infr025t/fpga2026/stream_video_edge_20fps/reports/evidence/consolidated_board_20261101/README.md

# 收敛候选硬件复测证据（2026-11-01）

**最新结论：自动硬件回归已通过，用户确认 RAW 与 EDGE 动态显示正常。** 重连后显式下载收敛候选，完成下面补测。此前第 324 帧出现真实参考不匹配，用户确认期间动过 USB 或供电；该事件尚未唯一归因，新通过结果不覆盖旧失败。

| 固件 / 检查 | 本次结果 |
|---|---|
| 收敛候选，内部 RAW / EDGE | 各 50 帧目标通过；内部源约 27.12 fps，不代表相机帧率 |
| 收敛候选，相机 RAW 色条 UART | 200 连续包通过：参考、头/负载 CRC、帧号、诊断丢包均正常；约 22.5077 fps |
| 收敛候选，相机 RAW 色条继续监测 | 第 324 帧参考错误，前 61440 像素不符，错误锁存重连后仍一致；此次环境不受控 |
| 原版，对照 RAW 色条 | 重新连接后 500 帧目标通过；约 22.5077 fps |
| 收敛候选，重连后 RAW / EDGE 色条 | 各 500 帧目标通过，约 22.5077 fps |
| 收敛候选，暂停恢复 | 10 轮通过，逐轮至少 10 帧后暂停并检查固定参考 |
| 收敛候选，实景 RAW / EDGE | 各 600 帧目标通过，约 22.5077 fps；完整像素数及队列两端 CRC 一致，不等于场景真值校验 |
| 收敛候选，实拍 UART | 连续 200 包，CRC 错误、诊断丢包与帧号缺口均为 0；没有场景参考真值 |
| 收敛候选，面板动态观察 | 用户按移动、遮挡、近光问题回复“两种模式都正常” |

`consolidated_mode*_02` 保存候选监测记录，`consolidated_bars_uart01` 保存 UART 摘要和帧号记录，`baseline_bars_stable02` 保存原版对照。UART 200 包不覆盖第 324 帧，不能用其通过结果否定稍后故障。监测记录可能跳过主机未轮询到的帧；逐帧参考锁存和主机记录应分开理解。

原始大体积图像/串口流仍留在测试工作区 `reports/uart_pairs/consolidated_bars_uart01/`，不复制进版本库。失败日志及重新连接日志保留。`program_attempt.log` 是最初未识别到目标的失败，不是成功下载凭证；成功下载见 `candidate_program.log` 和 `baseline_program.log`。

补测记录：`consolidated_stable_mode2_01`、`consolidated_stable_mode6_01`、`consolidated_pause_stable01`、`consolidated_scene_raw01`、`consolidated_scene_uart01`、`consolidated_scene_edge03`。实拍 EDGE 第一轮在第 598 帧后 JTAG 断开，不能记为通过。重连 inspect 无错误，但输出回到 RAW，不能证明仍是候选；`consolidated_scene_edge02` 主动终止并排除。再次显式下载候选后，`consolidated_scene_edge03` 完整通过，原始中断记录保留。

最后成功 RAM 下载为收敛候选 `548373f9…`，已成功交回实体开关控制。**本轮没有写 Flash。** 断电自启动仍使用此前用户确认的原版，不能将它误认成收敛候选。

用户已对 RAW / EDGE 移动、遮挡、近光的面板观察回复“两种模式都正常”。本轮有限回归通过，不等于无限时长或所有条件下零故障。移动暗条纹和斜向刷新分界线仍单列，未修复；第 324 帧事件保留为原因未闭合、受控补测未重现。任何后续失败仍应记录首错，不靠反复运行直到通过结案。
