infr025t/fpga2026/stream_video_edge_20fps/reports/evidence/rewire_20fps_20261031.md

# 改线后20fps实测（2026-10-31）
仅测试区；未修改RTL、算法或正式工程。仍使用b33cd101...测试bit，RCLK16.667MHz、40ns单次采样，摄像头AEC/AGC开启。

- 固定色条RAW：500帧目标完成，22.5077fps；完整VGA参考CRC检查通过。PC保存500个连续包，两组字节与参考均一致，头/负载CRC、帧号缺口和诊断丢包均为0。
- 固定色条Gaussian+Sobel：500帧目标完成，22.5077fps；完整边缘图参考CRC检查通过。
- 实拍RAW：两轮FPGA各完成600帧目标，22.5077fps，源到屏幕像素数及CRC相同。第一轮PC保存316张后PermissionError终止；不能当作600张图像验收。第二轮600张全部保存，串口CRC、帧号缺口、诊断丢包均为0。
- 实拍Gaussian+Sobel：500帧目标完成，22.5077fps；630x470完整输出像素数和写屏前后CRC一致。此项无逐帧实景参考，不能据此证明图像内容无错。
- 第二轮600张160x120双字节概览，行对比度筛查0帧有疑似互换行；人工查看每30帧的20张拼图未见明显互换或割裂。抽样不能排除未导出像素的零星问题。第91帧有手指进入，未据此认定完成受控动态验收。
- 各monitor结束时会排空在途帧，目标数与最终完成数可能相差1；具体见JSON。EDGE参考CRC由主机轮询核对，不能把主机观测次数改写为硬件逐帧全覆盖。
- 用户报告改线和此前3V3/GND接反；本轮下载、配置和图像链路可以工作，但没有仪器测量供电，也不能证明所有器件没有潜在损伤。此次没有进一步改线。

所有原始记录保留于reports/lcd/runtime/rewire_*及reports/uart_pairs/rewire_*。实拍对比拼图：reports/uart_pairs/rewire_scene02/sample_montage.png。
下一步：保持当前固件和接线，完成移动、遮挡、近距离强光动态验收，再决定正式收敛。不能仅凭本轮通过就宣布旧故障永久解决。
