infr025t/fpga2026/demo/stream_image_demo/完整代码.md

# 当前Demo完整代码

由 `python scripts/check_delivery.py --refresh` 生成，逐文件对应当前源码。
功能、运行方式与验证范围见 `README_先读我.md`；历史硬件记录见 `docs/`。

## constraints/basys3.xdc

```tcl
# Basys 3 XC7A35T CPG236, from Digilent Basys-3-Master.xdc.
set_property -dict {PACKAGE_PIN W5 IOSTANDARD LVCMOS33} [get_ports clk100]
create_clock -name sys_clk -period 10.000 [get_ports clk100]
set_property -dict {PACKAGE_PIN U18 IOSTANDARD LVCMOS33} [get_ports btnC]
set_property -dict {PACKAGE_PIN A18 IOSTANDARD LVCMOS33} [get_ports uart_txd]
set_property -dict {PACKAGE_PIN V17 IOSTANDARD LVCMOS33} [get_ports {sw[0]}]
set_property -dict {PACKAGE_PIN V16 IOSTANDARD LVCMOS33} [get_ports {sw[1]}]
set_property -dict {PACKAGE_PIN W16 IOSTANDARD LVCMOS33} [get_ports {sw[2]}]
set_property -dict {PACKAGE_PIN W17 IOSTANDARD LVCMOS33} [get_ports {sw[3]}]
set_property -dict {PACKAGE_PIN W15 IOSTANDARD LVCMOS33} [get_ports {sw[4]}]
set_property -dict {PACKAGE_PIN V15 IOSTANDARD LVCMOS33} [get_ports {sw[5]}]
set_property -dict {PACKAGE_PIN W14 IOSTANDARD LVCMOS33} [get_ports {sw[6]}]
set_property -dict {PACKAGE_PIN W13 IOSTANDARD LVCMOS33} [get_ports {sw[7]}]
set_property -dict {PACKAGE_PIN V2 IOSTANDARD LVCMOS33} [get_ports {sw[8]}]
set_property -dict {PACKAGE_PIN T3 IOSTANDARD LVCMOS33} [get_ports {sw[9]}]
set_property -dict {PACKAGE_PIN T2 IOSTANDARD LVCMOS33} [get_ports {sw[10]}]
set_property -dict {PACKAGE_PIN R3 IOSTANDARD LVCMOS33} [get_ports {sw[11]}]
set_property -dict {PACKAGE_PIN W2 IOSTANDARD LVCMOS33} [get_ports {sw[12]}]
set_property -dict {PACKAGE_PIN U1 IOSTANDARD LVCMOS33} [get_ports {sw[13]}]
set_property -dict {PACKAGE_PIN T1 IOSTANDARD LVCMOS33} [get_ports {sw[14]}]
set_property -dict {PACKAGE_PIN R2 IOSTANDARD LVCMOS33} [get_ports {sw[15]}]
set_property -dict {PACKAGE_PIN U16 IOSTANDARD LVCMOS33} [get_ports {led[0]}]
set_property -dict {PACKAGE_PIN E19 IOSTANDARD LVCMOS33} [get_ports {led[1]}]
set_property -dict {PACKAGE_PIN U19 IOSTANDARD LVCMOS33} [get_ports {led[2]}]
set_property -dict {PACKAGE_PIN V19 IOSTANDARD LVCMOS33} [get_ports {led[3]}]
set_property -dict {PACKAGE_PIN W18 IOSTANDARD LVCMOS33} [get_ports {led[4]}]
set_property -dict {PACKAGE_PIN U15 IOSTANDARD LVCMOS33} [get_ports {led[5]}]
set_property -dict {PACKAGE_PIN U14 IOSTANDARD LVCMOS33} [get_ports {led[6]}]
set_property -dict {PACKAGE_PIN V14 IOSTANDARD LVCMOS33} [get_ports {led[7]}]
set_property -dict {PACKAGE_PIN V13 IOSTANDARD LVCMOS33} [get_ports {led[8]}]
set_property -dict {PACKAGE_PIN V3 IOSTANDARD LVCMOS33} [get_ports {led[9]}]
set_property -dict {PACKAGE_PIN W3 IOSTANDARD LVCMOS33} [get_ports {led[10]}]
set_property -dict {PACKAGE_PIN U3 IOSTANDARD LVCMOS33} [get_ports {led[11]}]
set_property -dict {PACKAGE_PIN P3 IOSTANDARD LVCMOS33} [get_ports {led[12]}]
set_property -dict {PACKAGE_PIN N3 IOSTANDARD LVCMOS33} [get_ports {led[13]}]
set_property -dict {PACKAGE_PIN P1 IOSTANDARD LVCMOS33} [get_ports {led[14]}]
set_property -dict {PACKAGE_PIN L1 IOSTANDARD LVCMOS33} [get_ports {led[15]}]
set_property -dict {PACKAGE_PIN J1 IOSTANDARD LVCMOS33} [get_ports {cam_data[0]}]
set_property -dict {PACKAGE_PIN L2 IOSTANDARD LVCMOS33} [get_ports {cam_data[1]}]
set_property -dict {PACKAGE_PIN J2 IOSTANDARD LVCMOS33} [get_ports {cam_data[2]}]
set_property -dict {PACKAGE_PIN G2 IOSTANDARD LVCMOS33} [get_ports {cam_data[3]}]
set_property -dict {PACKAGE_PIN H1 IOSTANDARD LVCMOS33} [get_ports {cam_data[4]}]
set_property -dict {PACKAGE_PIN K2 IOSTANDARD LVCMOS33} [get_ports {cam_data[5]}]
set_property -dict {PACKAGE_PIN H2 IOSTANDARD LVCMOS33} [get_ports {cam_data[6]}]
set_property -dict {PACKAGE_PIN G3 IOSTANDARD LVCMOS33} [get_ports {cam_data[7]}]
set_property -dict {PACKAGE_PIN K17 IOSTANDARD LVCMOS33} [get_ports cam_sioc]
set_property -dict {PACKAGE_PIN M18 IOSTANDARD LVCMOS33} [get_ports cam_siod]
set_property -dict {PACKAGE_PIN N17 IOSTANDARD LVCMOS33} [get_ports cam_vsync]
set_property -dict {PACKAGE_PIN P18 IOSTANDARD LVCMOS33} [get_ports cam_wen]
set_property -dict {PACKAGE_PIN L17 IOSTANDARD LVCMOS33} [get_ports cam_rrst_n]
set_property -dict {PACKAGE_PIN M19 IOSTANDARD LVCMOS33} [get_ports cam_rclk]
set_property SLEW SLOW [get_ports {cam_rclk cam_rrst_n cam_wen cam_sioc cam_siod}]
set_property DRIVE 8 [get_ports {cam_rclk cam_rrst_n cam_wen cam_sioc cam_siod}]
# Async human/frame signals are sampled through marked synchronizers.
set_false_path -from [get_ports {btnC sw[*] cam_vsync}]
# SCCB data is stable for many system cycles at the ACK sampling point.
set_false_path -from [get_ports {cam_siod cam_sioc}]
# FIFO data is launched by our registered 2 MHz RCLK. Budget includes
# AL422 TAC 15 ns plus 10 ns wiring/skew; sample is ~200 ns after rise.
create_generated_clock -name fifo_read -source [get_ports clk100] -divide_by 50 [get_ports cam_rclk]
set_input_delay -clock fifo_read -max 25.0 [get_ports {cam_data[*]}]
set_input_delay -clock fifo_read -min 0.0 [get_ports {cam_data[*]}]
set_multicycle_path 20 -setup -end -from [get_ports {cam_data[*]}]
set_multicycle_path 19 -hold -end -from [get_ports {cam_data[*]}]
# Other low-speed outputs have no synchronous external capture clock.
set_max_delay 20 -datapath_only -from [get_clocks sys_clk] -to [get_ports {led[*] uart_txd cam_wen cam_rrst_n cam_sioc cam_siod}]
set_property CONFIG_VOLTAGE 3.3 [current_design]
set_property CFGBVS VCCO [current_design]
set_property BITSTREAM.GENERAL.COMPRESS TRUE [current_design]

# JC9: camera RESET# open-drain, external pullup to allowed camera IO rail.
set_property -dict {PACKAGE_PIN P17 IOSTANDARD LVCMOS33 SLEW SLOW DRIVE 8} [get_ports cam_rst_n]
set_max_delay 20 -datapath_only -from [get_clocks sys_clk] -to [get_ports cam_rst_n]

# JC10: passive HREF diagnostic input, double-flop synchronized.
# Weak pulldown keeps diagnostics quiet if the extra wire is absent.
set_property -dict {PACKAGE_PIN R18 IOSTANDARD LVCMOS33 PULLDOWN TRUE} [get_ports cam_href]
set_false_path -from [get_ports cam_href]
```

## constraints/vision_ooc.xdc

```tcl
# Generic core only; no screen pin assignment or display PHY is chosen yet.
create_clock -name sys_clk -period 10.000 [get_ports clk100]
set_false_path -from [get_ports {btnC sw[*] cam_vsync cam_href cam_sioc cam_siod}]
# Other I/O timing belongs to the eventual board/display wrapper.
```

## pc/enhancement_reference.py

```python
"""Integer reference model for the standalone two-scale enhancement pipeline."""
def fixture_pixel(frame, x, y, width):
    if frame == 0:
        return 80
    if frame == 1:
        return 255 if (x + y) % 2 else 0
    if frame == 3:
        return (40 if x < width // 2 else 220) + (x + y) % 3
    return (x * 17 + y * 31 + frame * 43) % 256

def fixture_controls(frame):
    return ((16, 16, 255), (48, 32, 255), (24, 20, 32),
            (0, 0, 0), (255, 255, 255))[frame]

def smooth(image, epsilon):
    height, width = len(image), len(image[0])
    result = []
    for y in range(1, height - 1):
        row = []
        for x in range(1, width - 1):
            values = [image[yy][xx] for yy in range(y - 1, y + 2)
                      for xx in range(x - 1, x + 2)]
            total = sum(values)
            mean = total // 9
            variance81 = 9 * sum(v * v for v in values) - total * total
            center = image[y][x]
            if variance81 <= epsilon * 81:
                value = mean
            elif variance81 <= epsilon * 324:
                value = (center + mean) // 2
            else:
                value = (3 * center + mean) // 4
            row.append(value)
        result.append(row)
    return result

def enhance(image, fine_gain=24, coarse_gain=16, limit=32,
            epsilon_fine=64, epsilon_coarse=256):
    fine = smooth(image, epsilon_fine)
    coarse = smooth(fine, epsilon_coarse)
    result = []
    for y, row in enumerate(coarse):
        output = []
        for x, base in enumerate(row):
            raw = image[y + 2][x + 2]
            middle = fine[y + 1][x + 1]
            df = max(-limit, min(limit, raw - middle))
            dc = max(-limit, min(limit, middle - base))
            value = base + (fine_gain * df + coarse_gain * dc) // 16
            output.append((raw, middle, base, max(0, min(255, value))))
        result.append(output)
    return result
```

## pc/receiver.py

```python
"""FPG1 UART receiver. Pure stdlib parsing/PGM output; pyserial for a real port.

CRC-16/CCITT-FALSE: polynomial 0x1021, init 0xffff, no reflection/xorout.
CRC covers header[4:] and the wire payload and is sent little endian. Version 1
has a 32-byte header; versions 2/3 have a 72-byte header. Version 3 transports
packed binary Sobel pixels or only ROI target statistics. Coordinates
refer to the sensor (the cropped image origin is sensor (1,1)). The legacy
bright-pixel centroid remains separate from the version 2 target centroid.
"""
import argparse
import binascii
import csv
from contextlib import ExitStack, suppress
import json
import math
from pathlib import Path
import struct
import sys
import time

MAGIC = b'FPG1'
HEADER = struct.Struct('<4sBBHHHIIIII')
TARGET_EXTENSION = struct.Struct('<BBHHHHHHHHIIIIIH')
KEYS = ('version', 'mode', 'width', 'height', 'threshold', 'frame_id',
        'payload_length', 'bright_count', 'sum_x', 'sum_y')
MAX_PIXELS = 320 * 240
BOX_KEYS = ('x_min', 'y_min', 'x_max', 'y_max')
TARGET_CSV_KEYS = ('config_valid', 'valid', 'dark', 'threshold',
                   'roi_x_min', 'roi_y_min', 'roi_x_max', 'roi_y_max',
                   'area', 'sum_x', 'sum_y', 'min_area', 'max_area',
                   'bbox_x_min', 'bbox_y_min', 'bbox_x_max', 'bbox_y_max',
                   'centroid_x', 'centroid_y')
CSV_FIELDS = (*KEYS, 'centroid_x', 'centroid_y', 'image_file',
              *('target_' + key for key in TARGET_CSV_KEYS), 'pixel_format')
MONO1_BYTES = tuple(bytes(255 if value & (1 << bit) else 0 for bit in range(8))
                    for value in range(256))

def _sum_bounds(area, low, high, capacity):
    """Possible axis sums for distinct pixels inside a rectangular box."""
    whole, remainder = divmod(area, capacity)
    minimum = area * low + capacity * whole * (whole - 1) // 2 + whole * remainder
    maximum = area * (low + high) - minimum
    # Both bounding-box endpoints must actually occur in the selected pixels.
    if low != high:
        minimum = max(minimum, (area - 1) * low + high)
        maximum = min(maximum, (area - 1) * high + low)
    return minimum, maximum

def _target_fields(values, width, height):
    (flags, threshold, rx0, ry0, rx1, ry1, bx0, by0, bx1, by1,
     area, sx, sy, minimum, maximum, reserved) = values
    if flags & ~0x07 or reserved:
        return False
    valid, dark, config_valid = bool(flags & 1), bool(flags & 2), bool(flags & 4)
    expected_config = (1 <= rx0 <= rx1 <= width and 1 <= ry0 <= ry1 <= height
                       and 1 <= minimum <= maximum <= width * height)
    if config_valid != expected_config:
        return False
    if valid != (config_valid and area > 0 and minimum <= area <= maximum):
        return False
    if not config_valid or not area:
        if any((area, sx, sy, bx0, by0, bx1, by1)):
            return False
    else:
        if not (rx0 <= bx0 <= bx1 <= rx1 and ry0 <= by0 <= by1 <= ry1):
            return False
        if area > (bx1 - bx0 + 1) * (by1 - by0 + 1):
            return False
        if area == 1 and (bx0 != bx1 or by0 != by1):
            return False
        sx_min, sx_max = _sum_bounds(area, bx0, bx1, by1 - by0 + 1)
        sy_min, sy_max = _sum_bounds(area, by0, by1, bx1 - bx0 + 1)
        if not (sx_min <= sx <= sx_max and sy_min <= sy <= sy_max):
            return False
    return dict(config_valid=config_valid, valid=valid, dark=dark,
                threshold=threshold, roi=dict(zip(BOX_KEYS, (rx0, ry0, rx1, ry1))),
                area=area, sum_x=sx, sum_y=sy, min_area=minimum, max_area=maximum,
                bbox=dict(zip(BOX_KEYS, (bx0, by0, bx1, by1))) if valid else None,
                centroid_x=sx // area if valid else None,
                centroid_y=sy // area if valid else None)

class FrameParser:
    """Incremental bounded parser; feed returns a list of validated frame dicts.

    Normal feeds always wait for the leading packet's declared length, so image
    pixels containing a valid packet cannot change parsing across read chunks.
    Only an explicit stream boundary may recover a later CRC-verified packet
    from an incomplete transfer. Call finish afterward to discard its tail.
    """
    def __init__(self):
        self.buffer = bytearray()
        self.rejected = 0

    def _candidate(self, pos):
        if len(self.buffer) - pos < HEADER.size:
            return None, None
        values = HEADER.unpack_from(self.buffer, pos)
        f = dict(zip(KEYS, values[1:]))
        w, h, n = f['width'], f['height'], f['payload_length']
        pixel_count = w * h
        if (values[0] != MAGIC or f['version'] not in (1, 2, 3) or f['mode'] not in (0, 1)
                or not (1 <= w <= 318 and 1 <= h <= 238)
                or n > MAX_PIXELS or f['threshold'] > 2047
                or f['bright_count'] > pixel_count
                or f['sum_x'] > f['bright_count'] * 319
                or f['sum_y'] > f['bright_count'] * 239):
            return False, None
        if f['version'] != 3 and n != pixel_count:
            return False, None
        header_size = HEADER.size
        pixel_format = 'gray8'
        if f['version'] in (2, 3):
            header_size += TARGET_EXTENSION.size
            if len(self.buffer) - pos < header_size:
                return None, None
            extension = TARGET_EXTENSION.unpack_from(self.buffer, pos + HEADER.size)
            has_target = True
            if f['version'] == 3:
                transport = self.buffer[pos + 70]
                if transport not in (1, 5, 6) or self.buffer[pos + 71]:
                    return False, None
                pixel_format = 'none' if transport == 6 else 'mono1'
                if pixel_format == 'mono1':
                    if f['mode'] != 1 or n != (pixel_count + 7) // 8:
                        return False, None
                elif n != 0:
                    return False, None
                has_target = transport != 1
                if not has_target and any(self.buffer[pos + 32:pos + 70]):
                    return False, None
                # The v2 reserved word is transport_flags plus reserved in v3.
                extension = (*extension[:-1], 0)
            if has_target:
                target = _target_fields(extension, w, h)
                if target is False:
                    return False, None
                f['target'] = target
        end = pos + header_size + n + 2
        if len(self.buffer) < end:
            return None, None
        expected, = struct.unpack_from('<H', self.buffer, end - 2)
        actual = binascii.crc_hqx(self.buffer[pos + 4:end - 2], 0xffff)
        if actual != expected:
            return False, None
        payload = bytes(self.buffer[pos + header_size:end - 2])
        if pixel_format == 'mono1':
            remaining = pixel_count % 8
            if remaining and payload[-1] & (0xff << remaining):
                return False, None
            payload = b''.join(MONO1_BYTES[value] for value in payload)[:pixel_count]
        f['pixels'] = payload
        f['pixel_format'] = pixel_format
        count = f['bright_count']
        f['centroid_x'] = f['sum_x'] // count if count else None
        f['centroid_y'] = f['sum_y'] // count if count else None
        return f, end

    def feed(self, chunk, *, boundary=False):
        self.buffer.extend(chunk)
        result = []
        while True:
            pos = self.buffer.find(MAGIC)
            if pos < 0:
                # Preserve possible fragmented magic, never unbounded noise.
                self.buffer[:] = self.buffer[-3:]
                break
            if pos:
                del self.buffer[:pos]
            frame, end = self._candidate(0)
            if frame is False:
                self.rejected += 1
                del self.buffer[0]
                continue
            if frame is None:
                if not boundary:
                    break
                # EOF or a caller-confirmed idle gap ends the old transfer.
                # Mere read fragmentation must never trigger this recovery.
                later = self.buffer.find(MAGIC, 4)
                recovered = False
                while later >= 0:
                    candidate, _ = self._candidate(later)
                    if candidate:
                        del self.buffer[:later]
                        self.rejected += 1
                        recovered = True
                        break
                    later = self.buffer.find(MAGIC, later + 1)
                if recovered:
                    continue
                break
            result.append(frame)
            del self.buffer[:end]
        return result

    def finish(self):
        """Discard ended-transfer leftovers; report full-magic truncation.

        A shorter magic suffix may simply be noise and is not enough evidence
        to classify a transfer as truncated. Call after a real stream EOF or
        an explicit idle boundary ends the transfer, not a single read timeout.
        """
        incomplete = self.buffer.startswith(MAGIC)
        if incomplete:
            self.rejected += 1
        self.buffer.clear()
        return incomplete

def display_geometry(frame):
    """Return ROI/target overlay positions in cropped-image coordinates."""
    target = frame.get('target')
    if target is None:
        return None

    def corners(box):
        return ((box['x_min'] - 1, box['y_min'] - 1),
                (box['x_max'] - 1, box['y_max'] - 1))

    return dict(roi=corners(target['roi']) if target['config_valid'] else None,
                bbox=corners(target['bbox']) if target['valid'] else None,
                centroid=(target['centroid_x'] - 1, target['centroid_y'] - 1)
                if target['valid'] else None,
                status=('Target' if target['valid'] else 'No target')
                if target['config_valid'] else 'Invalid target configuration')

def draw_target_overlay(picture, frame, cv2):
    """Draw only on a display copy; raw PGM and frame pixels stay unchanged."""
    geometry = display_geometry(frame)
    if geometry is None:
        return picture
    display = cv2.cvtColor(picture, cv2.COLOR_GRAY2BGR)
    if geometry['roi']:
        cv2.rectangle(display, *geometry['roi'], (0, 200, 255), 1)
    if geometry['bbox']:
        cv2.rectangle(display, *geometry['bbox'], (0, 255, 0), 1)
        cv2.circle(display, geometry['centroid'], 3, (0, 0, 255), -1)
    label = geometry['status']
    if frame.get('pixel_format') == 'none':
        label = 'Features only - ' + label
    if geometry['centroid']:
        target = frame['target']
        label += f" sensor=({target['centroid_x']},{target['centroid_y']})"
    cv2.putText(display, label, (4, 16), cv2.FONT_HERSHEY_SIMPLEX, 0.4,
                (0, 255, 0) if geometry['bbox'] else (0, 0, 255), 1)
    return display

def display_frame(frame, cv2, np):
    """Create the current frame's canvas; result-only packets never reuse pixels."""
    if frame.get('pixel_format') == 'none':
        picture = np.zeros((frame['height'], frame['width']), dtype=np.uint8)
    else:
        picture = np.frombuffer(frame['pixels'], dtype=np.uint8).reshape(
            frame['height'], frame['width'])
    return draw_target_overlay(picture, frame, cv2)

class PreviewCache:
    """Optional display-only background; metadata and saved pixels stay current.

    A reset, repeated ID, or incompatible image settings invalidates the held
    image. The wire format has no source/session ID, so an undetectable camera
    change cannot be inferred here; the sender must supply a fresh preview.
    """
    def __init__(self):
        self.pixels = None
        self.preview_id = None
        self.last_id = None
        self.settings = None

    def render(self, frame, cv2, np):
        settings = (frame['width'], frame['height'], frame['mode'], frame['threshold'])
        if (settings != self.settings or
                (self.last_id is not None and frame['frame_id'] <= self.last_id)):
            self.pixels = None
            self.preview_id = None
        self.settings = settings
        self.last_id = frame['frame_id']
        if frame.get('pixel_format') != 'none':
            # Keep immutable, undecorated pixels, never an OpenCV display array.
            self.pixels = bytes(frame['pixels'])
            self.preview_id = frame['frame_id']
            return display_frame(frame, cv2, np)
        if self.pixels is None:
            return display_frame(frame, cv2, np)
        picture = np.frombuffer(self.pixels, dtype=np.uint8).reshape(
            frame['height'], frame['width'])
        display = draw_target_overlay(picture, frame, cv2)
        # Separate lines remain readable at the normal 318-pixel image width.
        for y, label in ((34, f'Preview frame={self.preview_id} (held)'),
                         (50, f'Target frame={frame["frame_id"]}')):
            cv2.putText(display, label, (4, y), cv2.FONT_HERSHEY_SIMPLEX,
                        0.4, (0, 200, 255), 1)
        return display

def read_serial_chunk(stream, on_bytes=None):
    """Wait for one byte, then drain only bytes already available (at most 4096).

    Reading 4096 directly with a timeout batches short features-only packets
    until the timeout expires, even though each packet is already complete.
    """
    first = stream.read(1)
    if not first:
        return first
    if on_bytes is not None:
        on_bytes(first)
    available = min(stream.in_waiting, 4095)
    rest = stream.read(available) if available else b''
    if rest and on_bytes is not None:
        on_bytes(rest)
    return first + rest

class RecordingError(RuntimeError):
    """A recording failure must stop capture, not trigger serial reconnection."""

class WireRecorder:
    """Exclusive raw files, one per connection, preserving stream boundaries."""
    def __init__(self, path):
        self.path = Path(path)
        self.handle = None
        self.segment = 0

    def __enter__(self):
        self.path.parent.mkdir(parents=True, exist_ok=True)
        self.handle = self.path.open('xb')
        return self

    def __exit__(self, *args):
        if self.handle is not None:
            self.handle.close()

    def rotate(self):
        self.handle.close()
        while True:
            self.segment += 1
            path = self.path.with_name(
                f'{self.path.stem}_{self.segment:03d}{self.path.suffix}')
            try:
                self.handle = path.open('xb')
                break
            except FileExistsError:
                continue
        print(f'Recording new connection: {path}', file=sys.stderr)

    def write(self, chunk):
        try:
            self.handle.write(chunk)
            self.handle.flush()
        except OSError as exc:
            raise RecordingError(f'Could not record serial bytes: {exc}') from exc

class SerialInput:
    """Read live bytes; None marks a disconnected stream, b'' an idle poll.

    Retry waits are split into short polls so the preview can still handle q.
    Only port operations are retried; recording and frame-save errors escape.
    """
    def __init__(self, serial_module, port, baud, retry_seconds=0, recorder=None):
        self.serial = serial_module
        self.port = port
        self.baud = baud
        self.retry_seconds = retry_seconds
        self.recorder = recorder
        self.connection = ExitStack()
        self.stream = None
        self.connection_id = 0
        self.retry_at = 0.0
        self.errors = (getattr(serial_module, 'SerialException', OSError), OSError)

    def __enter__(self):
        return self

    def __exit__(self, *args):
        self.connection.close()

    def _failed(self, exc):
        with suppress(*self.errors):
            self.connection.close()
        self.stream = None
        if not self.retry_seconds:
            raise OSError(f'Serial connection failed ({self.port}): {exc}') from exc
        self.retry_at = time.monotonic() + self.retry_seconds
        print(f'Serial connection lost/unavailable ({self.port}): {exc}; '
              f'retrying in {self.retry_seconds:g}s', file=sys.stderr)
        return None

    def read(self):
        if self.stream is None:
            remaining = self.retry_at - time.monotonic()
            if remaining > 0:
                time.sleep(min(0.25, remaining))
                return b''
            try:
                self.stream = self.connection.enter_context(
                    self.serial.Serial(self.port, self.baud, timeout=0.25))
            except self.errors as exc:
                return self._failed(exc)
            self.connection_id += 1
            if self.recorder is not None and self.connection_id > 1:
                self.recorder.rotate()
            if self.connection_id > 1:
                print(f'Serial reconnected ({self.port})', file=sys.stderr)
        try:
            return read_serial_chunk(
                self.stream, self.recorder.write if self.recorder is not None else None)
        except self.errors as exc:
            return self._failed(exc)

def _csv_path(out):
    """Keep old or foreign CSV schemas intact instead of appending shifted rows."""
    suffix = 0
    while True:
        name = 'metadata.csv' if suffix == 0 else (
            'metadata_v3.csv' if suffix == 1 else f'metadata_v3_{suffix - 1}.csv')
        path = out / name
        if not path.exists() or path.stat().st_size == 0:
            return path
        try:
            with path.open(newline='', encoding='utf-8-sig') as handle:
                if next(csv.reader(handle), None) == list(CSV_FIELDS):
                    return path
        except (UnicodeError, csv.Error):
            # A foreign or damaged schema is not safe to append to.
            pass
        suffix += 1

def _csv_row(meta):
    row = {key: value for key, value in meta.items() if key != 'target'}
    target = meta.get('target')
    if target is not None:
        for key in TARGET_CSV_KEYS:
            if key.startswith('roi_'):
                value = target['roi'][key[4:]]
            elif key.startswith('bbox_'):
                value = target['bbox'][key[5:]] if target['bbox'] else None
            else:
                value = target[key]
            row['target_' + key] = value
    return row

def save_frame(frame, out):
    """Write metadata and, when present, a lossless expanded-pixel PGM.

    Return the image path, or the JSON path for a result-only packet.
    """
    out = Path(out)
    out.mkdir(parents=True, exist_ok=True)
    base = f"frame_{frame['frame_id']:010d}"
    image_present = frame.get('pixel_format', 'gray8') != 'none'
    # Preserve frames if the FPGA resets and its frame counter starts again.
    # Either artifact may remain after an interrupted save or a manual move.
    suffix = 0
    while True:
        stem = base if suffix == 0 else f"{base}_{suffix}"
        path = out / (stem + '.pgm')
        meta_path = out / (stem + '.json')
        if path.exists() or meta_path.exists():
            suffix += 1
            continue
        try:
            handle = path.open('xb') if image_present else meta_path.open('x', encoding='utf-8')
        except FileExistsError:
            suffix += 1
            continue
        break
    meta = {k: v for k, v in frame.items() if k != 'pixels'}
    meta.setdefault('pixel_format', 'gray8')
    meta['image_file'] = path.name if image_present else None
    if image_present:
        with handle:
            handle.write(f"P5\n{frame['width']} {frame['height']}\n255\n".encode('ascii') + frame['pixels'])
        with meta_path.open('x', encoding='utf-8') as handle:
            handle.write(json.dumps(meta, indent=2) + '\n')
    else:
        with handle:
            handle.write(json.dumps(meta, indent=2) + '\n')
    csv_path = _csv_path(out)
    has_header = csv_path.exists() and csv_path.stat().st_size > 0
    with csv_path.open('a', newline='', encoding='utf-8') as handle:
        writer = csv.DictWriter(handle, fieldnames=CSV_FIELDS)
        if not has_header:
            writer.writeheader()
        writer.writerow(_csv_row(meta))
    return path if image_present else meta_path

def main():
    parser = argparse.ArgumentParser(description=__doc__)
    source = parser.add_mutually_exclusive_group(required=True)
    source.add_argument('--port', help='e.g. COM5')
    source.add_argument('--input', type=Path, help='recorded binary wire stream')
    parser.add_argument('--baud', type=int, default=1000000)
    parser.add_argument('--out', type=Path, default=Path('frames'))
    parser.add_argument('--count', type=int, help='stop after this many valid frames')
    parser.add_argument('--display', action='store_true', help='requires optional opencv-python')
    parser.add_argument('--hold-preview', action='store_true',
                        help='with --display, draw new target results on the last compatible '
                             'image and label both frame IDs; saved files stay unchanged')
    parser.add_argument('--idle-resync', type=float, default=1.0, metavar='SECONDS',
                        help='recover truncated serial frames after this long without bytes '
                             '(default: 1; 0 disables); later old bytes are discarded')
    parser.add_argument('--reconnect', type=float, default=0.0, metavar='SECONDS',
                        help='retry unavailable/disconnected serial port after this interval; '
                             '0 disables (default); only with --port')
    parser.add_argument('--record-wire', type=Path, metavar='PATH',
                        help='record raw serial bytes without overwriting files; reconnects '
                             'start numbered files; only with --port')
    args = parser.parse_args()
    if args.count is not None and args.count < 1:
        parser.error('--count must be positive')
    if args.baud < 1:
        parser.error('--baud must be positive')
    if not math.isfinite(args.idle_resync) or args.idle_resync < 0:
        parser.error('--idle-resync must be a finite nonnegative number')
    if args.hold_preview and not args.display:
        parser.error('--hold-preview requires --display')
    if not math.isfinite(args.reconnect) or args.reconnect < 0:
        parser.error('--reconnect must be a finite nonnegative number')
    if args.input and (args.reconnect or args.record_wire is not None):
        parser.error('--reconnect and --record-wire require --port')
    if args.record_wire is not None and args.record_wire.exists():
        parser.error('recording file already exists; choose a new --record-wire path')
    if args.display:
        import cv2
        import numpy as np
    if not args.input:
        import serial
    decoder = FrameParser()
    preview = PreviewCache() if args.hold_preview else None
    count = 0
    incomplete_input = False
    failure = None
    display_shape = (238, 318)
    try:
        with ExitStack() as resources:
            recorder = (resources.enter_context(WireRecorder(args.record_wire))
                        if args.record_wire is not None else None)
            stream = resources.enter_context(
                args.input.open('rb') if args.input else
                SerialInput(serial, args.port, args.baud, args.reconnect, recorder))
            last_data_at = None
            while args.count is None or count < args.count:
                chunk = stream.read(4096) if args.input else stream.read()
                end_of_input = not chunk and args.input is not None
                disconnected = chunk is None
                if disconnected:
                    # A dead connection is an explicit boundary. Recover any
                    # complete buffered packets, then discard its partial tail.
                    frames = decoder.feed(b'', boundary=True)
                    decoder.finish()
                    last_data_at = None
                elif chunk:
                    last_data_at = time.monotonic()
                    frames = decoder.feed(chunk)
                elif end_of_input:
                    frames = decoder.feed(b'', boundary=True)
                else:
                    frames = []
                    if (args.idle_resync and last_data_at is not None
                            and time.monotonic() - last_data_at >= args.idle_resync):
                        frames = decoder.feed(b'', boundary=True)
                        decoder.finish()
                        last_data_at = None
                for frame in frames:
                    path = save_frame(frame, args.out)
                    count += 1
                    message = (f"{path}: mode={frame['mode']} pixel_format={frame['pixel_format']} "
                               f"bright_centroid=({frame['centroid_x']}, {frame['centroid_y']})")
                    if 'target' in frame:
                        target = frame['target']
                        message += (f" target_valid={target['valid']} area={target['area']} "
                                    f"target_centroid=({target['centroid_x']}, {target['centroid_y']})")
                    print(message)
                    if args.display:
                        display_shape = (frame['height'], frame['width'])
                        picture = (preview.render(frame, cv2, np) if preview is not None
                                   else display_frame(frame, cv2, np))
                        cv2.imshow('FPGA camera', picture)
                        if cv2.waitKey(1) & 0xff == ord('q'):
                            return
                    if args.count is not None and count >= args.count:
                        break
                if disconnected:
                    if preview is not None:
                        preview = PreviewCache()
                    if args.display:
                        picture = cv2.cvtColor(np.zeros(display_shape, dtype=np.uint8),
                                               cv2.COLOR_GRAY2BGR)
                        cv2.putText(picture, 'Disconnected - retrying', (4, 16),
                                    cv2.FONT_HERSHEY_SIMPLEX, 0.4, (0, 0, 255), 1)
                        cv2.imshow('FPGA camera', picture)
                if args.display and not frames:
                    if cv2.waitKey(1) & 0xff == ord('q'):
                        return
                if end_of_input:
                    if args.count is None or count < args.count:
                        incomplete_input = decoder.finish()
                    break
    except KeyboardInterrupt:
        pass
    except (OSError, RecordingError) as exc:
        failure = str(exc)
    finally:
        if args.display:
            cv2.destroyAllWindows()
    print(f"Received {count} valid frames; rejected/resynchronized {decoder.rejected} candidates.")
    if failure:
        parser.exit(1, f'Receiver I/O error: {failure}\n')
    if args.input and args.count is not None and count < args.count:
        parser.exit(1, 'Input ended before requested frame count.\n')
    if incomplete_input:
        parser.exit(1, 'Input ended with an incomplete frame.\n')

if __name__ == '__main__':
    main()
```

## pc/requirements.txt

```text
pyserial>=3.5,<4
```

## pc/test_receiver.py

```python
import binascii
import contextlib
import csv
import importlib.util
import io
import json
import pathlib
import struct
import subprocess
import sys
import tempfile
import types
import unittest
from unittest import mock

def packet(frame_id=7, payload=b'FPG1abcd', **changes):
    fields = dict(version=1, mode=1, width=4, height=2, threshold=180,
                  frame_id=frame_id, length=len(payload), bright_count=2,
                  sum_x=7, sum_y=5)
    fields.update(changes)
    h = b'FPG1' + struct.pack('<BBHHHIIIII', *fields.values())
    body = h[4:] + payload
    return h + payload + struct.pack('<H', binascii.crc_hqx(body, 0xffff))

def target_packet(frame_id=70, payload=None, base=None, **changes):
    fields = dict(version=2, mode=0, width=6, height=4, threshold=180,
                  frame_id=frame_id, length=24, bright_count=2, sum_x=7, sum_y=5)
    fields.update(base or {})
    if payload is None:
        payload = bytes(index & 0xff for index in range(fields['width'] * fields['height']))
    fields['length'] = len(payload)
    target = dict(flags=7, target_threshold=96,
                  roi_x_min=1, roi_y_min=1, roi_x_max=6, roi_y_max=4,
                  bbox_x_min=3, bbox_y_min=2, bbox_x_max=5, bbox_y_max=3,
                  target_area=6, target_sum_x=24, target_sum_y=15,
                  min_area=2, max_area=12, reserved=0)
    target.update(changes)
    header = b'FPG1' + struct.pack('<BBHHHIIIII', *fields.values())
    header += struct.pack('<BBHHHHHHHHIIIIIH', *target.values())
    return header + payload + struct.pack('<H', binascii.crc_hqx(header[4:] + payload, 0xffff))

EMPTY_TARGET = dict(target_area=0, target_sum_x=0, target_sum_y=0,
                    bbox_x_min=0, bbox_y_min=0, bbox_x_max=0, bbox_y_max=0)

def output_packet(frame_id=110, payload=None, transport=5, base=None, **changes):
    """Build wire-format v3 packets; target data remains independently packed."""
    fields = dict(version=3, mode=1, width=6, height=4)
    fields.update(base or {})
    if payload is None:
        size = fields['width'] * fields['height']
        payload = bytes((size + 7) // 8) if transport & 1 else b''
    wire = bytearray(target_packet(frame_id, payload, fields, **changes))
    if transport == 1:
        wire[32:70] = bytes(38)
    wire[70] = transport
    wire[-2:] = struct.pack('<H', binascii.crc_hqx(wire[4:-2], 0xffff))
    return bytes(wire)

def rewrite_wire(wire, offset, data):
    """Change a field while preserving a valid CRC to exercise validation."""
    wire = bytearray(wire)
    wire[offset:offset + len(data)] = data
    wire[-2:] = struct.pack('<H', binascii.crc_hqx(wire[4:-2], 0xffff))
    return bytes(wire)

class DisplayArray:
    """Tiny array stand-in that exposes unintended overlay writes in tests."""
    def __init__(self, pixels):
        self.pixels = pixels

    def reshape(self, height, width):
        assert len(self.pixels) == height * width
        return self

class DisplayNumpy:
    uint8 = object()

    def __init__(self):
        self.sources = []
        self.blanks = []

    def frombuffer(self, pixels, dtype):
        self.sources.append(bytes(pixels))
        return DisplayArray(pixels)

    def zeros(self, dimensions, dtype):
        self.blanks.append(dimensions)
        return DisplayArray(bytes(dimensions[0] * dimensions[1]))

class DisplayCv:
    COLOR_GRAY2BGR = 1
    FONT_HERSHEY_SIMPLEX = 2

    def __init__(self):
        self.texts = []
        self.circles = []
        self.shown = []
        self.closed = False

    def cvtColor(self, picture, conversion):
        return DisplayArray(bytearray(picture.pixels))

    def rectangle(self, picture, *args):
        picture.pixels[0] = 201

    def circle(self, picture, center, *args):
        self.circles.append(center)
        picture.pixels[0] = 202

    def putText(self, picture, label, *args):
        self.texts.append(label)
        picture.pixels[0] = 203

    def imshow(self, name, picture):
        self.shown.append(picture)

    def waitKey(self, duration):
        return -1

    def destroyAllWindows(self):
        self.closed = True

class ReceiverTests(unittest.TestCase):
    @classmethod
    def setUpClass(cls):
        path = pathlib.Path(__file__).with_name('receiver.py')
        if path.exists():
            spec = importlib.util.spec_from_file_location('receiver', path)
            cls.receiver = importlib.util.module_from_spec(spec)
            spec.loader.exec_module(cls.receiver)
        else:
            cls.receiver = None

    def parser(self):
        self.assertIsNotNone(self.receiver, 'receiver implementation is missing')
        return self.receiver.FrameParser()

    def run_mock_serial(self, reads, options=(), cv=None):
        """Exercise the real CLI loop without a serial port or wall-clock waits."""
        pending = iter(reads)
        clock = [0.0]
        saved = []

        class Stream:
            closed = False
            buffered = b''

            def __enter__(self):
                return self

            def __exit__(self, *args):
                self.closed = True

            def read(self, count):
                if self.buffered:
                    data, self.buffered = self.buffered[:count], self.buffered[count:]
                    return data
                try:
                    clock[0], data = next(pending)
                except StopIteration:
                    raise KeyboardInterrupt
                self.buffered = data[count:]
                return data[:count]

            @property
            def in_waiting(self):
                return len(self.buffered)

        stream = Stream()
        serial = types.SimpleNamespace(Serial=mock.Mock(return_value=stream))
        modules = {'serial': serial}
        if cv is not None:
            modules.update(cv2=cv, numpy=types.SimpleNamespace())

        def save(frame, out):
            saved.append((clock[0], frame['frame_id']))
            return pathlib.Path(f"frame_{frame['frame_id']}.json")

        output = io.StringIO()
        with (mock.patch.dict(sys.modules, modules),
              mock.patch.object(sys, 'argv', ['receiver.py', '--port', 'mock', *options]),
              mock.patch.object(self.receiver.time, 'monotonic', side_effect=lambda: clock[0]),
              mock.patch.object(self.receiver, 'save_frame', side_effect=save),
              contextlib.redirect_stdout(output)):
            self.receiver.main()
        serial.Serial.assert_called_once_with('mock', 1000000, timeout=0.25)
        self.assertTrue(stream.closed)
        return saved, output.getvalue()

    def test_fragmented_payload_magic_and_centroid(self):
        p = self.parser()
        frames = []
        for b in packet():
            frames.extend(p.feed(bytes([b])))
        self.assertEqual(len(frames), 1)
        self.assertEqual(frames[0]['pixels'], b'FPG1abcd')
        self.assertEqual(frames[0]['pixel_format'], 'gray8')
        self.assertEqual(frames[0]['centroid_x'], 3)
        self.assertEqual(frames[0]['centroid_y'], 2)

    def test_qvga_payload_streamed_in_irregular_chunks(self):
        p = self.parser()
        size = 318 * 238
        payload = (bytes(range(256)) * ((size + 255) // 256))[:size]
        wire = packet(101, payload, width=318, height=238) + packet(102)
        frames = []
        position = 0
        sizes = (1, 7, 31, 4096)
        index = 0
        while position < len(wire):
            length = sizes[index % len(sizes)]
            frames.extend(p.feed(wire[position:position + length]))
            position += length
            index += 1
        self.assertEqual([f['frame_id'] for f in frames], [101, 102])
        self.assertEqual(frames[0]['pixels'], payload)
        self.assertFalse(p.finish())

    def test_noise_bad_crc_and_invalid_headers_recover(self):
        p = self.parser()
        corrupt = bytearray(packet()); corrupt[-1] ^= 1
        noise = b'garbageFPG' + corrupt + packet(version=3) + packet(mode=2)
        noise += packet(width=0) + packet(length=99999999)
        frames = p.feed(noise + packet(8))
        self.assertEqual([f['frame_id'] for f in frames], [8])

    def test_truncated_frame_resync_only_to_verified_packet(self):
        p = self.parser()
        self.assertEqual(p.feed(packet(1, b'x' * 100, width=10, height=10)[:38]), [])
        self.assertEqual(p.feed(packet(9)), [])
        self.assertEqual([f['frame_id'] for f in p.feed(b'', boundary=True)], [9])
        self.assertFalse(p.finish())

    def test_embedded_complete_packets_do_not_change_any_two_chunk_split(self):
        for inner in (packet(22), target_packet(23), output_packet(24),
                      output_packet(25, transport=6)):
            payload = b'prefix' + inner + b'suffix' + bytes(50)
            outer = packet(21, payload, width=len(payload), height=1)
            for cut in range(1, len(outer)):
                with self.subTest(inner_version=inner[4], cut=cut):
                    p = self.parser()
                    frames = p.feed(outer[:cut]) + p.feed(outer[cut:])
                    self.assertEqual([frame['frame_id'] for frame in frames], [21])
                    self.assertEqual(frames[0]['pixels'], payload)
                    self.assertEqual(p.rejected, 0)
                    self.assertFalse(p.finish())
            p = self.parser()
            frames = []
            for value in outer:
                frames.extend(p.feed(bytes([value])))
            self.assertEqual([frame['frame_id'] for frame in frames], [21])

    def test_boundary_recovers_verified_packets_and_retains_incomplete_tail(self):
        bad = bytearray(packet(8))
        bad[-1] ^= 1
        old = packet(1, bytes(318 * 238), width=318, height=238)[:38]
        p = self.parser()
        wire = old + bad + packet(9) + output_packet(10, transport=6) + packet(11)[:20]
        self.assertEqual(p.feed(wire), [])
        frames = p.feed(b'', boundary=True)
        self.assertEqual([frame['frame_id'] for frame in frames], [9, 10])
        self.assertTrue(p.finish())
        self.assertEqual(p.rejected, 2)
        self.assertEqual([frame['frame_id'] for frame in p.feed(packet(12))], [12])

    def test_empty_centroid_and_file_outputs(self):
        p = self.parser()
        f = p.feed(packet(bright_count=0, sum_x=0, sum_y=0))[0]
        self.assertIsNone(f['centroid_x'])
        with tempfile.TemporaryDirectory() as d:
            self.receiver.save_frame(f, pathlib.Path(d))
            self.assertEqual(len(list(pathlib.Path(d).glob('*.pgm'))), 1)
            self.assertEqual(len(list(pathlib.Path(d).glob('*.json'))), 1)
            self.assertTrue((pathlib.Path(d) / 'metadata.csv').exists())

    def test_saving_preserves_orphaned_images_and_metadata(self):
        f = self.parser().feed(packet())[0]
        with tempfile.TemporaryDirectory() as d:
            out = pathlib.Path(d)
            orphan_meta = out / 'frame_0000000007.json'
            orphan_image = out / 'frame_0000000007_1.pgm'
            orphan_meta.write_text('original metadata', encoding='utf-8')
            orphan_image.write_bytes(b'original image')
            image = self.receiver.save_frame(f, out)
            self.assertEqual(image.name, 'frame_0000000007_2.pgm')
            self.assertEqual(orphan_meta.read_text(encoding='utf-8'), 'original metadata')
            self.assertEqual(orphan_image.read_bytes(), b'original image')
            self.assertEqual(image.read_bytes(), b'P5\n4 2\n255\n' + f['pixels'])
            meta = json.loads(image.with_suffix('.json').read_text(encoding='utf-8'))
            self.assertEqual(meta['image_file'], image.name)
            second = self.receiver.save_frame(f, out)
            self.assertEqual(second.name, 'frame_0000000007_3.pgm')

    def test_finish_reports_only_unfinished_packets_and_resets(self):
        p = self.parser()
        self.assertEqual(p.feed(packet()[:35]), [])
        self.assertTrue(p.finish())
        self.assertEqual(p.rejected, 1)
        self.assertFalse(p.finish())
        self.assertEqual([f['frame_id'] for f in p.feed(packet(8))], [8])
        self.assertFalse(p.finish())
        self.assertEqual(p.feed(b'noise ending in FPG'), [])
        self.assertFalse(p.finish())
        self.assertEqual(p.rejected, 1)

    def test_recorded_input_reports_truncation_without_losing_valid_frames(self):
        script = pathlib.Path(__file__).with_name('receiver.py')
        cases = [
            (packet() + packet(8)[:20], [], 1, 'incomplete frame'),
            (packet() + b'noiseFPG', [], 0, ''),
            (packet() + packet(8)[:20], ['--count', '1'], 0, ''),
            (packet() + packet(8)[:20], ['--count', '2'], 1, 'requested frame count'),
        ]
        for wire, options, exit_code, error in cases:
            with self.subTest(options=options, wire_tail=wire[-8:]):
                with tempfile.TemporaryDirectory() as d:
                    root = pathlib.Path(d)
                    recorded = root / 'wire.bin'
                    recorded.write_bytes(wire)
                    result = subprocess.run(
                        [sys.executable, str(script), '--input', str(recorded),
                         '--out', str(root / 'frames'), *options],
                        capture_output=True, text=True, timeout=10)
                    self.assertEqual(result.returncode, exit_code, result.stderr)
                    if error:
                        self.assertIn(error, result.stderr)
                    else:
                        self.assertEqual(result.stderr, '')
                    self.assertEqual(len(list((root / 'frames').glob('*.pgm'))), 1)

    def test_recorded_eof_recovers_short_packets_after_large_truncated_frame(self):
        script = pathlib.Path(__file__).with_name('receiver.py')
        old = packet(1, bytes(318 * 238), width=318, height=238)[:38]
        recovered = packet(31) + target_packet(32) + output_packet(33, transport=6)
        cases = [(b'', [], 0, ''),
                 (packet(34)[:20], [], 1, 'incomplete frame'),
                 (packet(34)[:20], ['--count', '3'], 0, ''),
                 (b'', ['--count', '4'], 1, 'requested frame count')]
        for tail, options, exit_code, error in cases:
            with self.subTest(options=options, tail=bool(tail)):
                with tempfile.TemporaryDirectory() as d:
                    root = pathlib.Path(d)
                    recorded = root / 'wire.bin'
                    recorded.write_bytes(old + recovered + tail)
                    result = subprocess.run(
                        [sys.executable, str(script), '--input', str(recorded),
                         '--out', str(root / 'frames'), *options],
                        capture_output=True, text=True, timeout=10)
                    self.assertEqual(result.returncode, exit_code, result.stderr)
                    self.assertIn('Received 3 valid frames;', result.stdout)
                    self.assertEqual(len(list((root / 'frames').glob('*.json'))), 3)
                    self.assertEqual(len(list((root / 'frames').glob('*.pgm'))), 2)
                    if error:
                        self.assertIn(error, result.stderr)
                    else:
                        self.assertEqual(result.stderr, '')

    def test_serial_idle_recovery_waits_for_continuous_no_byte_interval(self):
        old = packet(1, bytes(100), width=10, height=10)[:38]
        saved, output = self.run_mock_serial(
            [(0.1, old + packet(9)), (0.35, b''), (0.85, b''),
             (0.95, b'x'), (1.5, b''), (2.0, b'')], ['--count', '1'])
        self.assertEqual(saved, [(2.0, 9)])
        self.assertIn('rejected/resynchronized 1 candidates', output)

    def test_serial_idle_recovery_can_be_disabled(self):
        old = packet(1, bytes(100), width=10, height=10)[:38]
        saved, output = self.run_mock_serial(
            [(0.1, old + packet(9)), (0.35, b''), (100.0, b'')],
            ['--idle-resync', '0'])
        self.assertEqual(saved, [])
        self.assertIn('Received 0 valid frames;', output)
        self.assertIn('rejected/resynchronized 0 candidates', output)

    def test_serial_idle_boundary_discards_late_remainder_of_old_frame(self):
        old = packet(1, bytes(100), width=10, height=10)
        saved, output = self.run_mock_serial(
            [(0.1, old[:38]), (0.35, b''), (1.2, b''),
             (1.3, old[38:] + packet(9))], ['--count', '1'])
        self.assertEqual(saved, [(1.3, 9)])
        self.assertIn('rejected/resynchronized 1 candidates', output)

    def test_serial_preview_handles_quit_while_no_frames_arrive(self):
        cv = types.SimpleNamespace(waitKey=mock.Mock(return_value=ord('q')),
                                   destroyAllWindows=mock.Mock())
        saved, _ = self.run_mock_serial([(0.25, b'')], ['--display'], cv)
        self.assertEqual(saved, [])
        cv.waitKey.assert_called_once_with(1)
        cv.destroyAllWindows.assert_called_once_with()

    def test_invalid_idle_resync_fails_before_importing_serial(self):
        script = pathlib.Path(__file__).with_name('receiver.py')
        for duration in ('-0.1', 'nan', 'inf'):
            with self.subTest(duration=duration):
                result = subprocess.run(
                    [sys.executable, str(script), '--port', 'unused',
                     '--idle-resync', duration], capture_output=True, text=True, timeout=10)
                self.assertEqual(result.returncode, 2)
                self.assertIn('--idle-resync must be a finite nonnegative number', result.stderr)
                self.assertNotIn('Traceback', result.stderr)

    def test_invalid_baud_fails_before_importing_serial(self):
        script = pathlib.Path(__file__).with_name('receiver.py')
        result = subprocess.run(
            [sys.executable, str(script), '--port', 'unused', '--baud', '0'],
            capture_output=True, text=True, timeout=10)
        self.assertEqual(result.returncode, 2)
        self.assertIn('--baud must be positive', result.stderr)
        self.assertNotIn('Traceback', result.stderr)

    def test_serial_short_packet_is_read_without_waiting_to_fill_large_buffer(self):
        wire = output_packet(190, transport=6)

        class SerialBuffer:
            def __init__(self, data):
                self.data = data
                self.read_sizes = []
                self.timeouts = 0

            @property
            def in_waiting(self):
                return len(self.data)

            def read(self, size):
                self.read_sizes.append(size)
                if len(self.data) < size:
                    self.timeouts += 1
                chunk, self.data = self.data[:size], self.data[size:]
                return chunk

        stream = SerialBuffer(wire)
        chunk = self.receiver.read_serial_chunk(stream)
        self.assertEqual([f['frame_id'] for f in self.parser().feed(chunk)], [190])
        self.assertEqual(stream.read_sizes, [1, 73])
        self.assertEqual(stream.timeouts, 0)
        # Large bursts remain bounded and preserve all bytes across calls.
        data = bytes(range(256)) * 20
        stream = SerialBuffer(data)
        first = self.receiver.read_serial_chunk(stream)
        second = self.receiver.read_serial_chunk(stream)
        self.assertEqual(len(first), 4096)
        self.assertEqual(first + second, data)
        self.assertEqual(stream.timeouts, 0)
        self.assertEqual(self.receiver.read_serial_chunk(stream), b'')
        self.assertEqual(stream.timeouts, 1)

    def test_hold_preview_requires_display_before_optional_imports(self):
        script = pathlib.Path(__file__).with_name('receiver.py')
        result = subprocess.run(
            [sys.executable, str(script), '--port', 'unused', '--hold-preview'],
            capture_output=True, text=True, timeout=10)
        self.assertEqual(result.returncode, 2)
        self.assertIn('--hold-preview requires --display', result.stderr)
        self.assertNotIn('Traceback', result.stderr)

    def test_serial_cli_emits_short_features_packet_before_read_timeout(self):
        class ShortPacketPort:
            def __init__(self):
                self.buffer = output_packet(191, transport=6)
                self.elapsed = 0.00074
                self.closed = False

            def __enter__(self):
                return self

            def __exit__(self, *args):
                self.closed = True

            @property
            def in_waiting(self):
                return len(self.buffer)

            def read(self, count):
                # pyserial waits for requested bytes or timeout, including when
                # fewer than count bytes already make a complete protocol frame.
                if len(self.buffer) < count:
                    self.elapsed += 0.25
                data, self.buffer = self.buffer[:count], self.buffer[count:]
                return data

        stream = ShortPacketPort()
        serial = types.SimpleNamespace(Serial=mock.Mock(return_value=stream))
        saves = []

        def save(frame, out):
            saves.append((frame['frame_id'], stream.elapsed))
            return pathlib.Path('features.json')

        with (mock.patch.dict(sys.modules, {'serial': serial}),
              mock.patch.object(sys, 'argv', ['receiver.py', '--port', 'mock', '--count', '1']),
              mock.patch.object(self.receiver, 'save_frame', side_effect=save),
              mock.patch.object(self.receiver.time, 'monotonic', side_effect=lambda: stream.elapsed),
              contextlib.redirect_stdout(io.StringIO())):
            self.receiver.main()
        self.assertEqual(saves, [(191, 0.00074)])
        self.assertTrue(stream.closed)

    def test_held_preview_mixes_raw_and_packed_with_current_target_geometry(self):
        frames = self.parser().feed(
            target_packet(200, base=dict(mode=1))
            + output_packet(201, transport=6, bbox_x_min=4, bbox_x_max=5,
                            bbox_y_min=3, bbox_y_max=3, target_area=2,
                            target_sum_x=9, target_sum_y=6)
            + output_packet(202, payload=b'\x81\x00\x03')
            + output_packet(203, transport=6))
        originals = [frame['pixels'] for frame in frames]
        cache = self.receiver.PreviewCache()
        cv, np = DisplayCv(), DisplayNumpy()
        displays = [cache.render(frame, cv, np) for frame in frames]
        self.assertEqual(np.sources, [originals[0], originals[0], originals[2], originals[2]])
        self.assertEqual(np.blanks, [])
        self.assertEqual(cv.circles, [(3, 1), (3, 2), (3, 1), (3, 1)])
        self.assertIn('Preview frame=200 (held)', cv.texts)
        self.assertIn('Target frame=201', cv.texts)
        self.assertIn('Preview frame=202 (held)', cv.texts)
        self.assertIn('Target frame=203', cv.texts)
        # Drawing really mutates the stand-in display; source/cache bytes do not.
        self.assertTrue(all(picture.pixels[0] == 203 for picture in displays))
        self.assertEqual([frame['pixels'] for frame in frames], originals)
        self.assertEqual(cache.pixels, originals[2])
        self.assertTrue(all('image_file' not in frame for frame in frames))

    def test_held_preview_without_image_uses_blank_canvas(self):
        cache = self.receiver.PreviewCache()
        cv, np = DisplayCv(), DisplayNumpy()
        frame = self.parser().feed(output_packet(1, transport=6))[0]
        cache.render(frame, cv, np)
        self.assertEqual(np.blanks, [(4, 6)])
        self.assertEqual(np.sources, [])
        self.assertEqual(cv.texts, ['Features only - Target sensor=(4,2)'])

    def test_held_preview_discards_incompatible_and_reset_frames_until_new_image(self):
        cases = [dict(frame_id=19), dict(frame_id=21), dict(frame_id=0),
                 dict(frame_id=22, base=dict(mode=0)),
                 dict(frame_id=22, base=dict(width=7)),
                 dict(frame_id=22, base=dict(height=5)),
                 dict(frame_id=22, base=dict(threshold=181))]
        for changes in cases:
            with self.subTest(changes=changes):
                cache = self.receiver.PreviewCache()
                cv, np = DisplayCv(), DisplayNumpy()
                first, held = self.parser().feed(
                    output_packet(20) + output_packet(21, transport=6))
                cache.render(first, cv, np)
                cache.render(held, cv, np)
                incompatible = self.parser().feed(output_packet(transport=6, **changes))[0]
                cache.render(incompatible, cv, np)
                # Returning to the old settings must not resurrect an old image.
                later = self.parser().feed(output_packet(30, transport=6))[0]
                cache.render(later, cv, np)
                self.assertIsNone(cache.pixels)
                self.assertEqual(len(np.blanks), 2)
                self.assertEqual(len(np.sources), 2)
                fresh, latest = self.parser().feed(
                    output_packet(31, payload=b'\xff\x01\x00')
                    + output_packet(32, transport=6))
                cache.render(fresh, cv, np)
                cache.render(latest, cv, np)
                self.assertEqual(cache.pixels, fresh['pixels'])
                self.assertIn('Preview frame=31 (held)', cv.texts)
                self.assertIn('Target frame=32', cv.texts)

    def test_held_preview_cli_keeps_features_metadata_and_saved_images_separate(self):
        wires = [target_packet(300, base=dict(mode=1)),
                 output_packet(301, transport=6), output_packet(302),
                 output_packet(303, transport=6, flags=6, **EMPTY_TARGET)]
        expected = self.parser().feed(b''.join(wires))
        cv, np = DisplayCv(), DisplayNumpy()
        with tempfile.TemporaryDirectory() as d:
            root = pathlib.Path(d)
            recorded = root / 'wire.bin'
            recorded.write_bytes(b''.join(wires))
            out = root / 'frames'
            argv = ['receiver.py', '--input', str(recorded), '--out', str(out),
                    '--display', '--hold-preview']
            with (mock.patch.dict(sys.modules, {'cv2': cv, 'numpy': np}),
                  mock.patch.object(sys, 'argv', argv),
                  contextlib.redirect_stdout(io.StringIO())):
                self.receiver.main()
            self.assertTrue(cv.closed)
            self.assertEqual(len(cv.shown), 4)
            self.assertEqual(len(list(out.glob('*.pgm'))), 2)
            self.assertEqual(len(list(out.glob('*.json'))), 4)
            for frame in expected:
                stem = f"frame_{frame['frame_id']:010d}"
                meta = json.loads((out / (stem + '.json')).read_text(encoding='utf-8'))
                self.assertEqual(meta['target'], frame['target'])
                if frame['pixel_format'] == 'none':
                    self.assertIsNone(meta['image_file'])
                    self.assertFalse((out / (stem + '.pgm')).exists())
                else:
                    self.assertEqual((out / (stem + '.pgm')).read_bytes(),
                                     b'P5\n6 4\n255\n' + frame['pixels'])
            self.assertIn('Preview frame=300 (held)', cv.texts)
            self.assertIn('Target frame=301', cv.texts)
            self.assertIn('Preview frame=302 (held)', cv.texts)
            self.assertIn('Target frame=303', cv.texts)

    def test_noise_is_bounded_and_complete_frames_take_precedence(self):
        p = self.parser()
        self.assertEqual(p.feed(b'x' * 1000000), [])
        self.assertLessEqual(len(p.buffer), 3)
        embedded = packet(22)
        outer = packet(21, embedded, width=len(embedded), height=1)
        frames = p.feed(outer + packet(23))
        self.assertEqual([f['frame_id'] for f in frames], [21, 23])
        self.assertEqual(frames[0]['pixels'], embedded)

    def test_bad_dimensions_statistics_and_threshold_recover(self):
        p = self.parser()
        malformed = (packet(width=319) + packet(height=239)
                     + packet(threshold=2048) + packet(bright_count=9)
                     + packet(sum_x=9999) + packet(sum_y=9999))
        self.assertEqual([f['frame_id'] for f in p.feed(malformed + packet(25))], [25])

    def test_v2_fragmentation_preserves_legacy_statistics_and_payload(self):
        p = self.parser()
        payload = b'FPG1' + bytes(range(20))
        wire = target_packet(payload=payload)
        self.assertEqual(self.receiver.TARGET_EXTENSION.size, 40)
        self.assertEqual(len(wire), 72 + len(payload) + 2)
        frames = []
        for value in wire:
            frames.extend(p.feed(bytes([value])))
        self.assertEqual(len(frames), 1)
        frame = frames[0]
        self.assertEqual(frame['version'], 2)
        self.assertEqual(frame['pixel_format'], 'gray8')
        self.assertEqual(frame['pixels'], payload)
        self.assertEqual((frame['bright_count'], frame['centroid_x'], frame['centroid_y']), (2, 3, 2))
        target = frame['target']
        self.assertEqual((target['area'], target['sum_x'], target['sum_y']), (6, 24, 15))
        self.assertTrue(target['config_valid'])
        self.assertTrue(target['valid'])
        self.assertTrue(target['dark'])
        self.assertEqual(target['threshold'], 96)
        self.assertEqual(target['roi'], dict(x_min=1, y_min=1, x_max=6, y_max=4))
        self.assertEqual(target['bbox'], dict(x_min=3, y_min=2, x_max=5, y_max=3))
        self.assertEqual((target['centroid_x'], target['centroid_y']), (4, 2))
        self.assertFalse(p.finish())

    def test_v2_empty_filtered_and_invalid_config_have_no_target_geometry(self):
        wires = [target_packet(71, flags=6, **EMPTY_TARGET),
                 target_packet(72, flags=6, min_area=7),
                 target_packet(73, flags=6, max_area=5),
                 target_packet(74, flags=2, roi_x_min=0, **EMPTY_TARGET),
                 target_packet(75, flags=4, **EMPTY_TARGET)]
        frames = self.parser().feed(b''.join(wires))
        self.assertEqual([f['frame_id'] for f in frames], [71, 72, 73, 74, 75])
        for frame in frames:
            target = frame['target']
            self.assertFalse(target['valid'])
            self.assertIsNone(target['bbox'])
            self.assertIsNone(target['centroid_x'])
            self.assertIsNone(target['centroid_y'])
            geometry = self.receiver.display_geometry(frame)
            self.assertIsNone(geometry['bbox'])
            self.assertIsNone(geometry['centroid'])
        self.assertEqual(frames[1]['target']['area'], 6)
        self.assertEqual(frames[1]['target']['sum_x'], 24)
        self.assertEqual(frames[1]['target']['sum_y'], 15)
        self.assertFalse(frames[3]['target']['config_valid'])
        self.assertIsNone(self.receiver.display_geometry(frames[3])['roi'])
        self.assertFalse(frames[4]['target']['dark'])

    def test_v2_bright_single_pixel_and_full_roi_area_boundaries(self):
        wire = target_packet(
            83, flags=5, target_threshold=255, min_area=1, max_area=1,
            bbox_x_min=6, bbox_y_min=4, bbox_x_max=6, bbox_y_max=4,
            target_area=1, target_sum_x=6, target_sum_y=4)
        wire += target_packet(
            84, target_threshold=0, min_area=24, max_area=24,
            bbox_x_min=1, bbox_y_min=1, bbox_x_max=6, bbox_y_max=4,
            target_area=24, target_sum_x=84, target_sum_y=60)
        frames = self.parser().feed(wire)
        self.assertEqual([f['frame_id'] for f in frames], [83, 84])
        self.assertTrue(all(f['target']['valid'] for f in frames))
        self.assertFalse(frames[0]['target']['dark'])
        self.assertEqual(self.receiver.display_geometry(frames[0])['centroid'], (5, 3))
        self.assertEqual(frames[1]['target']['area'], 24)

    def test_v2_accepts_every_realizable_target_in_a_three_by_three_roi(self):
        # Enumerate actual sets of distinct pixels, independently of sum bounds.
        # This guards against rejecting legitimate sparse or filled target boxes.
        wires = []
        for mask in range(1, 1 << 9):
            points = [(index % 3 + 1, index // 3 + 1)
                      for index in range(9) if mask & (1 << index)]
            xs, ys = zip(*points)
            wires.append(target_packet(
                mask, base=dict(width=3, height=3, mode=1),
                roi_x_max=3, roi_y_max=3, min_area=1, max_area=9,
                bbox_x_min=min(xs), bbox_y_min=min(ys),
                bbox_x_max=max(xs), bbox_y_max=max(ys),
                target_area=len(points), target_sum_x=sum(xs), target_sum_y=sum(ys)))
        p = self.parser()
        frames = p.feed(b''.join(wires))
        self.assertEqual([f['frame_id'] for f in frames], list(range(1, 1 << 9)))
        self.assertEqual(p.rejected, 0)

    def test_v2_rejects_inconsistent_flags_configuration_and_statistics(self):
        malformed = [
            dict(flags=15), dict(reserved=1), dict(flags=3), dict(flags=2),
            dict(roi_x_min=0), dict(roi_y_min=0), dict(roi_x_max=7), dict(roi_y_max=5),
            dict(roi_x_min=5, roi_x_max=4), dict(roi_y_min=4, roi_y_max=3),
            dict(min_area=0), dict(min_area=13), dict(max_area=25),
            dict(flags=6), dict(flags=7, min_area=7), dict(flags=7, max_area=5),
            dict(flags=2, roi_x_min=0),
            dict(flags=3, roi_x_min=0, **EMPTY_TARGET),
            dict(flags=7, **EMPTY_TARGET),
            dict(flags=6, **{**EMPTY_TARGET, 'target_sum_x': 1}),
            dict(flags=6, **{**EMPTY_TARGET, 'bbox_x_min': 1}),
            dict(bbox_x_min=0), dict(bbox_y_min=0),
            dict(bbox_x_max=7), dict(bbox_y_max=5),
            dict(roi_x_min=4), dict(roi_y_min=3),
            dict(bbox_x_min=5, bbox_x_max=3), dict(bbox_y_min=3, bbox_y_max=2),
            dict(target_area=7), dict(target_sum_x=0), dict(target_sum_y=0),
            dict(target_sum_x=23), dict(target_sum_y=14),
            dict(target_sum_x=31), dict(target_sum_y=19),
            dict(target_area=1, target_sum_x=3, target_sum_y=2, min_area=1),
            dict(target_area=2, target_sum_x=6, target_sum_y=4),
        ]
        for changes in malformed:
            with self.subTest(changes=changes):
                p = self.parser()
                frames = p.feed(b'noiseFPG' + target_packet(**changes) + target_packet(99) + packet(100))
                self.assertEqual([f['frame_id'] for f in frames], [99, 100])
                self.assertGreaterEqual(p.rejected, 1)

    def test_v2_crc_covers_extension_and_recovers_after_header_or_payload_truncation(self):
        bad = bytearray(target_packet())
        bad[33] ^= 1
        p = self.parser()
        frames = p.feed(bytes(bad) + target_packet(76) + packet(77))
        self.assertEqual([f['frame_id'] for f in frames], [76, 77])
        for length in (35, 71, 72, 80, len(target_packet()) - 1):
            with self.subTest(length=length):
                p = self.parser()
                self.assertEqual(p.feed(target_packet()[:length]), [])
                self.assertTrue(p.finish())
                p = self.parser()
                frames = p.feed(target_packet()[:length] + b'noiseFPG' + target_packet(78))
                self.assertEqual([f['frame_id'] for f in frames], [78])

    def test_v2_qvga_and_mixed_frames_in_irregular_chunks(self):
        p = self.parser()
        large = target_packet(80, base=dict(width=318, height=238))
        wire = packet(79) + large + target_packet(81) + packet(82)
        frames = []
        index = 0
        for length in (1, 31, 40, 4096):
            frames.extend(p.feed(wire[index:index + length]))
            index += length
        while index < len(wire):
            frames.extend(p.feed(wire[index:index + 997]))
            index += 997
        self.assertEqual([f['frame_id'] for f in frames], [79, 80, 81, 82])
        self.assertEqual(len(frames[1]['pixels']), 318 * 238)
        self.assertNotIn('target', frames[0])
        self.assertNotIn('target', frames[-1])
        self.assertFalse(p.finish())

    def test_display_maps_sensor_coordinates_and_draws_on_a_copy(self):
        frame = self.parser().feed(target_packet(
            base=dict(width=14, height=10), roi_x_max=14, roi_y_max=10,
            bbox_x_min=4, bbox_y_min=3, bbox_x_max=7, bbox_y_max=8,
            target_area=24, target_sum_x=132, target_sum_y=132, max_area=70))[0]
        geometry = self.receiver.display_geometry(frame)
        self.assertEqual(geometry['roi'], ((0, 0), (13, 9)))
        self.assertEqual(geometry['bbox'], ((3, 2), (6, 7)))
        self.assertEqual(geometry['centroid'], (4, 4))
        self.assertIsNone(self.receiver.display_geometry(self.parser().feed(packet())[0]))

        class FakeCv:
            COLOR_GRAY2BGR = 1
            FONT_HERSHEY_SIMPLEX = 2

            def __init__(self):
                self.calls = []
                self.display = object()

            def cvtColor(self, original, conversion):
                self.calls.append(('copy', original, conversion))
                return self.display

            def rectangle(self, *args):
                self.calls.append(('rectangle', *args))

            def circle(self, *args):
                self.calls.append(('circle', *args))

            def putText(self, *args):
                self.calls.append(('text', *args))

        cv = FakeCv()
        original = object()
        pixels = frame['pixels']
        displayed = self.receiver.draw_target_overlay(original, frame, cv)
        self.assertIs(displayed, cv.display)
        self.assertEqual(frame['pixels'], pixels)
        self.assertTrue(any(call[0] == 'circle' and call[2] == (4, 4) for call in cv.calls))
        for call in cv.calls[1:]:
            self.assertIs(call[1], cv.display)
        missing = self.parser().feed(target_packet(flags=6, **EMPTY_TARGET))[0]
        cv = FakeCv()
        self.receiver.draw_target_overlay(original, missing, cv)
        self.assertFalse(any(call[0] == 'circle' for call in cv.calls))
        self.assertTrue(any(call[0] == 'text' and call[2] == 'No target' for call in cv.calls))

    def test_csv_flattens_mixed_versions_and_json_retains_target(self):
        frames = self.parser().feed(packet(90) + target_packet(91) + target_packet(92, flags=6, **EMPTY_TARGET) + packet(93))
        with tempfile.TemporaryDirectory() as d:
            out = pathlib.Path(d)
            paths = [self.receiver.save_frame(frame, out) for frame in frames]
            with (out / 'metadata.csv').open(newline='', encoding='utf-8') as handle:
                reader = csv.DictReader(handle)
                rows = list(reader)
                self.assertEqual(reader.fieldnames, list(self.receiver.CSV_FIELDS))
            self.assertEqual([row['version'] for row in rows], ['1', '2', '2', '1'])
            self.assertEqual(rows[0]['target_valid'], '')
            self.assertEqual(rows[1]['target_valid'], 'True')
            self.assertEqual(rows[1]['target_centroid_x'], '4')
            self.assertEqual(rows[1]['centroid_x'], '3')
            self.assertEqual(rows[1]['target_bbox_x_min'], '3')
            self.assertEqual(rows[2]['target_valid'], 'False')
            self.assertEqual(rows[2]['target_bbox_x_min'], '')
            self.assertEqual(rows[2]['target_centroid_x'], '')
            self.assertNotIn('target', rows[1])
            self.assertTrue(all(None not in row for row in rows))
            meta = json.loads(paths[1].with_suffix('.json').read_text(encoding='utf-8'))
            self.assertEqual(meta['target'], frames[1]['target'])
            self.assertEqual(paths[1].read_bytes(), b'P5\n6 4\n255\n' + frames[1]['pixels'])

    def test_csv_preserves_old_header_and_uses_versioned_schema(self):
        frames = self.parser().feed(target_packet(94) + packet(95))
        with tempfile.TemporaryDirectory() as d:
            out = pathlib.Path(d)
            old_csv = b'version,frame_id,centroid_x\r\n1,5,8\r\n'
            (out / 'metadata.csv').write_bytes(old_csv)
            for frame in frames:
                self.receiver.save_frame(frame, out)
            self.assertEqual((out / 'metadata.csv').read_bytes(), old_csv)
            with (out / 'metadata_v3.csv').open(newline='', encoding='utf-8') as handle:
                reader = csv.DictReader(handle)
                rows = list(reader)
                self.assertEqual(reader.fieldnames, list(self.receiver.CSV_FIELDS))
            self.assertEqual([row['version'] for row in rows], ['2', '1'])
            self.assertEqual(rows[1]['target_roi_x_min'], '')
            (out / 'metadata_v3.csv').write_bytes(b'unrelated,header\n')
            self.receiver.save_frame(frames[0], out)
            self.assertEqual((out / 'metadata_v3.csv').read_bytes(), b'unrelated,header\n')
            self.assertTrue((out / 'metadata_v3_1.csv').exists())

    def test_csv_preserves_foreign_encoding_and_unparseable_headers(self):
        frame = self.parser().feed(packet())[0]
        foreign = ('unrelated,header\n'.encode('utf-16'), b'bad,\xffheader\n',
                   b'x' * (csv.field_size_limit() + 1) + b'\n')
        for original in foreign:
            with self.subTest(prefix=original[:16]):
                with tempfile.TemporaryDirectory() as d:
                    out = pathlib.Path(d)
                    (out / 'metadata.csv').write_bytes(original)
                    (out / 'metadata_v3.csv').write_bytes(original)
                    self.receiver.save_frame(frame, out)
                    self.assertEqual((out / 'metadata.csv').read_bytes(), original)
                    self.assertEqual((out / 'metadata_v3.csv').read_bytes(), original)
                    with (out / 'metadata_v3_1.csv').open(newline='', encoding='utf-8') as handle:
                        reader = csv.DictReader(handle)
                        rows = list(reader)
                        self.assertEqual(reader.fieldnames, list(self.receiver.CSV_FIELDS))
                    self.assertEqual([row['frame_id'] for row in rows], ['7'])

    def test_v3_all_three_by_three_binary_patterns_fragmented(self):
        p = self.parser()
        frames = []
        wire = b''.join(output_packet(mask, mask.to_bytes(2, 'little'), 1,
                                     dict(width=3, height=3))
                        for mask in range(512))
        for index in range(0, len(wire), 13):
            frames.extend(p.feed(wire[index:index + 13]))
        self.assertEqual([f['frame_id'] for f in frames], list(range(512)))
        for mask, frame in enumerate(frames):
            self.assertEqual(frame['pixels'], bytes(255 if mask & (1 << bit) else 0
                                                    for bit in range(9)))
            self.assertEqual(frame['payload_length'], 2)
            self.assertEqual(frame['pixel_format'], 'mono1')
            self.assertNotIn('target', frame)
        self.assertEqual(p.rejected, 0)
        self.assertFalse(p.finish())

    def test_v3_non_byte_width_uses_continuous_lsb_first_pixels(self):
        frame = self.parser().feed(output_packet(
            payload=b'\x91\x41', transport=1, base=dict(width=5, height=3)))[0]
        self.assertEqual([i for i, value in enumerate(frame['pixels']) if value],
                         [0, 4, 7, 8, 14])
        self.assertEqual(len(frame['pixels']), 15)
        # The legacy bright count counts source pixels, not packed wire bytes.
        frame = self.parser().feed(output_packet(
            payload=b'\xff\x01', transport=1,
            base=dict(width=3, height=3, bright_count=9, sum_x=18, sum_y=18)))[0]
        self.assertEqual(frame['bright_count'], 9)
        self.assertEqual((frame['centroid_x'], frame['centroid_y']), (2, 2))

    def test_v3_packed_maximum_qvga_and_mixed_versions(self):
        size = 318 * 238
        payload = bytearray((index * 37) & 0xff for index in range((size + 7) // 8))
        payload[-1] &= (1 << (size % 8)) - 1
        wires = [packet(120), target_packet(121),
                 output_packet(122, bytes(payload), 1, dict(width=318, height=238)),
                 output_packet(123, transport=6), output_packet(124), packet(125)]
        p = self.parser()
        frames = []
        wire = b''.join(wires)
        offset = 0
        sizes = (1, 31, 40, 997, 4096)
        while offset < len(wire):
            count = sizes[offset % len(sizes)]
            frames.extend(p.feed(wire[offset:offset + count]))
            offset += count
        self.assertEqual([f['frame_id'] for f in frames], list(range(120, 126)))
        self.assertEqual([f['pixel_format'] for f in frames],
                         ['gray8', 'gray8', 'mono1', 'none', 'mono1', 'gray8'])
        self.assertEqual(frames[2]['pixels'], bytes(
            255 if payload[index // 8] & (1 << (index % 8)) else 0
            for index in range(size)))
        self.assertEqual(frames[2]['payload_length'], (size + 7) // 8)
        self.assertEqual(frames[3]['pixels'], b'')
        self.assertEqual(p.rejected, 0)
        self.assertFalse(p.finish())

    def test_v3_target_and_result_only_keep_target_geometry(self):
        frames = self.parser().feed(output_packet(130) + output_packet(131, transport=6)
                                    + output_packet(132, transport=6, base=dict(mode=0)))
        self.assertEqual([f['frame_id'] for f in frames], [130, 131, 132])
        for frame in frames:
            self.assertTrue(frame['target']['valid'])
            self.assertEqual(frame['target']['bbox'], dict(x_min=3, y_min=2, x_max=5, y_max=3))
            self.assertEqual(self.receiver.display_geometry(frame),
                             dict(roi=((0, 0), (5, 3)), bbox=((2, 1), (4, 2)),
                                  centroid=(3, 1), status='Target'))
        for frame in frames[1:]:
            self.assertEqual(frame['pixels'], b'')
            self.assertEqual(frame['pixel_format'], 'none')
            self.assertEqual(frame['payload_length'], 0)

    def test_v3_rejects_illegal_transport_reserved_mode_and_lengths(self):
        malformed = [output_packet(transport=flag) for flag in (0, 2, 3, 4, 7, 8, 255)]
        malformed += [rewrite_wire(output_packet(), 71, b'\x01'),
                      output_packet(base=dict(mode=0)),
                      output_packet(transport=1, base=dict(mode=0)),
                      output_packet(payload=b'\x00'),
                      output_packet(payload=bytes(4)),
                      output_packet(transport=6, payload=b'\x00'),
                      rewrite_wire(output_packet(), 16, struct.pack('<I', 99999999)),
                      rewrite_wire(output_packet(transport=1), 32, b'\x04'),
                      rewrite_wire(output_packet(transport=1), 69, b'\x01')]
        for wire in malformed:
            with self.subTest(header=wire[:72]):
                p = self.parser()
                self.assertEqual([f['frame_id'] for f in p.feed(wire + output_packet(140))], [140])
                self.assertGreaterEqual(p.rejected, 1)

    def test_v3_rejects_nonzero_padding_and_accepts_exact_byte_counts(self):
        malformed = [output_packet(payload=b'\x00\x02', transport=1,
                                   base=dict(width=3, height=3)),
                     output_packet(payload=b'\x00\x80', transport=1,
                                   base=dict(width=5, height=3))]
        p = self.parser()
        frames = p.feed(b''.join(malformed) + output_packet(
            141, payload=b'\x80', transport=1, base=dict(width=4, height=2)))
        self.assertEqual([f['frame_id'] for f in frames], [141])
        self.assertEqual(frames[0]['pixels'], bytes(7) + b'\xff')
        self.assertGreaterEqual(p.rejected, 2)

    def test_v3_target_geometry_checks_apply_to_packed_and_result_only(self):
        malformed = [dict(flags=15), dict(roi_x_min=0), dict(min_area=0),
                     dict(bbox_x_min=0), dict(target_sum_x=23),
                     dict(target_sum_y=14), dict(target_area=7),
                     dict(flags=7, **EMPTY_TARGET)]
        for transport in (5, 6):
            for changes in malformed:
                with self.subTest(transport=transport, changes=changes):
                    p = self.parser()
                    self.assertEqual([f['frame_id'] for f in p.feed(
                        output_packet(transport=transport, **changes) + packet(142))], [142])
                    self.assertGreaterEqual(p.rejected, 1)

    def test_v3_crc_covers_wire_payload_and_header_and_truncations_recover(self):
        packed = output_packet(payload=b'\x81\x03\x00')
        for offset in (6, 33, 70, 72, len(packed) - 1):
            with self.subTest(offset=offset):
                bad = bytearray(packed)
                bad[offset] ^= 1
                p = self.parser()
                frames = p.feed(bad + output_packet(143, transport=6) + packet(144))
                self.assertEqual([f['frame_id'] for f in frames], [143, 144])
                self.assertGreaterEqual(p.rejected, 1)
        for original in (packed, output_packet(transport=6)):
            for length in (35, 71, 72, len(original) - 1):
                with self.subTest(packet_length=len(original), truncated=length):
                    p = self.parser()
                    self.assertEqual(p.feed(original[:length]), [])
                    self.assertTrue(p.finish())
                    p = self.parser()
                    self.assertEqual([f['frame_id'] for f in p.feed(
                        original[:length] + output_packet(145, transport=6))], [145])

    def test_v3_saving_results_only_never_creates_image_and_preserves_orphans(self):
        frames = self.parser().feed(output_packet(150, transport=6)
                                    + output_packet(150, transport=6, flags=6, **EMPTY_TARGET))
        with tempfile.TemporaryDirectory() as d:
            out = pathlib.Path(d)
            orphan_image = out / 'frame_0000000150.pgm'
            orphan_meta = out / 'frame_0000000150_1.json'
            orphan_image.write_bytes(b'original image')
            orphan_meta.write_text('original metadata', encoding='utf-8')
            paths = [self.receiver.save_frame(frame, out) for frame in frames]
            self.assertEqual([path.name for path in paths],
                             ['frame_0000000150_2.json', 'frame_0000000150_3.json'])
            self.assertEqual(list(out.glob('*.pgm')), [orphan_image])
            self.assertEqual(orphan_image.read_bytes(), b'original image')
            self.assertEqual(orphan_meta.read_text(encoding='utf-8'), 'original metadata')
            for frame, path in zip(frames, paths):
                meta = json.loads(path.read_text(encoding='utf-8'))
                self.assertIsNone(meta['image_file'])
                self.assertEqual(meta['pixel_format'], 'none')
                self.assertEqual(meta['payload_length'], 0)
                self.assertNotIn('pixels', meta)
                self.assertEqual(meta['target'], frame['target'])
            with (out / 'metadata.csv').open(newline='', encoding='utf-8') as handle:
                rows = list(csv.DictReader(handle))
            self.assertEqual([row['target_valid'] for row in rows], ['True', 'False'])
            self.assertTrue(all(row['image_file'] == '' and row['pixel_format'] == 'none' for row in rows))

    def test_v3_mixed_save_expands_pgm_records_wire_size_and_schema_safely(self):
        frames = self.parser().feed(packet(151) + target_packet(152)
                                    + output_packet(153, b'\x01\x80\x00', 1)
                                    + output_packet(154, transport=6, flags=6, **EMPTY_TARGET))
        with tempfile.TemporaryDirectory() as d:
            out = pathlib.Path(d)
            old_csv = b'version,frame_id,centroid_x\r\n1,5,8\r\n'
            v2_csv = (','.join(self.receiver.CSV_FIELDS[:-1]) + '\n').encode()
            (out / 'metadata.csv').write_bytes(old_csv)
            (out / 'metadata_v2.csv').write_bytes(v2_csv)
            paths = [self.receiver.save_frame(frame, out) for frame in frames]
            self.assertEqual((out / 'metadata.csv').read_bytes(), old_csv)
            self.assertEqual((out / 'metadata_v2.csv').read_bytes(), v2_csv)
            with (out / 'metadata_v3.csv').open(newline='', encoding='utf-8') as handle:
                reader = csv.DictReader(handle)
                rows = list(reader)
                self.assertEqual(reader.fieldnames[-1], 'pixel_format')
                self.assertEqual(reader.fieldnames, list(self.receiver.CSV_FIELDS))
            self.assertEqual([row['pixel_format'] for row in rows], ['gray8', 'gray8', 'mono1', 'none'])
            self.assertEqual([row['payload_length'] for row in rows], ['8', '24', '3', '0'])
            self.assertEqual(rows[2]['target_valid'], '')
            self.assertEqual(len(list(out.glob('*.pgm'))), 3)
            self.assertEqual(paths[2].read_bytes(), b'P5\n6 4\n255\n' + frames[2]['pixels'])
            self.assertNotIn('target', json.loads(paths[2].with_suffix('.json').read_text(encoding='utf-8')))

    def test_v3_result_display_uses_fresh_blank_canvas_and_marks_results_only(self):
        class FakeCv:
            COLOR_GRAY2BGR = 1
            FONT_HERSHEY_SIMPLEX = 2

            def __init__(self):
                self.calls = []

            def cvtColor(self, original, conversion):
                self.calls.append(('copy', original, conversion))
                return object()

            def rectangle(self, *args):
                self.calls.append(('rectangle', *args))

            def circle(self, *args):
                self.calls.append(('circle', *args))

            def putText(self, *args):
                self.calls.append(('text', *args))

        class FakeArray:
            uint8 = object()

            def __init__(self):
                self.calls = []

            def zeros(self, dimensions, dtype):
                canvas = object()
                self.calls.append((dimensions, dtype, canvas))
                return canvas

            def frombuffer(self, *args, **kwargs):
                raise AssertionError('result-only packet must not interpret or reuse image data')

        frames = self.parser().feed(output_packet(155, transport=6)
                                    + output_packet(156, transport=6, flags=6, **EMPTY_TARGET))
        np = FakeArray()
        cv = FakeCv()
        displayed = [self.receiver.display_frame(frame, cv, np) for frame in frames]
        self.assertEqual([call[:2] for call in np.calls], [((4, 6), np.uint8)] * 2)
        self.assertIsNot(np.calls[0][2], np.calls[1][2])
        self.assertIsNot(displayed[0], displayed[1])
        texts = [call[2] for call in cv.calls if call[0] == 'text']
        self.assertEqual(texts, ['Features only - Target sensor=(4,2)', 'Features only - No target'])
        circles = [call for call in cv.calls if call[0] == 'circle']
        self.assertEqual(len(circles), 1)
        self.assertEqual(circles[0][2], (3, 1))
        self.assertTrue(any(call[0] == 'rectangle' and call[2:4] == ((2, 1), (4, 2)) for call in cv.calls))

    def test_v3_recorded_cli_counts_results_only_and_saves_no_pgm(self):
        script = pathlib.Path(__file__).with_name('receiver.py')
        wires = [output_packet(160, transport=6),
                 output_packet(161, transport=6, flags=6, **EMPTY_TARGET)]
        with tempfile.TemporaryDirectory() as d:
            root = pathlib.Path(d)
            recorded = root / 'wire.bin'
            recorded.write_bytes(b''.join(wires))
            result = subprocess.run(
                [sys.executable, str(script), '--input', str(recorded),
                 '--out', str(root / 'frames'), '--count', '2'],
                capture_output=True, text=True, timeout=10)
            self.assertEqual(result.returncode, 0, result.stderr)
            self.assertEqual(result.stderr, '')
            self.assertIn('Received 2 valid frames;', result.stdout)
            self.assertIn('pixel_format=none', result.stdout)
            self.assertIn('target_valid=False', result.stdout)
            self.assertEqual(len(list((root / 'frames').glob('*.json'))), 2)
            self.assertEqual(len(list((root / 'frames').glob('*.pgm'))), 0)

    def test_v3_recorded_cli_replays_mixed_stream_and_stops_at_requested_count(self):
        script = pathlib.Path(__file__).with_name('receiver.py')
        wire = (packet(170) + output_packet(171, transport=6)
                + output_packet(172, b'\x81\x01', 1, dict(width=3, height=3))
                + target_packet(173) + output_packet(174, transport=6))
        with tempfile.TemporaryDirectory() as d:
            root = pathlib.Path(d)
            recorded = root / 'wire.bin'
            recorded.write_bytes(wire)
            result = subprocess.run(
                [sys.executable, str(script), '--input', str(recorded),
                 '--out', str(root / 'frames'), '--count', '4'],
                capture_output=True, text=True, timeout=10)
            self.assertEqual(result.returncode, 0, result.stderr)
            self.assertIn('Received 4 valid frames;', result.stdout)
            self.assertEqual(len(list((root / 'frames').glob('*.json'))), 4)
            self.assertEqual(len(list((root / 'frames').glob('*.pgm'))), 3)
            image = root / 'frames' / 'frame_0000000172.pgm'
            self.assertEqual(image.read_bytes(), b'P5\n3 3\n255\n' + b'\xff' + bytes(6) + b'\xff\xff')

if __name__ == '__main__':
    unittest.main()
```

## pc/test_serial_sessions.py

```python
"""Live connection recovery and raw recording, without real serial hardware."""
import contextlib
import csv
import io
import json
from pathlib import Path
import subprocess
import sys
import tempfile
import types
import unittest
from unittest import mock

import receiver
import test_receiver as wire

class Clock:
    def __init__(self):
        self.now = 0.0
        self.sleeps = []

    def sleep(self, duration):
        self.sleeps.append(duration)
        self.now += duration

class Port:
    def __init__(self, *events, clock=None):
        self.events = iter(events)
        self.buffer = b''
        self.closed = False
        self.clock = clock

    def __enter__(self):
        return self

    def __exit__(self, *args):
        self.closed = True

    @property
    def in_waiting(self):
        return len(self.buffer)

    def read(self, count):
        if not self.buffer:
            try:
                event = next(self.events)
            except StopIteration:
                raise KeyboardInterrupt
            if isinstance(event, BaseException):
                raise event
            self.buffer = event
        data, self.buffer = self.buffer[:count], self.buffer[count:]
        return data

class SerialSessionTests(unittest.TestCase):
    def invoke(self, factory, args, cv=None, np=None, clock=None):
        clock = clock or Clock()
        serial = types.SimpleNamespace(Serial=factory, SerialException=OSError)
        modules = {'serial': serial}
        if cv is not None:
            modules.update(cv2=cv, numpy=np)
        stdout, stderr = io.StringIO(), io.StringIO()
        exit_code = 0
        with (mock.patch.dict(sys.modules, modules),
              mock.patch.object(sys, 'argv', ['receiver.py', '--port', 'mock', *args]),
              mock.patch.object(receiver.time, 'monotonic', side_effect=lambda: clock.now),
              mock.patch.object(receiver.time, 'sleep', side_effect=clock.sleep),
              contextlib.redirect_stdout(stdout), contextlib.redirect_stderr(stderr)):
            try:
                receiver.main()
            except SystemExit as exc:
                exit_code = exc.code
        return exit_code, stdout.getvalue(), stderr.getvalue(), clock

    def test_reconnect_recovers_complete_tail_resets_preview_and_records_separate_streams(self):
        old = wire.packet(2, bytes(100), width=10, height=10)[:38]
        first_bytes = (wire.target_packet(10, base=dict(mode=1))
                       + wire.output_packet(11, transport=6)
                       + old + wire.output_packet(12, transport=6))
        second_bytes = (wire.output_packet(13, transport=6)
                        + wire.output_packet(14) + wire.output_packet(15, transport=6))
        first, second = Port(first_bytes, OSError('USB disconnected')), Port(second_bytes)
        factory = mock.Mock(side_effect=[first, second])
        cv, np = wire.DisplayCv(), wire.DisplayNumpy()
        with tempfile.TemporaryDirectory() as d:
            root = Path(d)
            # An unrelated old numbered recording must not be overwritten.
            (root / 'wire_001.bin').write_bytes(b'old evidence')
            args = ['--reconnect', '0.5', '--record-wire', str(root / 'wire.bin'),
                    '--out', str(root / 'frames'), '--count', '6',
                    '--display', '--hold-preview']
            code, output, error, clock = self.invoke(factory, args, cv, np)
            self.assertEqual(code, 0, error)
            self.assertEqual(factory.call_count, 2)
            self.assertTrue(first.closed and second.closed and cv.closed)
            self.assertEqual((root / 'wire.bin').read_bytes(), first_bytes)
            self.assertEqual((root / 'wire_001.bin').read_bytes(), b'old evidence')
            self.assertEqual((root / 'wire_002.bin').read_bytes(), second_bytes)
            metas = [json.loads(p.read_text()) for p in sorted((root / 'frames').glob('*.json'))]
            self.assertEqual([f['frame_id'] for f in metas], list(range(10, 16)))
            self.assertEqual(len(list((root / 'frames').glob('*.pgm'))), 2)
            self.assertTrue(all(f['image_file'] is None for f in metas if f['pixel_format'] == 'none'))
            self.assertIn('Received 6 valid frames;', output)
            self.assertIn('rejected/resynchronized 1 candidates', output)
            self.assertIn('reconnected', error)
            self.assertEqual(clock.sleeps, [0.25, 0.25])
            self.assertIn('Disconnected - retrying', cv.texts)
            # One disconnected canvas plus one blank features-only frame on the
            # new connection. It must not reuse preview frame 10 for target 13.
            self.assertEqual(np.blanks, [(4, 6), (4, 6)])
            self.assertIn('Preview frame=14 (held)', cv.texts)
            # Raw logs remain usable by the real file-input CLI independently.
            for name in ('wire.bin', 'wire_002.bin'):
                replay = subprocess.run(
                    [sys.executable, str(Path(receiver.__file__)), '--input', str(root / name),
                     '--out', str(root / (name + '.frames')), '--count', '3'],
                    capture_output=True, text=True, timeout=10)
                self.assertEqual(replay.returncode, 0, replay.stderr)

    def test_initial_open_failures_wait_before_retry_and_do_not_create_extra_segments(self):
        clock, calls = Clock(), []
        stream = Port(wire.output_packet(20, transport=6))
        results = iter([OSError('port missing'), OSError('still missing'), stream])
        def open_port(*args, **kwargs):
            calls.append(clock.now)
            value = next(results)
            if isinstance(value, BaseException):
                raise value
            return value
        with tempfile.TemporaryDirectory() as d:
            root = Path(d)
            code, _, error, _ = self.invoke(mock.Mock(side_effect=open_port),
                ['--reconnect', '0.6', '--record-wire', str(root / 'capture.bin'),
                 '--out', str(root / 'frames'), '--count', '1'], clock=clock)
            self.assertEqual(code, 0, error)
            self.assertEqual(len(calls), 3)
            for actual, expected in zip(calls, (0, 0.6, 1.2)):
                self.assertAlmostEqual(actual, expected)
            self.assertTrue(all(0 < delay <= 0.25 for delay in clock.sleeps))
            self.assertEqual(list(root.glob('capture*.bin')), [root / 'capture.bin'])
            self.assertEqual((root / 'capture.bin').read_bytes(), wire.output_packet(20, transport=6))
            self.assertTrue(stream.closed)

    def test_lost_half_packet_cannot_cross_connection_even_with_idle_resync_disabled(self):
        original = wire.packet(40, bytes(100), width=10, height=10)
        first, second = Port(original[:35], OSError('removed')), Port(wire.packet(41))
        with tempfile.TemporaryDirectory() as d:
            code, _, error, _ = self.invoke(mock.Mock(side_effect=[first, second]),
                ['--reconnect', '0.1', '--idle-resync', '0', '--count', '1', '--out', d])
            self.assertEqual(code, 0, error)
            frames = [json.loads(p.read_text()) for p in Path(d).glob('*.json')]
            self.assertEqual([f['frame_id'] for f in frames], [41])
            self.assertTrue(first.closed and second.closed)

    def test_recording_preserves_first_byte_when_availability_query_disconnects(self):
        class RemovedPort(Port):
            @property
            def in_waiting(self):
                raise OSError('device removed after first byte')
        first, second = RemovedPort(b'FPG1'), Port(wire.packet(42))
        with tempfile.TemporaryDirectory() as d:
            root = Path(d)
            code, _, error, _ = self.invoke(mock.Mock(side_effect=[first, second]),
                ['--reconnect', '0.1', '--record-wire', str(root / 'wire.bin'),
                 '--count', '1', '--out', str(root / 'frames')])
            self.assertEqual(code, 0, error)
            self.assertEqual((root / 'wire.bin').read_bytes(), b'F')
            self.assertEqual((root / 'wire_001.bin').read_bytes(), wire.packet(42))
            self.assertTrue(first.closed and second.closed)

    def test_without_reconnect_open_failure_is_an_actionable_nonzero_exit(self):
        factory = mock.Mock(side_effect=OSError('port is busy'))
        code, output, error, _ = self.invoke(factory, [])
        self.assertEqual(code, 1)
        self.assertIn('Received 0 valid frames', output)
        self.assertIn('Serial connection failed (mock): port is busy', error)
        self.assertNotIn('Traceback', error)
        self.assertEqual(factory.call_count, 1)

    def test_without_reconnect_read_failure_keeps_saved_frame_and_raw_bytes(self):
        data = wire.packet(47)
        stream = Port(data, OSError('USB removed'))
        factory = mock.Mock(return_value=stream)
        with tempfile.TemporaryDirectory() as d:
            root = Path(d)
            code, output, error, _ = self.invoke(factory,
                ['--record-wire', str(root / 'wire.bin'), '--out', str(root / 'frames')])
            self.assertEqual(code, 1)
            self.assertIn('Received 1 valid frames', output)
            self.assertIn('USB removed', error)
            self.assertNotIn('Traceback', error)
            self.assertEqual((root / 'wire.bin').read_bytes(), data)
            self.assertEqual(len(list((root / 'frames').glob('*.json'))), 1)
            self.assertEqual(factory.call_count, 1)
            self.assertTrue(stream.closed)

    def test_repeated_reconnections_close_ports_and_preserve_duplicate_frame_ids(self):
        data = wire.packet(7)
        ports = [Port(data, OSError('removed')) for _ in range(32)]
        factory = mock.Mock(side_effect=ports)
        with tempfile.TemporaryDirectory() as d:
            root = Path(d)
            code, output, error, _ = self.invoke(factory,
                ['--reconnect', '0.001', '--record-wire', str(root / 'wire.bin'),
                 '--out', str(root / 'frames'), '--count', '32'])
            self.assertEqual(code, 0, error)
            self.assertIn('Received 32 valid frames', output)
            self.assertEqual(factory.call_count, 32)
            self.assertTrue(all(port.closed for port in ports))
            recordings = list(root.glob('wire*.bin'))
            self.assertEqual(len(recordings), 32)
            self.assertTrue(all(path.read_bytes() == data for path in recordings))
            self.assertEqual(len(list((root / 'frames').glob('*.pgm'))), 32)
            with (root / 'frames/metadata.csv').open(newline='', encoding='utf-8') as handle:
                rows = list(csv.DictReader(handle))
            self.assertEqual(len(rows), 32)
            self.assertTrue(all(row['frame_id'] == '7' for row in rows))
            self.assertEqual(len({row['image_file'] for row in rows}), 32)

    def test_display_quit_is_handled_during_reconnect_backoff(self):
        factory = mock.Mock(side_effect=OSError('missing'))
        cv, np = wire.DisplayCv(), wire.DisplayNumpy()
        cv.waitKey = mock.Mock(side_effect=[-1, ord('q')])
        code, _, error, clock = self.invoke(factory, ['--reconnect', '2', '--display'], cv, np)
        self.assertEqual(code, 0, error)
        self.assertEqual(factory.call_count, 1)
        self.assertEqual(clock.sleeps, [0.25])
        self.assertTrue(cv.closed)
        self.assertIn('Disconnected - retrying', cv.texts)

    def test_keyboard_interrupt_closes_and_flushes_raw_recording(self):
        stream = Port(b'noiseFPG1partial', KeyboardInterrupt())
        with tempfile.TemporaryDirectory() as d:
            path = Path(d) / 'nested' / 'wire.bin'
            code, _, error, _ = self.invoke(mock.Mock(return_value=stream), ['--record-wire', str(path)])
            self.assertEqual(code, 0, error)
            self.assertTrue(stream.closed)
            self.assertEqual(path.read_bytes(), b'noiseFPG1partial')

    def test_existing_recording_fails_before_opening_port_and_is_preserved(self):
        factory = mock.Mock()
        with tempfile.TemporaryDirectory() as d:
            path = Path(d) / 'wire.bin'
            path.write_bytes(b'historical bytes')
            code, _, error, _ = self.invoke(factory, ['--record-wire', str(path)])
            self.assertEqual(code, 2)
            self.assertIn('recording file already exists', error)
            factory.assert_not_called()
            self.assertEqual(path.read_bytes(), b'historical bytes')

    def test_recording_write_failure_stops_instead_of_reconnecting(self):
        stream = Port(wire.packet(43))
        factory = mock.Mock(return_value=stream)
        with tempfile.TemporaryDirectory() as d:
            with mock.patch.object(receiver.WireRecorder, 'write',
                                   side_effect=receiver.RecordingError('disk full')):
                code, _, error, clock = self.invoke(factory,
                    ['--reconnect', '1', '--record-wire', str(Path(d) / 'wire.bin')])
            self.assertEqual(code, 1)
            self.assertIn('disk full', error)
            self.assertNotIn('retrying', error)
            self.assertEqual(factory.call_count, 1)
            self.assertEqual(clock.sleeps, [])
            self.assertTrue(stream.closed)
        # Real OSError from the file handle must be classified the same way.
        recorder = receiver.WireRecorder('unused')
        recorder.handle = mock.Mock()
        recorder.handle.write.side_effect = OSError('disk full')
        with self.assertRaises(receiver.RecordingError):
            recorder.write(b'x')

    def test_recording_rotation_failure_closes_new_port_without_retrying(self):
        first, second = Port(wire.packet(44), OSError('removed')), Port(wire.packet(45))
        factory = mock.Mock(side_effect=[first, second])
        with tempfile.TemporaryDirectory() as d:
            with mock.patch.object(receiver.WireRecorder, 'rotate', side_effect=PermissionError('cannot rotate')):
                code, output, error, _ = self.invoke(factory,
                    ['--reconnect', '0.1', '--record-wire', str(Path(d) / 'wire.bin'), '--out', str(Path(d) / 'frames')])
            self.assertEqual(code, 1)
            self.assertIn('Received 1 valid frames', output)
            self.assertIn('cannot rotate', error)
            self.assertEqual(factory.call_count, 2)
            self.assertTrue(first.closed and second.closed)

    def test_frame_save_error_is_not_treated_as_serial_disconnection(self):
        stream = Port(wire.packet(46))
        factory = mock.Mock(return_value=stream)
        with mock.patch.object(receiver, 'save_frame', side_effect=OSError('output full')):
            code, _, error, clock = self.invoke(factory, ['--reconnect', '1'])
        self.assertEqual(code, 1)
        self.assertIn('output full', error)
        self.assertNotIn('retrying', error)
        self.assertEqual(factory.call_count, 1)
        self.assertEqual(clock.sleeps, [])
        self.assertTrue(stream.closed)

    def test_invalid_reconnect_values_and_file_input_options_fail_before_optional_imports(self):
        script = str(Path(receiver.__file__))
        for value in ('-1', 'nan', 'inf'):
            with self.subTest(value=value):
                result = subprocess.run([sys.executable, script, '--port', 'unused', '--reconnect', value],
                                        capture_output=True, text=True, timeout=10)
                self.assertEqual(result.returncode, 2)
                self.assertIn('--reconnect must be a finite nonnegative number', result.stderr)
                self.assertNotIn('Traceback', result.stderr)
        for options in (['--reconnect', '1'], ['--record-wire', 'unused.bin']):
            result = subprocess.run([sys.executable, script, '--input', 'missing.bin', *options],
                                    capture_output=True, text=True, timeout=10)
            self.assertEqual(result.returncode, 2)
            self.assertIn('require --port', result.stderr)

if __name__ == '__main__':
    unittest.main()
```

## pc/test_vision_status.py

```python
import binascii
import json
from pathlib import Path
import struct
import subprocess
import sys
import tempfile
import unittest

import vision_status

def packet(base=100, flags=9, version=1, length=58):
    header = b'VST1' + struct.pack('<BBH', version, flags, length)
    header += b''.join(struct.pack('<I', (base + 17 * i) & 0xffffffff) for i in range(12))
    return header + struct.pack('<H', binascii.crc_hqx(header[4:], 0xffff))

class VisionStatusTests(unittest.TestCase):
    def test_fragmented_status_snapshots_keep_all_counters_and_flags(self):
        decoder = vision_status.StatusParser()
        statuses = []
        for value in packet(100, 9) + packet(200, 2):
            statuses.extend(decoder.feed(bytes([value])))
        self.assertEqual(len(statuses), 2)
        self.assertEqual([status['frame_id'] for status in statuses], [100, 200])
        for index, status in enumerate(statuses):
            self.assertEqual([status[key] for key in vision_status.FIELDS],
                             [(index + 1) * 100 + i * 17 for i in range(12)])
        self.assertTrue(statuses[0]['configured'] and statuses[0]['pattern'])
        self.assertTrue(statuses[1]['camera_fault'])
        self.assertFalse(statuses[1]['configured'] or statuses[1]['pattern'])
        self.assertEqual(decoder.rejected, 0)
        self.assertFalse(decoder.finish())

    def test_bad_crc_version_flags_and_size_resynchronize(self):
        damaged = bytearray(packet())
        damaged[30] ^= 1
        bad = [damaged, packet(version=2), packet(flags=16), packet(length=57)]
        for candidate in bad:
            with self.subTest(header=candidate[:8]):
                decoder = vision_status.StatusParser()
                statuses = decoder.feed(candidate + packet(300))
                self.assertEqual([s['frame_id'] for s in statuses], [300])
                self.assertGreater(decoder.rejected, 0)

    def test_noise_is_bounded_and_truncated_connection_is_discarded(self):
        decoder = vision_status.StatusParser()
        self.assertEqual(decoder.feed(b'x' * 100000), [])
        self.assertLessEqual(len(decoder.buffer), 3)
        self.assertEqual(decoder.feed(packet()[:20]), [])
        self.assertTrue(decoder.finish())
        self.assertEqual(decoder.feed(packet(400))[0]['frame_id'], 400)
        self.assertFalse(decoder.finish())

    def test_unsigned_counter_wrap_values_are_preserved(self):
        status = vision_status.StatusParser().feed(packet(0xffffffff, flags=15))[0]
        self.assertEqual(status['frame_id'], 0xffffffff)
        self.assertEqual(status['processed_frames'], 16)
        self.assertTrue(status['paused'])

    def test_cli_preserves_old_logs_and_counts_complete_status_packets(self):
        with tempfile.TemporaryDirectory() as d:
            root = Path(d)
            path = root / 'wire.bin';path.write_bytes(packet(100) + packet(200) + packet(300)[:20])
            out = root / 'logs';out.mkdir()
            (out / 'status_0000000001.json').write_text('historical status')
            command = [sys.executable, str(Path(vision_status.__file__)), '--input', str(path),
                       '--out', str(out), '--count', '2']
            result = subprocess.run(command, capture_output=True, text=True, timeout=10)
            self.assertEqual(result.returncode, 0, result.stderr)
            self.assertIn('Received 2 valid status packets', result.stdout)
            self.assertEqual((out / 'status_0000000001.json').read_text(), 'historical status')
            self.assertEqual(json.loads((out / 'status_0000000002.json').read_text())['frame_id'], 100)
            self.assertEqual(json.loads((out / 'status_0000000003.json').read_text())['frame_id'], 200)
            self.assertEqual(len(list(out.glob('*.json'))), 3)

    def test_cli_reports_incomplete_eof_and_missing_requested_packets(self):
        with tempfile.TemporaryDirectory() as d:
            root = Path(d);path = root / 'wire.bin';path.write_bytes(packet() + packet(200)[:20])
            script = str(Path(vision_status.__file__))
            result = subprocess.run([sys.executable, script, '--input', str(path), '--out', str(root / 'a')],
                                    capture_output=True, text=True, timeout=10)
            self.assertEqual(result.returncode, 1)
            self.assertIn('incomplete status packet', result.stderr)
            path.write_bytes(packet())
            result = subprocess.run([sys.executable, script, '--input', str(path),
                                     '--out', str(root / 'b'), '--count', '2'],
                                    capture_output=True, text=True, timeout=10)
            self.assertEqual(result.returncode, 1)
            self.assertIn('requested status count', result.stderr)

if __name__ == '__main__':
    unittest.main()
```

## pc/vision_status.py

```python
"""Optional VST1 diagnostics for vision_top; image processing never waits for PC."""
import argparse
import binascii
import json
import math
from pathlib import Path
import struct

from receiver import SerialInput

MAGIC = b'VST1'
PACKET = struct.Struct('<4sBBH12IH')
FIELDS = ('frame_id', 'processed_frames', 'displayed_frames', 'display_dropped',
          'display_skipped', 'capture_errors', 'line_errors', 'input_overflows',
          'processing_errors', 'display_errors', 'processing_fps', 'last_latency_cycles')

class StatusParser:
    def __init__(self):
        self.buffer = bytearray()
        self.rejected = 0

    def feed(self, chunk):
        self.buffer.extend(chunk)
        statuses = []
        while True:
            pos = self.buffer.find(MAGIC)
            if pos < 0:
                self.buffer[:] = self.buffer[-3:]
                break
            if pos:
                del self.buffer[:pos]
            if len(self.buffer) < 8:
                break
            version, flags, length = struct.unpack_from('<BBH', self.buffer, 4)
            if version != 1 or flags & ~15 or length != PACKET.size:
                self.rejected += 1
                del self.buffer[0]
                continue
            if len(self.buffer) < PACKET.size:
                break
            values = PACKET.unpack_from(self.buffer)
            if binascii.crc_hqx(self.buffer[4:PACKET.size-2], 0xffff) != values[-1]:
                self.rejected += 1
                del self.buffer[0]
                continue
            status = dict(zip(FIELDS, values[4:-1]))
            status.update(version=version, configured=bool(flags & 1),
                          camera_fault=bool(flags & 2), paused=bool(flags & 4),
                          pattern=bool(flags & 8))
            statuses.append(status)
            del self.buffer[:PACKET.size]
        return statuses

    def finish(self):
        truncated = self.buffer.startswith(MAGIC)
        self.buffer.clear()
        return truncated

def main():
    parser = argparse.ArgumentParser(description=__doc__)
    source = parser.add_mutually_exclusive_group(required=True)
    source.add_argument('--input', type=Path)
    source.add_argument('--port')
    parser.add_argument('--baud', type=int, default=1000000)
    parser.add_argument('--count', type=int)
    parser.add_argument('--out', type=Path, default=Path('status_logs'))
    parser.add_argument('--reconnect', type=float, default=0)
    args = parser.parse_args()
    if args.baud < 1 or (args.count is not None and args.count < 1):
        parser.error('--baud and --count must be positive')
    if not math.isfinite(args.reconnect) or args.reconnect < 0:
        parser.error('--reconnect must be finite and nonnegative')
    if args.input and args.reconnect:
        parser.error('--reconnect requires --port')
    decoder = StatusParser()
    count, index = 0, 0
    try:
        if args.input:
            stream = args.input.open('rb')
        else:
            import serial
            stream = SerialInput(serial, args.port, args.baud, args.reconnect)
        with stream:
            args.out.mkdir(parents=True, exist_ok=True)
            while args.count is None or count < args.count:
                chunk = stream.read(4096) if args.input else stream.read()
                if chunk is None:
                    decoder.finish()
                    continue
                if not chunk and args.input:
                    if decoder.finish():
                        parser.exit(1, 'Input ended with an incomplete status packet.\n')
                    break
                for status in decoder.feed(chunk):
                    while True:
                        index += 1
                        path = args.out / f'status_{index:010d}.json'
                        try:
                            handle = path.open('x', encoding='utf-8')
                            break
                        except FileExistsError:
                            continue
                    with handle:
                        handle.write(json.dumps(status, indent=2) + '\n')
                    count += 1
                    print(f'{path}: processed={status["processed_frames"]} '
                          f'fps={status["processing_fps"]} dropped={status["display_dropped"]}')
                    if args.count is not None and count >= args.count:
                        break
    except KeyboardInterrupt:
        return
    except OSError as exc:
        parser.exit(1, f'Status I/O error: {exc}\n')
    print(f'Received {count} valid status packets; rejected {decoder.rejected}.')
    if args.count is not None and count < args.count:
        parser.exit(1, 'Input ended before requested status count.\n')

if __name__ == '__main__':
    main()
```

## rtl/camera_config.sv

```systemverilog
`timescale 1ns/1ps
// Original SCCB write sequencer. Open-drain SIOC/SIOD need external pullups.
// 100 MHz / (4*250) = 100 kHz. No clock-stretch support (OV7670 SCCB).
// SCCB's ninth bit is formally don't-care; this module checks the ACK that
// common OV7670 modules provide. Set CHECK_ACK=0 only after scope diagnosis.
module camera_config #(
  parameter integer QUARTER_CYCLES=250,POWER_WAIT=10000000,REG_WAIT=100000,
  parameter integer CHECK_ACK=1,DIRECT_IO=1
)(input wire clk,rst,inout wire sioc,siod,output reg done,error,
  output wire scl_drive_low,sda_drive_low);
  reg scl_low,sda_low,ack_failed;
  assign sioc=(DIRECT_IO && scl_low)?1'b0:1'bz;
  assign siod=(DIRECT_IO && sda_low)?1'b0:1'bz;
  assign scl_drive_low=scl_low;
  assign sda_drive_low=sda_low;
  reg[31:0]divider,wait_count;
  reg[5:0]index;
  reg[3:0]state,bit_pos;
  reg[1:0]byte_pos;
  reg[23:0]word_data;
  localparam WAITING=0,START=1,BIT_LOW=2,BIT_RISE=3,BIT_HIGH=4,BIT_FALL=5,
    STOP_LOW=6,STOP_RISE=7,STOP_RELEASE=8,NEXT_REG=9,FINISHED=10,FAILED=11;
  localparam REG_COUNT=39;
  // QVGA through 2x DCW from VGA, UYVY (Y is second byte), full-range Y.
  // Keep PCLK running in horizontal blanking for AL422B refresh.
  function automatic [15:0] setting(input [5:0]n);
    case(n)
      0:setting=16'h1280; // software reset; wait 100 ms afterward
      1:setting=16'h1101; // input clock /2, module oscillator 12 or 24 MHz
      2:setting=16'h6b0a; // PLL bypass
      3:setting=16'h1200; // YUV, VGA window before DCW
      4:setting=16'h0c04; // enable downsampling
      5:setting=16'h3e19; // DCW + PCLK divide
      6:setting=16'h703a;
      7:setting=16'h7135;
      8:setting=16'h7211; // horizontal and vertical /2
      9:setting=16'h73f1;
     10:setting=16'ha202;
     11:setting=16'h1716; // window high and low bits must be a matched set
     12:setting=16'h1804;
     13:setting=16'h3224;
     14:setting=16'h1902;
     15:setting=16'h1a7a;
     16:setting=16'h030a;
     17:setting=16'h1502; // negative VSYNC, normal HREF, continuous PCLK
     18:setting=16'h3a0c; // TSLB bit3=1: UYVY, Y_BYTE=1 (bit2 is reserved)
     19:setting=16'h3dc0; // gamma + UV saturation, no UV swap
     20:setting=16'h40c0; // Y output 0..255
     21:setting=16'h8c00; // RGB444 disabled
     22:setting=16'h0400;
     23:setting=16'h1e00; // no mirror/flip
     24:setting=16'h13e7; // auto exposure/gain/white balance
     25:setting=16'h1438;
     26:setting=16'h3b0a;
     27:setting=16'h4f80;
     28:setting=16'h5080;
     29:setting=16'h5100;
     30:setting=16'h5222;
     31:setting=16'h535e;
     32:setting=16'h5480;
     33:setting=16'h589e;
     34:setting=16'h5500; // neutral brightness
     35:setting=16'h5640;
     36:setting=16'h4108;
     37:setting=16'h5500;
     38:setting=16'h4200; // color bars disabled
     default:setting=16'hffff;
    endcase
  endfunction
  always @(posedge clk) begin
    if(rst)begin
      scl_low<=0;sda_low<=0;done<=0;error<=0;ack_failed<=0;divider<=0;
      wait_count<=POWER_WAIT;index<=0;state<=WAITING;
      bit_pos<=0;byte_pos<=0;word_data<=0;
    end else if(state==WAITING)begin
      if(wait_count!=0)wait_count<=wait_count-1;
      else begin word_data<={8'h42,setting(index)};state<=START;divider<=0;end
    end else if(divider!=QUARTER_CYCLES-1)divider<=divider+1;
    else begin
      divider<=0;
      case(state)
        START:begin scl_low<=0;sda_low<=1;byte_pos<=0;bit_pos<=0;state<=BIT_LOW;end
        BIT_LOW:begin scl_low<=1;sda_low<=(bit_pos==8)?0:~word_data[23];state<=BIT_RISE;end
        BIT_RISE:begin scl_low<=0;state<=BIT_HIGH;end
        BIT_HIGH:begin
          if(bit_pos==8 && CHECK_ACK && siod!=1'b0)ack_failed<=1;
          state<=BIT_FALL;
        end
        BIT_FALL:begin
          scl_low<=1;
          if(bit_pos==8)begin
            bit_pos<=0;
            if(byte_pos==2)state<=STOP_LOW;
            else begin byte_pos<=byte_pos+1'b1;state<=BIT_LOW;end
          end else begin bit_pos<=bit_pos+1'b1;word_data<=word_data<<1;state<=BIT_LOW;end
        end
        STOP_LOW:begin scl_low<=1;sda_low<=1;state<=STOP_RISE;end
        STOP_RISE:begin scl_low<=0;state<=STOP_RELEASE;end
        STOP_RELEASE:begin sda_low<=0;state<=NEXT_REG;end
        // Publish failure only after STOP releases the bus. The top level may
        // then reset and retry even with a short retry delay.
        NEXT_REG:if(ack_failed)begin error<=1;state<=FAILED;end
          else if(index==REG_COUNT-1)begin done<=1;state<=FINISHED;end
          else begin index<=index+1'b1;wait_count<=(index==0)?POWER_WAIT:REG_WAIT;state<=WAITING;end
        FINISHED:done<=1;
        FAILED:begin scl_low<=0;sda_low<=0;end
        default:state<=WAITING;
      endcase
    end
  end
endmodule

// Passive register diagnostic after camera_config releases the SCCB bus.
// Two STOP-separated transactions per read: 42,register; then 43,read,NACK.
// Byte lanes in values: PID(0A), COM10(15), TSLB(3A), COM7(12).
// ACK failure is latched; values are not trustworthy when error=1.
module camera_readback #(parameter integer QUARTER_CYCLES=250,DIRECT_IO=1)(
  input wire clk,rst,enable,inout wire sioc,siod,
  output reg done,error,output reg[31:0]values,
  output wire scl_drive_low,sda_drive_low);
  localparam IDLE=0,GAP=1,START=2,TX_LOW=3,TX_RISE=4,TX_SAMPLE=5,TX_FALL=6,
    RX_LOW=7,RX_RISE=8,RX_SAMPLE=9,RX_FALL=10,
    STOP_LOW=11,STOP_RISE=12,STOP_RELEASE=13,NEXT=14,FINISHED=15;
  reg[3:0]state,bit_index;
  reg[31:0]divider;
  reg[1:0]index,gap_count;
  reg read_pass,second_byte,scl_low,sda_low;
  reg[15:0]tx_word;
  reg[7:0]rx_byte;
  assign sioc=(DIRECT_IO && scl_low)?1'b0:1'bz;
  assign siod=(DIRECT_IO && sda_low)?1'b0:1'bz;
  assign scl_drive_low=scl_low;
  assign sda_drive_low=sda_low;
  function automatic[7:0]address(input[1:0]n);
    case(n)0:address=8'h0a;1:address=8'h15;2:address=8'h3a;3:address=8'h12;endcase
  endfunction
  always @(posedge clk)begin
    if(rst)begin
      state<=IDLE;divider<=0;index<=0;gap_count<=0;bit_index<=0;
      read_pass<=0;second_byte<=0;scl_low<=0;sda_low<=0;
      tx_word<=0;rx_byte<=0;done<=0;error<=0;values<=0;
    end else if(state==IDLE)begin
      if(enable)begin state<=GAP;tx_word<=16'h420a;divider<=0;gap_count<=0;end
    end else if(divider!=QUARTER_CYCLES-1)divider<=divider+1;
    else begin
      divider<=0;
      case(state)
        GAP:if(gap_count==3)begin state<=START;gap_count<=0;end
            else gap_count<=gap_count+1'b1;
        START:begin sda_low<=1;scl_low<=0;bit_index<=0;second_byte<=0;state<=TX_LOW;end
        TX_LOW:begin scl_low<=1;sda_low<=(bit_index==8)?0:~tx_word[15];state<=TX_RISE;end
        TX_RISE:begin scl_low<=0;state<=TX_SAMPLE;end
        TX_SAMPLE:begin if(bit_index==8 && siod!=0)error<=1;state<=TX_FALL;end
        TX_FALL:begin
          scl_low<=1;
          if(bit_index==8)begin
            bit_index<=0;
            if(read_pass)begin rx_byte<=0;state<=RX_LOW;end
            else if(second_byte)state<=STOP_LOW;
            else begin second_byte<=1;state<=TX_LOW;end
          end else begin bit_index<=bit_index+1'b1;tx_word<=tx_word<<1;state<=TX_LOW;end
        end
        RX_LOW:begin scl_low<=1;sda_low<=0;state<=RX_RISE;end
        RX_RISE:begin scl_low<=0;state<=RX_SAMPLE;end
        RX_SAMPLE:begin if(bit_index<8)rx_byte<={rx_byte[6:0],siod};state<=RX_FALL;end
        RX_FALL:begin
          scl_low<=1;
          if(bit_index==8)state<=STOP_LOW;
          else begin bit_index<=bit_index+1'b1;state<=RX_LOW;end
        end
        STOP_LOW:begin scl_low<=1;sda_low<=1;state<=STOP_RISE;end
        STOP_RISE:begin scl_low<=0;state<=STOP_RELEASE;end
        STOP_RELEASE:begin sda_low<=0;state<=NEXT;end
        NEXT:begin
          if(!read_pass)begin read_pass<=1;tx_word<=16'h4300;state<=GAP;end
          else begin
            values[index*8+:8]<=rx_byte;
            if(index==3)begin done<=1;state<=FINISHED;end
            else begin index<=index+1'b1;read_pass<=0;tx_word<={8'h42,address(index+2'd1)};state<=GAP;end
          end
        end
        FINISHED:begin scl_low<=0;sda_low<=0;end
        default:state<=IDLE;
      endcase
    end
  end
endmodule
```

## rtl/camera_frontend.sv

```systemverilog
`timescale 1ns/1ps
// Existing OV7670/AL422 adapter, with mandatory HREF line-count validation.
// The external AL422 performs the camera-clock -> clk domain frame transfer.
module camera_frontend #(
  parameter integer W=320,H=240,CAM_RESET_CYCLES=1000000,CAM_SETTLE_CYCLES=1000000,
  parameter integer CAM_RETRY_CYCLES=100000000,CAPTURE_TIMEOUT_CYCLES=100000000,
  parameter integer READ_PERIOD=50,FLUSH_CYCLES=10000,CHECK_LINES=1
)(input wire clk100,rst,start,input wire[7:0]cam_data,input wire cam_vsync,cam_href,
  inout wire cam_sioc,cam_siod,cam_rst_n,output wire cam_rclk,cam_rrst_n,cam_wen,
  output wire config_done,output reg camera_fault=0,
  output reg frame_start,pixel_valid,output reg[7:0]pixel,output reg done,
  output wire busy,error,output reg line_error,output wire[15:0]captured_lines);
  localparam integer RESET_END=CAM_RESET_CYCLES+CAM_SETTLE_CYCLES;
  wire config_error;
  reg[$clog2(RESET_END+1)-1:0]camera_reset_count=0;
  reg[31:0]camera_retry_count=0;

  always @(posedge clk100)begin
    if(rst)begin
      camera_reset_count<=0;camera_retry_count<=0;camera_fault<=0;
    end else begin
      if(config_error)camera_fault<=1;
      else if(config_done)camera_fault<=0;
      if(camera_reset_count<RESET_END)begin
        camera_reset_count<=camera_reset_count+1'b1;camera_retry_count<=0;
      end else if(config_error && CAM_RETRY_CYCLES>0)begin
        if(camera_retry_count==CAM_RETRY_CYCLES-1)begin
          camera_reset_count<=0;camera_retry_count<=0;
        end else camera_retry_count<=camera_retry_count+1'b1;
      end else camera_retry_count<=0;
    end
  end
  wire camera_reset_low=rst || (camera_reset_count<CAM_RESET_CYCLES);
  wire camera_config_rst=rst || (camera_reset_count<RESET_END);
  assign cam_rst_n=camera_reset_low?1'b0:1'bz;
  wire cfg_scl_low,cfg_sda_low,rd_scl_low,rd_sda_low;
  wire read_done,read_error;
  wire[31:0]register_values;
  // One physical open-drain driver per pin. Configuration then readback;
  // the inactive sequencer releases both lines.
  assign cam_sioc=(cfg_scl_low||rd_scl_low)?1'b0:1'bz;
  assign cam_siod=(cfg_sda_low||rd_sda_low)?1'b0:1'bz;
  camera_config #(.DIRECT_IO(0)) config_camera(clk100,camera_config_rst,cam_sioc,cam_siod,
    config_done,config_error,cfg_scl_low,cfg_sda_low);
  camera_readback #(.DIRECT_IO(0)) read_camera(clk100,camera_config_rst,config_done,
    cam_sioc,cam_siod,read_done,read_error,register_values,rd_scl_low,rd_sda_low);

  wire raw_sof,raw_valid,raw_done;wire[7:0]raw_pixel;
  fifo_capture #(.W(W),.H(H),.READ_PERIOD(READ_PERIOD),.FLUSH_CYCLES(FLUSH_CYCLES),
    .TIMEOUT_CYCLES(CAPTURE_TIMEOUT_CYCLES)) capture_camera(
    clk100,rst,start,cam_vsync,cam_data,cam_rclk,cam_rrst_n,cam_wen,
    raw_sof,raw_valid,raw_pixel,raw_done,busy,error);
  wire vs_seen,href_seen,wen_seen,overlap_seen,href_high,href_low;
  wire[15:0]high_lines,low_lines;
  camera_monitor monitor_camera(clk100,rst,config_done,cam_vsync,cam_href,cam_wen,
    vs_seen,href_seen,wen_seen,overlap_seen,captured_lines,href_high,href_low,high_lines,low_lines);
  reg valid_frame;
  always @(posedge clk100)begin
    if(rst)begin frame_start<=0;pixel_valid<=0;pixel<=0;done<=0;line_error<=0;valid_frame<=0;end
    else begin
      frame_start<=0;line_error<=0;pixel_valid<=raw_valid && valid_frame;pixel<=raw_pixel;done<=raw_done;
      if(start)valid_frame<=0;
      if(raw_sof)begin
        valid_frame<=!CHECK_LINES || captured_lines==H;
        frame_start<=!CHECK_LINES || captured_lines==H;
        line_error<=CHECK_LINES && captured_lines!=H;
      end
    end
  end
endmodule
```

## rtl/display_frame_queue.sv

```systemverilog
`timescale 1ns/1ps
// Two complete-frame slots. A slow/missing display drops NEW whole frames;
// acquisition and processing never wait for out_ready. Uncommitted frames
// remain invisible. frame_start precedes the first input pixel by >=1 clock.
module display_frame_queue #(parameter integer W=316,H=236)(
  input wire clk,rst,frame_start,frame_abort,
  input wire[31:0]in_frame_id,input wire in_processed,
  input wire in_valid,input wire[7:0]in_pixel,input wire in_last,
  output reg dropped,malformed,output wire[1:0]level,
  output reg out_valid,input wire out_ready,output wire[7:0]out_pixel,
  output reg[31:0]out_frame_id,output reg out_processed,
  output wire out_sof,out_eol,out_eof,output reg frame_delivered
);
  localparam integer PIXELS=W*H,AW=(PIXELS<2)?1:$clog2(PIXELS+1);
  (* ram_style="block" *) reg[7:0]memory0[0:PIXELS-1],memory1[0:PIXELS-1];
  reg[7:0]q0,q1;
  reg[1:0]occupied,ready_frames;
  reg write_ptr,read_ptr,writing,reading,read_bank;
  reg[AW-1:0]write_index,next_read,out_index;
  reg[31:0]ids[0:1];reg processed[0:1];
  wire delivered=out_valid && out_ready && out_eof;
  wire can_admit=!occupied[write_ptr] || (delivered && read_bank==write_ptr);
  wire start_read=!reading && ready_frames[read_ptr];
  wire advance_read=reading && (!out_valid || out_ready) && next_read<PIXELS;
  wire load=start_read || advance_read;
  wire[AW-1:0]address=start_read?0:next_read;
  assign out_pixel=read_bank?q1:q0;
  assign out_sof=out_valid && out_index==0;
  assign out_eol=out_valid && (out_index%W)==W-1;
  assign out_eof=out_valid && out_index==PIXELS-1;
  assign level={1'b0,occupied[0]}+{1'b0,occupied[1]};
  always @(posedge clk)begin
    if(in_valid && writing && !frame_abort && !frame_start && !rst)begin
      if(!write_ptr)memory0[write_index]<=in_pixel;
      else memory1[write_index]<=in_pixel;
    end
    if(load && !rst)begin q0<=memory0[address];q1<=memory1[address];end
  end
  always @(posedge clk)begin
    if(rst)begin
      occupied<=0;ready_frames<=0;write_ptr<=0;read_ptr<=0;writing<=0;reading<=0;read_bank<=0;
      write_index<=0;next_read<=0;out_index<=0;out_valid<=0;out_frame_id<=0;out_processed<=0;
      dropped<=0;malformed<=0;frame_delivered<=0;ids[0]<=0;ids[1]<=0;processed[0]<=0;processed[1]<=0;
    end else begin
      dropped<=0;malformed<=0;frame_delivered<=delivered;
      if(delivered)begin
        occupied[read_bank]<=0;reading<=0;out_valid<=0;read_ptr<=!read_ptr;
      end
      if(start_read)begin
        read_bank<=read_ptr;reading<=1;ready_frames[read_ptr]<=0;
        out_frame_id<=ids[read_ptr];out_processed<=processed[read_ptr];
        out_valid<=1;out_index<=0;next_read<=1;
      end else if(advance_read)begin
        out_valid<=1;out_index<=next_read;next_read<=next_read+1'b1;
      end
      if(frame_abort && writing)begin occupied[write_ptr]<=0;writing<=0;end
      if(frame_start)begin
        if(writing)begin
          // Reject an overlapping producer frame; caller must restart cleanly.
          occupied[write_ptr]<=0;writing<=0;malformed<=1;
        end else if(can_admit)begin
          occupied[write_ptr]<=1;writing<=1;write_index<=0;
          ids[write_ptr]<=in_frame_id;processed[write_ptr]<=in_processed;
        end else begin writing<=0;dropped<=1;end
      end else if(in_valid && writing && !frame_abort)begin
        if(in_last || write_index==PIXELS-1)begin
          writing<=0;
          if(in_last && write_index==PIXELS-1)begin
            ready_frames[write_ptr]<=1;write_ptr<=!write_ptr;
          end else begin occupied[write_ptr]<=0;malformed<=1;end
        end else write_index<=write_index+1'b1;
      end
    end
  end
endmodule
```

## rtl/edge_preserve9.sv

```systemverilog
`timescale 1ns/1ps
// Quantized variance-adaptive edge-preserving 3x3 smoothing.
// mean=floor(sum/9), v=9*sum(square)-sum*sum = 81*population variance.
// No data-dependent division. All arithmetic is unsigned until detail extraction.
module edge_preserve9 #(parameter integer EPSILON=64)(
  input wire clk,rst,in_valid,input wire[71:0]window_data,
  input wire[7:0]in_raw,in_fine,input wire[15:0]in_x,in_y,
  output reg out_valid,output reg[7:0]out_raw,out_fine,out_base,
  output reg[15:0]out_x,out_y
);
  reg[11:0]sum_comb;reg[19:0]square_comb;integer i;
  reg[11:0]sum0;reg[19:0]square0;
  reg[7:0]center0,raw0,fine0,mean1,center1,raw1,fine1;
  reg[15:0]x0,y0,x1,y1;reg v0,v1;reg[23:0]variance1;
  wire[23:0]square_sum={4'b0,square0}*24'd9;
  wire[23:0]sum_square={12'b0,sum0}*{12'b0,sum0};
  wire[9:0]half_blend={2'b0,center1}+{2'b0,mean1};
  wire[9:0]edge_blend=({2'b0,center1}*10'd3)+{2'b0,mean1};
  always @*begin
    sum_comb=0;square_comb=0;
    for(i=0;i<9;i=i+1)begin
      sum_comb=sum_comb+window_data[i*8+:8];
      square_comb=square_comb+({12'b0,window_data[i*8+:8]}*{12'b0,window_data[i*8+:8]});
    end
  end
  always @(posedge clk)begin
    if(rst)begin
      v0<=0;v1<=0;out_valid<=0;sum0<=0;square0<=0;variance1<=0;
      center0<=0;raw0<=0;fine0<=0;mean1<=0;center1<=0;raw1<=0;fine1<=0;
      x0<=0;y0<=0;x1<=0;y1<=0;out_x<=0;out_y<=0;out_raw<=0;out_fine<=0;out_base<=0;
    end else begin
      v0<=in_valid;v1<=v0;out_valid<=v1;
      if(in_valid)begin
        sum0<=sum_comb;square0<=square_comb;center0<=window_data[32+:8];
        raw0<=in_raw;fine0<=in_fine;x0<=in_x;y0<=in_y;
      end
      if(v0)begin
        mean1<=sum0/9;variance1<=square_sum-sum_square;
        center1<=center0;raw1<=raw0;fine1<=fine0;x1<=x0;y1<=y0;
      end
      if(v1)begin
        if(variance1<=EPSILON*81)out_base<=mean1;
        else if(variance1<=EPSILON*324)out_base<=half_blend>>1;
        else out_base<=edge_blend>>2;
        out_raw<=raw1;out_fine<=fine1;out_x<=x1;out_y<=y1;
      end
    end
  end
endmodule
```

## rtl/enhance_core.sv

```systemverilog
`timescale 1ns/1ps
// Two 3x3 scales -> aligned raw/fine/coarse -> Q4 detail reconstruction.
// W,H >= 5. Output is (W-4)x(H-4), sensor coordinates 2..W-3,2..H-3.
// Accepts one pixel/clock; frame_start may accompany pixel (0,0).
module enhance_core #(parameter integer W=320,H=240,EPSILON_FINE=64,EPSILON_COARSE=256)(
  input wire clk,rst,frame_start,in_valid,input wire[7:0]in_pixel,
  input wire[7:0]fine_gain_q4,coarse_gain_q4,detail_limit,
  output reg out_valid,output reg[7:0]out_raw,out_fine,out_coarse,out_enhanced,
  output reg[15:0]out_x,out_y,output wire out_sof,out_eol,out_eof
);
  wire valid_w1,valid_b1,valid_w2,valid_b2;
  wire[71:0]w1,w2;wire[143:0]w2_pair;
  wire[15:0]wx1,wy1,x1,y1,wx2,wy2,x2,y2;
  wire[7:0]raw1,base1,raw2,fine2,base2,unused_fine;
  reg[7:0]gain_fine,gain_coarse,limit_latched;
  window3x3 #(.W(W),.H(H)) first_window(clk,rst,frame_start,in_valid,in_pixel,
    valid_w1,w1,wx1,wy1);
  edge_preserve9 #(.EPSILON(EPSILON_FINE)) fine_filter(clk,rst||frame_start,
    valid_w1,w1,w1[32+:8],w1[32+:8],wx1,wy1,valid_b1,raw1,unused_fine,base1,x1,y1);
  wire second_start=valid_b1 && x1==1 && y1==1;
  window3x3 #(.W(W-2),.H(H-2),.DATA_WIDTH(16)) second_window(
    clk,rst||frame_start,second_start,valid_b1,{raw1,base1},valid_w2,w2_pair,wx2,wy2);
  genvar g;generate for(g=0;g<9;g=g+1)begin:unpack_base
    assign w2[g*8+:8]=w2_pair[g*16+:8];
  end endgenerate
  edge_preserve9 #(.EPSILON(EPSILON_COARSE)) coarse_filter(clk,rst||frame_start,
    valid_w2,w2,w2_pair[72+:8],w2_pair[64+:8],wx2+16'd1,wy2+16'd1,
    valid_b2,raw2,fine2,base2,x2,y2);
  wire signed[9:0]df=$signed({2'b0,raw2})-$signed({2'b0,fine2});
  wire signed[9:0]dc=$signed({2'b0,fine2})-$signed({2'b0,base2});
  wire signed[9:0]lim=$signed({2'b0,limit_latched});
  wire signed[9:0]clip_f=(df>lim)?lim:((df < -lim)?-lim:df);
  wire signed[9:0]clip_c=(dc>lim)?lim:((dc < -lim)?-lim:dc);
  reg signed[19:0]product_f,product_c;
  reg[7:0]raw3,fine3,base3;reg[15:0]x3,y3;reg v3;
  wire signed[23:0]detail_sum=$signed(product_f)+$signed(product_c);
  wire signed[23:0]reconstructed=$signed({1'b0,base3})+(detail_sum>>>4);
  assign out_sof=out_valid && out_x==2 && out_y==2;
  assign out_eol=out_valid && out_x==W-3;
  assign out_eof=out_eol && out_y==H-3;
  always @(posedge clk)begin
    if(rst || frame_start)begin
      gain_fine<=fine_gain_q4;gain_coarse<=coarse_gain_q4;limit_latched<=detail_limit;
      v3<=0;out_valid<=0;product_f<=0;product_c<=0;raw3<=0;fine3<=0;base3<=0;x3<=0;y3<=0;
      out_raw<=0;out_fine<=0;out_coarse<=0;out_enhanced<=0;out_x<=0;out_y<=0;
    end else begin
      v3<=valid_b2;out_valid<=v3;
      if(valid_b2)begin
        product_f<=clip_f*$signed({1'b0,gain_fine});
        product_c<=clip_c*$signed({1'b0,gain_coarse});
        raw3<=raw2;fine3<=fine2;base3<=base2;x3<=x2;y3<=y2;
      end
      if(v3)begin
        out_raw<=raw3;out_fine<=fine3;out_coarse<=base3;out_x<=x3;out_y<=y3;
        out_enhanced<=(reconstructed<0)?0:((reconstructed>255)?255:reconstructed[7:0]);
      end
    end
  end
endmodule
```

## rtl/fifo_capture.sv

```systemverilog
`timescale 1ns/1ps
// OV7670 + AL422B module adapter. Module MUST gate writes with HREF.
// Configure negative VSYNC and connect module WRST# to its VSYNC.
// RCLK is free-running at 2 MHz by default, including between frames.
module fifo_capture #(
  parameter integer W=320,H=240, READ_PERIOD=50,
  parameter integer FLUSH_CYCLES=10000,TIMEOUT_CYCLES=100000000,
  parameter integer Y_BYTE=1
)(
  input wire clk,rst,start,cam_vsync,input wire [7:0]cam_data,
  output reg cam_rclk,output reg cam_rrst_n,cam_wen,
  output reg frame_start,pixel_valid,output reg[7:0]pixel,
  output reg done,output wire busy,output reg error
);
  localparam IDLE=0,WAIT_BLANK=1,WAIT_FRAME=2,CAPTURE=3,FLUSH=4,RESET_READ=5,READ=6;
  reg[2:0] state;
  reg[31:0] timer;
  reg[7:0] phase;
  reg[2:0] reset_count;
  reg[18:0] byte_count;
  (* ASYNC_REG="TRUE" *) reg[1:0]vs_sync;
  assign busy=(state!=IDLE);
  always @(posedge clk) begin
    if(rst) begin
      vs_sync<=2'b11;phase<=0;cam_rclk<=0;state<=IDLE;timer<=0;
      reset_count<=0;byte_count<=0;cam_rrst_n<=1;cam_wen<=0;
      frame_start<=0;pixel_valid<=0;pixel<=0;done<=0;error<=0;
    end else begin
      vs_sync<={vs_sync[0],cam_vsync};
      phase<=(phase==READ_PERIOD-1)?0:phase+1'b1;
      if(phase==READ_PERIOD/2-1)cam_rclk<=1;
      if(phase==READ_PERIOD-1)cam_rclk<=0;
      frame_start<=0;pixel_valid<=0;done<=0;
      if(state>=WAIT_BLANK && state<=CAPTURE) begin
        timer<=timer+1;
        if(timer==TIMEOUT_CYCLES-1) begin
          state<=IDLE;cam_wen<=0;error<=1;
        end else case(state)
          WAIT_BLANK: if(!vs_sync[1])state<=WAIT_FRAME;
          WAIT_FRAME: if(vs_sync[1])begin state<=CAPTURE;cam_wen<=1;end
          CAPTURE: if(!vs_sync[1])begin state<=FLUSH;cam_wen<=0;timer<=0;end
        endcase
      end else case(state)
        IDLE: if(start)begin state<=WAIT_BLANK;timer<=0;error<=0;end
        FLUSH: if(timer==FLUSH_CYCLES-1)begin
          if(phase==0)begin state<=RESET_READ;cam_rrst_n<=0;reset_count<=0;end
        end else timer<=timer+1;
        RESET_READ: if(phase==0)begin
          if(reset_count==4)begin
            cam_rrst_n<=1;state<=READ;byte_count<=0;frame_start<=1;
          end else reset_count<=reset_count+1'b1;
        end
        READ: if(phase==READ_PERIOD-5)begin
          // Data has settled for ~200 ns since RCLK rising edge.
          if(byte_count[0]==Y_BYTE)begin pixel<=cam_data;pixel_valid<=1;end
          if(byte_count==W*H*2-1)begin done<=1;state<=IDLE;end
          else byte_count<=byte_count+1'b1;
        end
        default: state<=IDLE;
      endcase
    end
  end
endmodule
```

## rtl/frame_sender.sv

```systemverilog
`timescale 1ns/1ps
// Frozen framebuffer -> FPG1 packet. All inputs except RAM data latch at start.
// RAM must implement a synchronous one-cycle read; it remains frozen while busy.
module frame_sender #(
  parameter integer W=318,H=238,CLKS_PER_BIT=100,TARGET_PROTOCOL=0,OUTPUT_PROTOCOL=0
)(
  input wire clk,rst,start,edge_mode, input wire [10:0] threshold,
  input wire [31:0] frame_id,bright_count,sum_x,sum_y,
  output reg [16:0] ram_addr, input wire [7:0] ram_data,
  output wire busy, output reg done, output wire uart_txd,
  input wire target_enable,target_valid,target_dark,config_valid,
  input wire [7:0] target_threshold,
  input wire [15:0] roi_x_min,roi_y_min,roi_x_max,roi_y_max,
  input wire [15:0] bbox_x_min,bbox_y_min,bbox_x_max,bbox_y_max,
  input wire [31:0] target_area,target_sum_x,target_sum_y,min_area,max_area,
  input wire pack_edges,features_only
);
  localparam integer PIXELS=W*H;
  localparam [3:0] IDLE=0,HEADER=1,RAM_WAIT=2,RAM_CAPTURE=3,
    PIXEL=4,CRC_LO=5,CRC_HI=6,DRAIN=7;
  reg [3:0] state;
  reg [575:0] header;
  reg [6:0] header_index,header_length;
  reg [16:0] pixel_index;
  reg [7:0] pixel_byte;
  reg packed_output,features_output;
  reg [2:0] pack_index;
  reg [15:0] crc;
  // The default constant disables every new input, including unconnected ports
  // in legacy instantiations. Packet length is selected only when start latches.
  wire use_target=(TARGET_PROTOCOL!=0)?target_enable:1'b0;
  wire use_features=(OUTPUT_PROTOCOL!=0)?(use_target && features_only):1'b0;
  wire use_packed=(OUTPUT_PROTOCOL!=0)?(pack_edges && edge_mode && !use_features):1'b0;
  wire use_v3=use_features || use_packed;
  wire ready;
  wire valid=(state==HEADER || state==PIXEL || state==CRC_LO || state==CRC_HI);
  wire [7:0] data=(state==HEADER)?header[header_index*8 +: 8]:
    (state==PIXEL)?pixel_byte:(state==CRC_LO)?crc[7:0]:crc[15:8];
  assign busy=(state!=IDLE);
  uart_tx #(.CLKS_PER_BIT(CLKS_PER_BIT)) tx(.clk(clk),.rst(rst),.valid(valid),.data(data),.ready(ready),.tx(uart_txd));
  function [15:0] crc_byte(input [15:0] old_crc,input [7:0] b);
    reg [15:0] c; integer i;
    begin c=old_crc^{b,8'b0};
      for(i=0;i<8;i=i+1) c=c[15]?(c<<1)^16'h1021:c<<1;
      crc_byte=c;
    end
  endfunction
  always @(posedge clk) begin
    if(rst) begin state<=IDLE; done<=0; ram_addr<=0; header<=0; header_index<=0; header_length<=32;
      pixel_index<=0; pixel_byte<=0; packed_output<=0; features_output<=0;
      pack_index<=0; crc<=16'hffff; end
    else begin
      done<=0;
      case(state)
        IDLE: if(start) begin
          header[31:0]<=32'h31475046;
          header[39:32]<=use_v3?8'd3:(use_target?8'd2:8'd1); header[47:40]<={7'b0,edge_mode};
          header[63:48]<=W; header[79:64]<=H;
          header[95:80]<={5'b0,threshold}; header[127:96]<=frame_id;
          header[159:128]<=use_features?0:(use_packed?((PIXELS+7)/8):PIXELS);
          header[191:160]<=bright_count;
          header[223:192]<=sum_x; header[255:224]<=sum_y;
          header[263:256]<={5'b0,config_valid,target_dark,target_valid};
          header[271:264]<=target_threshold;
          header[287:272]<=roi_x_min; header[303:288]<=roi_y_min;
          header[319:304]<=roi_x_max; header[335:320]<=roi_y_max;
          header[351:336]<=bbox_x_min; header[367:352]<=bbox_y_min;
          header[383:368]<=bbox_x_max; header[399:384]<=bbox_y_max;
          header[431:400]<=target_area; header[463:432]<=target_sum_x;
          header[495:464]<=target_sum_y; header[527:496]<=min_area;
          header[559:528]<=max_area;
          // A packed image can omit target detection. Its extension must be
          // deterministic even when target inputs are unconnected or changing.
          if(use_v3 && !use_target) header[559:256]<=0;
          header[567:560]<=use_features?8'd6:(use_packed?(use_target?8'd5:8'd1):8'd0);
          header[575:568]<=0;
          header_length<=(use_v3 || use_target)?7'd72:7'd32;
          packed_output<=use_packed; features_output<=use_features;
          header_index<=0; pixel_index<=0; ram_addr<=0; pixel_byte<=0; pack_index<=0;
          crc<=16'hffff; state<=HEADER;
        end
        HEADER: if(ready) begin
          if(header_index>=4) crc<=crc_byte(crc,data);
          if(header_index==header_length-1'b1) state<=features_output?CRC_LO:RAM_WAIT;
          else header_index<=header_index+1'b1;
        end
        // Address is presented before RAM_WAIT. Capture one full cycle later.
        RAM_WAIT: state<=RAM_CAPTURE;
        RAM_CAPTURE: begin
          if(packed_output) begin
            pixel_byte[pack_index]<=ram_data[7];
            if(pack_index==7 || pixel_index==PIXELS-1) state<=PIXEL;
            else begin
              pack_index<=pack_index+1'b1; pixel_index<=pixel_index+1'b1;
              ram_addr<=ram_addr+1'b1; state<=RAM_WAIT;
            end
          end else begin pixel_byte<=ram_data; state<=PIXEL; end
        end
        PIXEL: if(ready) begin
          crc<=crc_byte(crc,pixel_byte);
          if(pixel_index==PIXELS-1) state<=CRC_LO;
          else begin
            pixel_index<=pixel_index+1'b1; ram_addr<=ram_addr+1'b1;
            pack_index<=0; pixel_byte<=0; state<=RAM_WAIT;
          end
        end
        CRC_LO: if(ready) state<=CRC_HI;
        CRC_HI: if(ready) state<=DRAIN;
        DRAIN: if(ready) begin state<=IDLE; done<=1; end
        default: state<=IDLE;
      endcase
    end
  end
endmodule
```

## rtl/image_core.sv

```systemverilog
`timescale 1ns/1ps
module image_core #(parameter W=320,H=240)(
input clk,rst,frame_start,edge_mode,input [10:0] threshold,
input in_valid,input [7:0] in_pixel,output reg out_valid,
output reg [7:0] out_pixel,output reg [16:0] out_addr,
output reg done,output reg [31:0] bright_count,sum_x,sum_y);
  // Contract: W,H >= 3, W*H <= 131072; input pixels >= 4 clocks apart.
  // Three rotating banks keep writes separate from the two previous rows.
  // Only RAM output registers, never the RAM contents, enter the pipeline.
  localparam XW=$clog2(W), YW=$clog2(H);
  (* ram_style="block" *) reg [7:0] row0[0:W-1];
  (* ram_style="block" *) reg [7:0] row1[0:W-1];
  (* ram_style="block" *) reg [7:0] row2[0:W-1];
  reg [7:0] q0,q1,q2;
  reg [XW-1:0] x,px,cx;
  reg [YW-1:0] y,py,cy;
  reg [1:0] bank,pbank;
  reg active,mode_latched,pending,window_valid,last_window,last_output;
  reg [10:0] threshold_latched;
  reg [7:0] pixel_pending;
  reg [7:0] tl,tc,tr,ml,mc,mr,bl,bc,br;
  reg [16:0] next_addr;
  // Four arithmetic stages: weighted sides, signed difference, absolute value,
  // then magnitude/threshold. Metadata follows the same valid pipeline.
  reg [9:0] right_sum,left_sum,bottom_sum,top_sum;
  reg signed [10:0] gx_reg,gy_reg;
  reg [10:0] ax_reg,ay_reg;
  reg sides_valid,gradient_valid,absolute_valid;
  reg sides_last,gradient_last,absolute_last;
  reg [7:0] sides_center,gradient_center,absolute_center;
  reg [XW-1:0] sides_x,gradient_x,absolute_x;
  reg [YW-1:0] sides_y,gradient_y,absolute_y;
  wire accept=in_valid && active && !rst && !frame_start;
  wire [7:0] top_value=(pbank==0)?q1:((pbank==1)?q2:q0);
  wire [7:0] mid_value=(pbank==0)?q2:((pbank==1)?q0:q1);
  wire [11:0] magnitude={1'b0,ax_reg}+{1'b0,ay_reg}; // conservative max 2040

  // Synchronous simple dual-port RAM templates; no reset on memory/read ports.
  always @(posedge clk) if(accept) begin
    q0<=row0[x]; q1<=row1[x]; q2<=row2[x];
    case(bank)
      0: row0[x]<=in_pixel;
      1: row1[x]<=in_pixel;
      2: row2[x]<=in_pixel;
    endcase
  end
  always @(posedge clk) begin
    if(rst || frame_start) begin
      x<=0;y<=0;bank<=0;active<=!rst;
      pending<=0;window_valid<=0;last_window<=0;last_output<=0;
      sides_valid<=0;gradient_valid<=0;absolute_valid<=0;
      sides_last<=0;gradient_last<=0;absolute_last<=0;
      sides_center<=0;gradient_center<=0;absolute_center<=0;
      sides_x<=0;gradient_x<=0;absolute_x<=0;
      sides_y<=0;gradient_y<=0;absolute_y<=0;
      right_sum<=0;left_sum<=0;bottom_sum<=0;top_sum<=0;
      gx_reg<=0;gy_reg<=0;ax_reg<=0;ay_reg<=0;
      out_valid<=0;out_pixel<=0;out_addr<=0;next_addr<=0;done<=0;
      bright_count<=0;sum_x<=0;sum_y<=0;
      mode_latched<=edge_mode;threshold_latched<=threshold;
      tl<=0;tc<=0;tr<=0;ml<=0;mc<=0;mr<=0;bl<=0;bc<=0;br<=0;
      px<=0;py<=0;cx<=0;cy<=0;pbank<=0;pixel_pending<=0;
    end else begin
      pending<=accept;window_valid<=0;out_valid<=0;
      sides_valid<=window_valid;gradient_valid<=sides_valid;absolute_valid<=gradient_valid;
      done<=last_output;last_output<=0;
      if(accept) begin
        px<=x;py<=y;pbank<=bank;pixel_pending<=in_pixel;
        if(x==W-1) begin
          x<=0;
          bank<=(bank==2)?0:bank+1'b1;
          if(y==H-1) active<=0; else y<=y+1'b1;
        end else x<=x+1'b1;
      end
      if(pending) begin
        tl<=tc;tc<=tr;tr<=top_value;
        ml<=mc;mc<=mr;mr<=mid_value;
        bl<=bc;bc<=br;br<=pixel_pending;
        // The first two columns replace stale shift-register values each row.
        window_valid<=(px>=2 && py>=2);
        cx<=px-1'b1;cy<=py-1'b1;
        last_window<=(px==W-1 && py==H-1);
      end
      if(window_valid) begin
        right_sum<={2'b0,tr}+{1'b0,mr,1'b0}+{2'b0,br};
        left_sum<={2'b0,tl}+{1'b0,ml,1'b0}+{2'b0,bl};
        bottom_sum<={2'b0,bl}+{1'b0,bc,1'b0}+{2'b0,br};
        top_sum<={2'b0,tl}+{1'b0,tc,1'b0}+{2'b0,tr};
        sides_center<=mc;sides_x<=cx;sides_y<=cy;sides_last<=last_window;
      end
      if(sides_valid) begin
        gx_reg<=$signed({1'b0,right_sum})-$signed({1'b0,left_sum});
        gy_reg<=$signed({1'b0,bottom_sum})-$signed({1'b0,top_sum});
        gradient_center<=sides_center;gradient_x<=sides_x;gradient_y<=sides_y;gradient_last<=sides_last;
      end
      if(gradient_valid) begin
        ax_reg<=gx_reg[10]?-gx_reg:gx_reg;
        ay_reg<=gy_reg[10]?-gy_reg:gy_reg;
        absolute_center<=gradient_center;absolute_x<=gradient_x;absolute_y<=gradient_y;absolute_last<=gradient_last;
      end
      if(absolute_valid) begin
        out_valid<=1;out_addr<=next_addr;next_addr<=next_addr+1'b1;
        out_pixel<=mode_latched?((magnitude>={1'b0,threshold_latched})?8'd255:8'd0):absolute_center;
        if(absolute_center>=128) begin
          bright_count<=bright_count+1'b1;sum_x<=sum_x+absolute_x;sum_y<=sum_y+absolute_y;
        end
        last_output<=absolute_last;
      end
    end
  end
endmodule
```

## rtl/pixel_fifo.sv

```systemverilog
`timescale 1ns/1ps
// Bounded single-clock ingress FIFO after the external AL422 clock crossing.
// DEPTH need not be a power of two. Full+pop can accept a replacement sample.
module pixel_fifo #(parameter integer WIDTH=9,DEPTH=16)(
  input wire clk,rst,in_valid,input wire[WIDTH-1:0]in_data,
  output wire in_ready,output wire out_valid,output wire[WIDTH-1:0]out_data,
  input wire out_ready,output reg overflow,
  output reg[$clog2(DEPTH+1)-1:0]level
);
  localparam integer AW=(DEPTH<2)?1:$clog2(DEPTH);
  reg[WIDTH-1:0]memory[0:DEPTH-1];reg[AW-1:0]wp,rp;
  assign out_valid=level!=0;
  assign in_ready=(level<DEPTH) || (out_valid && out_ready);
  assign out_data=memory[rp];
  wire push=in_valid && in_ready,pop=out_valid && out_ready;
  always @(posedge clk)begin
    if(rst)begin wp<=0;rp<=0;level<=0;overflow<=0;end
    else begin
      overflow<=in_valid && !in_ready;
      if(push)begin memory[wp]<=in_data;wp<=(wp==DEPTH-1)?0:wp+1'b1;end
      if(pop)rp<=(rp==DEPTH-1)?0:rp+1'b1;
      case({push,pop})2'b10:level<=level+1'b1;2'b01:level<=level-1'b1;default:level<=level;endcase
    end
  end
endmodule
```

## rtl/stream_top.sv

```systemverilog
`timescale 1ns/1ps
module stream_top #(
  parameter integer W=320,H=240,UART_DIV=100,START_DELAY=50000000,
  parameter integer CAM_RESET_CYCLES=1000000,CAM_SETTLE_CYCLES=1000000,
  parameter [15:0] ROI_X_MIN=1,ROI_Y_MIN=1,ROI_X_MAX=W-2,ROI_Y_MAX=H-2,
  parameter [31:0] TARGET_MIN_AREA=16,TARGET_MAX_AREA=((W-2)*(H-2))/2,
  parameter integer FRAME_DELAY=START_DELAY,FAST_FRAME_DELAY=0,
  parameter integer CAM_RETRY_CYCLES=100000000,CAPTURE_TIMEOUT_CYCLES=100000000,
  parameter integer PREVIEW_INTERVAL=16
)(input wire clk100,btnC,input wire[15:0]sw,input wire[7:0]cam_data,
  input wire cam_vsync,cam_href,inout wire cam_sioc,cam_siod,cam_rst_n,
  output wire cam_rclk,cam_rrst_n,cam_wen,uart_txd,output wire[15:0]led);
  (* ASYNC_REG="TRUE" *) reg[1:0]button_sync=0;
  reg[15:0]reset_hold=16'hffff;
  (* ASYNC_REG="TRUE" *) reg[15:0]sw_meta=0,sw_sync=0;
  always @(posedge clk100)begin
    button_sync<={button_sync[0],btnC};
    reset_hold<=button_sync[1]?16'hffff:{reset_hold[14:0],1'b0};
    sw_meta<=sw;sw_sync<=sw_meta;
  end
  wire rst=|reset_hold;
  // Open-drain camera reset: only drive low; the module IO-rail pullup
  // supplies the high level. Hold 10 ms, release and settle 10 ms at 100 MHz.
  localparam integer RESET_END=CAM_RESET_CYCLES+CAM_SETTLE_CYCLES;
  wire config_done,config_error;
  reg[$clog2(RESET_END+1)-1:0]camera_reset_count=0;
  reg[31:0]camera_retry_count=0;
  reg camera_fault=0;
  always @(posedge clk100)begin
    if(rst)begin
      camera_reset_count<=0;camera_retry_count<=0;camera_fault<=0;
    end else begin
      if(config_error)camera_fault<=1;
      else if(config_done)camera_fault<=0;
      if(camera_reset_count<RESET_END)begin
        camera_reset_count<=camera_reset_count+1'b1;camera_retry_count<=0;
      end else if(config_error && CAM_RETRY_CYCLES>0)begin
        if(camera_retry_count==CAM_RETRY_CYCLES-1)begin
          camera_reset_count<=0;camera_retry_count<=0;
        end else camera_retry_count<=camera_retry_count+1'b1;
      end else camera_retry_count<=0;
    end
  end
  wire camera_reset_low=rst || (camera_reset_count<CAM_RESET_CYCLES);
  wire camera_config_rst=rst || (camera_reset_count<RESET_END);
  assign cam_rst_n=camera_reset_low?1'b0:1'bz;
  wire cfg_scl_low,cfg_sda_low,rd_scl_low,rd_sda_low;
  wire read_done,read_error;
  wire[31:0]register_values;
  // One physical open-drain driver per pin. Configuration then readback;
  // the inactive sequencer releases both lines.
  assign cam_sioc=(cfg_scl_low||rd_scl_low)?1'b0:1'bz;
  assign cam_siod=(cfg_sda_low||rd_sda_low)?1'b0:1'bz;
  camera_config #(.DIRECT_IO(0)) config_camera(clk100,camera_config_rst,cam_sioc,cam_siod,
    config_done,config_error,cfg_scl_low,cfg_sda_low);
  camera_readback #(.DIRECT_IO(0)) read_camera(clk100,camera_config_rst,config_done,
    cam_sioc,cam_siod,read_done,read_error,register_values,rd_scl_low,rd_sda_low);
  reg capture_start;
  wire cap_sof,cap_valid,cap_done,cap_busy,cap_error;
  wire[7:0]cap_pixel;
  fifo_capture #(.W(W),.H(H),.TIMEOUT_CYCLES(CAPTURE_TIMEOUT_CYCLES)) capture_camera(
    clk100,rst,capture_start,cam_vsync,cam_data,cam_rclk,cam_rrst_n,cam_wen,
    cap_sof,cap_valid,cap_pixel,cap_done,cap_busy,cap_error);
  reg pattern_mode,edge_mode;
  reg[10:0]threshold;
  reg target_enable,target_dark;
  reg[7:0]target_threshold;
  reg packed_mode,features_only,fast_frames,startup_complete;
  // In results-only mode SW13 requests one fresh image per N sent packets.
  // Zero disables previews; one sends an image every time. Failed captures
  // and pauses do not consume a slot because only tx_done advances the count.
  localparam integer PREVIEW_COUNT_WIDTH=(PREVIEW_INTERVAL>1)?$clog2(PREVIEW_INTERVAL):1;
  reg preview_active;
  reg[PREVIEW_COUNT_WIDTH-1:0]preview_count;
  wire[10:0]requested_threshold=(sw_sync[7:4]==0)?11'd160:{1'b0,sw_sync[7:4],6'b0};
  wire requested_features=!sw_sync[14] && sw_sync[11] && sw_sync[2];
  wire preview_requested=(PREVIEW_INTERVAL>0) && requested_features && sw_sync[13];
  // Re-entering or changing the source/image interpretation starts with a
  // fresh image. Reset before acquisition so a timeout retries that preview.
  wire preview_refresh=preview_requested && (!preview_active ||
    pattern_mode!=sw_sync[0] || edge_mode!=sw_sync[1] ||
    (sw_sync[0] && target_dark!=!sw_sync[3]) ||
    (sw_sync[1] && threshold!=requested_threshold));
  wire preview_due=preview_requested && (preview_refresh || preview_count==0);
  wire selected_features_only=requested_features && !preview_due;
  reg pattern_sof,pattern_valid;
  reg[7:0]pattern_pixel;
  reg[8:0]px,py;
  reg[6:0]pixel_timer;
  reg pattern_active;
  wire core_valid,core_done;
  wire[7:0]core_pixel;
  wire[16:0]core_addr;
  wire[31:0]bright_count,sum_x,sum_y;
  wire source_sof=pattern_mode?pattern_sof:cap_sof;
  wire source_valid=pattern_mode?pattern_valid:cap_valid;
  wire[7:0]source_pixel=pattern_mode?pattern_pixel:cap_pixel;
  image_core #(.W(W),.H(H)) process_image(
    clk100,rst,source_sof,edge_mode,threshold,source_valid,source_pixel,
    core_valid,core_pixel,core_addr,core_done,bright_count,sum_x,sum_y);
  wire target_done,target_config_valid,target_valid;
  wire[31:0]target_area,target_sum_x,target_sum_y;
  wire[15:0]bbox_x_min,bbox_y_min,bbox_x_max,bbox_y_max;
  target_stats #(.W(W),.H(H)) locate_target(
    .clk(clk100),.rst(rst || !target_enable),.frame_start(source_sof),
    .in_valid(source_valid),.in_pixel(source_pixel),
    .target_dark(target_dark),.target_threshold(target_threshold),
    .roi_x_min(ROI_X_MIN),.roi_y_min(ROI_Y_MIN),.roi_x_max(ROI_X_MAX),.roi_y_max(ROI_Y_MAX),
    .min_area(TARGET_MIN_AREA),.max_area(TARGET_MAX_AREA),
    .done(target_done),.config_valid(target_config_valid),.target_valid(target_valid),
    .target_area(target_area),.target_sum_x(target_sum_x),.target_sum_y(target_sum_y),
    .bbox_x_min(bbox_x_min),.bbox_y_min(bbox_y_min),.bbox_x_max(bbox_x_max),.bbox_y_max(bbox_y_max));
  // Output framebuffer decouples continuous FIFO reads from slower UART.
  // It is intentionally NOT a resettable register array.
  (* ram_style="block" *) reg[7:0]framebuffer[0:(W-2)*(H-2)-1];
  wire[16:0]read_addr;
  reg[7:0]read_data;
  wire framebuffer_write=core_valid && !features_only;
  wire framebuffer_read=!features_only;
  always @(posedge clk100)begin
    if(framebuffer_write)framebuffer[core_addr]<=core_pixel;
    if(framebuffer_read)read_data<=framebuffer[read_addr];
  end
  reg tx_start;
  wire tx_busy,tx_done;
  reg[31:0]frame_id;
  frame_sender #(.W(W-2),.H(H-2),.CLKS_PER_BIT(UART_DIV),.TARGET_PROTOCOL(1),.OUTPUT_PROTOCOL(1)) send_image(
    .clk(clk100),.rst(rst),.start(tx_start),.edge_mode(edge_mode),.threshold(threshold),
    .frame_id(frame_id),.bright_count(bright_count),.sum_x(sum_x),.sum_y(sum_y),
    .ram_addr(read_addr),.ram_data(read_data),.busy(tx_busy),.done(tx_done),.uart_txd(uart_txd),
    .target_enable(target_enable),.target_valid(target_valid),.target_dark(target_dark),
    .config_valid(target_config_valid),.target_threshold(target_threshold),
    .roi_x_min(ROI_X_MIN),.roi_y_min(ROI_Y_MIN),.roi_x_max(ROI_X_MAX),.roi_y_max(ROI_Y_MAX),
    .bbox_x_min(bbox_x_min),.bbox_y_min(bbox_y_min),.bbox_x_max(bbox_x_max),.bbox_y_max(bbox_y_max),
    .target_area(target_area),.target_sum_x(target_sum_x),.target_sum_y(target_sum_y),
    .min_area(TARGET_MIN_AREA),.max_area(TARGET_MAX_AREA),
    .pack_edges(packed_mode),.features_only(features_only));
  localparam WAITING=0,LAUNCH=1,ARM=2,PROCESSING=3,SENDING=4;
  reg[2:0]state;
  reg[31:0]delay_count;
  reg[26:0]heartbeat;
  reg core_complete,target_complete;
  wire[31:0]frame_wait_cycles=!startup_complete?START_DELAY:
    (fast_frames?FAST_FRAME_DELAY:FRAME_DELAY);
  always @(posedge clk100)begin
    if(rst)begin
      state<=WAITING;delay_count<=0;heartbeat<=0;frame_id<=0;
      pattern_mode<=1;edge_mode<=0;threshold<=160;
      target_enable<=0;target_dark<=1;target_threshold<=96;
      packed_mode<=0;features_only<=0;fast_frames<=0;startup_complete<=0;
      preview_active<=0;preview_count<=0;
      core_complete<=0;target_complete<=0;
      capture_start<=0;tx_start<=0;pattern_sof<=0;pattern_valid<=0;
      px<=0;py<=0;pixel_timer<=0;pattern_pixel<=0;pattern_active<=0;
    end else begin
      heartbeat<=heartbeat+1'b1;
      capture_start<=0;tx_start<=0;pattern_sof<=0;pattern_valid<=0;
      if(core_done)core_complete<=1;
      if(target_done)target_complete<=1;
      if(pattern_active)begin
        if(pixel_timer==99)begin
          pixel_timer<=0;pattern_valid<=1;
          if(target_enable)
            pattern_pixel<=(px>=W/4 && px<W/2 && py>=H/4 && py<3*H/4)?
              (target_dark?32:220):(target_dark?220:32);
          else pattern_pixel<=(px>=W/4 && px<W/2 && py>=H/4 && py<3*H/4)?220:((px+py)%96);
          if(px==W-1)begin px<=0;if(py==H-1)pattern_active<=0;else py<=py+1'b1;end
          else px<=px+1'b1;
        end else pixel_timer<=pixel_timer+1'b1;
      end
      case(state)
        WAITING:if(delay_count<frame_wait_cycles)delay_count<=delay_count+1;
          else if(!sw_sync[15] && (sw_sync[0] || config_done))begin
            pattern_mode<=sw_sync[0];edge_mode<=sw_sync[1];
            threshold<=requested_threshold;
            target_enable<=sw_sync[2];target_dark<=!sw_sync[3];
            // SW10/11/12/13 retain diagnostic-page meanings under SW14.
            preview_active<=preview_requested;
            if(!preview_requested || preview_refresh)preview_count<=0;
            features_only<=selected_features_only;
            packed_mode<=!sw_sync[14] && sw_sync[10] && sw_sync[1] &&
              !selected_features_only;
            fast_frames<=!sw_sync[14] && sw_sync[12];
            case(sw_sync[9:8])
              2'b00:target_threshold<=96;
              2'b01:target_threshold<=64;
              2'b10:target_threshold<=128;
              2'b11:target_threshold<=160;
            endcase
            frame_id<=frame_id+1'b1;state<=LAUNCH;
          end
        LAUNCH:begin
          startup_complete<=1;
          core_complete<=0;target_complete<=0;
          if(pattern_mode)begin
            pattern_sof<=1;px<=0;py<=0;pixel_timer<=0;pattern_active<=1;state<=PROCESSING;
          end else begin capture_start<=1;state<=ARM;end
        end
        ARM:if(cap_busy)state<=PROCESSING;
        PROCESSING:if((core_done || core_complete) &&
            (!target_enable || target_done || target_complete))begin tx_start<=1;state<=SENDING;end
          else if(!pattern_mode && cap_error)begin delay_count<=0;state<=WAITING;end
        SENDING:if(tx_done)begin
          if(preview_active)begin
            if(PREVIEW_INTERVAL<=1 || preview_count==PREVIEW_INTERVAL-1)preview_count<=0;
            else preview_count<=preview_count+1'b1;
          end
          delay_count<=0;state<=WAITING;
        end
        default:state<=WAITING;
      endcase
    end
  end
  wire vs_seen,href_seen,wen_seen,overlap_seen,href_vs_high,href_vs_low;
  wire[15:0]captured_lines,high_lines,low_lines;
  camera_monitor monitor_camera(clk100,rst,config_done,cam_vsync,cam_href,cam_wen,
    vs_seen,href_seen,wen_seen,overlap_seen,captured_lines,href_vs_high,href_vs_low,high_lines,low_lines);
  // SW14 selects diagnostics and masks output-speedup switch requests.
  // In diagnostics SW13 chooses high/low line-count byte; normally it enables
  // periodic previews while SW2 and SW11 request target results.
  // Status means observed at FPGA inputs/internal WEN, not at the FIFO chip.
  // SW12 selects register readback page; SW11:10 chooses PID/COM10/TSLB/COM7.
  wire[7:0]register_byte=register_values[sw_sync[11:10]*8+:8];
  wire[15:0]diagnostic_lines=(sw_sync[11:10]==0)?captured_lines:
    (sw_sync[11:10]==1)?high_lines:(sw_sync[11:10]==2)?low_lines:16'b0;
  assign led=(sw_sync[14] && sw_sync[12])?{register_byte,!camera_config_rst,
    camera_fault,cap_error,href_vs_low,href_vs_high,read_error,read_done,config_done}:
    sw_sync[14]?{(sw_sync[13]?diagnostic_lines[15:8]:diagnostic_lines[7:0]),
    !camera_config_rst,camera_fault,cap_error,overlap_seen,wen_seen,href_seen,vs_seen,config_done}:
    {(!sw_sync[0] && (camera_fault||cap_error)),frame_id[7:0],
    heartbeat[26],edge_mode,pattern_mode,tx_busy,cap_busy,config_done,!rst};
endmodule

// Passive diagnostic observer. No connection to acquisition control.
// Kept in this source file so existing Vivado projects need no new RTL source.
module camera_monitor(input wire clk,rst,enabled,vsync,href,wen,
  output reg vs_seen,href_seen,wen_seen,overlap_seen,
  output reg[15:0]captured_lines,output reg href_vs_high,href_vs_low,
  output reg[15:0]high_lines,low_lines);
  (* ASYNC_REG="TRUE" *) reg[1:0]vs_sync=2'b11,href_sync=0;
  reg vs_prev,href_prev,wen_prev;
  reg[15:0]line_count;
  reg[15:0]high_count,low_count;
  always @(posedge clk)begin
    vs_sync<={vs_sync[0],vsync};href_sync<={href_sync[0],href};
    vs_prev<=vs_sync[1];href_prev<=href_sync[1];wen_prev<=wen;
    if(rst || !enabled)begin
      vs_seen<=0;href_seen<=0;wen_seen<=0;overlap_seen<=0;
      captured_lines<=0;line_count<=0;
      href_vs_high<=0;href_vs_low<=0;
      high_count<=0;low_count<=0;high_lines<=0;low_lines<=0;
    end else begin
      if(vs_prev!=vs_sync[1])vs_seen<=1;
      if(href_prev!=href_sync[1])href_seen<=1;
      if(wen)wen_seen<=1;
      if(wen && href_sync[1])overlap_seen<=1;
      // Sample VSYNC at each HREF rising edge, independent of WR.
      if(href_sync[1] && !href_prev)begin
        if(vs_sync[1])href_vs_high<=1;else href_vs_low<=1;
        if(vs_sync[1] && high_count!=16'hffff)high_count<=high_count+1'b1;
        if(!vs_sync[1] && low_count!=16'hffff)low_count<=low_count+1'b1;
      end
      // Latch each completed phase, independent of the capture controller.
      // A simultaneous HREF rise belongs to the newly entered VSYNC phase.
      if(vs_prev && !vs_sync[1])begin high_lines<=high_count;high_count<=0;end
      if(!vs_prev && vs_sync[1])begin low_lines<=low_count;low_count<=0;end
      // A first HREF edge can coincide with WEN becoming active.
      if(wen && !wen_prev)line_count<=(href_sync[1] && !href_prev)?16'd1:16'd0;
      else if(wen && href_sync[1] && !href_prev && line_count!=16'hffff)
        line_count<=line_count+1'b1;
      if(!wen && wen_prev)captured_lines<=line_count;
    end
  end
endmodule
```

## rtl/target_stats.sv

```systemverilog
`timescale 1ns/1ps
// Inclusive ROI threshold statistics in original sensor coordinates.
// Configuration and results belong to one frame; frame_start aborts any work.
module target_stats #(parameter integer W=320,H=240)(
  input wire clk,rst,frame_start,in_valid,
  input wire [7:0] in_pixel,
  input wire target_dark,
  input wire [7:0] target_threshold,
  input wire [15:0] roi_x_min,roi_y_min,roi_x_max,roi_y_max,
  input wire [31:0] min_area,max_area,
  output reg done,config_valid,
  output wire target_valid,
  output reg [31:0] target_area,target_sum_x,target_sum_y,
  output reg [15:0] bbox_x_min,bbox_y_min,bbox_x_max,bbox_y_max
);
  localparam integer XW=(W<2)?1:$clog2(W),YW=(H<2)?1:$clog2(H);
  localparam integer INTERIOR_PIXELS=(W-2)*(H-2);
  reg [XW-1:0] x;
  reg [YW-1:0] y;
  reg active,finish_pending,dark_latched;
  reg [7:0] threshold_latched;
  reg [15:0] x_min_latched,y_min_latched,x_max_latched,y_max_latched;
  reg [31:0] min_area_latched,max_area_latched;
  wire valid_configuration=(W>=3 && H>=3 &&
    roi_x_min>=1 && roi_x_min<=roi_x_max && roi_x_max<=W-2 &&
    roi_y_min>=1 && roi_y_min<=roi_y_max && roi_y_max<=H-2 &&
    min_area>=1 && min_area<=max_area && max_area<=INTERIOR_PIXELS);
  wire matching_pixel=config_valid &&
    x>=x_min_latched && x<=x_max_latched &&
    y>=y_min_latched && y<=y_max_latched &&
    (dark_latched?(in_pixel<=threshold_latched):(in_pixel>=threshold_latched));
  assign target_valid=config_valid && target_area!=0 &&
    target_area>=min_area_latched && target_area<=max_area_latched;

  always @(posedge clk) begin
    if(rst) begin
      x<=0;y<=0;active<=0;finish_pending<=0;done<=0;config_valid<=0;
      dark_latched<=0;threshold_latched<=0;
      x_min_latched<=0;y_min_latched<=0;x_max_latched<=0;y_max_latched<=0;
      min_area_latched<=0;max_area_latched<=0;
      target_area<=0;target_sum_x<=0;target_sum_y<=0;
      bbox_x_min<=0;bbox_y_min<=0;bbox_x_max<=0;bbox_y_max<=0;
    end else if(frame_start) begin
      x<=0;y<=0;active<=1;finish_pending<=0;done<=0;
      config_valid<=valid_configuration;
      dark_latched<=target_dark;threshold_latched<=target_threshold;
      x_min_latched<=roi_x_min;y_min_latched<=roi_y_min;
      x_max_latched<=roi_x_max;y_max_latched<=roi_y_max;
      min_area_latched<=min_area;max_area_latched<=max_area;
      target_area<=0;target_sum_x<=0;target_sum_y<=0;
      bbox_x_min<=0;bbox_y_min<=0;bbox_x_max<=0;bbox_y_max<=0;
    end else begin
      done<=finish_pending;
      finish_pending<=0;
      if(in_valid && active) begin
        if(matching_pixel) begin
          target_area<=target_area+1'b1;
          target_sum_x<=target_sum_x+x;
          target_sum_y<=target_sum_y+y;
          if(target_area==0) begin
            bbox_x_min<=x;bbox_x_max<=x;bbox_y_min<=y;bbox_y_max<=y;
          end else begin
            if(x<bbox_x_min)bbox_x_min<=x;
            if(x>bbox_x_max)bbox_x_max<=x;
            if(y<bbox_y_min)bbox_y_min<=y;
            if(y>bbox_y_max)bbox_y_max<=y;
          end
        end
        if(x==W-1) begin
          x<=0;
          if(y==H-1) begin active<=0;finish_pending<=1;end
          else y<=y+1'b1;
        end else x<=x+1'b1;
      end
    end
  end
endmodule
```

## rtl/uart_tx.sv

```systemverilog
`timescale 1ns/1ps
// Single-clock 8N1 transmitter. A byte is accepted only on valid && ready.
module uart_tx #(parameter integer CLKS_PER_BIT=100)(
  input wire clk,rst,valid, input wire [7:0] data,
  output wire ready, output reg tx
);
  localparam integer CW=(CLKS_PER_BIT<2)?1:$clog2(CLKS_PER_BIT);
  reg [CW-1:0] ticks;
  reg [3:0] bit_index;
  reg [9:0] bits;
  reg active;
  assign ready=~active;
  always @(posedge clk) begin
    if(rst) begin tx<=1; active<=0; ticks<=0; bit_index<=0; bits<=10'h3ff; end
    else if(!active) begin
      tx<=1;
      if(valid) begin bits<={1'b1,data,1'b0}; tx<=0; active<=1; ticks<=0; bit_index<=0; end
    end else if(ticks==CLKS_PER_BIT-1) begin
      ticks<=0;
      if(bit_index==9) begin active<=0; tx<=1; end
      else begin bit_index<=bit_index+1'b1; bits<={1'b1,bits[9:1]}; tx<=bits[1]; end
    end else ticks<=ticks+1'b1;
  end
endmodule
```

## rtl/vision_status_tx.sv

```systemverilog
`timescale 1ns/1ps
// Optional VST1 diagnostics. No backpressure connection to the image pipeline.
// Fixed 58 bytes: magic, version, flags, length, 12 uint32 counters, CRC16.
module vision_status_tx #(parameter integer CLKS_PER_BIT=100)(
  input wire clk,rst,start,input wire[7:0]flags,input wire[383:0]snapshot,
  output wire tx,output wire busy
);
  reg active,draining;reg[5:0]index;reg[447:0]body;reg[15:0]crc;
  wire ready;
  wire[7:0]data=(index<56)?body[index*8+:8]:(index==56)?crc[7:0]:crc[15:8];
  uart_tx #(.CLKS_PER_BIT(CLKS_PER_BIT)) uart(clk,rst,active && !draining,data,ready,tx);
  assign busy=active;
  function[15:0]update_crc(input[15:0]c,input[7:0]b);
    reg[15:0]v;integer j;
    begin v=c^{b,8'b0};for(j=0;j<8;j=j+1)v=v[15]?(v<<1)^16'h1021:v<<1;update_crc=v;end
  endfunction
  always @(posedge clk)begin
    if(rst)begin active<=0;draining<=0;index<=0;body<=0;crc<=16'hffff;end
    else if(!active)begin
      if(start)begin
        body<={snapshot,16'd58,flags,8'd1,32'h31545356};
        crc<=16'hffff;index<=0;draining<=0;active<=1;
      end
    end else if(draining)begin if(ready)begin active<=0;draining<=0;end end
    else if(ready)begin
      if(index>=4 && index<56)crc<=update_crc(crc,data);
      if(index==57)draining<=1;else index<=index+1'b1;
    end
  end
endmodule
```

## rtl/vision_top.sv

```systemverilog
`timescale 1ns/1ps
// Standalone platform core: camera -> bounded ingress -> two-scale enhancement
// -> decimation/raw selection -> two-slot display queue. All logic is clk100.
// The eventual board wrapper must provide the display PHY/clock adapter.
module vision_top #(
  parameter integer W=320,H=240,DISPLAY_SCALE=1,INPUT_DEPTH=16,
  parameter integer CLOCK_HZ=100000000,UART_DIV=100,PATTERN_DIV=100,
  parameter integer START_DELAY=50000000,FRAME_DELAY=0,
  parameter integer CAM_RESET_CYCLES=1000000,CAM_SETTLE_CYCLES=1000000,
  parameter integer CAM_RETRY_CYCLES=100000000,CAPTURE_TIMEOUT_CYCLES=100000000,
  parameter integer PROCESS_TIMEOUT_CYCLES=20000000,CAMERA_READ_PERIOD=50,CAMERA_FLUSH_CYCLES=10000
)(input wire clk100,btnC,input wire[15:0]sw,input wire[7:0]cam_data,
  input wire cam_vsync,cam_href,inout wire cam_sioc,cam_siod,cam_rst_n,
  output wire cam_rclk,cam_rrst_n,cam_wen,uart_txd,output wire[15:0]led,
  input wire display_ready,output wire display_valid,output wire[7:0]display_pixel,
  output wire display_sof,display_eol,display_eof,output wire[31:0]display_frame_id,
  output wire display_processed,output wire[15:0]display_width,display_height,
  output reg[31:0]frame_id,processed_frames,displayed_frames,display_dropped,display_skipped,
  output reg[31:0]capture_errors,line_errors,input_overflows,processing_errors,display_errors,
  output reg[31:0]processing_fps,last_latency_cycles
);
  localparam integer DW=(W-4+DISPLAY_SCALE-1)/DISPLAY_SCALE;
  localparam integer DH=(H-4+DISPLAY_SCALE-1)/DISPLAY_SCALE;
  (* ASYNC_REG="TRUE" *) reg[1:0]button_sync=0;
  (* ASYNC_REG="TRUE" *) reg[15:0]sw_meta=0,sw_sync=0;
  reg[15:0]reset_hold=16'hffff;
  always @(posedge clk100)begin
    button_sync<={button_sync[0],btnC};reset_hold<=button_sync[1]?16'hffff:{reset_hold[14:0],1'b0};
    sw_meta<=sw;sw_sync<=sw_meta;
  end
  wire rst=|reset_hold;
  wire config_done,camera_fault,cap_sof,cap_valid,cap_done,cap_busy,cap_error,line_error;
  wire[7:0]cap_pixel;wire[15:0]captured_lines;
  reg capture_start;
  camera_frontend #(.W(W),.H(H),.CAM_RESET_CYCLES(CAM_RESET_CYCLES),
    .CAM_SETTLE_CYCLES(CAM_SETTLE_CYCLES),.CAM_RETRY_CYCLES(CAM_RETRY_CYCLES),
    .CAPTURE_TIMEOUT_CYCLES(CAPTURE_TIMEOUT_CYCLES),.READ_PERIOD(CAMERA_READ_PERIOD),
    .FLUSH_CYCLES(CAMERA_FLUSH_CYCLES)) camera(
    clk100,rst,capture_start,cam_data,cam_vsync,cam_href,cam_sioc,cam_siod,cam_rst_n,
    cam_rclk,cam_rrst_n,cam_wen,config_done,camera_fault,cap_sof,cap_valid,cap_pixel,
    cap_done,cap_busy,cap_error,line_error,captured_lines);
  localparam WAITING=0,LAUNCH=1,ARM=2,CAMERA=3,PATTERN=4,DRAIN=5;
  reg[2:0]state;
  reg[31:0]delay_count,pattern_timer,second_timer,fps_count,latency_count;
  reg pattern_selected,view_processed,pattern_active,pattern_sof,pattern_valid,got_frame;
  reg[7:0]pattern_pixel,fine_gain,coarse_gain,detail_limit;
  reg[15:0]px,py;
  reg[1:0]display_rate;reg[2:0]display_phase;reg show_frame,processing_active,abort_frame;
  wire source_sof=pattern_selected?pattern_sof:((state==CAMERA)?cap_sof:1'b0);
  wire source_valid=pattern_selected?pattern_valid:((state==CAMERA)?cap_valid:1'b0);
  wire[7:0]source_pixel=pattern_selected?pattern_pixel:cap_pixel;
  wire ingress_ready,ingress_valid,ingress_overflow;wire[8:0]ingress_data;
  wire[$clog2(INPUT_DEPTH+1)-1:0]ingress_level;
  pixel_fifo #(.WIDTH(9),.DEPTH(INPUT_DEPTH)) ingress(clk100,rst||abort_frame,
    source_sof||source_valid,{source_sof,source_pixel},ingress_ready,
    ingress_valid,ingress_data,1'b1,ingress_overflow,ingress_level);
  wire process_start=ingress_valid && ingress_data[8];
  wire core_valid,core_sof,core_eol,core_eof;
  wire[7:0]core_raw,core_fine,core_coarse,core_enhanced;
  wire[15:0]core_x,core_y;
  enhance_core #(.W(W),.H(H)) enhance(clk100,rst||abort_frame,process_start,
    ingress_valid && !ingress_data[8],ingress_data[7:0],fine_gain,coarse_gain,detail_limit,
    core_valid,core_raw,core_fine,core_coarse,core_enhanced,core_x,core_y,core_sof,core_eol,core_eof);
  wire sample=core_valid && ((core_x-2)%DISPLAY_SCALE)==0 && ((core_y-2)%DISPLAY_SCALE)==0;
  wire last_sample=sample && core_x==2+(DW-1)*DISPLAY_SCALE && core_y==2+(DH-1)*DISPLAY_SCALE;
  wire[7:0]selected_pixel=view_processed?core_enhanced:core_raw;
  reg[7:0]pending_last_pixel;
  // Hold a decimated final pixel until the COMPLETE processing frame passes.
  // This prevents an early display commit before unsampled input tail pixels.
  always @(posedge clk100)if(last_sample)pending_last_pixel<=selected_pixel;
  wire queue_valid=show_frame && ((sample && !last_sample)||core_eof);
  wire[7:0]queue_pixel=core_eof?((last_sample)?selected_pixel:pending_last_pixel):selected_pixel;
  wire queue_dropped,queue_error,frame_delivered;wire[1:0]queue_level;
  display_frame_queue #(.W(DW),.H(DH)) display_queue(clk100,rst,
    process_start && show_frame,abort_frame,frame_id,view_processed,
    queue_valid,queue_pixel,core_eof,queue_dropped,queue_error,queue_level,
    display_valid,display_ready,display_pixel,display_frame_id,display_processed,
    display_sof,display_eol,display_eof,frame_delivered);
  assign display_width=DW;assign display_height=DH;
  wire second_tick=second_timer==CLOCK_HZ-1;
  wire status_busy;
  wire[383:0]status_snapshot={last_latency_cycles,processing_fps,display_errors,processing_errors,
    input_overflows,line_errors,capture_errors,display_skipped,display_dropped,
    displayed_frames,processed_frames,frame_id};
  vision_status_tx #(.CLKS_PER_BIT(UART_DIV)) debug_status(clk100,rst,
    second_tick && sw_sync[10],{4'b0,pattern_selected,sw_sync[15],camera_fault,config_done},
    status_snapshot,uart_txd,status_busy);
  assign led=sw_sync[14]?{captured_lines[7:0],queue_level,ingress_overflow,queue_error,
    camera_fault,cap_error,config_done,!rst}:
    {camera_fault||cap_error||(processing_errors!=0),frame_id[7:0],second_timer[25],
     view_processed,pattern_selected,status_busy,cap_busy,config_done,!rst};
  always @(posedge clk100)begin
    if(rst)begin
      state<=WAITING;delay_count<=0;capture_start<=0;frame_id<=0;
      pattern_selected<=1;view_processed<=1;pattern_active<=0;pattern_sof<=0;pattern_valid<=0;
      pattern_pixel<=0;pattern_timer<=0;px<=0;py<=0;fine_gain<=24;coarse_gain<=16;detail_limit<=32;
      display_rate<=0;display_phase<=0;show_frame<=1;got_frame<=0;processing_active<=0;abort_frame<=0;
      second_timer<=0;fps_count<=0;latency_count<=0;processing_fps<=0;last_latency_cycles<=0;
      processed_frames<=0;displayed_frames<=0;display_dropped<=0;display_skipped<=0;
      capture_errors<=0;line_errors<=0;input_overflows<=0;processing_errors<=0;display_errors<=0;
    end else begin
      capture_start<=0;pattern_sof<=0;pattern_valid<=0;abort_frame<=0;
      second_timer<=second_tick?0:second_timer+1'b1;
      if(second_tick)begin processing_fps<=fps_count+(core_eof?1:0);fps_count<=0;end
      else if(core_eof)fps_count<=fps_count+1'b1;
      if(process_start)begin processing_active<=1;latency_count<=0;end
      else if(processing_active)latency_count<=latency_count+1'b1;
      if(frame_delivered)displayed_frames<=displayed_frames+1'b1;
      if(queue_dropped)display_dropped<=display_dropped+1'b1;
      if(queue_error)display_errors<=display_errors+1'b1;
      if(line_error)line_errors<=line_errors+1'b1;
      if(pattern_active)begin
        if(pattern_timer==PATTERN_DIV-1)begin
          pattern_timer<=0;pattern_valid<=1;
          pattern_pixel<=(px>=W/2)?(180+((px+py+frame_id)%16)):(40+((px*7+py*3+frame_id)%32));
          if(px==W-1)begin px<=0;if(py==H-1)pattern_active<=0;else py<=py+1'b1;end
          else px<=px+1'b1;
        end else pattern_timer<=pattern_timer+1'b1;
      end
      case(state)
        WAITING:if(delay_count<(frame_id==0?START_DELAY:FRAME_DELAY))delay_count<=delay_count+1'b1;
          else if(!sw_sync[15] && (sw_sync[0] || (config_done && !cap_busy)))begin
            pattern_selected<=sw_sync[0];view_processed<=sw_sync[1];
            case(sw_sync[3:2])0:fine_gain<=16;1:fine_gain<=24;2:fine_gain<=32;3:fine_gain<=48;endcase
            case(sw_sync[5:4])0:coarse_gain<=16;1:coarse_gain<=20;2:coarse_gain<=24;3:coarse_gain<=32;endcase
            case(sw_sync[7:6])0:detail_limit<=16;1:detail_limit<=32;2:detail_limit<=64;3:detail_limit<=255;endcase
            display_rate<=sw_sync[9:8];
            if(display_rate!=sw_sync[9:8])display_phase<=0;
            show_frame<=(display_phase==0 || display_rate!=sw_sync[9:8]);
            frame_id<=frame_id+1'b1;got_frame<=0;state<=LAUNCH;
          end
        LAUNCH:if(pattern_selected)begin
            pattern_sof<=1;pattern_active<=1;pattern_timer<=0;px<=0;py<=0;state<=PATTERN;
          end else begin capture_start<=1;state<=ARM;end
        ARM:if(cap_busy)state<=CAMERA;
        CAMERA:begin
          if(cap_sof)got_frame<=1;
          if(cap_error)begin capture_errors<=capture_errors+1'b1;delay_count<=0;state<=WAITING;end
          else if(cap_done)begin
            if(got_frame)state<=DRAIN;
            else begin delay_count<=0;state<=WAITING;end
          end
        end
        PATTERN:if(!pattern_active)state<=DRAIN;
        DRAIN:begin end
        default:begin state<=WAITING;delay_count<=0;end
      endcase
      if(core_eof)begin
        processed_frames<=processed_frames+1'b1;last_latency_cycles<=latency_count+1'b1;
        processing_active<=0;delay_count<=0;state<=WAITING;
        if(!show_frame)display_skipped<=display_skipped+1'b1;
        if(display_phase==((1<<display_rate)-1))display_phase<=0;else display_phase<=display_phase+1'b1;
      end
      if(ingress_overflow || (processing_active && !core_eof && latency_count==PROCESS_TIMEOUT_CYCLES-1))begin
        if(ingress_overflow)input_overflows<=input_overflows+1'b1;
        else processing_errors<=processing_errors+1'b1;
        abort_frame<=1;processing_active<=0;pattern_active<=0;got_frame<=0;
        delay_count<=0;state<=WAITING;
      end
    end
  end
endmodule
```

## rtl/window3x3.sv

```systemverilog
`timescale 1ns/1ps
// One accepted sample per clock, with arbitrary bubbles between samples.
// frame_start may accompany the first sample. RAM contents are never reset.
module window3x3 #(parameter integer W=320,H=240,DATA_WIDTH=8)(
  input wire clk,rst,frame_start,in_valid,
  input wire[DATA_WIDTH-1:0]in_data,
  output reg out_valid,output reg[9*DATA_WIDTH-1:0]window_data,
  output reg[15:0]center_x,center_y
);
  localparam integer XW=(W<2)?1:$clog2(W),YW=(H<2)?1:$clog2(H);
  (* ram_style="block" *) reg[DATA_WIDTH-1:0]row0[0:W-1],row1[0:W-1],row2[0:W-1];
  reg[DATA_WIDTH-1:0]q0,q1,q2,pixel_pending;
  reg[DATA_WIDTH-1:0]t0,t1,m0,m1,b0,b1;
  reg[XW-1:0]x,px;reg[YW-1:0]y,py;
  reg[1:0]bank,pbank;reg active,pending;
  wire accept=in_valid && (active || frame_start) && !rst;
  wire[XW-1:0]write_x=frame_start?0:x;
  wire[1:0]write_bank=frame_start?0:bank;
  wire[DATA_WIDTH-1:0]top_value=(pbank==0)?q1:(pbank==1)?q2:q0;
  wire[DATA_WIDTH-1:0]mid_value=(pbank==0)?q2:(pbank==1)?q0:q1;
  always @(posedge clk)if(accept)begin
    q0<=row0[write_x];q1<=row1[write_x];q2<=row2[write_x];
    case(write_bank)
      0:row0[write_x]<=in_data;1:row1[write_x]<=in_data;2:row2[write_x]<=in_data;
    endcase
  end
  always @(posedge clk)begin
    if(rst)begin
      x<=0;y<=0;px<=0;py<=0;bank<=0;pbank<=0;active<=0;pending<=0;
      out_valid<=0;window_data<=0;center_x<=0;center_y<=0;pixel_pending<=0;
      t0<=0;t1<=0;m0<=0;m1<=0;b0<=0;b1<=0;
    end else if(frame_start)begin
      x<=in_valid?1:0;y<=0;bank<=0;active<=1;pending<=in_valid;
      px<=0;py<=0;pbank<=0;pixel_pending<=in_data;out_valid<=0;
      t0<=0;t1<=0;m0<=0;m1<=0;b0<=0;b1<=0;
    end else begin
      pending<=accept;out_valid<=0;
      if(accept)begin
        px<=x;py<=y;pbank<=bank;pixel_pending<=in_data;
        if(x==W-1)begin
          x<=0;bank<=(bank==2)?0:bank+1'b1;
          if(y==H-1)active<=0;else y<=y+1'b1;
        end else x<=x+1'b1;
      end
      if(pending)begin
        t0<=t1;t1<=top_value;m0<=m1;m1<=mid_value;b0<=b1;b1<=pixel_pending;
        if(px>=2 && py>=2)begin
          // Low byte/word is the top-left member, row-major thereafter.
          window_data<={pixel_pending,b1,b0,mid_value,m1,m0,top_value,t1,t0};
          center_x<=px-1'b1;center_y<=py-1'b1;out_valid<=1;
        end
      end
    end
  end
endmodule
```

## scripts/build.tcl

```tcl
set root [file normalize [file join [file dirname [info script]] ..]]
set out [file join $root build vivado]
file mkdir $out
create_project -in_memory -part xc7a35tcpg236-1
read_verilog -sv [glob [file join $root rtl *.sv]]
read_xdc [file join $root constraints basys3.xdc]
synth_design -top stream_top -part xc7a35tcpg236-1
report_utilization -file [file join $out utilization_synth.rpt]
opt_design
place_design
phys_opt_design
route_design
report_timing_summary -file [file join $out timing.rpt]
report_utilization -file [file join $out utilization.rpt]
report_drc -file [file join $out drc.rpt]
write_checkpoint -force [file join $out stream_top_routed.dcp]
set worst [get_timing_paths -delay_type max -max_paths 1]
if {[get_property SLACK $worst] < 0} {error "Setup timing failed; inspect timing.rpt before using hardware."}
set worst_hold [get_timing_paths -delay_type min -max_paths 1]
if {[get_property SLACK $worst_hold] < 0} {error "Hold timing failed; inspect timing.rpt."}
write_bitstream -force [file join $out stream_top.bit]
```

## scripts/check_delivery.py

```python
"""Check release hashes and the generated source listing; --refresh updates both.

Run after editing release files. Regression working directories are intentionally
excluded; copy evidence worth retaining into evidence/ before refreshing.
"""
import argparse
import hashlib
import json
from pathlib import Path
import sys

ROOT = Path(__file__).resolve().parents[1]
MANIFEST = 'SHA256.json'
LISTING = '完整代码.md'
SOURCE_DIRS = ('rtl', 'constraints', 'scripts', 'pc', 'sim')
IGNORED_DIRS = {'__pycache__', '.pytest_cache', 'regression', 'xsim.dir'}

def release_files(root):
    """Enumerate deliverables without Vivado scratch files or local test output."""
    files = []
    for folder in (*SOURCE_DIRS, 'docs', 'evidence', 'build'):
        for path in (root / folder).rglob('*'):
            relative = path.relative_to(root)
            if (not path.is_file() or path.suffix in {'.pyc', '.pyo'}
                    or any(part in IGNORED_DIRS for part in relative.parts)):
                continue
            if folder == 'build' and path.suffix not in {'.log', '.rpt', '.bit'}:
                continue
            files.append(path)
    files.extend(p for p in root.iterdir()
                 if p.is_file() and p.suffix in {'.md', '.json'} and p.name != MANIFEST)
    return sorted(files, key=lambda p: p.relative_to(root).as_posix())

def source_listing(root):
    lines = [
        '# 当前Demo完整代码', '',
        '由 `python scripts/check_delivery.py --refresh` 生成，逐文件对应当前源码。',
        '功能、运行方式与验证范围见 `README_先读我.md`；历史硬件记录见 `docs/`。', '',
    ]
    for path in release_files(root):
        relative = path.relative_to(root)
        if relative.parts[0] not in SOURCE_DIRS:
            continue
        if path.suffix not in {'.sv', '.xdc', '.tcl', '.py', '.txt'}:
            continue
        language = {'.sv': 'systemverilog', '.py': 'python', '.tcl': 'tcl',
                    '.xdc': 'tcl'}.get(path.suffix, 'text')
        lines.extend([f'## {relative.as_posix()}', '', f'```{language}',
                      path.read_text(encoding='utf-8').rstrip(), '```', ''])
    return '\n'.join(lines)

def hashes(root):
    return {p.relative_to(root).as_posix(): hashlib.sha256(p.read_bytes()).hexdigest()
            for p in release_files(root)}

def check(root):
    problems = []
    try:
        expected = json.loads((root / MANIFEST).read_text(encoding='utf-8'))
    except (OSError, ValueError) as exc:
        return [f'Cannot read {MANIFEST}: {exc}']
    actual = hashes(root)
    for name in sorted(set(expected) | set(actual)):
        if name not in actual:
            problems.append(f'Missing release file: {name}')
        elif name not in expected:
            problems.append(f'Unlisted release file: {name}')
        elif expected[name] != actual[name]:
            problems.append(f'Hash mismatch: {name}')
    listing = root / LISTING
    if not listing.is_file() or listing.read_text(encoding='utf-8') != source_listing(root):
        problems.append(f'{LISTING} is out of date')
    return problems

def main(argv=None):
    parser = argparse.ArgumentParser(description=__doc__)
    parser.add_argument('--refresh', action='store_true',
                        help='regenerate source listing and hashes after reviewing changes')
    args = parser.parse_args(argv)
    if args.refresh:
        (ROOT / LISTING).write_text(source_listing(ROOT), encoding='utf-8', newline='\n')
        (ROOT / MANIFEST).write_text(json.dumps(hashes(ROOT), ensure_ascii=False, indent=2)
                                     + '\n', encoding='utf-8', newline='\n')
    problems = check(ROOT)
    if problems:
        print('\n'.join(problems), file=sys.stderr)
        return 1
    print(f'PASS delivery: {len(hashes(ROOT))} file hashes and current source listing')
    return 0

if __name__ == '__main__':
    raise SystemExit(main())
```

## scripts/create_project.tcl

```tcl
# Run from Vivado Tcl console: source E:/UESTC/FPGA/stream_image_demo/scripts/create_project.tcl
set root [file normalize [file join [file dirname [info script]] ..]]
create_project stream_image_demo [file join $root vivado_project] -part xc7a35tcpg236-1 -force
add_files [glob [file join $root rtl *.sv]]
add_files -fileset constrs_1 [file join $root constraints basys3.xdc]
add_files -fileset sim_1 [glob [file join $root sim *.sv]]
set_property top stream_top [current_fileset]
set_property top tb_top [get_filesets sim_1]
update_compile_order -fileset sources_1
puts "Project ready. Run synthesis, implementation, then Generate Bitstream."
```

## scripts/run_tests.py

```python
"""Run RTL simulations and Python tests without replacing historical evidence.

Tool discovery: explicit --*-bin, environment, PATH, then common install paths.
Use --python-only to run the PC tests on a machine without an RTL simulator.
"""
import argparse
from datetime import datetime
import json
import os
from pathlib import Path
import re
import shutil
import subprocess
import sys

ROOT = Path(__file__).resolve().parents[1]
RTL_TESTS = ('fifo_capture', 'camera_config', 'camera_readback', 'camera_monitor',
             'image_core', 'target_stats', 'transport', 'target_transport',
             'output_transport', 'output_budget', 'top', 'top_target', 'top_output',
             'camera_retry', 'top_recovery', 'top_preview', 'enhance_core',
             'stream_buffers', 'vision_status', 'vision_top')
WIRE_STREAMS = {
    'target_transport': ('target_wire.bin', 6),
    'top_target': ('top_target_wire.bin', 4),
    'output_transport': ('output_wire.bin', 6),
    'top_output': ('top_output_wire.bin', 5),
    'top_recovery': ('top_recovery_wire.bin', 3),
    'top_preview': ('top_preview_wire.bin', 13),
    'vision_status': ('vision_status_wire.bin', 2),
}
ERROR_LINE = re.compile(r'^\s*(?:fatal|error)\s*(?::|\[)', re.I | re.M)
PASS_LINE = re.compile(r'^PASS(?:\b|_)', re.M)

class RegressionError(RuntimeError):
    """An actionable regression failure, shown without a Python traceback."""

def tool_names(name):
    suffixes = ('.bat', '.exe', '') if os.name == 'nt' else ('',)
    return tuple(name + suffix for suffix in suffixes)

def tools_in(directory, names):
    """Accept either an install root or its bin directory, as a complete set."""
    directory = Path(directory).expanduser()
    for candidate in (directory, directory / 'bin'):
        found = {}
        for name in names:
            path = next((candidate / filename for filename in tool_names(name)
                         if (candidate / filename).is_file()), None)
            if path is None:
                break
            found[name] = path.resolve()
        if len(found) == len(names):
            return found
    return None

def common_install_dirs(simulator):
    """Only inspect known install layouts; do not recursively scan user disks."""
    if os.name != 'nt':
        if simulator == 'vivado':
            for base in (Path('/opt/Xilinx/Vivado'), Path('/tools/Xilinx/Vivado')):
                yield from sorted(base.glob('*/bin'), reverse=True)
        return
    for drive in ('C:', 'D:', 'E:'):
        if simulator == 'vivado':
            for base in ('Xilinx/Vivado', 'AMD/Vivado', 'Vivado'):
                root = Path(drive + '/') / base
                yield from sorted(root.glob('*/bin'), reverse=True)
                yield from sorted(root.glob('*/Vivado/bin'), reverse=True)
            root = Path(drive + '/') / 'AMDDesignTools'
            yield from sorted(root.glob('*/Vivado/bin'), reverse=True)
        else:
            for base in ('iverilog/bin', 'Icarus Verilog/bin',
                         'Program Files/iverilog/bin'):
                yield Path(drive + '/') / base

def discover_tools(explicit, env_names, names, simulator):
    if explicit is not None:
        result = tools_in(explicit, names)
        if result is None:
            raise RegressionError(
                f'{simulator}: {explicit} must contain {", ".join(names)} '
                '(or a bin directory containing them).')
        return result
    for env_name in env_names:
        value = os.environ.get(env_name)
        if value:
            result = tools_in(value, names)
            if result:
                return result
    found = {}
    for name in names:
        path = next((p for filename in tool_names(name)
                     if (p := shutil.which(filename))), None)
        if path is None:
            break
        found[name] = Path(path).resolve()
    if len(found) == len(names):
        return found
    for directory in common_install_dirs(simulator):
        result = tools_in(directory, names)
        if result:
            return result
    return None

def discover_simulator(args):
    selected = args.simulator
    if args.vivado_bin is not None:
        selected = 'vivado'
    elif args.iverilog_bin is not None:
        selected = 'iverilog'
    if selected in ('auto', 'vivado'):
        found = discover_tools(args.vivado_bin,
                               ('VIVADO_BIN', 'XILINX_VIVADO', 'VIVADO_HOME'),
                               ('xvlog', 'xelab', 'xsim'), 'vivado')
        if found:
            return 'vivado', found
    if selected in ('auto', 'iverilog'):
        found = discover_tools(args.iverilog_bin, ('IVERILOG_BIN',),
                               ('iverilog', 'vvp'), 'iverilog')
        if found:
            return 'iverilog', found
    raise RegressionError(
        f'No complete {selected} RTL simulator found. Use --vivado-bin BIN '
        '(or XILINX_VIVADO/VIVADO_BIN), --iverilog-bin BIN '
        '(or IVERILOG_BIN), or put the tools on PATH. '
        'Use --python-only to run the PC tests without RTL simulation.')

def run(command, cwd, log, timeout):
    command = [str(c) for c in command]
    try:
        result = subprocess.run(command, cwd=cwd, stdout=subprocess.PIPE,
                                stderr=subprocess.STDOUT, encoding='utf-8',
                                errors='replace', timeout=timeout)
    except subprocess.TimeoutExpired as exc:
        output = exc.stdout or ''
        if isinstance(output, bytes):
            output = output.decode('utf-8', errors='replace')
        log.write_text(output + f'\nTIMEOUT after {timeout:g} seconds\n',
                       encoding='utf-8')
        raise RegressionError(f'Timeout after {timeout:g} seconds; see {log}') from exc
    except OSError as exc:
        log.write_text(str(exc) + '\n', encoding='utf-8')
        raise RegressionError(f'Could not start {command[0]}: {exc}; see {log}') from exc
    log.write_text(result.stdout, encoding='utf-8')
    # Some simulators report $fatal/$error but return exit status zero.
    if result.returncode or ERROR_LINE.search(result.stdout):
        # Keep the full UTF-8 log even when a legacy Windows console cannot
        # print a tool's Unicode diagnostics. Reporting must not mask failure.
        printable = result.stdout
        encoding = getattr(sys.stdout, 'encoding', None)
        if encoding:
            printable = printable.encode(encoding, errors='backslashreplace').decode(encoding)
        print(printable, end='' if printable.endswith('\n') else '\n')
        raise RegressionError(f'Command failed (exit {result.returncode}); see {log}')
    return result.stdout

def run_python_tests(output, timeout):
    for directory, pattern, logfile in (
            ('pc', 'test_*.py', 'python_tests.log'),
            ('scripts', 'test_*.py', 'runner_tests.log')):
        run([sys.executable, '-B', '-m', 'unittest', 'discover',
             '-s', ROOT / directory, '-p', pattern, '-v'],
            ROOT, output / logfile, timeout)
    print('PASS Python receiver and regression-runner unittest suites', flush=True)

def run_rtl(name, simulator, tools, output, timeout):
    dest = output / ('verify_' + name)
    dest.mkdir()
    sources = sorted((ROOT / 'rtl').glob('*.sv')) + [ROOT / 'sim' / f'tb_{name}.sv']
    if simulator == 'vivado':
        run([tools['xvlog'], '-sv', *sources], dest, dest / 'compile.log', timeout)
        run([tools['xelab'], f'tb_{name}', '-s', 'test'],
            dest, dest / 'elaborate.log', timeout)
        command = [tools['xsim'], 'test', '-runall']
    else:
        image = dest / 'test.vvp'
        run([tools['iverilog'], '-g2012', '-s', f'tb_{name}',
             '-o', image, *sources], dest, dest / 'compile.log', timeout)
        command = [tools['vvp'], image]
    result = run(command, dest, dest / 'simulate.log', timeout)
    if not PASS_LINE.search(result):
        raise RegressionError(f'Missing PASS marker; see {dest / "simulate.log"}')
    print(next(line for line in result.splitlines() if PASS_LINE.match(line)), flush=True)
    return dest

def existing_wire():
    candidates = sorted((ROOT / 'build' / 'regression').glob('*/verify_transport/wire.bin'),
                        reverse=True)
    candidates.append(ROOT / 'build' / 'verify_transport' / 'wire.bin')
    return next((path for path in candidates if path.is_file()), None)

def arguments(argv):
    parser = argparse.ArgumentParser(description=__doc__)
    parser.add_argument('--python-only', action='store_true',
                        help='run Python suites and any available wire cross-check; skip RTL')
    parser.add_argument('--simulator', choices=('auto', 'vivado', 'iverilog'), default='auto')
    parser.add_argument('--vivado-bin', type=Path, help='Vivado installation root or bin directory')
    parser.add_argument('--iverilog-bin', type=Path, help='Icarus installation root or bin directory')
    parser.add_argument('--output-dir', type=Path,
                        help='new output directory (default: build/regression/TIMESTAMP)')
    parser.add_argument('--wire', type=Path,
                        help='existing wire stream to check (default: this run or latest saved wire.bin)')
    parser.add_argument('--wire-count', type=int, default=2,
                        help='number of valid frames required from wire stream (default: 2)')
    parser.add_argument('--tests', nargs='+', choices=RTL_TESTS, default=RTL_TESTS,
                        help=f'RTL testbenches to run (default: all {len(RTL_TESTS)})')
    parser.add_argument('--timeout', type=float, default=180,
                        help='per-command timeout in seconds (default: 180)')
    args = parser.parse_args(argv)
    if args.timeout <= 0 or args.wire_count <= 0:
        parser.error('--timeout and --wire-count must be positive')
    if args.vivado_bin is not None and args.iverilog_bin is not None:
        parser.error('choose only one of --vivado-bin and --iverilog-bin')
    if args.vivado_bin is not None and args.simulator == 'iverilog':
        parser.error('--vivado-bin conflicts with --simulator iverilog')
    if args.iverilog_bin is not None and args.simulator == 'vivado':
        parser.error('--iverilog-bin conflicts with --simulator vivado')
    return args

def main(argv=None):
    args = arguments(argv)
    if args.wire is not None and not args.wire.is_file():
        print(f'FAIL: Requested wire stream does not exist: {args.wire}', file=sys.stderr)
        return 1
    output = (args.output_dir or ROOT / 'build' / 'regression' /
              datetime.now().strftime('%Y%m%d_%H%M%S_%f')).resolve()
    try:
        output.mkdir(parents=True, exist_ok=False)
    except OSError as exc:
        print(f'FAIL: Need a new writable output directory: {output}: {exc}', file=sys.stderr)
        return 1
    print(f'Output: {output}', flush=True)
    summary = {'status': 'running', 'output': str(output),
               'python': {'status': 'running'}, 'rtl': {'status': 'pending'},
               'wire': {'status': 'pending'}, 'feature_wires': []}
    wire = args.wire.resolve() if args.wire is not None else None
    try:
        run_python_tests(output, args.timeout)
        summary['python'] = {'status': 'passed'}
        if args.python_only:
            summary['rtl'] = {'status': 'skipped', 'reason': '--python-only'}
            print('SKIP RTL simulation (--python-only)', flush=True)
        else:
            summary['rtl'] = {'status': 'running'}
            simulator, tools = discover_simulator(args)
            summary['rtl'] = {'status': 'running', 'simulator': simulator,
                              'tools': {k: str(v) for k, v in tools.items()}, 'tests': []}
            print(f'RTL simulator: {simulator}', flush=True)
            for name in dict.fromkeys(args.tests):
                dest = run_rtl(name, simulator, tools, output, args.timeout)
                summary['rtl']['tests'].append(name)
                if name in ('enhance_core', 'vision_top'):
                    script = 'verify_enhance.py' if name == 'enhance_core' else 'verify_vision_display.py'
                    inputs = (('enhance_small.txt', 'enhance_qvga.txt') if name == 'enhance_core'
                              else ('vision_camera.txt', 'vision_scale1.txt', 'vision_scale4.txt'))
                    run([sys.executable, '-B', ROOT / 'scripts' / script, '--input',
                         *(dest / filename for filename in inputs),
                         '--out', dest / 'golden.json'], ROOT, dest / 'golden.log', args.timeout)
                    print((dest / 'golden.log').read_text(encoding='utf-8').strip(), flush=True)
                if name == 'transport' and wire is None:
                    wire = dest / 'wire.bin'
                    if not wire.is_file():
                        raise RegressionError(f'tb_transport did not create {wire}')
                if name in WIRE_STREAMS:
                    filename, count = WIRE_STREAMS[name]
                    feature_wire = dest / filename
                    if not feature_wire.is_file():
                        raise RegressionError(f'tb_{name} did not create {feature_wire}')
                    summary['feature_wires'].append({
                        'status': 'pending', 'name': name, 'input': str(feature_wire),
                        'required_frames': count,
                        'decoder': 'vision_status.py' if name == 'vision_status' else 'receiver.py'})
            summary['rtl']['status'] = 'passed'
        wire = wire or existing_wire()
        if wire is None:
            summary['wire'] = {'status': 'skipped', 'reason': 'No recorded wire.bin is available'}
            print('SKIP wire cross-check: no wire.bin available; use --wire PATH or run transport RTL.',
                  flush=True)
        else:
            summary['wire'] = {'status': 'running', 'input': str(wire),
                               'required_frames': args.wire_count}
            run([sys.executable, '-B', ROOT / 'pc' / 'receiver.py', '--input', wire,
                 '--out', output / 'verified_frames', '--count', args.wire_count],
                ROOT, output / 'wire_crosscheck.log', args.timeout)
            summary['wire']['status'] = 'passed'
            print(f'PASS receiver wire-stream cross-check ({args.wire_count} frames): {wire}',
                  flush=True)
        for feature in summary['feature_wires']:
            feature['status'] = 'running'
            run([sys.executable, '-B', ROOT / 'pc' / feature['decoder'], '--input', feature['input'],
                 '--out', output / ('verified_' + feature['name']),
                 '--count', feature['required_frames']],
                ROOT, output / (feature['name'] + '_crosscheck.log'), args.timeout)
            feature['status'] = 'passed'
            print(f'PASS protocol wire-stream cross-check: {feature["name"]}', flush=True)
        summary['status'] = 'passed'
        print('PASS requested regression checks; see summary.json for passes and skips.', flush=True)
        return 0
    except (RegressionError, OSError) as exc:
        summary['status'] = 'failed'
        summary['error'] = str(exc)
        for section in ('python', 'rtl', 'wire'):
            if summary[section]['status'] == 'running':
                summary[section]['status'] = 'failed'
        for feature in summary['feature_wires']:
            if feature['status'] == 'running':
                feature['status'] = 'failed'
        print(f'FAIL: {exc}', file=sys.stderr)
        return 1
    finally:
        (output / 'summary.json').write_text(
            json.dumps(summary, indent=2, ensure_ascii=False) + '\n', encoding='utf-8')

if __name__ == '__main__':
    sys.exit(main())
```

## scripts/synth_vision.tcl

```tcl
# OOC synthesis/resource check only. This does not generate a board bitstream.
# Run in a fresh Vivado Tcl session. Optional limits may be set before source.
set root [file normalize [file join [file dirname [info script]] ..]]
if {![info exists vision_bram_limit]} {set vision_bram_limit 45}
if {![info exists vision_dsp_limit]} {set vision_dsp_limit 72}
if {![info exists vision_lut_limit]} {set vision_lut_limit 18000}
if {$vision_bram_limit <= 0 || $vision_bram_limit > 50 ||
    $vision_dsp_limit <= 0 || $vision_dsp_limit > 90 ||
    $vision_lut_limit <= 0 || $vision_lut_limit > 20800} {
    error "Invalid vision resource budget for XC7A35T."
}
if {[info exists ::env(VISION_BUILD_DIR)]} {
    set out [file normalize $::env(VISION_BUILD_DIR)]
} else {
    set out [file join $root build vision_ooc]
}
file mkdir $out
create_project -in_memory -part xc7a35tcpg236-1
read_verilog -sv [glob [file join $root rtl *.sv]]
read_xdc [file join $root constraints vision_ooc.xdc]
synth_design -top vision_top -mode out_of_context -part xc7a35tcpg236-1
report_utilization -file [file join $out utilization_synth.rpt]
report_timing_summary -file [file join $out timing_synth_estimate.rpt]
set bram36 [llength [get_cells -hierarchical -filter {REF_NAME =~ RAMB36*}]]
set bram18 [llength [get_cells -hierarchical -filter {REF_NAME =~ RAMB18*}]]
set dsp [llength [get_cells -hierarchical -filter {REF_NAME =~ DSP48*}]]
set lut [llength [get_cells -hierarchical -filter {REF_NAME =~ LUT*}]]
set bram_equivalent [expr {$bram36 + $bram18 / 2.0}]
if {$bram_equivalent > $vision_bram_limit || $dsp > $vision_dsp_limit || $lut > $vision_lut_limit} {
    error "Vision core exceeds budget: BRAM36eq=$bram_equivalent DSP=$dsp LUT=$lut. Inspect utilization_synth.rpt."
}
write_checkpoint -force [file join $out vision_top_synth.dcp]
puts "PASS vision synthesis budget: BRAM36eq=$bram_equivalent DSP=$dsp LUT=$lut"
puts "OOC synthesis only; final display adapter, board I/O constraints, routing and timing are still required."
```

## scripts/test_run_tests.py

```python
"""Regression-runner checks using temporary tools and output directories."""
import contextlib
import binascii
import io
import json
from pathlib import Path
import struct
import subprocess
import tempfile
import unittest
from unittest import mock

import run_tests

class RunnerTests(unittest.TestCase):
    def setUp(self):
        self.directory = tempfile.TemporaryDirectory()
        self.addCleanup(self.directory.cleanup)
        self.root = Path(self.directory.name)

    def fake_tools(self, names, directory=None):
        directory = directory or self.root / 'tool installation with spaces' / 'bin'
        directory.mkdir(parents=True)
        for name in names:
            (directory / run_tests.tool_names(name)[0]).write_text('', encoding='utf-8')
        return directory

    def test_explicit_install_root_and_environment_discovery(self):
        names = ('xvlog', 'xelab', 'xsim')
        directory = self.fake_tools(names)
        tools = run_tests.discover_tools(directory.parent, (), names, 'vivado')
        self.assertEqual(tools['xsim'].parent, directory.resolve())
        with mock.patch.dict(run_tests.os.environ, {'XILINX_VIVADO': str(directory.parent)}, clear=True):
            tools = run_tests.discover_tools(None, ('XILINX_VIVADO',), names, 'vivado')
        self.assertEqual(tools['xvlog'].parent, directory.resolve())

    def test_incomplete_explicit_install_fails_without_fallback(self):
        directory = self.fake_tools(('xvlog',))
        with self.assertRaisesRegex(run_tests.RegressionError, 'must contain xvlog, xelab, xsim'):
            run_tests.discover_tools(directory, (), ('xvlog', 'xelab', 'xsim'), 'vivado')

    def test_icarus_path_discovery_requires_both_tools(self):
        directory = self.fake_tools(('iverilog', 'vvp'))
        with mock.patch.object(run_tests.shutil, 'which',
                               side_effect=lambda name: str(directory / name)
                               if (directory / name).is_file() else None):
            found = run_tests.discover_tools(None, (), ('iverilog', 'vvp'), 'iverilog')
        self.assertEqual(set(found), {'iverilog', 'vvp'})

    def test_zero_exit_fatal_and_error_are_failures(self):
        for output in ('FATAL: tb.sv:4: timeout\n', 'Fatal: bad frame\n',
                       'ERROR: [XSIM 1] failed\n'):
            with self.subTest(output=output), mock.patch.object(
                    run_tests.subprocess, 'run', return_value=subprocess.CompletedProcess([], 0, output)):
                with contextlib.redirect_stdout(io.StringIO()):
                    with self.assertRaises(run_tests.RegressionError):
                        run_tests.run(['simulator'], self.root, self.root / 'sim.log', 1)
            self.assertEqual((self.root / 'sim.log').read_text(encoding='utf-8'), output)

    def test_error_handling_pass_text_is_not_a_failure(self):
        output = 'PASS camera_config NACK/error handling; 0 errors\n'
        with mock.patch.object(run_tests.subprocess, 'run',
                               return_value=subprocess.CompletedProcess([], 0, output)):
            self.assertEqual(run_tests.run(['simulator'], self.root, self.root / 'sim.log', 1), output)

    def test_unicode_tool_failure_keeps_log_and_failed_summary_on_legacy_console(self):
        output = self.root / 'unicode results'
        message = 'ERROR: tool diagnostic \ufffd\U0001f4f7\n'
        console_bytes = io.BytesIO()
        console = io.TextIOWrapper(console_bytes, encoding='gbk', errors='strict')
        def fail_python_tests(dest, timeout):
            run_tests.run(['simulator'], self.root, dest / 'python_tests.log', timeout)
        with mock.patch.object(run_tests, 'run_python_tests', side_effect=fail_python_tests), \
                mock.patch.object(run_tests.subprocess, 'run',
                                  return_value=subprocess.CompletedProcess([], 1, message)), \
                contextlib.redirect_stdout(console), contextlib.redirect_stderr(io.StringIO()):
            result = run_tests.main(['--python-only', '--output-dir', str(output)])
        console.flush()
        self.assertEqual(result, 1)
        summary = json.loads((output / 'summary.json').read_text(encoding='utf-8'))
        self.assertEqual(summary['status'], 'failed')
        self.assertEqual(summary['python']['status'], 'failed')
        self.assertEqual((output / 'python_tests.log').read_text(encoding='utf-8'), message)
        self.assertIn(b'\\ufffd\\U0001f4f7', console_bytes.getvalue())
        console.close()

    def test_timeout_retains_partial_output(self):
        with mock.patch.object(run_tests.subprocess, 'run',
                               side_effect=subprocess.TimeoutExpired(['simulator'], 1, b'partial output')):
            with self.assertRaisesRegex(run_tests.RegressionError, 'Timeout'):
                run_tests.run(['simulator'], self.root, self.root / 'sim.log', 1)
        self.assertIn('partial output', (self.root / 'sim.log').read_text(encoding='utf-8'))

    def test_python_only_without_wire_passes_and_reports_skips(self):
        output = self.root / 'new results'
        with mock.patch.object(run_tests, 'run_python_tests') as python_tests, \
                mock.patch.object(run_tests, 'existing_wire', return_value=None), \
                mock.patch.object(run_tests, 'discover_simulator') as discover, \
                contextlib.redirect_stdout(io.StringIO()) as stdout:
            result = run_tests.main(['--python-only', '--output-dir', str(output)])
        self.assertEqual(result, 0)
        python_tests.assert_called_once()
        discover.assert_not_called()
        summary = json.loads((output / 'summary.json').read_text(encoding='utf-8'))
        self.assertEqual(summary['python']['status'], 'passed')
        self.assertEqual(summary['rtl']['status'], 'skipped')
        self.assertEqual(summary['wire']['status'], 'skipped')
        self.assertIn('SKIP wire cross-check', stdout.getvalue())

    def test_explicit_missing_wire_fails_before_running_tests(self):
        with mock.patch.object(run_tests, 'run_python_tests') as python_tests, \
                contextlib.redirect_stderr(io.StringIO()) as stderr:
            result = run_tests.main(['--python-only', '--wire', str(self.root / 'missing.bin')])
        self.assertEqual(result, 1)
        python_tests.assert_not_called()
        self.assertIn('Requested wire stream does not exist', stderr.getvalue())

    def test_explicit_wire_is_really_decoded(self):
        output = self.root / 'results'
        wire = self.root / 'wire.bin'
        wire.write_bytes(b'not a real packet')
        # Keep receiver.py as a real subprocess: success must depend on valid frames.
        with mock.patch.object(run_tests, 'run_python_tests'), \
                contextlib.redirect_stdout(io.StringIO()), contextlib.redirect_stderr(io.StringIO()):
            result = run_tests.main(['--python-only', '--wire', str(wire), '--output-dir', str(output)])
        self.assertEqual(result, 1)
        summary = json.loads((output / 'summary.json').read_text(encoding='utf-8'))
        self.assertEqual(summary['wire']['status'], 'failed')
        self.assertIn('requested frame count', (output / 'wire_crosscheck.log').read_text(encoding='utf-8'))

    def test_valid_explicit_wire_writes_two_decoded_frames(self):
        output = self.root / 'valid results'
        wire = self.root / 'wire.bin'
        packets = []
        for frame_id in (7, 8):
            header = struct.pack('<4sBBHHHIIIII', b'FPG1', 1, 0, 4, 2,
                                 180, frame_id, 8, 0, 0, 0)
            body = header[4:] + b'abcdefgh'
            packets.append(header + b'abcdefgh' +
                           struct.pack('<H', binascii.crc_hqx(body, 0xffff)))
        wire.write_bytes(b''.join(packets))
        with mock.patch.object(run_tests, 'run_python_tests'), \
                contextlib.redirect_stdout(io.StringIO()):
            result = run_tests.main(['--python-only', '--wire', str(wire), '--output-dir', str(output)])
        self.assertEqual(result, 0)
        summary = json.loads((output / 'summary.json').read_text(encoding='utf-8'))
        self.assertEqual(summary['wire']['status'], 'passed')
        self.assertEqual(len(list((output / 'verified_frames').glob('*.pgm'))), 2)

    def test_output_must_be_new_to_preserve_existing_evidence(self):
        evidence = self.root / 'python_tests.log'
        evidence.write_text('historical evidence', encoding='utf-8')
        with contextlib.redirect_stderr(io.StringIO()):
            result = run_tests.main(['--python-only', '--output-dir', str(self.root)])
        self.assertEqual(result, 1)
        self.assertEqual(evidence.read_text(encoding='utf-8'), 'historical evidence')

    def test_default_output_goes_under_regression_without_touching_old_logs(self):
        historical = self.root / 'build' / 'python_tests.log'
        historical.parent.mkdir()
        historical.write_text('previous run', encoding='utf-8')
        with mock.patch.object(run_tests, 'ROOT', self.root), \
                mock.patch.object(run_tests, 'run_python_tests'), \
                contextlib.redirect_stdout(io.StringIO()):
            self.assertEqual(run_tests.main(['--python-only']), 0)
        summaries = list((self.root / 'build' / 'regression').glob('*/summary.json'))
        self.assertEqual(len(summaries), 1)
        self.assertEqual(historical.read_text(encoding='utf-8'), 'previous run')

if __name__ == '__main__':
    unittest.main()
```

## scripts/test_vision_build.py

```python
"""Tcl syntax/guard dry runs with mocked Vivado commands, never synthesis."""
from pathlib import Path
import tempfile
import unittest
try:
    import tkinter
except ImportError:
    tkinter = None

@unittest.skipIf(tkinter is None, 'Tcl interpreter is unavailable')
class VisionBuildTests(unittest.TestCase):
    def dry_run(self, bram36=40, bram18=6, dsp=24, lut=8000, bram_limit=45):
        interpreter = tkinter.Tcl()
        calls = []
        script = Path(__file__).with_name('synth_vision.tcl')
        def record(name):
            def callback(*args):
                calls.append((name, args))
                return ''
            return callback
        for name in ('create_project', 'read_verilog', 'synth_design', 'report_utilization',
                     'report_timing_summary', 'write_checkpoint', 'create_clock', 'set_false_path', 'puts'):
            interpreter.createcommand(name, record(name))
        interpreter.createcommand('get_ports', lambda *args: args[-1])
        def read_xdc(path):
            calls.append(('read_xdc', (path,)))
            interpreter.call('source', path)
            return ''
        interpreter.createcommand('read_xdc', read_xdc)
        def cells(*args):
            expression = args[-1]
            count = bram36 if 'RAMB36' in expression else bram18 if 'RAMB18' in expression else dsp if 'DSP48' in expression else lut
            return tuple(f'cell_{index}' for index in range(count))
        interpreter.createcommand('get_cells', cells)
        with tempfile.TemporaryDirectory() as d:
            interpreter.setvar('env(VISION_BUILD_DIR)', d)
            interpreter.setvar('vision_bram_limit', bram_limit)
            error = None
            try:
                interpreter.call('source', str(script.resolve()))
            except tkinter.TclError as exc:
                error = str(exc)
        return calls, error

    def test_ooc_synthesis_and_clock_constraints_pass_under_budget(self):
        calls, error = self.dry_run()
        self.assertIsNone(error)
        synth = next(args for name, args in calls if name == 'synth_design')
        self.assertIn('vision_top', synth)
        self.assertIn('out_of_context', synth)
        self.assertTrue(any(name == 'create_clock' for name, _ in calls))
        self.assertTrue(any(name == 'write_checkpoint' for name, _ in calls))

    def test_half_block_resource_overflow_stops_before_checkpoint(self):
        calls, error = self.dry_run(bram36=44, bram18=3)
        self.assertIn('exceeds budget', error)
        self.assertFalse(any(name == 'write_checkpoint' for name, _ in calls))

    def test_budget_cannot_exceed_board_capacity(self):
        calls, error = self.dry_run(bram_limit=51)
        self.assertIn('Invalid vision resource budget', error)
        self.assertFalse(any(name == 'synth_design' for name, _ in calls))

if __name__ == '__main__':
    unittest.main()
```

## scripts/verify_enhance.py

```python
"""Compare every emitted RTL pixel with an independent integer image model."""
import argparse
import hashlib
import json
from pathlib import Path
import sys

sys.path.insert(0, str(Path(__file__).resolve().parents[1] / 'pc'))
from enhancement_reference import enhance, fixture_controls, fixture_pixel

def verify(path):
    with path.open(encoding='ascii') as handle:
        width, height, frames = map(int, handle.readline().split())
        checked = 0
        minima, maxima = 255, 0
        for frame in range(frames):
            source = [[fixture_pixel(frame, x, y, width) for x in range(width)]
                      for y in range(height)]
            expected = enhance(source, *fixture_controls(frame))
            for y, row in enumerate(expected, 2):
                for x, pixels in enumerate(row, 2):
                    line = handle.readline()
                    actual = tuple(map(int, line.split()))
                    reference = (frame, x, y, *pixels,
                                 int(x == 2 and y == 2), int(x == width - 3),
                                 int(x == width - 3 and y == height - 3))
                    if actual != reference:
                        raise ValueError(f'{path}: pixel {checked}: {actual} != {reference}')
                    minima = min(minima, pixels[-1]); maxima = max(maxima, pixels[-1])
                    checked += 1
        if handle.read().strip():
            raise ValueError(f'{path}: extra RTL output')
    return dict(input=path.name, width=width, height=height, frames=frames,
                checked_pixels=checked, minimum=minima, maximum=maxima,
                sha256=hashlib.sha256(path.read_bytes()).hexdigest(), status='passed')

def main():
    parser = argparse.ArgumentParser(description=__doc__)
    parser.add_argument('--input', nargs='+', type=Path, required=True)
    parser.add_argument('--out', type=Path, required=True)
    args = parser.parse_args()
    reports = [verify(path) for path in args.input]
    args.out.write_text(json.dumps(reports, indent=2) + '\n', encoding='utf-8')
    print(f'PASS enhancement golden model: {sum(r["checked_pixels"] for r in reports)} pixels')

if __name__ == '__main__':
    main()
```

## scripts/verify_vision_display.py

```python
"""Check standalone display pixels against the independent enhancement model."""
import argparse
import json
from pathlib import Path
import sys
sys.path.insert(0, str(Path(__file__).resolve().parents[1] / 'pc'))
from enhancement_reference import enhance

def verify(path):
    rows = path.read_text(encoding='ascii').splitlines()
    width, height, scale = map(int, rows[0].split())
    groups = {}
    for line in rows[1:]:
        frame, processed, x, y, pixel = map(int, line.split())
        groups.setdefault((frame, processed), []).append((x, y, pixel))
    checked = 0
    for (frame, processed), pixels in groups.items():
        # Camera case frame 6 is driven through physical SCCB/FIFO pins.
        source = [[((x * 19 + y * 23 + frame * 11) % 256) if frame == 6
                   else ((180 + (x + y + frame) % 16) if x >= width // 2
                         else (40 + (x * 7 + y * 3 + frame) % 32))
                   for x in range(width)] for y in range(height)]
        output = enhance(source, 24, 16, 32)
        expected = [(x + 2, y + 2, output[y][x][3 if processed else 0])
                    for y in range(0, height - 4, scale)
                    for x in range(0, width - 4, scale)]
        if pixels != expected:
            raise ValueError(f'{path}: frame {frame} display mismatch: {pixels} != {expected}')
        checked += len(pixels)
    expected_ids = [1, 2, 4, 6] if path.name == 'vision_camera.txt' else [1, 2, 3]
    if [f for f, _ in groups] != expected_ids:
        raise ValueError(f'{path}: missing/extra display frame')
    return dict(input=path.name, width=width, height=height, scale=scale,
                frames=expected_ids, checked_pixels=checked, status='passed')

def main():
    parser = argparse.ArgumentParser(description=__doc__)
    parser.add_argument('--input', nargs='+', type=Path, required=True)
    parser.add_argument('--out', type=Path, required=True)
    args = parser.parse_args()
    reports = [verify(p) for p in args.input]
    args.out.write_text(json.dumps(reports, indent=2) + '\n', encoding='utf-8')
    print(f'PASS standalone display golden model: {sum(r["checked_pixels"] for r in reports)} pixels')

if __name__ == '__main__':
    main()
```

## sim/tb_camera_config.sv

```systemverilog
`timescale 1ns/1ps
module tb_camera_config;
  reg clk=0;always #5 clk=~clk;
  reg rst=1;
  tri1 scl,sda;
  wire done,error;
  // SCCB write sink: ACK the ninth bit, decode all three-byte transactions.
  reg ack=0,ack_enable=1;assign sda=(ack && ack_enable)?1'b0:1'bz;
  reg active=0;
  integer bits=0, bytes=0,transactions=0,bus_edges=0;
  reg[7:0] shift=0;
  camera_config #(.QUARTER_CYCLES(2),.POWER_WAIT(10),.REG_WAIT(8)) dut(clk,rst,scl,sda,done,error);
  always @(scl or sda)bus_edges=bus_edges+1;
  always @(negedge sda) if(scl===1'b1) begin active=1;bits=0;bytes=0;end
  always @(posedge sda) if(scl===1'b1 && active) begin
    if(bytes!=3) $fatal(1,"bad transaction bytes=%0d",bytes);
    transactions=transactions+1;active=0;
  end
  always @(posedge scl) if(active) begin
    if(bits<8) begin
      shift={shift[6:0],sda};bits=bits+1;
      if(bits==8)begin
        if(bytes==0 && shift!=8'h42)$fatal(1,"wrong SCCB address");
        if(transactions==0 && bytes==1 && shift!=8'h12)$fatal(1,"reset register");
        if(transactions==0 && bytes==2 && shift!=8'h80)$fatal(1,"reset value");
        if(transactions==18 && bytes==2 && shift!=8'h0c)$fatal(1,"UYVY requires TSLB bit 3 = 1");
        bytes=bytes+1;
      end
    end else bits=0;
  end
  always @(negedge scl) if(active) ack=(bits==8);else ack=0;
  task reset_sink(input integer enable_ack);
    begin
      @(negedge clk);rst=1;active=0;ack=0;ack_enable=enable_ack;
      transactions=0;bits=0;bytes=0;
      repeat(5)@(negedge clk);rst=0;
    end
  endtask
  integer failed_edges;
  initial begin
    repeat(5)@(negedge clk);rst=0;
    wait(done);if(error || transactions!=39)$fatal(1,"config incomplete");
    $display("PASS camera_config %0d transactions",transactions);
    reset_sink(0);
    wait(error);#1;
    if(done || scl!==1'b1 || sda!==1'b1 || active || transactions!=1)
      $fatal(1,"NACK error must be published only after complete STOP and bus release");
    failed_edges=bus_edges;
    repeat(250)@(negedge clk);
    if(done || !error || scl!==1'b1 || sda!==1'b1 || transactions!=1 || bus_edges!=failed_edges)
      $fatal(1,"NACK must keep bus released and remain failed until reset");
    $display("PASS camera_config NACK completes STOP before error and leaves bus idle");
    reset_sink(1);
    if(error || done)$fatal(1,"reset must clear failed configuration status");
    wait(done);#1;
    if(error || transactions!=39 || scl!==1'b1 || sda!==1'b1)
      $fatal(1,"configuration must restart all 39 registers after NACK reset");
    $display("PASS camera_config reset after NACK restores complete 39-register configuration");
    $finish;
  end
  initial begin #2000000;$fatal(1,"timeout");end
endmodule
```

## sim/tb_camera_monitor.sv

```systemverilog
`timescale 1ns/1ps
module tb_camera_monitor;
  reg clk=0;always #5 clk=~clk;
  reg rst=1,enabled=0,vs=1,href=0,wen=0;
  wire vs_seen,href_seen,wen_seen,overlap_seen;
  wire[15:0]lines,high_lines,low_lines;
  wire href_vs_high,href_vs_low;
  camera_monitor dut(clk,rst,enabled,vs,href,wen,vs_seen,href_seen,wen_seen,overlap_seen,lines,href_vs_high,href_vs_low,high_lines,low_lines);
  task hold_cycles(input integer n);repeat(n)@(negedge clk);endtask
  task line_pulse;begin href=1;hold_cycles(8);href=0;hold_cycles(8);end endtask
  initial begin
    hold_cycles(5);rst=0;hold_cycles(5);
    // Initialization activity must not count as a successful capture.
    vs=0;line_pulse();wen=1;hold_cycles(6);wen=0;hold_cycles(5);
    if(vs_seen||href_seen||wen_seen||overlap_seen||lines)$fatal(1,"disabled monitor latched events");
    enabled=1;hold_cycles(5);vs=1;hold_cycles(5);line_pulse();
    if(!vs_seen||!href_seen||wen_seen||overlap_seen)$fatal(1,"independent sensor activity");
    if(!href_vs_high || href_vs_low)$fatal(1,"HREF high-VSYNC observation");
    vs=0;hold_cycles(5);line_pulse();
    if(!href_vs_low)$fatal(1,"HREF low-VSYNC observation");
    wen=1;hold_cycles(5);repeat(240)line_pulse();wen=0;hold_cycles(5);
    if(lines!=240 || !wen_seen || !overlap_seen)$fatal(1,"capture must count 240 lines, got %0d",lines);
    line_pulse();if(lines!=240)$fatal(1,"idle HREF corrupted last capture count");
    wen=1;hold_cycles(10);wen=0;hold_cycles(5);
    if(lines!=0)$fatal(1,"zero-line capture not reported");
    // Account for the two-flop HREF synchronizer: WEN rises on the same
    // observation cycle as the first synchronized HREF rising edge.
    href=1;hold_cycles(2);
    if(dut.href_sync[1]!==1'b1 || dut.href_prev!==1'b0 || dut.wen_prev!==1'b0)
      $fatal(1,"coincident-edge test stimulus is not aligned");
    wen=1;hold_cycles(6);
    href=0;hold_cycles(8);wen=0;hold_cycles(5);
    if(lines!=1)$fatal(1,"first line lost when WEN and HREF rise together: %0d",lines);
    // Starting during an existing HREF high level must not invent an edge.
    href=1;hold_cycles(5);wen=1;hold_cycles(5);
    href=0;hold_cycles(8);wen=0;hold_cycles(5);
    if(lines!=0)$fatal(1,"existing HREF level counted as a new line: %0d",lines);
    // Start clean phase boundaries, then test both polarity arrangements.
    vs=1;hold_cycles(5);vs=0;hold_cycles(5);vs=1;hold_cycles(5);
    repeat(240)line_pulse();vs=0;hold_cycles(5);
    if(high_lines!=240)$fatal(1,"high VSYNC phase lines %0d",high_lines);
    repeat(3)line_pulse();vs=1;hold_cycles(5);
    if(low_lines!=3)$fatal(1,"low VSYNC phase lines %0d",low_lines);
    // Reversed arrangement: no lines high, 240 lines low.
    vs=0;hold_cycles(5);if(high_lines!=0)$fatal(1,"high phase stale count");
    repeat(240)line_pulse();vs=1;hold_cycles(5);
    if(low_lines!=240)$fatal(1,"reverse phase count");
    rst=1;hold_cycles(5);
    if(vs_seen||href_seen||wen_seen||overlap_seen||lines||href_vs_high||href_vs_low||high_lines||low_lines)$fatal(1,"reset did not clear diagnostics");
    $display("PASS camera monitor sensor activity, 240-line capture, zero-line capture, coincident first line, VSYNC phase counts and reset");$finish;
  end
  initial begin #1000000;$fatal(1,"timeout");end
endmodule
```

## sim/tb_camera_readback.sv

```systemverilog
`timescale 1ns/1ps
module tb_camera_readback;
  reg clk=0;always #5 clk=~clk;
  reg rst=1,enable=0,slave_low=0,nack=0;
  tri1 scl,sda;assign sda=slave_low?1'b0:1'bz;
  wire done,error;wire[31:0]values;
  camera_readback #(.QUARTER_CYCLES(4)) dut(clk,rst,enable,scl,sda,done,error,values);
  reg[7:0]value;integer round,j,k;
  function[7:0]address(input integer n);
    case(n)0:address=8'h0a;1:address=8'h15;2:address=8'h3a;3:address=8'h12;endcase
  endfunction
  function[7:0]answer(input integer n);
    case(n)0:answer=8'h76;1:answer=8'h02;2:answer=8'h0c;3:answer=8'h00;endcase
  endfunction
  task start_seen;begin
    @(negedge sda);while(scl!==1'b1)@(negedge sda);
  end endtask
  task stop_seen;begin
    @(posedge sda);while(scl!==1'b1)@(posedge sda);
  end endtask
  task receive_byte(output reg[7:0]b);integer i;begin
    for(i=7;i>=0;i=i-1)begin @(posedge scl);b[i]=sda;end
    @(negedge scl);slave_low=!nack;
    @(posedge scl);@(negedge scl);slave_low=0;
  end endtask
  task send_byte(input reg[7:0]b);integer i;begin
    // Entry is the falling edge ending address ACK.
    for(i=7;i>=0;i=i-1)begin slave_low=~b[i];@(posedge scl);@(negedge scl);end
    slave_low=0;@(posedge scl);
    if(sda!==1'b1)$fatal(1,"master must NACK final read byte");
    @(negedge scl);
  end endtask
  initial begin
    for(round=0;round<2;round=round+1)begin
      rst=1;enable=0;nack=(round==1);repeat(5)@(negedge clk);rst=0;
      repeat(10)@(negedge clk);
      if(scl!==1 || sda!==1 || done)$fatal(1,"idle bus ownership");
      enable=1;
      for(j=0;j<4;j=j+1)begin
        start_seen();receive_byte(value);if(value!=8'h42)$fatal(1,"write address");
        receive_byte(value);if(value!=address(j))$fatal(1,"register pointer");
        stop_seen();start_seen();receive_byte(value);if(value!=8'h43)$fatal(1,"read address");
        send_byte(answer(j));stop_seen();
      end
      wait(done);repeat(5)@(negedge clk);
      if(values!==32'h000c0276 || error!==nack)$fatal(1,"readback values/status %h %b",values,error);
      if(scl!==1 || sda!==1)$fatal(1,"bus not released after done");
    end
    $display("PASS SCCB four-register readback, STOP-separated addressing, final NACK and error status");$finish;
  end
  initial begin #1000000;$fatal(1,"readback timeout");end
endmodule
```

## sim/tb_camera_retry.sv

```systemverilog
`timescale 1ns/1ps
// Retry boundaries: 0 keeps manual recovery, 1 retries after a completed STOP.
// Both camera buses have pullups but no slave, so every write receives NACK.
module tb_camera_retry;
  reg clk=0;always #5 clk=~clk;
  reg button=1;
  reg[15:0]sw=0;
  tri1 scl_off,sda_off,reset_off,scl_one,sda_one,reset_one;
  wire tx_off,tx_one;
  wire[15:0]led_off,led_one;
  integer retries=0,cycles=0,first_error=-1,last_error=-1;
  reg previous_reset=1,previous_error=0,saw_fault=0;
  stream_top #(.W(3),.H(3),.START_DELAY(0),.CAM_RESET_CYCLES(3),
    .CAM_SETTLE_CYCLES(4),.CAM_RETRY_CYCLES(0)) retry_off(
    .clk100(clk),.btnC(button),.sw(sw),.cam_data(8'b0),.cam_vsync(1'b1),.cam_href(1'b0),
    .cam_sioc(scl_off),.cam_siod(sda_off),.cam_rst_n(reset_off),.uart_txd(tx_off),.led(led_off));
  stream_top #(.W(3),.H(3),.START_DELAY(0),.CAM_RESET_CYCLES(3),
    .CAM_SETTLE_CYCLES(4),.CAM_RETRY_CYCLES(1)) retry_one(
    .clk100(clk),.btnC(button),.sw(sw),.cam_data(8'b0),.cam_vsync(1'b1),.cam_href(1'b0),
    .cam_sioc(scl_one),.cam_siod(sda_one),.cam_rst_n(reset_one),.uart_txd(tx_one),.led(led_one));
  defparam retry_off.config_camera.QUARTER_CYCLES=2;
  defparam retry_off.config_camera.POWER_WAIT=4;
  defparam retry_off.config_camera.REG_WAIT=3;
  defparam retry_one.config_camera.QUARTER_CYCLES=2;
  defparam retry_one.config_camera.POWER_WAIT=4;
  defparam retry_one.config_camera.REG_WAIT=3;

  always @(posedge clk)begin
    #1;
    if(retry_one.rst)begin
      cycles=0;previous_reset=0;previous_error=0;saw_fault=0;last_error=-1;
    end else begin
      cycles=cycles+1;
      if(retry_one.config_error && !previous_error)begin
        if(scl_one!==1 || sda_one!==1)$fatal(1,"retry error before clean bus release");
        last_error=cycles;
        if(first_error<0)first_error=cycles;
      end
      if(previous_reset && reset_one===0)begin
        if(cycles-last_error!=1)$fatal(1,"one-cycle retry delay changed");
        if(scl_one!==1 || sda_one!==1)$fatal(1,"retry interrupted active SCCB transaction");
        retries=retries+1;
      end
      if(retry_one.camera_fault)saw_fault=1;
      if(saw_fault && !retry_one.camera_fault)$fatal(1,"fault disappeared during unsuccessful retry");
      if(tx_one!==1 || tx_off!==1 || retry_one.frame_id!=0 || retry_off.frame_id!=0)
        $fatal(1,"unconfigured camera launched a frame");
      previous_reset=reset_one;previous_error=retry_one.config_error;
    end
  end
  initial begin
    repeat(5)@(negedge clk);button=0;
    wait(retry_off.config_error);
    repeat(1000)@(negedge clk);
    if(!retry_off.config_error || !retry_off.camera_fault || !led_off[15] ||
       reset_off!==1 || scl_off!==1 || sda_off!==1 || retry_off.camera_retry_count!=0)
      $fatal(1,"disabled retry did not preserve failed/released state and visible fault");
    if(retries<3 || !led_one[15])$fatal(1,"short retry did not repeat or show fault");
    // Diagnostic-page fault remains visible even during physical camera reset.
    sw=16'h4000;repeat(4)@(negedge clk);
    if(!led_off[6] || !led_one[6])$fatal(1,"diagnostic fault page");
    sw=16'h5000;repeat(4)@(negedge clk);
    if(!led_off[6] || !led_one[6])$fatal(1,"readback diagnostic fault page");
    // Manual button still clears both supervisors and restarts initialization.
    button=1;repeat(25)@(negedge clk);
    if(retry_off.camera_fault || retry_one.camera_fault ||
       reset_off!==0 || reset_one!==0 || led_off[6] || led_one[6])
      $fatal(1,"manual reset failed to clear camera faults");
    button=0;wait(!retry_off.rst);wait(retry_off.config_error);
    repeat(5)@(negedge clk);
    if(!retry_off.camera_fault)$fatal(1,"manual restart did not attempt configuration");
    $display("PASS camera_retry disabled/one-cycle retry, released bus, sticky LEDs and manual reset");
    $finish;
  end
  initial begin #100000;$fatal(1,"camera retry timeout");end
endmodule
```

## sim/tb_enhance_core.sv

```systemverilog
`timescale 1ns/1ps
module tb_enhance_core;
  wire small_done,qvga_done;
  enhance_case small_case(small_done);
  enhance_case #(.W(320),.H(240),.FRAMES(3),.FILE_NAME("enhance_qvga.txt")) qvga(qvga_done);
  initial begin wait(small_done && qvga_done);
    $display("PASS enhancement continuous/bubbled pixels, controls latched, aborted startup, small/QVGA raster exports");$finish;end
  initial begin #20000000;$fatal(1,"enhancement timeout");end
endmodule
module enhance_case #(parameter integer W=9,H=8,FRAMES=5,
  parameter FILE_NAME="enhance_small.txt")(output reg finished=0);
  reg clk=0;always #5 clk=~clk;
  reg rst=1,start=0,valid=0;reg[7:0]pixel=0,gf=16,gc=16,lim=255;
  wire ov,sof,eol,eof;wire[7:0]raw,fine,coarse,enhanced;wire[15:0]x,y;
  enhance_core #(.W(W),.H(H)) dut(clk,rst,start,valid,pixel,gf,gc,lim,
    ov,raw,fine,coarse,enhanced,x,y,sof,eol,eof);
  integer frame=-1,xx,yy,i,fd,outputs=0,row_run=0,full_runs=0;
  function[7:0]source_y(input integer f,px,py);
    begin
      if(f==0)source_y=80;
      else if(f==1)source_y=((px+py)%2)?255:0;
      else if(f==3)source_y=((px<W/2)?40:220)+(px+py)%3;
      else source_y=(px*17+py*31+f*43)%256;
    end
  endfunction
  always @(posedge clk)if(ov)begin
    if(frame<0)$fatal(1,"aborted input leaked enhancement output");
    $fdisplay(fd,"%0d %0d %0d %0d %0d %0d %0d %0d %0d %0d",frame,x,y,raw,fine,coarse,enhanced,sof,eol,eof);
    outputs=outputs+1;row_run=row_run+1;
    if(eol)begin
      if(row_run==W-4)full_runs=full_runs+1;
      row_run=0;
    end
  end else row_run=0;
  initial begin
    fd=$fopen(FILE_NAME,"w");if(!fd)$fatal(1,"enhancement export");
    $fdisplay(fd,"%0d %0d %0d",W,H,FRAMES);
    repeat(3)@(negedge clk);rst=0;
    // Abandon three rows before a complete 5x5 footprint exists.
    start=1;valid=1;pixel=99;@(negedge clk);start=0;
    for(i=1;i<W*3;i=i+1)@(negedge clk);
    valid=0;repeat(12)@(negedge clk);
    for(frame=0;frame<FRAMES;frame=frame+1)begin
      case(frame)
        0:begin gf=16;gc=16;lim=255;end
        1:begin gf=48;gc=32;lim=255;end
        2:begin gf=24;gc=20;lim=32;end
        3:begin gf=0;gc=0;lim=0;end
        4:begin gf=255;gc=255;lim=255;end
      endcase
      start=1;valid=1;pixel=source_y(frame,0,0);@(negedge clk);start=0;
      for(i=1;i<W*H;i=i+1)begin
        if(frame==2 && i%7==0)begin valid=0;repeat(3)@(negedge clk);end
        valid=1;pixel=source_y(frame,i%W,i/W);
        // Deliberately change controls after the frame-start acceptance.
        gf=0;gc=0;lim=0;
        @(negedge clk);
      end
      valid=0;@(posedge clk);while(!eof)@(posedge clk);@(negedge clk);repeat(3)@(negedge clk);
    end
    if(outputs!=FRAMES*(W-4)*(H-4))$fatal(1,"enhancement output count got=%0d expected=%0d",outputs,FRAMES*(W-4)*(H-4));
    if(full_runs==0)$fatal(1,"enhancement never sustained one pixel/clock");
    $fclose(fd);finished=1;
  end
endmodule
```

## sim/tb_fifo_capture.sv

```systemverilog
`timescale 1ns/1ps
module tb_fifo_capture;
  reg clk=0; always #5 clk=~clk;
  reg rst=1,start=0,vsync=1;
  wire rclk,rrst_n,wen,valid,sof,done,busy,error;
  reg [7:0] data=0;
  wire [7:0] pixel;
  integer ptr=0,got=0,frames=0,sofs=0,completions=0,rclk_edges=0;
  fifo_capture #(.W(4),.H(3),.READ_PERIOD(50),.FLUSH_CYCLES(100),.TIMEOUT_CYCLES(1000))
    dut(clk,rst,start,vsync,data,rclk,rrst_n,wen,sof,valid,pixel,done,busy,error);
  // Behavioral AL422 model: reset is synchronous to read clock;
  // first enabled rising edge after reset presents byte zero.
  always @(posedge rclk) begin
    rclk_edges=rclk_edges+1;
    if(!rrst_n) begin ptr=0; data<=0; end
    else begin data <= (ptr%2) ? (ptr/2+frames*20) : 8'hee; ptr=ptr+1; end
  end
  always @(posedge clk) if(!rst) begin
    if(sof)sofs=sofs+1;
    if(done)completions=completions+1;
    if(valid) begin
      if(pixel !== (got+frames*20)) $fatal(1,"byte/position error got %0d value %0d",got,pixel);
      got=got+1;
    end
  end
  task launch;
    begin
      @(negedge clk);start=1;@(negedge clk);start=0;
      if(!busy || error)$fatal(1,"new capture must accept start and clear previous timeout");
    end
  endtask
  task supply_frame;
    begin
      repeat(10) @(negedge clk);vsync=0;
      repeat(10) @(negedge clk);vsync=1;
      repeat(10) @(negedge clk);
      if(!wen) $fatal(1,"capture not armed");
      repeat(100) @(negedge clk);vsync=0;
    end
  endtask
  task capture;
    integer before_sofs,before_completions;
    begin
      before_sofs=sofs;before_completions=completions;
      launch();supply_frame();
      wait(done); repeat(2) @(negedge clk);
      if(got!=12 || error || wen || busy || !rrst_n ||
          sofs!=before_sofs+1 || completions!=before_completions+1)
        $fatal(1,"frame not complete after recovery");
      vsync=1; got=0; frames=frames+1;
      repeat(20) @(negedge clk);
    end
  endtask
  task timeout_in_phase(input integer stuck_phase);
    integer before_sofs,before_completions,before_edges;
    begin
      before_sofs=sofs;before_completions=completions;
      vsync=1;launch();
      if(stuck_phase>=2)begin
        repeat(10)@(negedge clk);vsync=0;
        repeat(10)@(negedge clk);
      end
      if(stuck_phase==3)begin
        vsync=1;repeat(10)@(negedge clk);
        if(!wen)$fatal(1,"CAPTURE timeout case never enabled writes");
      end
      if(dut.state!=stuck_phase)$fatal(1,"wrong timeout phase %0d",dut.state);
      wait(error);@(negedge clk);
      if(wen || busy || !rrst_n || sof || valid || done || got!=0)
        $fatal(1,"phase %0d timeout must release capture without output",stuck_phase);
      before_edges=rclk_edges;
      repeat(150)@(negedge clk);
      if(!error || wen || busy || !rrst_n || sofs!=before_sofs ||
          completions!=before_completions || got!=0 || rclk_edges-before_edges<2)
        $fatal(1,"phase %0d timeout must remain idle with free-running RCLK",stuck_phase);
      vsync=1;repeat(10)@(negedge clk);
      capture();
      $display("PASS fifo_capture phase %0d timeout, pin release and next-frame recovery",stuck_phase);
    end
  endtask
  integer before_reset_completions;
  initial begin
    repeat(5) @(negedge clk); rst=0;
    capture(); capture();
    timeout_in_phase(1); // VSYNC stuck high before blanking.
    timeout_in_phase(2); // VSYNC stuck low before active frame.
    timeout_in_phase(3); // VSYNC remains high while writes are enabled.
    before_reset_completions=completions;
    launch();supply_frame();wait(got==5);
    @(negedge clk);rst=1;
    repeat(3)@(negedge clk);
    if(busy || wen || !rrst_n || rclk || sof || valid || done || error ||
        completions!=before_reset_completions)
      $fatal(1,"reset during FIFO read must discard partial frame and release pins");
    got=0;vsync=1;rst=0;
    repeat(10)@(negedge clk);capture();
    if(frames!=6 || completions!=6 || sofs!=7)
      $fatal(1,"unexpected completed/partial frame totals %0d/%0d/%0d",frames,completions,sofs);
    $display("PASS fifo_capture six complete frames, three timeout phases and mid-read reset recovery");
    $finish;
  end
  initial begin #1000000; $fatal(1,"test timeout");end
endmodule
```

## sim/tb_image_core.sv

```systemverilog
`timescale 1ns/1ps
module tb_image_core;
  parameter W=320,H=240;
  reg clk=0; always #5 clk=~clk;
  reg rst=1,frame_start=0,edge_mode=0,in_valid=0;
  reg [10:0] threshold=0;
  reg [7:0] in_pixel=0;
  wire out_valid,done;
  wire [7:0] out_pixel;
  wire [16:0] out_addr;
  wire [31:0] bright_count,sum_x,sum_y;
  image_core #(.W(W),.H(H)) dut(.*);
  integer src[0:W*H-1],expected[0:(W-2)*(H-2)-1];
  integer count_expected,sx_expected,sy_expected,received,done_seen;
  integer gx,gy,mag,x,y,k,f,seed=1234567,r;
  integer mode,thresh;
  always @(posedge clk) begin
    #1;
    if (!rst && !frame_start) begin
      if(out_valid) begin
        if(received >= (W-2)*(H-2)) $fatal(1,"extra output");
        if(out_addr !== received || out_pixel !== expected[received])
          $fatal(1,"pixel mismatch frame=%0d addr=%0d expected_addr=%0d value=%0d expected=%0d",f,out_addr,received,out_pixel,expected[received]);
        received=received+1;
      end
      if(done) begin
        if(out_valid) $fatal(1,"done must follow final output");
        if(received != (W-2)*(H-2)) $fatal(1,"early done");
        if(bright_count !== count_expected || sum_x !== sx_expected || sum_y !== sy_expected)
          $fatal(1,"statistics mismatch count=%0d/%0d sx=%0d/%0d sy=%0d/%0d",bright_count,count_expected,sum_x,sx_expected,sum_y,sy_expected);
        done_seen=done_seen+1;
      end
    end
  end
  initial begin
    received=0; done_seen=0;
    repeat(4) @(negedge clk); rst=0;
    for(f=0;f<12;f=f+1) begin
      mode=f%2; thresh=(f==1)?0:((f==3)?2047:((f==5)?1020:180));
      for(y=0;y<H;y=y+1) for(x=0;x<W;x=x+1) begin
        case(f/2)
          0: src[y*W+x]=0;
          1: src[y*W+x]=255;
          2: src[y*W+x]=(x>W/2)?255:0;
          3: src[y*W+x]=(x*17+y*11)%256;
          4: src[y*W+x]=(x>=3&&x<W-3&&y>=2&&y<H-2)?255:0;
          default: begin r=$random(seed); src[y*W+x]=r&255; end
        endcase
      end
      count_expected=0; sx_expected=0; sy_expected=0;k=0;
      for(y=1;y<H-1;y=y+1) for(x=1;x<W-1;x=x+1) begin
        gx=src[(y-1)*W+x+1]+2*src[y*W+x+1]+src[(y+1)*W+x+1]
          -src[(y-1)*W+x-1]-2*src[y*W+x-1]-src[(y+1)*W+x-1];
        gy=src[(y+1)*W+x-1]+2*src[(y+1)*W+x]+src[(y+1)*W+x+1]
          -src[(y-1)*W+x-1]-2*src[(y-1)*W+x]-src[(y-1)*W+x+1];
        mag=((gx<0)?-gx:gx)+((gy<0)?-gy:gy);
        expected[k]=mode?((mag>=thresh)?255:0):src[y*W+x]; k=k+1;
        if(src[y*W+x]>=128) begin count_expected=count_expected+1; sx_expected=sx_expected+x; sy_expected=sy_expected+y; end
      end
      @(negedge clk); frame_start=1;edge_mode=mode;threshold=thresh;
      @(negedge clk); frame_start=0; received=0; done_seen=0;
      edge_mode=!mode;threshold=777; // inputs must be latched at frame_start
      for(k=0;k<W*H;k=k+1) begin
        in_valid=1;in_pixel=src[k];
        @(negedge clk);in_valid=0;
        repeat(3+(k%5)) @(negedge clk);
      end
      repeat(10) @(negedge clk);
      if(done_seen!=1 || received!=(W-2)*(H-2)) $fatal(1,"missing frame completion outputs=%0d done=%0d",received,done_seen);
      $display("PASS frame=%0d mode=%0d threshold=%0d pixels=%0d bright=%0d",f,mode,thresh,received,bright_count);
    end
    $display("PASS_IMAGE_CORE W=%0d H=%0d frames=12",W,H); $finish;
  end
  initial begin #100000000; $fatal(1,"timeout"); end
endmodule
```

## sim/tb_output_budget.sv

```systemverilog
`timescale 1ns/1ps
// Self-contained budget and 1/8-pixel boundary checks. No large wire artifacts.
module output_budget_case #(
  parameter integer W=318,H=238,CPB=4
)(
  output reg complete=0,
  output reg [31:0] raw_bytes=0,packed_bytes=0,features_bytes=0,
  output reg [31:0] raw_cycles=0,packed_cycles=0,features_cycles=0
);
  localparam integer N=W*H;
  reg clk=0,rst=1,start=0,pack_edges=0,features_only=0;
  always #5 clk=~clk;
  reg [31:0] frame_id=900;
  wire [16:0] addr;
  reg [7:0] rd;
  wire busy,done,tx;
  integer scenario=0,accepted=0,captures=0,cycles=0,expected_bytes=0;
  reg [15:0] crc=16'hffff;
  frame_sender #(.W(W),.H(H),.CLKS_PER_BIT(CPB),.TARGET_PROTOCOL(1),.OUTPUT_PROTOCOL(1)) dut
    (.clk(clk),.rst(rst),.start(start),.edge_mode(1'b1),.threshold(11'd180),
     .frame_id(frame_id),.bright_count(32'd0),.sum_x(32'd0),.sum_y(32'd0),
     .ram_addr(addr),.ram_data(rd),.busy(busy),.done(done),.uart_txd(tx),
     .target_enable(1'b1),.target_valid(1'b0),.target_dark(1'b1),.config_valid(1'b1),
     .target_threshold(8'd64),.roi_x_min(16'd1),.roi_y_min(16'd1),
     .roi_x_max(16'(W)),.roi_y_max(16'(H)),.bbox_x_min(16'd0),.bbox_y_min(16'd0),
     .bbox_x_max(16'd0),.bbox_y_max(16'd0),.target_area(32'd0),.target_sum_x(32'd0),
     .target_sum_y(32'd0),.min_area(32'd1),.max_area(32'(N)),
     .pack_edges(pack_edges),.features_only(features_only));
  function [7:0] memory_byte(input integer index);
    begin memory_byte=(index%3==0 || index==N-1)?8'hff:8'h00; end
  endfunction
  function [15:0] update_crc(input [15:0] c,input [7:0] b);
    reg [15:0] v; integer k;
    begin v=c^{b,8'b0}; for(k=0;k<8;k=k+1)v=v[15]?(v<<1)^16'h1021:v<<1;update_crc=v;end
  endfunction
  function [7:0] expected_byte(input integer index);
    reg [7:0] b;
    integer k,payload_length;
    reg [31:0] val;
    begin
      b=0;val=0;
      payload_length=(scenario==2)?0:((scenario==1)?((N+7)/8):N);
      case(index)
        0:b="F";1:b="P";2:b="G";3:b="1";
        4:b=(scenario==0)?2:3;5:b=1;
        6:b=W&255;7:b=(W>>8)&255;8:b=H&255;9:b=(H>>8)&255;
        10:b=180;32:b=6;33:b=64;
        34:b=1;36:b=1;38:b=W&255;39:b=(W>>8)&255;
        40:b=H&255;41:b=(H>>8)&255;62:b=1;
        70:b=(scenario==0)?0:((scenario==1)?5:6);
        default:begin end
      endcase
      if(index>=12 && index<=15)begin val=900+scenario;b=(val>>(8*(index-12)))&255;end
      if(index>=16 && index<=19)begin val=payload_length;b=(val>>(8*(index-16)))&255;end
      if(index>=66 && index<=69)begin val=N;b=(val>>(8*(index-66)))&255;end
      if(index>=72)begin
        if(scenario==0)b=memory_byte(index-72);
        else begin
          b=0;
          for(k=0;k<8;k=k+1)
            if((index-72)*8+k<N)b[k]=memory_byte((index-72)*8+k)==255;
        end
      end
      expected_byte=b;
    end
  endfunction
  always @(posedge clk)begin
    rd<=memory_byte(addr);
    if(rst || (start && !busy))begin accepted=0;captures=0;cycles=0;crc=16'hffff;end
    else begin
      if(busy)cycles=cycles+1;
      if(dut.state==3)begin
        if(addr!==captures)$fatal(1,"budget N=%0d scenario=%0d RAM address %0d expected %0d",N,scenario,addr,captures);
        captures=captures+1;
      end
      if(dut.valid && dut.ready)begin
        if(accepted<expected_bytes-2)begin
          if(dut.data!==expected_byte(accepted))
            $fatal(1,"budget N=%0d scenario=%0d byte=%0d got=%h expected=%h",N,scenario,accepted,dut.data,expected_byte(accepted));
          if(accepted>=4)crc=update_crc(crc,dut.data);
        end else if(accepted==expected_bytes-2)begin
          if(dut.data!==crc[7:0])$fatal(1,"budget CRC low N=%0d",N);
        end else if(accepted==expected_bytes-1)begin
          if(dut.data!==crc[15:8])$fatal(1,"budget CRC high N=%0d",N);
        end else $fatal(1,"budget excess byte N=%0d",N);
        accepted=accepted+1;
      end
    end
  end
  initial begin
    repeat(5)@(negedge clk);rst=0;
    for(scenario=0;scenario<3;scenario=scenario+1)begin
      pack_edges=(scenario!=0);features_only=(scenario==2);frame_id=900+scenario;
      expected_bytes=74+((scenario==0)?N:((scenario==1)?((N+7)/8):0));
      @(negedge clk);start=1;@(negedge clk);start=0;
      // The bench verifies the complete packet even when requests change live.
      pack_edges=~pack_edges;features_only=~features_only;frame_id=0;
      wait(done);@(negedge clk);
      if(accepted!==expected_bytes)$fatal(1,"budget byte count N=%0d",N);
      if(captures!==((scenario==2)?0:N))$fatal(1,"budget RAM count N=%0d",N);
      if(busy)$fatal(1,"budget busy after done");
      case(scenario)
        0:begin raw_bytes=accepted;raw_cycles=cycles;end
        1:begin packed_bytes=accepted;packed_cycles=cycles;end
        2:begin features_bytes=accepted;features_cycles=cycles;end
      endcase
    end
    if(N>8 && !(features_cycles<packed_cycles && packed_cycles<raw_cycles))
      $fatal(1,"budget cycles did not improve N=%0d",N);
    complete=1;
  end
endmodule

module tb_output_budget;
  wire full_done,one_done,eight_done;
  wire [31:0] raw_bytes,packed_bytes,features_bytes,raw_cycles,packed_cycles,features_cycles;
  integer fd;
  output_budget_case full(.complete(full_done),.raw_bytes(raw_bytes),.packed_bytes(packed_bytes),
    .features_bytes(features_bytes),.raw_cycles(raw_cycles),.packed_cycles(packed_cycles),.features_cycles(features_cycles));
  output_budget_case #(.W(1),.H(1)) single_pixel(.complete(one_done));
  output_budget_case #(.W(8),.H(1)) exact_byte(.complete(eight_done));
  initial begin
    wait(full_done && one_done && eight_done);
    if(raw_bytes!==75758 || packed_bytes!==9535 || features_bytes!==74)$fatal(1,"QVGA byte budget");
    fd=$fopen("output_budget.json","w");
    if(fd==0)$fatal(1,"cannot open output_budget.json");
    $fwrite(fd,"{\n  \"width\": 318, \"height\": 238, \"pixels\": 75684, \"clks_per_bit\": 4,\n");
    $fwrite(fd,"  \"raw\": {\"payload_bytes\": 75684, \"wire_bytes\": %0d, \"cycles\": %0d},\n",raw_bytes,raw_cycles);
    $fwrite(fd,"  \"packed\": {\"payload_bytes\": 9461, \"wire_bytes\": %0d, \"cycles\": %0d},\n",packed_bytes,packed_cycles);
    $fwrite(fd,"  \"features\": {\"payload_bytes\": 0, \"wire_bytes\": %0d, \"cycles\": %0d}\n}\n",features_bytes,features_cycles);
    $fclose(fd);
    $display("PASS output budget QVGA N=75684: raw %0d bytes/%0d cycles, packed %0d bytes/%0d cycles, features %0d bytes/%0d cycles; N=1/N=8 payload, padding, CRC and no-RAM checks",raw_bytes,raw_cycles,packed_bytes,packed_cycles,features_bytes,features_cycles);
    $finish;
  end
  initial begin #100000000;$fatal(1,"output budget timeout");end
endmodule
```

## sim/tb_output_transport.sv

```systemverilog
`timescale 1ns/1ps
// This wire stream intentionally contains exactly six packets for PC cross-checks.
module tb_output_transport;
  localparam W=5,H=3,CPB=4,PIXELS=W*H,MAX_N=72+PIXELS+2;
  reg clk=0,rst=1,start=0,mode=1,pack_edges=0,features_only=0;
  always #5 clk=~clk;
  reg [10:0] threshold;
  reg [31:0] frame_id,bc,sx,sy;
  reg target_enable,target_valid,target_dark,config_valid;
  reg [7:0] target_threshold;
  reg [15:0] roi_x_min,roi_y_min,roi_x_max,roi_y_max;
  reg [15:0] bbox_x_min,bbox_y_min,bbox_x_max,bbox_y_max;
  reg [31:0] target_area,target_sum_x,target_sum_y,min_area,max_area;
  wire [16:0] addr;
  reg [7:0] rd;
  wire busy,done,tx;
  reg [7:0] mem[0:PIXELS-1],received[0:MAX_N-1],expected[0:MAX_N-1];
  integer fd,i,f,header_bytes,payload_bytes,total,ram_captures;
  reg [15:0] crc;
  reg expected_packed,expected_features;
  frame_sender #(.W(W),.H(H),.CLKS_PER_BIT(CPB),.TARGET_PROTOCOL(1),.OUTPUT_PROTOCOL(1)) dut
    (.clk(clk),.rst(rst),.start(start),.edge_mode(mode),.threshold(threshold),
     .frame_id(frame_id),.bright_count(bc),.sum_x(sx),.sum_y(sy),
     .ram_addr(addr),.ram_data(rd),.busy(busy),.done(done),.uart_txd(tx),
     .target_enable(target_enable),.target_valid(target_valid),
     .target_dark(target_dark),.config_valid(config_valid),
     .target_threshold(target_threshold),.roi_x_min(roi_x_min),.roi_y_min(roi_y_min),
     .roi_x_max(roi_x_max),.roi_y_max(roi_y_max),.bbox_x_min(bbox_x_min),
     .bbox_y_min(bbox_y_min),.bbox_x_max(bbox_x_max),.bbox_y_max(bbox_y_max),
     .target_area(target_area),.target_sum_x(target_sum_x),.target_sum_y(target_sum_y),
     .min_area(min_area),.max_area(max_area),.pack_edges(pack_edges),.features_only(features_only));
  always @(posedge clk) begin
    rd<=mem[addr];
    if(rst || (start && !busy)) ram_captures<=0;
    else if(dut.state==3) begin
      if(addr!==ram_captures) $fatal(1,"RAM sequence frame %0d got %0d expected %0d",f,addr,ram_captures);
      ram_captures<=ram_captures+1;
    end
  end
  function [15:0] update_crc(input [15:0] c,input [7:0] b);
    reg [15:0] v; integer k;
    begin v=c^{b,8'b0}; for(k=0;k<8;k=k+1) v=v[15]?(v<<1)^16'h1021:v<<1; update_crc=v; end
  endfunction
  task put_u16(input integer offset,input [15:0] value);
    begin expected[offset]=value[7:0];expected[offset+1]=value[15:8];end
  endtask
  task put_u32(input integer offset,input [31:0] value);
    integer k;
    begin for(k=0;k<4;k=k+1)expected[offset+k]=(value>>(8*k))&8'hff;end
  endtask
  task get_byte(output [7:0] b);
    integer k;
    begin
      @(negedge tx); #(CPB*10/2);
      if(tx!==0) $fatal(1,"bad start bit");
      for(k=0;k<8;k=k+1) begin #(CPB*10); b[k]=tx; end
      #(CPB*10); if(tx!==1) $fatal(1,"bad stop bit");
    end
  endtask
  task configure_frame(input integer frame);
    integer k;
    begin
      mode=1;pack_edges=1;features_only=0;threshold=180+frame;frame_id=100+frame;
      bc=8;sx=21;sy=17;
      target_enable=1;target_valid=1;target_dark=1;config_valid=1;
      target_threshold=64;roi_x_min=1;roi_y_min=1;roi_x_max=W;roi_y_max=H;
      bbox_x_min=2;bbox_y_min=1;bbox_x_max=3;bbox_y_max=2;
      target_area=4;target_sum_x=10;target_sum_y=6;min_area=1;max_area=PIXELS;
      for(k=0;k<PIXELS;k=k+1)mem[k]=((k+frame)%3==0 || k==PIXELS-1)?255:0;
      case(frame)
        0:target_enable=0;
        1:begin end
        2:features_only=1; // Both requests asserted: features must win.
        3:begin
          features_only=1;pack_edges=0;mode=0;target_valid=0;
          target_area=0;target_sum_x=0;target_sum_y=0;
          bbox_x_min=0;bbox_y_min=0;bbox_x_max=0;bbox_y_max=0;
        end
        4:begin // Ineligible requests must fall back to v1 grayscale.
          mode=0;target_enable=0;features_only=1;
          for(k=0;k<PIXELS;k=k+1)mem[k]=k*13+5;
        end
        5:begin // Return from result mode to a complete v2 raw frame.
          pack_edges=0;
          for(k=0;k<PIXELS;k=k+1)mem[k]=k*11+7;
        end
      endcase
    end
  endtask
  task make_expected;
    integer k;
    begin
      expected_features=target_enable && features_only;
      expected_packed=pack_edges && mode && !expected_features;
      header_bytes=(target_enable || expected_packed)?72:32;
      payload_bytes=expected_features?0:(expected_packed?((PIXELS+7)/8):PIXELS);
      total=header_bytes+payload_bytes+2;
      for(k=0;k<MAX_N;k=k+1)expected[k]=0;
      expected[0]="F";expected[1]="P";expected[2]="G";expected[3]="1";
      expected[4]=(expected_features || expected_packed)?3:(target_enable?2:1);expected[5]=mode;
      put_u16(6,W);put_u16(8,H);put_u16(10,{5'b0,threshold});
      put_u32(12,frame_id);put_u32(16,payload_bytes);put_u32(20,bc);put_u32(24,sx);put_u32(28,sy);
      if(target_enable)begin
        expected[32]={5'b0,config_valid,target_dark,target_valid};expected[33]=target_threshold;
        put_u16(34,roi_x_min);put_u16(36,roi_y_min);put_u16(38,roi_x_max);put_u16(40,roi_y_max);
        put_u16(42,bbox_x_min);put_u16(44,bbox_y_min);put_u16(46,bbox_x_max);put_u16(48,bbox_y_max);
        put_u32(50,target_area);put_u32(54,target_sum_x);put_u32(58,target_sum_y);
        put_u32(62,min_area);put_u32(66,max_area);
      end
      if(header_bytes==72)expected[70]=expected_features?6:(expected_packed?(target_enable?5:1):0);
      if(expected_packed)begin
        for(k=0;k<PIXELS;k=k+1)expected[header_bytes+k/8][k%8]=mem[k][7];
      end else if(!expected_features)begin
        for(k=0;k<PIXELS;k=k+1)expected[header_bytes+k]=mem[k];
      end
      crc=16'hffff;
      for(k=4;k<total-2;k=k+1)crc=update_crc(crc,expected[k]);
      expected[total-2]=crc[7:0];expected[total-1]=crc[15:8];
    end
  endtask
  task mutate_live_inputs;
    begin
      mode=~mode;pack_edges=~pack_edges;features_only=~features_only;
      threshold=0;frame_id=32'hdeadbeef;bc=0;sx=0;sy=0;
      target_enable=~target_enable;target_valid=~target_valid;
      target_dark=~target_dark;config_valid=~config_valid;target_threshold=~target_threshold;
      roi_x_min=~roi_x_min;roi_y_min=~roi_y_min;roi_x_max=~roi_x_max;roi_y_max=~roi_y_max;
      bbox_x_min=~bbox_x_min;bbox_y_min=~bbox_y_min;bbox_x_max=~bbox_x_max;bbox_y_max=~bbox_y_max;
      target_area=~target_area;target_sum_x=~target_sum_x;target_sum_y=~target_sum_y;
      min_area=~min_area;max_area=~max_area;
    end
  endtask
  initial begin
    fd=$fopen("output_wire.bin","wb");
    if(fd==0)$fatal(1,"cannot open output_wire.bin");
    // Abort a packet before recording, then prove reset returns UART and FSM idle.
    repeat(5)@(negedge clk);rst=0;configure_frame(0);
    start=1;@(negedge clk);start=0;repeat(12)@(negedge clk);
    rst=1;repeat(3)@(negedge clk);
    if(busy || tx!==1 || done)$fatal(1,"reset did not clear active packet");
    rst=0;
    for(f=0;f<6;f=f+1)begin
      configure_frame(f);make_expected();
      @(negedge clk);start=1;
      @(negedge clk);start=0;mutate_live_inputs();
      for(i=0;i<total;i=i+1)begin get_byte(received[i]);$fwrite(fd,"%c",received[i]);end
      for(i=0;i<total;i=i+1)
        if(received[i]!==expected[i])
          $fatal(1,"output frame %0d byte %0d got %h expected %h",f,i,received[i],expected[i]);
      wait(done);@(negedge clk);
      if(busy)$fatal(1,"busy after done");
      if(ram_captures!==(expected_features?0:PIXELS))$fatal(1,"RAM count frame %0d: %0d",f,ram_captures);
    end
    $fclose(fd);
    $display("PASS output transport six frames: packed LSB/tail, target/no target, features priority, fallbacks, reset, latching, RAM sequence, UART and CRC");
    $finish;
  end
  initial begin #1000000;$fatal(1,"output transport timeout");end
endmodule
```

## sim/tb_stream_buffers.sv

```systemverilog
`timescale 1ns/1ps
module tb_stream_buffers;
  wire d1,d3,dq;
  fifo_case #(.DEPTH(1)) one_entry(d1);
  fifo_case #(.DEPTH(3)) odd_depth(d3);
  frame_queue_case queue_case(dq);
  initial begin wait(d1 && d3 && dq);
    $display("PASS bounded FIFO depth 1/3; full replacement/overflow; display whole-frame drop, stalls, abort, malformed frame, reset and order");$finish;end
  initial begin #1000000;$fatal(1,"stream buffer timeout");end
endmodule
module fifo_case #(parameter integer DEPTH=3)(output reg finished=0);
  reg clk=0;always #5 clk=~clk;
  reg rst=1,valid=0,ready=0;reg[15:0]data=0;
  wire ir,ov,overflow;wire[15:0]od;wire[$clog2(DEPTH+1)-1:0]level;
  pixel_fifo #(.WIDTH(16),.DEPTH(DEPTH)) dut(clk,rst,valid,data,ir,ov,od,ready,overflow,level);
  integer expected[0:255],wp=0,rp=0,i;
  always @(posedge clk)if(!rst)begin
    if(ov && ready)begin if(od!==expected[rp])$fatal(1,"ingress FIFO order");rp=rp+1;end
    if(valid && ir)begin expected[wp]=data;wp=wp+1;end
    if(level>DEPTH)$fatal(1,"unbounded ingress FIFO");
  end
  initial begin
    repeat(3)@(negedge clk);rst=0;
    for(i=0;i<DEPTH;i=i+1)begin valid=1;data=i;@(negedge clk);end
    data=999;@(negedge clk);
    if(!overflow || ir || level!=DEPTH)$fatal(1,"FIFO overflow not reported");
    ready=1;data=100;@(negedge clk);valid=0;
    repeat(DEPTH+3)@(negedge clk);
    if(ov || wp!=DEPTH+1 || rp!=wp)$fatal(1,"FIFO drain/replacement");
    rst=1;@(negedge clk);if(ov || level!=0)$fatal(1,"FIFO reset");finished=1;
  end
endmodule
module frame_queue_case(output reg finished=0);
  reg clk=0;always #5 clk=~clk;
  reg rst=1,start=0,abort_frame=0,iv=0,last=0,processed=0,ready=0;
  reg[31:0]id=0;reg[7:0]pixel=0;
  wire dropped,bad,ov,sof,eol,eof,delivered,view;wire[1:0]level;wire[7:0]od;wire[31:0]oid;
  display_frame_queue #(.W(3),.H(2)) dut(clk,rst,start,abort_frame,id,processed,
    iv,pixel,last,dropped,bad,level,ov,ready,od,oid,view,sof,eol,eof,delivered);
  integer expected_ids[0:4],packets=0,index=0,drops=0,errors=0,cycle=0;
  reg hold=0;reg[44:0]held;
  always @(posedge clk)begin
    cycle=cycle+1;
    if(rst)hold=0;
    else begin
      if(hold && {oid,view,sof,eol,eof,od}!==held)$fatal(1,"stalled display changed payload");
      hold=ov && !ready;held={oid,view,sof,eol,eof,od};
      if(level>2)$fatal(1,"unbounded display frame queue");
      if(dropped)drops=drops+1;if(bad)errors=errors+1;
      if(ov && ready)begin
        if(packets>=5 || oid!==expected_ids[packets] || od!==((oid*20+index)&255) ||
           view!==(oid%2) || sof!==(index==0) || eol!==(index%3==2) || eof!==(index==5))
          $fatal(1,"display packet/order/raster mismatch id=%0d index=%0d pixel=%0d",oid,index,od);
        if(eof)begin packets=packets+1;index=0;end else index=index+1;
      end
    end
  end
  task begin_frame(input integer frame);
    begin @(negedge clk);id=frame;processed=frame%2;start=1;@(negedge clk);start=0;end
  endtask
  task send_pixels(input integer count,ending);
    integer j;
    begin
      for(j=0;j<count;j=j+1)begin iv=1;pixel=(id*20+j)&255;last=ending && j==count-1;@(negedge clk);end
      iv=0;last=0;
    end
  endtask
  task send_frame(input integer frame);
    begin begin_frame(frame);send_pixels(6,1);end
  endtask
  // Deterministic backpressure during consumption, including final pixels.
  reg run_reader=0;
  always @(negedge clk)if(run_reader)ready=(cycle%4!=1);
  initial begin
    expected_ids[0]=1;expected_ids[1]=2;expected_ids[2]=4;expected_ids[3]=6;expected_ids[4]=10;
    repeat(3)@(negedge clk);rst=0;
    begin_frame(1);send_pixels(3,0);repeat(4)@(negedge clk);
    if(ov)$fatal(1,"uncommitted frame became visible");
    // Continue this partial fixture without restarting its input index.
    iv=1;pixel=23;@(negedge clk);pixel=24;@(negedge clk);pixel=25;last=1;@(negedge clk);iv=0;last=0;
    send_frame(2);send_frame(3);repeat(3)@(negedge clk);
    if(drops!=1 || level!=2)$fatal(1,"slow-display whole frame drop");
    run_reader=1;
    wait(packets==1);send_frame(4);
    wait(packets==3);@(negedge clk);run_reader=0;ready=0;
    begin_frame(5);send_pixels(3,0);abort_frame=1;@(negedge clk);abort_frame=0;
    send_frame(6);run_reader=1;wait(packets==4);@(negedge clk);run_reader=0;ready=0;
    begin_frame(7);send_pixels(2,1);begin_frame(8);send_pixels(6,0);
    repeat(3)@(negedge clk);if(errors!=2 || ov)$fatal(1,"malformed frame leaked");
    send_frame(9);wait(ov);@(negedge clk);rst=1;repeat(2)@(negedge clk);rst=0;
    if(ov || level!=0)$fatal(1,"queue reset kept old frame");
    send_frame(10);run_reader=1;wait(packets==5);repeat(3)@(negedge clk);
    if(level!=0 || ov)$fatal(1,"display queue did not drain");finished=1;
  end
endmodule
```

## sim/tb_target_stats.sv

```systemverilog
`timescale 1ns/1ps
module tb_target_stats;
  parameter integer W=9,H=8,LARGE_ONLY=0;
  localparam integer N=W*H,INTERIOR=(W-2)*(H-2);
  reg clk=0;always #5 clk=~clk;
  reg rst=1,frame_start=0,in_valid=0,target_dark=1;
  reg [7:0] in_pixel=0,target_threshold=96;
  reg [15:0] roi_x_min=1,roi_y_min=1,roi_x_max=W-2,roi_y_max=H-2;
  reg [31:0] min_area=1,max_area=INTERIOR;
  wire done,config_valid,target_valid;
  wire [31:0] target_area,target_sum_x,target_sum_y;
  wire [15:0] bbox_x_min,bbox_y_min,bbox_x_max,bbox_y_max;
  target_stats #(.W(W),.H(H)) dut(
    .clk(clk),.rst(rst),.frame_start(frame_start),.in_valid(in_valid),.in_pixel(in_pixel),
    .target_dark(target_dark),.target_threshold(target_threshold),
    .roi_x_min(roi_x_min),.roi_y_min(roi_y_min),.roi_x_max(roi_x_max),.roi_y_max(roi_y_max),
    .min_area(min_area),.max_area(max_area),.done(done),.config_valid(config_valid),
    .target_valid(target_valid),.target_area(target_area),.target_sum_x(target_sum_x),
    .target_sum_y(target_sum_y),.bbox_x_min(bbox_x_min),.bbox_y_min(bbox_y_min),
    .bbox_x_max(bbox_x_max),.bbox_y_max(bbox_y_max));
  reg [7:0] src[0:N-1];
  integer expected_area,expected_sx,expected_sy,expected_x0,expected_y0,expected_x1,expected_y1;
  reg expected_config,expected_valid;
  integer k,x,y,frames=0;

  task defaults;
    begin
      target_dark=1;target_threshold=96;
      roi_x_min=1;roi_y_min=1;roi_x_max=W-2;roi_y_max=H-2;
      min_area=1;max_area=INTERIOR;
    end
  endtask
  task fill(input [7:0] value);
    integer i;
    begin for(i=0;i<N;i=i+1)src[i]=value;end
  endtask
  task rectangle(input integer x0,y0,x1,y1,input [7:0] value);
    integer xx,yy;
    begin for(yy=y0;yy<=y1;yy=yy+1)for(xx=x0;xx<=x1;xx=xx+1)src[yy*W+xx]=value;end
  endtask
  task reference_model;
    integer xx,yy;
    begin
      expected_config=(roi_x_min>=1 && roi_x_min<=roi_x_max && roi_x_max<=W-2 &&
        roi_y_min>=1 && roi_y_min<=roi_y_max && roi_y_max<=H-2 &&
        min_area>=1 && min_area<=max_area && max_area<=INTERIOR);
      expected_area=0;expected_sx=0;expected_sy=0;
      expected_x0=0;expected_y0=0;expected_x1=0;expected_y1=0;
      for(yy=0;yy<H;yy=yy+1)for(xx=0;xx<W;xx=xx+1)
        if(expected_config && xx>=roi_x_min && xx<=roi_x_max && yy>=roi_y_min && yy<=roi_y_max &&
            (target_dark?(src[yy*W+xx]<=target_threshold):(src[yy*W+xx]>=target_threshold)))begin
          if(expected_area==0)begin expected_x0=xx;expected_x1=xx;expected_y0=yy;expected_y1=yy;end
          else begin
            if(xx<expected_x0)expected_x0=xx;if(xx>expected_x1)expected_x1=xx;
            if(yy<expected_y0)expected_y0=yy;if(yy>expected_y1)expected_y1=yy;
          end
          expected_area=expected_area+1;expected_sx=expected_sx+xx;expected_sy=expected_sy+yy;
        end
      expected_valid=expected_config && expected_area>0 && expected_area>=min_area && expected_area<=max_area;
    end
  endtask
  task check_results(input string label);
    begin
      if(config_valid!==expected_config || target_valid!==expected_valid ||
          target_area!==expected_area || target_sum_x!==expected_sx || target_sum_y!==expected_sy ||
          bbox_x_min!==expected_x0 || bbox_y_min!==expected_y0 || bbox_x_max!==expected_x1 || bbox_y_max!==expected_y1)
        $fatal(1,"%s result mismatch config=%b/%b valid=%b/%b area=%0d/%0d sum=%0d,%0d/%0d,%0d bbox=%0d,%0d,%0d,%0d/%0d,%0d,%0d,%0d",
          label,config_valid,expected_config,target_valid,expected_valid,target_area,expected_area,
          target_sum_x,target_sum_y,expected_sx,expected_sy,bbox_x_min,bbox_y_min,bbox_x_max,bbox_y_max,
          expected_x0,expected_y0,expected_x1,expected_y1);
    end
  endtask
  task begin_frame;
    begin
      @(negedge clk);frame_start=1;in_valid=0;
      @(negedge clk);frame_start=0;
      if(done!==0 || target_area!==0 || target_sum_x!==0 || target_sum_y!==0 ||
          bbox_x_min!==0 || bbox_y_min!==0 || bbox_x_max!==0 || bbox_y_max!==0)
        $fatal(1,"frame_start did not clear results/done");
    end
  endtask
  task finish_frame(input string label,input integer gaps,mutate);
    integer i;
    begin
      for(i=0;i<N;i=i+1)begin
        if(mutate && i==N/2)begin
          target_dark=!target_dark;target_threshold=255;roi_x_min=0;roi_y_max=0;min_area=0;max_area=0;
        end
        in_valid=1;in_pixel=src[i];@(negedge clk);
        if(done!==0)$fatal(1,"%s done before final input retired",label);
        if(gaps && i!=N-1)begin
          in_valid=0;repeat(i%3+1)begin
            @(negedge clk);if(done!==0)$fatal(1,"%s done in input gap",label);
          end
        end
      end
      in_valid=0;
      // Last raw pixel has retired; done must be delayed one cycle.
      check_results(label);
      @(negedge clk);if(done!==1)$fatal(1,"%s missing delayed done",label);
      check_results(label);
      @(negedge clk);if(done!==0)$fatal(1,"%s done wider than one cycle",label);
      check_results(label);
      // Extra samples after W*H cannot change the completed result.
      in_valid=1;in_pixel=0;
      repeat(5)begin @(negedge clk);if(done!==0)$fatal(1,"extra-input done");check_results(label);end
      in_valid=0;
      frames=frames+1;
      $display("PASS target_stats %s area=%0d valid=%b",label,target_area,target_valid);
    end
  endtask
  task run_frame(input string label,input integer gaps,mutate);
    begin reference_model();begin_frame();finish_frame(label,gaps,mutate);end
  endtask
  task partial_frame;
    integer i;
    begin
      begin_frame();
      for(i=0;i<N/2;i=i+1)begin
        in_valid=1;in_pixel=0;@(negedge clk);
        if(done!==0)$fatal(1,"partial frame completed");
      end
      in_valid=0;
      if(target_area==0)$fatal(1,"partial-frame test did not accumulate any target");
    end
  endtask

  initial begin
    repeat(3)@(negedge clk);rst=0;
    if(LARGE_ONLY)begin
      defaults();fill(240);src[(H-2)*W+W-2]=96;
      run_frame("large_last_roi_pixel",0,0);
      defaults();fill(0);max_area=INTERIOR/2;
      run_frame("large_all_roi_above_max",0,0);
      if(target_area!==75684 || target_sum_x!==12071598 || target_sum_y!==9044238 || target_valid!==0)
        $fatal(1,"QVGA full-ROI area/sum/filter regression");
      $display("PASS_TARGET_STATS_QVGA frames=%0d W=%0d H=%0d area=%0d sums=%0d,%0d",frames,W,H,
        target_area,target_sum_x,target_sum_y);
      $finish;
    end
    in_valid=1;in_pixel=0;repeat(N+2)begin
      @(negedge clk);if(done!==0 || target_area!==0 || config_valid!==0)$fatal(1,"input accepted before frame_start");
    end
    in_valid=0;
    defaults();fill(240);run_frame("no_target",1,0);
    defaults();fill(240);rectangle(2,2,5,4,32);run_frame("dark_rectangle",0,0);
    defaults();target_dark=0;fill(10);rectangle(1,1,6,5,220);run_frame("bright_rectangle",1,0);
    defaults();fill(0);roi_x_min=3;roi_y_min=2;roi_x_max=5;roi_y_max=4;
    rectangle(3,2,5,4,240);src[3*W+4]=96;run_frame("roi_excludes_distractors",0,0);
    defaults();fill(240);src[1*W+1]=96;src[1*W+W-2]=96;
    src[(H-2)*W+1]=96;src[(H-2)*W+W-2]=96;
    rectangle(0,0,W-1,0,0);rectangle(0,H-1,W-1,H-1,0);
    src[3*W]=0;src[3*W+W-1]=0;run_frame("inclusive_roi_corners_exclude_border",0,0);
    defaults();fill(240);src[(H-2)*W+W-2]=96;run_frame("last_roi_pixel",0,0);
    defaults();target_dark=0;fill(0);src[(H-2)*W+W-2]=96;run_frame("bright_threshold_equality",0,0);
    defaults();fill(240);rectangle(2,2,3,3,0);min_area=4;max_area=4;run_frame("exact_area_limits",0,0);
    defaults();fill(240);rectangle(2,2,3,3,0);min_area=5;run_frame("below_min_keeps_raw_statistics",0,0);
    defaults();fill(240);rectangle(2,2,3,3,0);max_area=3;run_frame("above_max_keeps_raw_statistics",0,0);
    defaults();target_threshold=0;fill(1);src[2*W+2]=0;run_frame("threshold_zero",0,0);
    defaults();target_dark=0;target_threshold=255;fill(254);src[2*W+2]=255;run_frame("threshold_255",0,0);
    defaults();fill(0);roi_x_min=0;run_frame("invalid_roi_zero",0,0);
    defaults();roi_y_max=H-1;run_frame("invalid_roi_border",0,0);
    defaults();roi_x_min=5;roi_x_max=4;run_frame("invalid_roi_reversed_x",0,0);
    defaults();roi_y_min=5;roi_y_max=4;run_frame("invalid_roi_reversed_y",0,0);
    defaults();min_area=0;run_frame("invalid_area_zero",0,0);
    defaults();min_area=5;max_area=4;run_frame("invalid_area_reversed",0,0);
    defaults();max_area=INTERIOR+1;run_frame("invalid_area_too_large",0,0);
    defaults();fill(240);rectangle(2,2,5,4,20);run_frame("latched_configuration",1,1);
    defaults();partial_frame();
    defaults();fill(240);src[W+1]=0;run_frame("frame_start_aborts_partial",0,0);
    defaults();partial_frame();
    rst=1;in_valid=1;@(negedge clk);
    if(done!==0 || config_valid!==0 || target_valid!==0 || target_area!==0 || target_sum_x!==0 || target_sum_y!==0 ||
        bbox_x_min!==0 || bbox_y_min!==0 || bbox_x_max!==0 || bbox_y_max!==0)$fatal(1,"reset did not clear statistics");
    rst=0;
    repeat(N+2)begin @(negedge clk);if(done!==0 || target_area!==0)$fatal(1,"reset did not abort frame");end
    in_valid=0;
    defaults();fill(240);src[2*W+3]=0;run_frame("frame_after_reset",0,0);
    // Suppress the completion pending from an old frame with a new start.
    defaults();fill(240);begin_frame();
    for(k=0;k<N;k=k+1)begin in_valid=1;in_pixel=0;@(negedge clk);if(done!==0)$fatal(1,"early completion");end
    frame_start=1;in_valid=1;in_pixel=0;
    @(negedge clk);frame_start=0;in_valid=0;
    if(done!==0 || target_area!==0)$fatal(1,"new frame_start did not supersede pending completion");
    reference_model();finish_frame("new_start_cancels_pending_done",0,0);
    // Reset also takes priority over frame_start and pending completion.
    defaults();begin_frame();
    for(k=0;k<N;k=k+1)begin in_valid=1;in_pixel=0;@(negedge clk);end
    rst=1;frame_start=1;
    @(negedge clk);rst=0;frame_start=0;in_valid=0;
    if(done!==0 || config_valid!==0 || target_area!==0)$fatal(1,"reset priority or pending completion failure");
    repeat(3)begin @(negedge clk);if(done!==0)$fatal(1,"completion survived reset");end
    $display("PASS_TARGET_STATS frames=%0d ROI polarity/threshold/configuration/area/bbox/latching/abort/reset/done",frames);
    $finish;
  end
  initial begin #100000000;$fatal(1,"target_stats test timeout");end
endmodule
```

## sim/tb_target_transport.sv

```systemverilog
`timescale 1ns/1ps
module tb_target_transport;
  localparam W=4,H=2,CPB=4,MAX_N=72+W*H+2;
  reg clk=0,rst=1,start=0,mode=1;
  always #5 clk=~clk;
  reg [10:0] threshold;
  reg [31:0] frame_id,bc,sx,sy;
  reg target_enable,target_valid,target_dark,config_valid;
  reg [7:0] target_threshold;
  reg [15:0] roi_x_min,roi_y_min,roi_x_max,roi_y_max;
  reg [15:0] bbox_x_min,bbox_y_min,bbox_x_max,bbox_y_max;
  reg [31:0] target_area,target_sum_x,target_sum_y,min_area,max_area;
  wire [16:0] addr;
  reg [7:0] rd;
  wire busy,done,tx;
  reg [7:0] mem[0:W*H-1],received[0:MAX_N-1],expected[0:71];
  integer fd,i,f,header_bytes,total;
  reg [15:0] crc;
  frame_sender #(.W(W),.H(H),.CLKS_PER_BIT(CPB),.TARGET_PROTOCOL(1)) dut
    (.clk(clk),.rst(rst),.start(start),.edge_mode(mode),.threshold(threshold),
     .frame_id(frame_id),.bright_count(bc),.sum_x(sx),.sum_y(sy),
     .ram_addr(addr),.ram_data(rd),.busy(busy),.done(done),.uart_txd(tx),
     .target_enable(target_enable),.target_valid(target_valid),
     .target_dark(target_dark),.config_valid(config_valid),
     .target_threshold(target_threshold),.roi_x_min(roi_x_min),.roi_y_min(roi_y_min),
     .roi_x_max(roi_x_max),.roi_y_max(roi_y_max),.bbox_x_min(bbox_x_min),
     .bbox_y_min(bbox_y_min),.bbox_x_max(bbox_x_max),.bbox_y_max(bbox_y_max),
     .target_area(target_area),.target_sum_x(target_sum_x),.target_sum_y(target_sum_y),
     .min_area(min_area),.max_area(max_area));
  always @(posedge clk) rd<=mem[addr];

  function [15:0] update_crc(input [15:0] c,input [7:0] b);
    reg [15:0] v; integer k;
    begin v=c^{b,8'b0}; for(k=0;k<8;k=k+1) v=v[15]?(v<<1)^16'h1021:v<<1; update_crc=v; end
  endfunction
  task put_u16(input integer offset,input [15:0] value);
    begin expected[offset]=value[7:0];expected[offset+1]=value[15:8];end
  endtask
  task put_u32(input integer offset,input [31:0] value);
    integer k;
    begin for(k=0;k<4;k=k+1)expected[offset+k]=(value>>(8*k))&8'hff;end
  endtask
  task get_byte(output [7:0] b);
    integer k;
    begin
      @(negedge tx); #(CPB*10/2);
      if(tx!==0) $fatal(1,"bad start bit");
      for(k=0;k<8;k=k+1) begin #(CPB*10); b[k]=tx; end
      #(CPB*10); if(tx!==1) $fatal(1,"bad stop bit");
    end
  endtask
  task configure_frame(input integer frame);
    begin
      mode=frame[0];threshold=11'h5ab+frame;frame_id=32'h10203040+frame;
      bc=4;sx=10;sy=8;
      target_enable=1;target_valid=0;target_dark=1;config_valid=1;
      target_threshold=64;roi_x_min=1;roi_y_min=1;roi_x_max=W;roi_y_max=H;
      bbox_x_min=0;bbox_y_min=0;bbox_x_max=0;bbox_y_max=0;
      target_area=0;target_sum_x=0;target_sum_y=0;min_area=1;max_area=6;
      case(frame)
        0:begin // Valid dark target, in original sensor coordinates.
          target_valid=1;target_area=2;target_sum_x=3;target_sum_y=2;
          bbox_x_min=1;bbox_y_min=1;bbox_x_max=2;bbox_y_max=1;
        end
        1:begin // Valid bright configuration, with no matching target.
          target_dark=0;target_threshold=250;roi_x_min=2;
        end
        2:begin // Invalid configuration retains raw settings, zero statistics.
          config_valid=0;target_threshold=173;
          roi_x_min=16'h0102;roi_y_min=16'h0203;
          min_area=32'h00030004;max_area=32'h00020003;
        end
        3:begin // Geometry remains available when minimum-area filtering fails.
          target_threshold=96;target_area=1;target_sum_x=2;target_sum_y=1;
          bbox_x_min=2;bbox_y_min=1;bbox_x_max=2;bbox_y_max=1;min_area=2;
        end
        4:begin // Return to legacy format after four extended headers.
          target_enable=0;target_valid=1;target_area=2;target_sum_x=3;target_sum_y=2;
          bbox_x_min=1;bbox_y_min=1;bbox_x_max=2;bbox_y_max=1;
        end
        5:begin // Re-enable v2, preserving statistics above the maximum area.
          target_dark=0;target_threshold=128;target_area=8;target_sum_x=20;target_sum_y=12;
          bbox_x_min=1;bbox_y_min=1;bbox_x_max=W;bbox_y_max=H;
        end
      endcase
    end
  endtask
  task make_expected;
    integer k;
    begin
      for(k=0;k<72;k=k+1)expected[k]=0;
      expected[0]="F";expected[1]="P";expected[2]="G";expected[3]="1";
      expected[4]=target_enable?2:1;expected[5]=mode;
      put_u16(6,W);put_u16(8,H);put_u16(10,{5'b0,threshold});
      put_u32(12,frame_id);put_u32(16,W*H);put_u32(20,bc);put_u32(24,sx);put_u32(28,sy);
      expected[32]={5'b0,config_valid,target_dark,target_valid};expected[33]=target_threshold;
      put_u16(34,roi_x_min);put_u16(36,roi_y_min);put_u16(38,roi_x_max);put_u16(40,roi_y_max);
      put_u16(42,bbox_x_min);put_u16(44,bbox_y_min);put_u16(46,bbox_x_max);put_u16(48,bbox_y_max);
      put_u32(50,target_area);put_u32(54,target_sum_x);put_u32(58,target_sum_y);
      put_u32(62,min_area);put_u32(66,max_area);put_u16(70,0);
    end
  endtask
  task mutate_live_inputs;
    begin
      mode=~mode;threshold=0;frame_id=32'hdeadbeef;bc=0;sx=0;sy=0;
      target_enable=~target_enable;target_valid=~target_valid;
      target_dark=~target_dark;config_valid=~config_valid;target_threshold=~target_threshold;
      roi_x_min=~roi_x_min;roi_y_min=~roi_y_min;roi_x_max=~roi_x_max;roi_y_max=~roi_y_max;
      bbox_x_min=~bbox_x_min;bbox_y_min=~bbox_y_min;bbox_x_max=~bbox_x_max;bbox_y_max=~bbox_y_max;
      target_area=~target_area;target_sum_x=~target_sum_x;target_sum_y=~target_sum_y;
      min_area=~min_area;max_area=~max_area;
    end
  endtask
  initial begin
    fd=$fopen("target_wire.bin","wb");
    if(fd==0)$fatal(1,"cannot open target_wire.bin");
    for(i=0;i<W*H;i=i+1)mem[i]=i*31+5;
    repeat(5)@(negedge clk);rst=0;
    for(f=0;f<6;f=f+1)begin
      configure_frame(f);make_expected();
      header_bytes=(f==4)?32:72;total=header_bytes+W*H+2;
      @(negedge clk);start=1;
      @(negedge clk);start=0;mutate_live_inputs();
      for(i=0;i<total;i=i+1)begin get_byte(received[i]);$fwrite(fd,"%c",received[i]);end
      for(i=0;i<header_bytes;i=i+1)
        if(received[i]!==expected[i])
          $fatal(1,"target header frame %0d byte %0d got %h expected %h",f,i,received[i],expected[i]);
      for(i=0;i<W*H;i=i+1)
        if(received[header_bytes+i]!==mem[i])$fatal(1,"target frame %0d pixel %0d",f,i);
      crc=16'hffff;
      for(i=4;i<total-2;i=i+1)crc=update_crc(crc,received[i]);
      if({received[total-1],received[total-2]}!==crc)$fatal(1,"target frame %0d CRC",f);
      wait(done);@(negedge clk);
      if(busy)$fatal(1,"target busy after done");
    end
    $fclose(fd);
    $display("PASS target transport six frames: valid, absent, invalid config, area filters, v1/v2 transition; all metadata latched");
    $finish;
  end
  initial begin #1000000;$fatal(1,"target transport timeout");end
endmodule
```

## sim/tb_top.sv

```systemverilog
`timescale 1ns/1ps
module tb_top;
  reg clk=0;always #5 clk=~clk;
  reg btnC=1;reg[15:0]sw=1;
  tri1 scl,sda; tri cam_reset; reg pull_low=0;
  pullup(cam_reset); assign cam_reset=pull_low?1'b0:1'bz;wire tx,rclk,rrst,wen;wire[15:0]led;
  stream_top #(.W(16),.H(12),.UART_DIV(4),.START_DELAY(20),.CAM_RESET_CYCLES(10),.CAM_SETTLE_CYCLES(12))
    dut(.clk100(clk),.btnC(btnC),.sw(sw),.cam_data(8'b0),.cam_vsync(1'b1),.cam_href(1'b0),
    .cam_rst_n(cam_reset),.cam_sioc(scl),.cam_siod(sda),.cam_rclk(rclk),.cam_rrst_n(rrst),.cam_wen(wen),.uart_txd(tx),.led(led));
  initial begin
    repeat(5)@(negedge clk);btnC=0;
    wait(!dut.rst);
    if(cam_reset!==0)$fatal(1,"camera reset not asserted");
    wait(cam_reset===1); // External pullup must provide the high level.
    if(!dut.camera_config_rst)$fatal(1,"configuration starts before settling");
    @(negedge clk);pull_low=1;#1;
    if(cam_reset!==0)$fatal(1,"RST drives high instead of releasing");
    @(negedge clk);pull_low=0;
    wait(!dut.camera_config_rst);
    if(cam_reset!==1)$fatal(1,"reset did not release");
    wait(dut.tx_done);repeat(5)@(negedge clk);
    if(dut.frame_id!=1)$fatal(1,"first frame id");
    wait(dut.tx_done);repeat(5)@(negedge clk);
    if(dut.frame_id!=2)$fatal(1,"second frame id");
    btnC=1;repeat(25)@(negedge clk);
    if(cam_reset!==0 || !dut.camera_config_rst)$fatal(1,"button reset sequence");
    btnC=0;wait(!dut.camera_config_rst);
    if(cam_reset!==1)$fatal(1,"second reset release");
    $display("PASS top repeated synthetic acquisition processing transmission");$finish;
  end
  initial begin #5000000;$fatal(1,"top timeout");end
endmodule
```

## sim/tb_top_output.sv

```systemverilog
`timescale 1ns/1ps
// Complete top-level UART path, including the switches, output framebuffer,
// first-frame delay, and every runtime transition back to an image.
module tb_top_output #(parameter integer FAST_CYCLES=3);
  localparam integer W=9,H=6,OW=W-2,OH=H-2,N=OW*OH,CPB=4,MIN_AREA=4;
  localparam integer START_CYCLES=17,FRAME_CYCLES=29;
  reg clk=0;always #5 clk=~clk;
  reg btnC=1;reg[15:0]sw=16'h0001;
  tri1 scl,sda,cam_reset;
  wire tx,rclk,rrst,wen;wire[15:0]led;
  stream_top #(.W(W),.H(H),.UART_DIV(CPB),.START_DELAY(START_CYCLES),
    .FRAME_DELAY(FRAME_CYCLES),.FAST_FRAME_DELAY(FAST_CYCLES),.TARGET_MIN_AREA(MIN_AREA),
    .CAM_RESET_CYCLES(10),.CAM_SETTLE_CYCLES(12)) dut(
    .clk100(clk),.btnC(btnC),.sw(sw),.cam_data(8'b0),.cam_vsync(1'b1),.cam_href(1'b0),
    .cam_rst_n(cam_reset),.cam_sioc(scl),.cam_siod(sda),.cam_rclk(rclk),
    .cam_rrst_n(rrst),.cam_wen(wen),.uart_txd(tx),.led(led));

  reg[7:0]received[0:72+N+2-1];
  reg[7:0]frozen_framebuffer[0:N-1];
  reg[7:0]frozen_read_data;
  reg watching_features=0;
  integer writes[0:4],core_pixels[0:4];
  integer fd,f,i,j,k,header_bytes,payload_bytes,total,expected_byte,xx,yy;
  integer control_frame,cycle=0,wait_enter_cycle=0,launch_count=0,expected_delay;
  integer active_frame,reference_pixel,snapshot_index;
  integer ref_bright,ref_bright_x,ref_bright_y,ref_area,ref_x,ref_y;
  integer ref_x_min,ref_y_min,ref_x_max,ref_y_max;
  reg previous_rst=1,previous_fast=0;
  reg[2:0]previous_state=0;
  reg[15:0]crc;

  function[15:0] update_crc(input[15:0]c,input[7:0]b);
    reg[15:0]v;integer n;
    begin v=c^{b,8'b0};for(n=0;n<8;n=n+1)v=v[15]?(v<<1)^16'h1021:v<<1;update_crc=v;end
  endfunction
  function[31:0]u32(input integer offset);
    u32={received[offset+3],received[offset+2],received[offset+1],received[offset]};
  endfunction
  function[15:0]u16(input integer offset);
    u16={received[offset+1],received[offset]};
  endfunction
  // Independent, coordinate-based model of the synthetic source and Sobel.
  function integer source_y(input integer frame,x,y);
    reg inside_rect;
    begin
      inside_rect=(x>=W/4 && x<W/2 && y>=H/4 && y<3*H/4);
      if(frame==0)source_y=inside_rect?220:((x+y)%96);
      else if(frame==2 || frame==3)source_y=inside_rect?220:32;
      else source_y=inside_rect?32:220;
    end
  endfunction
  function integer image_y(input integer frame,x,y);
    integer gx,gy,mag;
    begin
      if(frame==0 || frame==3)image_y=source_y(frame,x,y);
      else begin
        gx=source_y(frame,x+1,y-1)+2*source_y(frame,x+1,y)+source_y(frame,x+1,y+1)
          -source_y(frame,x-1,y-1)-2*source_y(frame,x-1,y)-source_y(frame,x-1,y+1);
        gy=source_y(frame,x-1,y+1)+2*source_y(frame,x,y+1)+source_y(frame,x+1,y+1)
          -source_y(frame,x-1,y-1)-2*source_y(frame,x,y-1)-source_y(frame,x+1,y-1);
        mag=(gx<0?-gx:gx)+(gy<0?-gy:gy);
        image_y=(mag>=((frame==2)?960:160))?255:0;
      end
    end
  endfunction
  task build_reference(input integer frame);
    integer x,y,value;reg selected;
    begin
      ref_bright=0;ref_bright_x=0;ref_bright_y=0;
      ref_area=0;ref_x=0;ref_y=0;
      ref_x_min=0;ref_y_min=0;ref_x_max=0;ref_y_max=0;
      for(y=1;y<=OH;y=y+1)for(x=1;x<=OW;x=x+1)begin
        value=source_y(frame,x,y);
        if(value>=128)begin
          ref_bright=ref_bright+1;ref_bright_x=ref_bright_x+x;ref_bright_y=ref_bright_y+y;
        end
        selected=(frame==2 || frame==3)?(value>=96):(value<=96);
        if(frame!=0 && selected)begin
          if(ref_area==0)begin ref_x_min=x;ref_x_max=x;ref_y_min=y;ref_y_max=y;end
          else begin
            if(x<ref_x_min)ref_x_min=x;if(x>ref_x_max)ref_x_max=x;
            if(y<ref_y_min)ref_y_min=y;if(y>ref_y_max)ref_y_max=y;
          end
          ref_area=ref_area+1;ref_x=ref_x+x;ref_y=ref_y+y;
        end
      end
    end
  endtask
  task check_controls(input integer frame);
    begin
      if(dut.pattern_mode!==1'b1 || dut.edge_mode!==(frame==1 || frame==2 || frame==4) ||
         dut.target_enable!==(frame!=0) || dut.target_dark!==!(frame==2 || frame==3) ||
         dut.threshold!==((frame==2)?11'd960:11'd160) || dut.target_threshold!==8'd96 ||
         dut.packed_mode!==(frame==1) || dut.features_only!==(frame==2) ||
         dut.fast_frames!==(frame>=1 && frame<=3))
        $fatal(1,"top output controls changed inside frame %0d",frame);
    end
  endtask
  task get_byte(output[7:0]b);
    integer n;
    begin
      @(negedge tx);#(CPB*10/2);
      if(tx!==0)$fatal(1,"bad start bit");
      for(n=0;n<8;n=n+1)begin #(CPB*10);b[n]=tx;end
      #(CPB*10);if(tx!==1)$fatal(1,"bad stop bit");
    end
  endtask

  // Count from the first WAITING edge, so the LAUNCH edge follows N+1
  // clocks for a programmed delay of N (including the zero-delay case).
  always @(posedge clk)begin
    cycle=cycle+1;
    if(!dut.rst)begin
      if(previous_rst || (dut.state==0 && previous_state!=0))wait_enter_cycle=cycle;
      if(dut.state==1)begin
        expected_delay=(launch_count==0)?START_CYCLES:(previous_fast?FAST_CYCLES:FRAME_CYCLES);
        if(cycle-wait_enter_cycle!=expected_delay+1)
          $fatal(1,"top output wait mismatch frame %0d: %0d expected %0d",
            launch_count,cycle-wait_enter_cycle,expected_delay+1);
        if(dut.startup_complete!==(launch_count!=0))$fatal(1,"startup_complete timing");
        previous_fast=dut.fast_frames;launch_count=launch_count+1;
      end
      if(dut.features_only && (dut.framebuffer_write!==0 || dut.framebuffer_read!==0))
        $fatal(1,"results-only mode accessed output framebuffer");
      if(dut.core_valid)begin
        active_frame=dut.frame_id-1;
        if(active_frame<0 || active_frame>4)$fatal(1,"unexpected core output frame");
        core_pixels[active_frame]=core_pixels[active_frame]+1;
      end
      if(dut.framebuffer_write)begin
        active_frame=dut.frame_id-1;
        if(dut.core_addr!==writes[active_frame])
          $fatal(1,"top output framebuffer rewrite address frame %0d",active_frame);
        reference_pixel=image_y(active_frame,(writes[active_frame]%OW)+1,(writes[active_frame]/OW)+1);
        if(dut.core_pixel!==reference_pixel[7:0])
          $fatal(1,"top output framebuffer pixel frame %0d address %0d",active_frame,writes[active_frame]);
        writes[active_frame]=writes[active_frame]+1;
      end
      if(dut.tx_start)begin
        active_frame=dut.frame_id-1;
        if(core_pixels[active_frame]!=N || writes[active_frame]!=((active_frame==2)?0:N))
          $fatal(1,"top output incomplete processing or framebuffer frame %0d",active_frame);
      end
    end
    previous_rst=dut.rst;previous_state=dut.state;
  end

  // Observe the storage itself as well as its enables. This catches an
  // implementation that accidentally leaves the RAM always block ungated.
  // The preceding packed frame has distinct first/last pixels, so an illicit
  // read when the result sender resets its address changes read_data.
  always @(negedge clk)begin
    if(!dut.rst && dut.features_only)begin
      if(!watching_features)begin
        for(snapshot_index=0;snapshot_index<N;snapshot_index=snapshot_index+1)
          frozen_framebuffer[snapshot_index]=dut.framebuffer[snapshot_index];
        frozen_read_data=dut.read_data;watching_features=1;
        if(frozen_framebuffer[0]===frozen_framebuffer[N-1])
          $fatal(1,"features read-gating fixture needs distinct first/last pixels");
      end else begin
        if(dut.read_data!==frozen_read_data)$fatal(1,"results-only mode changed RAM read register");
        for(snapshot_index=0;snapshot_index<N;snapshot_index=snapshot_index+1)
          if(dut.framebuffer[snapshot_index]!==frozen_framebuffer[snapshot_index])
            $fatal(1,"results-only mode changed framebuffer address %0d",snapshot_index);
      end
    end else watching_features=0;
  end

  // Every requested next mode is changed during acquisition, long before
  // the current UART packet, and must take effect only at the next frame.
  initial begin
    for(control_frame=0;control_frame<5;control_frame=control_frame+1)begin
      @(posedge dut.pattern_active);@(negedge clk);check_controls(control_frame);
      repeat(200)@(negedge clk);
      case(control_frame)
        0:sw=16'h1407; // Packed Sobel, dark target, fast subsequent frames.
        1:sw=16'h1cff; // Results-only wins over packing; bright target, threshold 960.
        2:sw=16'h100d; // Recover a complete grayscale v2 image.
        3:sw=16'h5c07; // Diagnostic page ignores all three output requests.
        4:sw=16'h8001; // Stop a sixth frame after the five-frame wire fixture.
      endcase
      repeat(10)@(negedge clk);check_controls(control_frame);
      wait(!dut.pattern_active);
    end
  end

  initial begin
    for(k=0;k<5;k=k+1)begin writes[k]=0;core_pixels[k]=0;end
    fd=$fopen("top_output_wire.bin","wb");
    if(fd==0)$fatal(1,"cannot open top_output_wire.bin");
    repeat(5)@(negedge clk);btnC=0;
    for(f=0;f<5;f=f+1)begin
      for(i=0;i<32;i=i+1)begin get_byte(received[i]);$fwrite(fd,"%c",received[i]);end
      header_bytes=(f==0)?32:72;
      payload_bytes=(f==2)?0:((f==1)?((N+7)/8):N);
      total=header_bytes+payload_bytes+2;
      for(i=32;i<total;i=i+1)begin get_byte(received[i]);$fwrite(fd,"%c",received[i]);end
      build_reference(f);
      if(u32(0)!==32'h31475046 || received[4]!==((f==0)?8'd1:((f==1 || f==2)?8'd3:8'd2)) ||
         received[5]!==((f==1 || f==2 || f==4)?8'd1:8'd0) ||
         u16(6)!==OW || u16(8)!==OH || u16(10)!==((f==2)?16'd960:16'd160) ||
         u32(12)!==f+1 || u32(16)!==payload_bytes)
        $fatal(1,"top output base header frame %0d",f);
      if(u32(20)!==ref_bright || u32(24)!==ref_bright_x || u32(28)!==ref_bright_y)
        $fatal(1,"top output bright statistics frame %0d",f);
      if(header_bytes==72)begin
        if(received[32]!==((f==1 || f==4)?8'd7:8'd5) || received[33]!==8'd96 ||
           u16(34)!==16'd1 || u16(36)!==16'd1 || u16(38)!==OW || u16(40)!==OH ||
           u16(42)!==ref_x_min || u16(44)!==ref_y_min || u16(46)!==ref_x_max || u16(48)!==ref_y_max ||
           u32(50)!==ref_area || u32(54)!==ref_x || u32(58)!==ref_y ||
           u32(62)!==MIN_AREA || u32(66)!==(N/2) ||
           received[70]!==((f==1)?8'd5:((f==2)?8'd6:8'd0)) || received[71]!==8'd0)
          $fatal(1,"top output target extension frame %0d",f);
      end
      for(i=0;i<payload_bytes;i=i+1)begin
        expected_byte=0;
        if(f==1)begin
          for(j=0;j<8;j=j+1)if(i*8+j<N)begin
            xx=(i*8+j)%OW+1;yy=(i*8+j)/OW+1;
            if(image_y(f,xx,yy)!=0)expected_byte=expected_byte|(1<<j);
          end
        end else begin xx=i%OW+1;yy=i/OW+1;expected_byte=image_y(f,xx,yy);end
        if(received[header_bytes+i]!==expected_byte[7:0])
          $fatal(1,"top output payload frame %0d byte %0d: %0d expected %0d",
            f,i,received[header_bytes+i],expected_byte);
      end
      crc=16'hffff;
      for(i=4;i<total-2;i=i+1)crc=update_crc(crc,received[i]);
      if(u16(total-2)!==crc)$fatal(1,"top output CRC frame %0d",f);
      check_controls(f);
      wait(dut.tx_done);@(negedge clk);
    end
    if(launch_count!=5 || writes[2]!=0 || core_pixels[2]!=N)
      $fatal(1,"top output frame count/results processing");
    // The diagnostic frame disables fast mode for its next wait, even when
    // SW12 remains a diagnostic request at its own frame boundary.
    if(dut.frame_wait_cycles!==FRAME_CYCLES)$fatal(1,"diagnostic page changed frame delay");
    $fclose(fd);
    $display("PASS top output five UART frames: legacy, packed, results, v2 raw, diagnostic; latching, delays, framebuffer gating and rewrite");
    $finish;
  end
  initial begin #5000000;$fatal(1,"top output timeout");end
endmodule
```

## sim/tb_top_preview.sv

```systemverilog
`timescale 1ns/1ps
// Exercise the real UART path in three concurrent preview configurations.
module tb_top_preview;
  wire done0,done1,done3;
  preview_case #(.INTERVAL(0)) disabled(done0);
  preview_case #(.INTERVAL(1)) every_frame(done1);
  preview_case #(.INTERVAL(3),.RECORD(1)) periodic(done3);
  initial begin
    wait(done0 && done1 && done3);
    $display("PASS top preview intervals 0/1/3, cadence, pause, re-entry, diagnostics, mode/threshold/polarity changes, pixels, target statistics, RAM gating and UART CRC");
    $finish;
  end
  initial begin #10000000;$fatal(1,"preview timeout");end
endmodule

module preview_case #(parameter integer INTERVAL=3,RECORD=0)(output reg finished=0);
  localparam integer W=9,H=6,OW=W-2,OH=H-2,N=OW*OH,CPB=4,FRAMES=13;
  reg clk=0;always #5 clk=~clk;
  reg btn=1;reg[15:0]sw=16'h3805;
  tri1 scl,sda,cam_reset;
  wire tx,rclk,rrst,wen;wire[15:0]led;
  stream_top #(.W(W),.H(H),.UART_DIV(CPB),.START_DELAY(7),
    .FRAME_DELAY(5),.FAST_FRAME_DELAY(2),.TARGET_MIN_AREA(2),
    .CAM_RESET_CYCLES(5),.CAM_SETTLE_CYCLES(7),.PREVIEW_INTERVAL(INTERVAL)) dut(
    .clk100(clk),.btnC(btn),.sw(sw),.cam_data(8'b0),.cam_vsync(1'b1),.cam_href(1'b0),
    .cam_sioc(scl),.cam_siod(sda),.cam_rst_n(cam_reset),.cam_rclk(rclk),
    .cam_rrst_n(rrst),.cam_wen(wen),.uart_txd(tx),.led(led));
  reg[7:0]received[0:72+N+1];
  integer writes[0:FRAMES-1];
  integer f,i,j,k,fd,total,payload,version,transport,countdown=0;
  integer x,y,value,expected,area,sx,sy,bx0,by0,bx1,by1,bright,bsx,bsy;
  integer driver_frame;
  reg dark,edge_mode,packed_image,features,preview_enabled,refresh;
  reg[15:0]crc;
  function[15:0] settings(input integer frame);
    begin
      if(frame==4)settings=16'h1805;
      else if(frame==6)settings=16'h7805;
      else if(frame>=12)settings=16'h3c1f;
      else if(frame>=10)settings=16'h3c17;
      else if(frame>=8)settings=16'h3c07;
      else settings=16'h3805;
    end
  endfunction
  function integer source_y(input integer frame,xx,yy);
    reg inside_rect;
    begin
      inside_rect=(xx>=W/4 && xx<W/2 && yy>=H/4 && yy<3*H/4);
      source_y=inside_rect?((frame>=12)?220:32):((frame>=12)?32:220);
    end
  endfunction
  function integer image_y(input integer frame,xx,yy);
    integer gx,gy,mag,th;
    begin
      if(frame<8)image_y=source_y(frame,xx,yy);
      else begin
        gx=source_y(frame,xx+1,yy-1)+2*source_y(frame,xx+1,yy)+source_y(frame,xx+1,yy+1)
          -source_y(frame,xx-1,yy-1)-2*source_y(frame,xx-1,yy)-source_y(frame,xx-1,yy+1);
        gy=source_y(frame,xx-1,yy+1)+2*source_y(frame,xx,yy+1)+source_y(frame,xx+1,yy+1)
          -source_y(frame,xx-1,yy-1)-2*source_y(frame,xx,yy-1)-source_y(frame,xx+1,yy-1);
        mag=(gx<0?-gx:gx)+(gy<0?-gy:gy);th=(frame>=10)?64:160;
        image_y=(mag>=th)?255:0;
      end
    end
  endfunction
  function[31:0]u32(input integer off);
    u32={received[off+3],received[off+2],received[off+1],received[off]};
  endfunction
  function[15:0]u16(input integer off);
    u16={received[off+1],received[off]};
  endfunction
  function[15:0]update_crc(input[15:0]c,input[7:0]b);
    reg[15:0]v;integer n;
    begin v=c^{b,8'b0};for(n=0;n<8;n=n+1)v=v[15]?(v<<1)^16'h1021:v<<1;update_crc=v;end
  endfunction
  task get_byte(output[7:0]b);
    integer bit_index;
    begin
      @(negedge tx);#(CPB*10/2);
      if(tx!==0)$fatal(1,"preview UART start");
      for(bit_index=0;bit_index<8;bit_index=bit_index+1)begin #(CPB*10);b[bit_index]=tx;end
      #(CPB*10);if(tx!==1)$fatal(1,"preview UART stop");
    end
  endtask
  always @(posedge clk)if(!dut.rst)begin
    if(dut.features_only && (dut.framebuffer_write || dut.framebuffer_read))
      $fatal(1,"preview results accessed framebuffer");
    if(dut.framebuffer_write)begin
      if(dut.frame_id<1 || dut.frame_id>FRAMES)$fatal(1,"unexpected preview frame");
      if(dut.core_addr!==writes[dut.frame_id-1])$fatal(1,"preview RAM address");
      if(dut.core_pixel!==image_y(dut.frame_id-1,writes[dut.frame_id-1]%OW+1,writes[dut.frame_id-1]/OW+1))
        $fatal(1,"preview RAM pixel");
      writes[dut.frame_id-1]=writes[dut.frame_id-1]+1;
    end
  end
  // Pause during every acquisition: it must finish with its latched settings.
  initial begin
    for(driver_frame=0;driver_frame<FRAMES;driver_frame=driver_frame+1)begin
      @(posedge dut.pattern_active);repeat(20)@(negedge clk);
      sw=settings(driver_frame)|16'h8000;
      wait(dut.tx_done);@(negedge clk);wait(dut.state==0);
      repeat(30)@(negedge clk);
      if(dut.frame_id!==driver_frame+1)$fatal(1,"pause launched another frame");
      sw=(driver_frame+1<FRAMES)?settings(driver_frame+1):16'h8001;
    end
  end
  initial begin
    for(k=0;k<FRAMES;k=k+1)writes[k]=0;
    if(RECORD)begin fd=$fopen("top_preview_wire.bin","wb");if(!fd)$fatal(1,"preview recording");end
    repeat(5)@(negedge clk);btn=0;
    for(f=0;f<FRAMES;f=f+1)begin
      preview_enabled=(INTERVAL>0 && f!=4 && f!=6);
      refresh=(f==0 || f==5 || f==7 || f==8 || f==10 || f==12);
      if(!preview_enabled || refresh)countdown=0;
      features=(f!=6) && (!preview_enabled || countdown!=0);
      edge_mode=(f>=8);dark=(f<12);packed_image=edge_mode && !features;
      payload=features?0:(packed_image?(N+7)/8:N);
      version=(features || packed_image)?3:2;transport=features?6:(packed_image?5:0);
      total=72+payload+2;
      for(i=0;i<total;i=i+1)begin get_byte(received[i]);if(RECORD)$fwrite(fd,"%c",received[i]);end
      if(u32(0)!==32'h31475046 || received[4]!==version || received[5]!==edge_mode ||
         u16(6)!==OW || u16(8)!==OH || u16(10)!==((f>=10)?64:160) ||
         u32(12)!==f+1 || u32(16)!==payload || received[70]!==transport || received[71]!==0)
        $fatal(1,"preview header interval=%0d frame=%0d",INTERVAL,f);
      area=0;sx=0;sy=0;bright=0;bsx=0;bsy=0;bx0=0;by0=0;bx1=0;by1=0;
      for(y=1;y<=OH;y=y+1)for(x=1;x<=OW;x=x+1)begin
        value=source_y(f,x,y);
        if(value>=128)begin bright=bright+1;bsx=bsx+x;bsy=bsy+y;end
        if(dark?(value<=96):(value>=96))begin
          if(area==0)begin bx0=x;by0=y;bx1=x;by1=y;end
          if(x<bx0)bx0=x;if(x>bx1)bx1=x;if(y<by0)by0=y;if(y>by1)by1=y;
          area=area+1;sx=sx+x;sy=sy+y;
        end
      end
      if(u32(20)!==bright || u32(24)!==bsx || u32(28)!==bsy ||
         received[32]!==((dark)?7:5) || received[33]!==96 ||
         u16(34)!==1 || u16(36)!==1 || u16(38)!==OW || u16(40)!==OH ||
         u16(42)!==bx0 || u16(44)!==by0 || u16(46)!==bx1 || u16(48)!==by1 ||
         u32(50)!==area || u32(54)!==sx || u32(58)!==sy || u32(62)!==2 || u32(66)!==N/2)
        $fatal(1,"preview target statistics interval=%0d frame=%0d",INTERVAL,f);
      for(i=0;i<payload;i=i+1)begin
        expected=0;
        if(packed_image)begin
          for(j=0;j<8;j=j+1)if(i*8+j<N && image_y(f,(i*8+j)%OW+1,(i*8+j)/OW+1)!=0)expected=expected|(1<<j);
        end else expected=image_y(f,i%OW+1,i/OW+1);
        if(received[72+i]!==expected)$fatal(1,"preview UART pixel frame=%0d byte=%0d",f,i);
      end
      crc=16'hffff;for(i=4;i<total-2;i=i+1)crc=update_crc(crc,received[i]);
      if(u16(total-2)!==crc)$fatal(1,"preview CRC");
      if(writes[f]!==((features)?0:N))$fatal(1,"preview incomplete framebuffer");
      wait(dut.tx_done);@(negedge clk);
      if(preview_enabled)countdown=(countdown+1)%INTERVAL;
    end
    if(RECORD)$fclose(fd);
    finished=1;
  end
endmodule
```

## sim/tb_top_recovery.sv

```systemverilog
`timescale 1ns/1ps
// Drive the external SCCB, VSYNC and FIFO pins, then verify the real UART.
// Three complete packets: synthetic while the camera NACKs, followed by two
// distinct external frames after automatic recovery and two discarded captures.
module tb_top_recovery;
  localparam integer W=8,H=6,OW=W-2,OH=H-2,N=OW*OH,CPB=4;
  localparam integer RESET_CYCLES=5,SETTLE_CYCLES=7,RETRY_CYCLES=31;
  localparam integer FRAME_CYCLES=13,TIMEOUT_CYCLES=512;
  reg clk=0;always #5 clk=~clk;
  reg btnC=1;reg[15:0]sw=16'h0001;
  reg vsync=1,href=0;
  tri1 scl,sda,cam_reset;
  wire tx,rclk,rrst,wen;wire[15:0]led;
  reg[7:0]fifo_data=0;
  stream_top #(.W(W),.H(H),.UART_DIV(CPB),.START_DELAY(9),
    .FRAME_DELAY(FRAME_CYCLES),.CAM_RESET_CYCLES(RESET_CYCLES),
    .CAM_SETTLE_CYCLES(SETTLE_CYCLES),.CAM_RETRY_CYCLES(RETRY_CYCLES),
    .CAPTURE_TIMEOUT_CYCLES(TIMEOUT_CYCLES)) dut(
    .clk100(clk),.btnC(btnC),.sw(sw),.cam_data(fifo_data),.cam_vsync(vsync),.cam_href(href),
    .cam_rst_n(cam_reset),.cam_sioc(scl),.cam_siod(sda),.cam_rclk(rclk),
    .cam_rrst_n(rrst),.cam_wen(wen),.uart_txd(tx),.led(led));
  defparam dut.config_camera.QUARTER_CYCLES=2;
  defparam dut.config_camera.POWER_WAIT=3;
  defparam dut.config_camera.REG_WAIT=2;
  defparam dut.read_camera.QUARTER_CYCLES=2;
  defparam dut.capture_camera.FLUSH_CYCLES=3;

  // SCCB sink watches bus edges, including START/STOP. It only pulls the
  // ninth bit low; no sequencer state or internal ACK signal is overridden.
  reg camera_present=0,sink_ack=0,bus_active=0;
  integer bus_bit=0,bus_bytes=0,nack_transactions=0,ack_transactions=0;
  reg[7:0]bus_shift=0,bus_address=0;
  assign sda=sink_ack?1'b0:1'bz;
  always @(negedge sda)if(scl===1'b1)begin
    if(bus_active)$fatal(1,"unexpected SCCB START without STOP");
    bus_active=1;bus_bit=0;bus_bytes=0;bus_shift=0;bus_address=0;
  end
  always @(posedge scl)if(bus_active)begin
    if(bus_bit<8)begin
      bus_shift={bus_shift[6:0],sda};bus_bit=bus_bit+1;
      if(bus_bit==8)begin
        if(bus_bytes==0)bus_address=bus_shift;
        bus_bytes=bus_bytes+1;
      end
    end else bus_bit=9;
  end
  always @(negedge scl)begin
    if(bus_active && bus_bit==8)sink_ack=camera_present;
    else begin
      sink_ack=0;
      if(bus_bit==9)begin bus_bit=0;bus_shift=0;end
    end
  end
  always @(posedge sda)if(scl===1'b1 && bus_active)begin
    if(bus_address!==8'h42 && bus_address!==8'h43)
      $fatal(1,"bad SCCB device address %02x",bus_address);
    if(bus_address==8'h42 && bus_bytes==3)begin
      if(camera_present)ack_transactions=ack_transactions+1;
      else nack_transactions=nack_transactions+1;
    end
    bus_active=0;
  end

  // A camera writes UYVY bytes into a behavioral AL422 while WEN and HREF
  // are high. VSYNC drives its active-low write reset. RCLK independently
  // resets/advances the read pointer, presenting byte zero on its first edge.
  reg cam_pclk=0;reg[7:0]cam_write_data=0;
  reg[7:0]fifo_memory[0:W*H*2-1];
  integer write_pointer=0,read_pointer=0,fifo_written=0;
  always @(posedge cam_pclk or negedge vsync)begin
    if(!vsync)write_pointer=0;
    else if(wen && href)begin
      if(write_pointer>=W*H*2)$fatal(1,"camera wrote too many FIFO bytes");
      fifo_memory[write_pointer]=cam_write_data;
      write_pointer=write_pointer+1;fifo_written=fifo_written+1;
    end
  end
  always @(posedge rclk)begin
    if(!rrst)begin read_pointer=0;fifo_data<=0;end
    else begin
      fifo_data<=(read_pointer<W*H*2)?fifo_memory[read_pointer]:8'hde;
      read_pointer=read_pointer+1;
    end
  end

  integer cycle=0,last_error_cycle=-1,last_reset_cycle=0,last_release_cycle=0;
  integer retry_resets=0,capture_attempts=0,send_attempts=0,capture_sofs=0;
  integer capture_pixels=0,capture_frame_pixels=0,capture_completions=0;
  integer writes[0:5];
  reg previous_reset=0,previous_config_reset=1,previous_config_error=0;
  reg first_reset_released=0;
  integer monitor_expected,monitor_x,monitor_y;
  always @(negedge clk)begin
    cycle=cycle+1;
    if(!dut.rst)begin
      if(dut.config_error && !previous_config_error)begin
        if(scl!==1'b1 || sda!==1'b1 || bus_active)
          $fatal(1,"configuration failure published before SCCB STOP");
        last_error_cycle=cycle;
      end
      if(previous_reset && cam_reset===1'b0)begin
        if(last_error_cycle<0 || cycle-last_error_cycle!=RETRY_CYCLES)
          $fatal(1,"physical camera retry delay %0d expected %0d",
            cycle-last_error_cycle,RETRY_CYCLES);
        retry_resets=retry_resets+1;last_reset_cycle=cycle;
        if(dut.camera_fault!==1'b1)$fatal(1,"camera fault lost on retry reset");
      end
      if(!previous_reset && cam_reset===1'b1)begin
        if(first_reset_released && cycle-last_reset_cycle!=RESET_CYCLES)
          $fatal(1,"physical camera reset pulse width");
        first_reset_released=1;last_release_cycle=cycle;
      end
      if(previous_config_reset && !dut.camera_config_rst &&
          cycle-last_release_cycle!=SETTLE_CYCLES)
        $fatal(1,"configuration resumed before camera settling delay");
      if(last_error_cycle>=0 && cycle>last_error_cycle && !dut.config_done &&
          dut.camera_fault!==1'b1)
        $fatal(1,"camera fault indication disappeared during retry");
    end
    previous_reset=cam_reset;previous_config_reset=dut.camera_config_rst;
    previous_config_error=dut.config_error;
  end
  always @(posedge clk)if(!dut.rst)begin
    if(dut.capture_start)begin
      capture_attempts=capture_attempts+1;
      if(!dut.config_done || dut.sw_sync[15])$fatal(1,"capture started before ready or while paused");
    end
    if(dut.cap_sof)begin capture_sofs=capture_sofs+1;capture_frame_pixels=0;end
    if(dut.cap_valid)begin
      monitor_expected=source_y(dut.frame_id,capture_frame_pixels%W,capture_frame_pixels/W);
      if(dut.cap_pixel!==monitor_expected[7:0])
        $fatal(1,"FIFO luminance byte mismatch frame %0d pixel %0d",dut.frame_id,capture_frame_pixels);
      capture_pixels=capture_pixels+1;capture_frame_pixels=capture_frame_pixels+1;
    end
    if(dut.cap_done)begin
      capture_completions=capture_completions+1;
      if(capture_frame_pixels!=W*H)$fatal(1,"capture ended with missing luminance bytes");
    end
    if(dut.framebuffer_write)begin
      if(dut.frame_id!=1 && dut.frame_id!=4 && dut.frame_id!=5)
        $fatal(1,"failed capture wrote a framebuffer pixel");
      monitor_x=writes[dut.frame_id]%OW+1;monitor_y=writes[dut.frame_id]/OW+1;
      monitor_expected=source_y(dut.frame_id,monitor_x,monitor_y);
      if(dut.core_addr!==writes[dut.frame_id] || dut.core_pixel!==monitor_expected[7:0])
        $fatal(1,"framebuffer did not rewrite fresh pixels frame %0d address %0d",
          dut.frame_id,writes[dut.frame_id]);
      writes[dut.frame_id]=writes[dut.frame_id]+1;
    end
    if(dut.tx_start)begin
      send_attempts=send_attempts+1;
      if(writes[dut.frame_id]!=N)$fatal(1,"partial or failed image was sent");
    end
  end

  function integer source_y(input integer frame,x,y);
    begin
      case(frame)
        1:source_y=(x>=W/4 && x<W/2 && y>=H/4 && y<3*H/4)?220:((x+y)%96);
        4:source_y=((x+y)%3==0)?200+x:20+3*y+x;
        5:source_y=((2*x+y)%4==0)?240-y:60+x+y;
        default:source_y=-1;
      endcase
    end
  endfunction
  task camera_byte(input[7:0]value);
    begin @(negedge clk);cam_write_data=value;#2;cam_pclk=1;#2;cam_pclk=0;end
  endtask
  task supply_camera_frame(input integer expected_frame);
    integer x,y,value;
    begin
      wait(dut.capture_start);@(negedge clk);
      if(dut.frame_id!=expected_frame)$fatal(1,"wrong external capture frame id");
      vsync=0;href=0;repeat(6)@(negedge clk);vsync=1;
      wait(wen);@(negedge clk);
      if(dut.cap_error)$fatal(1,"new capture did not clear old timeout");
      for(y=0;y<H;y=y+1)begin
        href=1;
        for(x=0;x<W;x=x+1)begin
          camera_byte(8'h80+x+y);
          value=source_y(expected_frame,x,y);camera_byte(value[7:0]);
        end
        @(negedge clk);href=0;
      end
      if(write_pointer!=W*H*2)$fatal(1,"WEN/HREF gated camera write was incomplete");
      repeat(2)@(negedge clk);vsync=0;
      wait(!wen);@(negedge clk);sw=16'h8000;
      repeat(6)@(negedge clk);vsync=1;
    end
  endtask
  task check_paused(input integer attempts,frame);
    begin
      repeat(FRAME_CYCLES+40)@(negedge clk);
      if(capture_attempts!=attempts || dut.frame_id!=frame || dut.state!=0 ||
          dut.cap_busy || dut.tx_busy || wen || tx!==1'b1)
        $fatal(1,"pause did not hold the next acquisition at frame boundary");
    end
  endtask

  reg[7:0]received[0:32+N+2-1];
  reg[15:0]crc;
  integer fd,packet_count=0,packet,frame,i,k,expected_value,ref_count,ref_x,ref_y,x,y;
  function[15:0]update_crc(input[15:0]c,input[7:0]b);
    reg[15:0]v;integer bit_index;
    begin v=c^{b,8'b0};for(bit_index=0;bit_index<8;bit_index=bit_index+1)
      v=v[15]?(v<<1)^16'h1021:v<<1;update_crc=v;end
  endfunction
  function[31:0]u32(input integer offset);
    u32={received[offset+3],received[offset+2],received[offset+1],received[offset]};
  endfunction
  function[15:0]u16(input integer offset);
    u16={received[offset+1],received[offset]};
  endfunction
  task get_byte(output[7:0]b);
    integer bit_index;
    begin
      @(negedge tx);#(CPB*10/2);
      if(tx!==0)$fatal(1,"UART start bit");
      for(bit_index=0;bit_index<8;bit_index=bit_index+1)begin #(CPB*10);b[bit_index]=tx;end
      #(CPB*10);if(tx!==1)$fatal(1,"UART stop bit");
    end
  endtask
  initial begin
    for(k=0;k<6;k=k+1)writes[k]=0;
    for(k=0;k<W*H*2;k=k+1)fifo_memory[k]=8'hb7;
    fd=$fopen("top_recovery_wire.bin","wb");
    if(fd==0)$fatal(1,"cannot open top_recovery_wire.bin");
    for(packet=0;packet<3;packet=packet+1)begin
      frame=(packet==0)?1:packet+3;
      for(i=0;i<32+N+2;i=i+1)begin get_byte(received[i]);$fwrite(fd,"%c",received[i]);end
      if(u32(0)!==32'h31475046 || received[4]!==8'd1 || received[5]!==8'd0 ||
          u16(6)!==OW || u16(8)!==OH || u16(10)!==16'd160 ||
          u32(12)!==frame || u32(16)!==N)
        $fatal(1,"recovery UART header packet %0d",packet);
      ref_count=0;ref_x=0;ref_y=0;
      for(y=1;y<=OH;y=y+1)for(x=1;x<=OW;x=x+1)begin
        expected_value=source_y(frame,x,y);
        if(received[32+(y-1)*OW+x-1]!==expected_value[7:0])
          $fatal(1,"recovery UART stale/wrong pixel frame %0d x=%0d y=%0d",frame,x,y);
        if(expected_value>=128)begin ref_count=ref_count+1;ref_x=ref_x+x;ref_y=ref_y+y;end
      end
      if(u32(20)!==ref_count || u32(24)!==ref_x || u32(28)!==ref_y)
        $fatal(1,"recovery UART stale/wrong brightness statistics frame %0d",frame);
      crc=16'hffff;for(i=4;i<32+N;i=i+1)crc=update_crc(crc,received[i]);
      if(u16(32+N)!==crc)$fatal(1,"recovery UART CRC frame %0d",frame);
      packet_count=packet_count+1;
    end
    $fclose(fd);
  end

  initial begin
    repeat(5)@(negedge clk);btnC=0;
    wait(dut.pattern_active);repeat(200)@(negedge clk);sw=16'h8000;
    wait(packet_count==1);wait(dut.tx_done);@(negedge clk);
    if(nack_transactions<2 || retry_resets<2 || dut.config_done || capture_attempts!=0 ||
        dut.camera_fault!==1'b1 || led[15]!==1'b1)
      $fatal(1,"synthetic output did not survive repeated absent-camera NACK/retries");
    check_paused(0,1);
    // Reconnect only during physical reset; the complete register sequence
    // must succeed without touching the user reset button or internal state.
    @(negedge cam_reset);@(negedge clk);camera_present=1;
    if(dut.camera_fault!==1'b1 || led[15]!==1'b1)
      $fatal(1,"retry cleared the visible error before successful configuration");
    wait(dut.config_done);repeat(3)@(negedge clk);
    if(ack_transactions!=39 || dut.config_error || dut.camera_fault || led[15])
      $fatal(1,"camera did not recover all 39 configuration writes automatically");
    check_paused(0,1);

    // Missing blanking: no SOF, image write or UART packet may escape.
    sw=0;wait(dut.capture_start);wait(dut.cap_busy);
    wait(dut.cap_error);@(negedge clk);sw=16'h8000;
    if(dut.frame_id!=2 || capture_sofs!=0 || capture_pixels!=0 || send_attempts!=1 ||
        packet_count!=1 || wen || !rrst || led[15]!==1'b1)
      $fatal(1,"missing VSYNC blanking was not discarded cleanly");
    check_paused(1,2);

    // Missing end-of-frame: WEN was active but must be released on timeout.
    sw=0;wait(dut.capture_start);@(negedge clk);vsync=0;
    repeat(6)@(negedge clk);vsync=1;wait(wen);@(negedge clk);sw=16'h8000;
    wait(dut.cap_error);@(negedge clk);
    if(dut.frame_id!=3 || capture_sofs!=0 || capture_pixels!=0 || send_attempts!=1 ||
        packet_count!=1 || wen || !rrst || led[15]!==1'b1)
      $fatal(1,"missing frame end was not discarded cleanly");
    check_paused(2,3);

    // Two distinct complete external images prove recovery overwrites both
    // image memory and statistics, and pause/resume does not replay a frame.
    sw=0;supply_camera_frame(4);
    wait(packet_count==2);wait(dut.tx_done);@(negedge clk);
    if(dut.cap_error || led[15])$fatal(1,"capture error did not clear on recovery");
    check_paused(3,4);
    sw=0;supply_camera_frame(5);
    wait(packet_count==3);wait(dut.tx_done);@(negedge clk);check_paused(4,5);
    if(send_attempts!=3 || capture_sofs!=2 || capture_completions!=2 ||
        capture_pixels!=W*H*2 || fifo_written!=W*H*4 ||
        writes[1]!=N || writes[2]!=0 || writes[3]!=0 || writes[4]!=N || writes[5]!=N)
      $fatal(1,"recovery frame totals");
    $display("PASS top recovery three UART frames: synthetic during NACK, two fresh FIFO frames; timed reset retry, sticky fault, two discarded VSYNC timeouts, pause/resume, pixels/statistics/CRC");
    $display("INFO recovery physical retries=%0d NACK transactions=%0d ACK configuration writes=%0d capture attempts=%0d",
      retry_resets,nack_transactions,ack_transactions,capture_attempts);
    $finish;
  end
  initial begin #5000000;$fatal(1,"top recovery timeout");end
endmodule
```

## sim/tb_top_target.sv

```systemverilog
`timescale 1ns/1ps
module tb_top_target;
  localparam W=16,H=12,OW=W-2,OH=H-2,CPB=4;
  reg clk=0;always #5 clk=~clk;
  reg btnC=1;reg[15:0]sw=1;
  tri1 scl,sda,cam_reset;
  wire tx,rclk,rrst,wen;wire[15:0]led;
  stream_top #(.W(W),.H(H),.UART_DIV(CPB),.START_DELAY(20),
    .CAM_RESET_CYCLES(10),.CAM_SETTLE_CYCLES(12)) dut(
    .clk100(clk),.btnC(btnC),.sw(sw),.cam_data(8'b0),.cam_vsync(1'b1),.cam_href(1'b0),
    .cam_rst_n(cam_reset),.cam_sioc(scl),.cam_siod(sda),.cam_rclk(rclk),
    .cam_rrst_n(rrst),.cam_wen(wen),.uart_txd(tx),.led(led));
  reg[7:0]received[0:72+OW*OH+2-1];
  integer fd,f,i,header_bytes,total,expected_pixel,xx,yy;
  reg[15:0]crc;
  function[15:0] update_crc(input[15:0]c,input[7:0]b);
    reg[15:0]v;integer k;
    begin v=c^{b,8'b0};for(k=0;k<8;k=k+1)v=v[15]?(v<<1)^16'h1021:v<<1;update_crc=v;end
  endfunction
  function[31:0]u32(input integer offset);
    u32={received[offset+3],received[offset+2],received[offset+1],received[offset]};
  endfunction
  function[15:0]u16(input integer offset);
    u16={received[offset+1],received[offset]};
  endfunction
  function integer source_y(input integer frame,x,y);
    reg inside_rect;
    begin
      inside_rect=(x>=W/4 && x<W/2 && y>=H/4 && y<3*H/4);
      if(frame==1)source_y=inside_rect?32:220;
      else if(frame==2)source_y=inside_rect?220:32;
      else source_y=inside_rect?220:((x+y)%96);
    end
  endfunction
  function integer image_y(input integer frame,x,y);
    integer gx,gy,mag;
    begin
      if(frame!=2)image_y=source_y(frame,x,y);
      else begin
        gx=source_y(frame,x+1,y-1)+2*source_y(frame,x+1,y)+source_y(frame,x+1,y+1)
          -source_y(frame,x-1,y-1)-2*source_y(frame,x-1,y)-source_y(frame,x-1,y+1);
        gy=source_y(frame,x-1,y+1)+2*source_y(frame,x,y+1)+source_y(frame,x+1,y+1)
          -source_y(frame,x-1,y-1)-2*source_y(frame,x,y-1)-source_y(frame,x+1,y-1);
        mag=(gx<0?-gx:gx)+(gy<0?-gy:gy);
        image_y=(mag>=160)?255:0;
      end
    end
  endfunction
  task get_byte(output[7:0]b);
    integer k;
    begin
      @(negedge tx);#(CPB*10/2);
      if(tx!==0)$fatal(1,"bad start bit");
      for(k=0;k<8;k=k+1)begin #(CPB*10);b[k]=tx;end
      #(CPB*10);if(tx!==1)$fatal(1,"bad stop bit");
    end
  endtask
  initial begin
    fd=$fopen("top_target_wire.bin","wb");
    if(fd==0)$fatal(1,"cannot open top_target_wire.bin");
    repeat(5)@(negedge clk);btnC=0;
    for(f=0;f<4;f=f+1)begin
      for(i=0;i<32;i=i+1)begin get_byte(received[i]);$fwrite(fd,"%c",received[i]);end
      if(u32(0)!==32'h31475046 || u16(6)!=OW || u16(8)!=OH || u32(12)!=f+1)
        $fatal(1,"top base header frame %0d",f);
      if(received[4]!=((f==1 || f==2)?2:1) || received[5]!=(f==2))
        $fatal(1,"top frame-boundary mode/version %0d",f);
      header_bytes=(received[4]==2)?72:32;total=header_bytes+OW*OH+2;
      for(i=32;i<total;i=i+1)begin get_byte(received[i]);$fwrite(fd,"%c",received[i]);end
      if(u32(16)!=OW*OH || u16(10)!=160)$fatal(1,"top dimensions/threshold");
      if(u32(20)!=(f==1?116:24) || u32(24)!=(f==1?918:132) || u32(28)!=(f==1?638:132))
        $fatal(1,"top bright statistics frame %0d",f);
      if(header_bytes==72)begin
        if(received[32]!=(f==1?7:5) || received[33]!=(f==1?96:128))
          $fatal(1,"top target flags/latched threshold %0d",f);
        if(u16(34)!=1 || u16(36)!=1 || u16(38)!=14 || u16(40)!=10 ||
           u16(42)!=4 || u16(44)!=3 || u16(46)!=7 || u16(48)!=8 ||
           u32(50)!=24 || u32(54)!=132 || u32(58)!=132 || u32(62)!=16 || u32(66)!=70 || u16(70)!=0)
          $fatal(1,"top target statistics/config frame %0d",f);
      end
      for(i=0;i<OW*OH;i=i+1)begin
        xx=i%OW+1;yy=i/OW+1;expected_pixel=image_y(f,xx,yy);
        if(received[header_bytes+i]!==expected_pixel[7:0])
          $fatal(1,"top image mismatch frame %0d pixel %0d",f,i);
      end
      crc=16'hffff;
      for(i=4;i<total-2;i=i+1)crc=update_crc(crc,received[i]);
      if(u16(total-2)!==crc)$fatal(1,"top target CRC");
      wait(dut.tx_done);@(negedge clk);
      if(f==0)begin
        sw=16'h0005; // Enable dark-target localization for the next frame.
        wait(dut.pattern_active);repeat(200)@(negedge clk);
        sw=16'h020f; // Change to bright/Sobel/128 during acquisition.
        if(!dut.target_dark || dut.target_threshold!=96 || dut.edge_mode)
          $fatal(1,"switch changes leaked into active target frame");
      end
      if(f==2)sw=1; // Return to byte-for-byte legacy mode at the next boundary.
    end
    $fclose(fd);
    $display("PASS top target four UART frames: legacy, dark, bright/Sobel, legacy; switch latching and pixels");
    $finish;
  end
  initial begin #5000000;$fatal(1,"top target timeout");end
endmodule
```

## sim/tb_transport.sv

```systemverilog
`timescale 1ns/1ps
module tb_transport;
  localparam W=4,H=2,CPB=4,N=32+W*H+2;
  reg clk=0,rst=1,start=0,mode=1;
  always #5 clk=~clk;
  reg [10:0] threshold=180;
  reg [31:0] frame_id=7,bc=2,sx=7,sy=5;
  wire [16:0] addr;
  reg [7:0] rd;
  wire busy,done,tx;
  reg [7:0] mem[0:W*H-1],received[0:N-1];
  integer fd,i,f;
  reg [15:0] crc;
  frame_sender #(.W(W),.H(H),.CLKS_PER_BIT(CPB)) dut
    (.clk(clk),.rst(rst),.start(start),.edge_mode(mode),.threshold(threshold),
     .frame_id(frame_id),.bright_count(bc),.sum_x(sx),.sum_y(sy),
     .ram_addr(addr),.ram_data(rd),.busy(busy),.done(done),.uart_txd(tx));
  always @(posedge clk) rd<=mem[addr];
  function [15:0] update_crc(input [15:0] c,input [7:0] b);
    reg [15:0] v; integer k;
    begin v=c^{b,8'b0}; for(k=0;k<8;k=k+1) v=v[15]?(v<<1)^16'h1021:v<<1; update_crc=v; end
  endfunction
  task get_byte(output [7:0] b);
    integer k;
    begin
      @(negedge tx); #(CPB*10/2);
      if(tx!==0) $fatal(1,"bad start bit");
      for(k=0;k<8;k=k+1) begin #(CPB*10); b[k]=tx; end
      #(CPB*10); if(tx!==1) $fatal(1,"bad stop bit");
    end
  endtask
  initial begin
    fd=$fopen("wire.bin","wb");
    for(i=0;i<W*H;i=i+1) mem[i]=i*31+5;
    repeat(5) @(negedge clk); rst=0;
    for(f=0;f<2;f=f+1) begin
      frame_id=7+f; mode=(f==0); threshold=180+f;
      @(negedge clk); start=1;
      @(negedge clk); start=0;
      // Mutate live metadata: transmitted values must remain latched.
      frame_id=999; threshold=999; mode=~mode;
      for(i=0;i<N;i=i+1) begin get_byte(received[i]); $fwrite(fd,"%c",received[i]); end
      if({received[3],received[2],received[1],received[0]}!==32'h31475046) $fatal(1,"magic");
      if(received[4]!=1 || received[5]!=(f==0) || received[6]!=W || received[8]!=H) $fatal(1,"header dimensions/mode");
      if(received[10]!=180+f || received[12]!=7+f || received[16]!=W*H) $fatal(1,"latched header");
      if(received[20]!=2 || received[24]!=7 || received[28]!=5) $fatal(1,"statistics");
      for(i=0;i<W*H;i=i+1) if(received[32+i]!==mem[i]) $fatal(1,"pixel %0d got %0d",i,received[32+i]);
      crc=16'hffff;
      for(i=4;i<N-2;i=i+1) crc=update_crc(crc,received[i]);
      if({received[N-1],received[N-2]}!==crc) $fatal(1,"crc");
      wait(done); @(negedge clk);
      if(busy) $fatal(1,"busy after done");
    end
    $fclose(fd); $display("PASS transport two frames UART/header/payload/CRC/latching"); $finish;
  end
  initial begin #1000000; $fatal(1,"timeout"); end
endmodule
```

## sim/tb_vision_status.sv

```systemverilog
`timescale 1ns/1ps
module tb_vision_status;
  localparam integer CPB=4,N=58;
  reg clk=0;always #5 clk=~clk;
  reg rst=1,start=0;reg[7:0]flags=0;reg[383:0]snapshot=0;
  wire tx,busy;
  vision_status_tx #(.CLKS_PER_BIT(CPB)) dut(clk,rst,start,flags,snapshot,tx,busy);
  reg[7:0]bytes[0:N-1];reg[15:0]crc;integer fd,f,i,j,driver;
  function[15:0]update_crc(input[15:0]c,input[7:0]b);
    reg[15:0]v;integer n;
    begin v=c^{b,8'b0};for(n=0;n<8;n=n+1)v=v[15]?(v<<1)^16'h1021:v<<1;update_crc=v;end
  endfunction
  function[31:0]u32(input integer off);
    u32={bytes[off+3],bytes[off+2],bytes[off+1],bytes[off]};
  endfunction
  task get_byte(output[7:0]b);
    integer k;
    begin @(negedge tx);#(CPB*10/2);if(tx!==0)$fatal(1,"status UART start");
      for(k=0;k<8;k=k+1)begin #(CPB*10);b[k]=tx;end
      #(CPB*10);if(tx!==1)$fatal(1,"status UART stop");end
  endtask
  initial begin
    repeat(4)@(negedge clk);rst=0;
    for(driver=0;driver<2;driver=driver+1)begin
      for(j=0;j<12;j=j+1)snapshot[j*32+:32]=(driver+1)*100+j*17;
      flags=(driver==0)?9:2;start=1;@(negedge clk);start=0;
      snapshot={384{1'b1}};flags=15;
      wait(!busy);repeat(3)@(negedge clk);
    end
  end
  initial begin
    fd=$fopen("vision_status_wire.bin","wb");if(!fd)$fatal(1,"status wire export");
    for(f=0;f<2;f=f+1)begin
      for(i=0;i<N;i=i+1)begin get_byte(bytes[i]);$fwrite(fd,"%c",bytes[i]);end
      if(u32(0)!==32'h31545356 || bytes[4]!==1 || bytes[5]!==((f==0)?9:2) ||
         bytes[6]!==N || bytes[7]!==0)$fatal(1,"status header");
      for(i=0;i<12;i=i+1)if(u32(8+i*4)!==(f+1)*100+i*17)$fatal(1,"status snapshot latching");
      crc=16'hffff;for(i=4;i<N-2;i=i+1)crc=update_crc(crc,bytes[i]);
      if({bytes[N-1],bytes[N-2]}!==crc)$fatal(1,"status CRC");
    end
    $fclose(fd);wait(!busy);
    $display("PASS VST1 two status snapshots, UART, CRC and input latching");$finish;
  end
  initial begin #500000;$fatal(1,"status timeout");end
endmodule
```

## sim/tb_vision_top.sv

```systemverilog
`timescale 1ns/1ps
module tb_vision_top;
  wire a,b,c,d,e,f,g;
  vision_camera_case camera_case(a);
  vision_pattern_case #(.SCALE(1),.FILE_NAME("vision_scale1.txt")) full_size(b);
  vision_pattern_case #(.SCALE(4),.FILE_NAME("vision_scale4.txt")) thumbnail(c);
  vision_watchdog_case watchdog(d);
  vision_decimate_case #(.RATE(1)) every_two(e);
  vision_decimate_case #(.RATE(2)) every_four(f);
  vision_decimate_case #(.RATE(3)) every_eight(g);
  initial begin wait(a && b && c && d && e && f && g);
    $display("PASS standalone vision: absent PC/display, whole-frame drop, raw/enhanced, scales 1/2/4, real SCCB/FIFO, line rejection, VSYNC recovery, watchdog, pause/reset and counters");$finish;end
  initial begin #10000000;$fatal(1,"standalone vision timeout");end
endmodule
module vision_camera_case(output reg finished=0);
  localparam integer W=8,H=8,SCALE=2,DW=2,DH=2;
  reg clk=0;always #5 clk=~clk;
  reg btnC=1;reg[15:0]sw=16'h0047;
  reg vsync=1,href=0;reg[7:0]fifo_data=0;
  tri1 scl,sda,cam_reset;wire tx,rclk,rrst,wen;wire[15:0]led;
  reg display_ready=0;wire dv,sof,eol,eof,processed;wire[7:0]dp;wire[31:0]did;
  wire[31:0]frame_id,frames,shown,drops,skips,caperr,lineerr,inover,procerr,disperr,fps,latency;
  wire[15:0]width,height;
  vision_top #(.W(W),.H(H),.DISPLAY_SCALE(SCALE),.CLOCK_HZ(1024),.PATTERN_DIV(1),
    .START_DELAY(7),.FRAME_DELAY(13),.CAM_RESET_CYCLES(5),.CAM_SETTLE_CYCLES(7),
    .CAM_RETRY_CYCLES(31),.CAPTURE_TIMEOUT_CYCLES(2048),.PROCESS_TIMEOUT_CYCLES(10000),
    .CAMERA_READ_PERIOD(10),.CAMERA_FLUSH_CYCLES(3)) dut(
    clk,btnC,sw,fifo_data,vsync,href,scl,sda,cam_reset,rclk,rrst,wen,tx,led,
    display_ready,dv,dp,sof,eol,eof,did,processed,width,height,
    frame_id,frames,shown,drops,skips,caperr,lineerr,inover,procerr,disperr,fps,latency);
  defparam dut.camera.config_camera.QUARTER_CYCLES=2;
  defparam dut.camera.config_camera.POWER_WAIT=3;
  defparam dut.camera.config_camera.REG_WAIT=2;
  defparam dut.camera.read_camera.QUARTER_CYCLES=2;
  // SCCB sink watches bus edges, including START/STOP. It only pulls the
  // ninth bit low; no sequencer state or internal ACK signal is overridden.
  reg camera_present=0,sink_ack=0,bus_active=0;
  integer bus_bit=0,bus_bytes=0,nack_transactions=0,ack_transactions=0;
  reg[7:0]bus_shift=0,bus_address=0;
  assign sda=sink_ack?1'b0:1'bz;
  always @(negedge sda)if(scl===1'b1)begin
    if(bus_active)$fatal(1,"unexpected SCCB START without STOP");
    bus_active=1;bus_bit=0;bus_bytes=0;bus_shift=0;bus_address=0;
  end
  always @(posedge scl)if(bus_active)begin
    if(bus_bit<8)begin
      bus_shift={bus_shift[6:0],sda};bus_bit=bus_bit+1;
      if(bus_bit==8)begin
        if(bus_bytes==0)bus_address=bus_shift;
        bus_bytes=bus_bytes+1;
      end
    end else bus_bit=9;
  end
  always @(negedge scl)begin
    if(bus_active && bus_bit==8)sink_ack=camera_present;
    else begin
      sink_ack=0;
      if(bus_bit==9)begin bus_bit=0;bus_shift=0;end
    end
  end
  always @(posedge sda)if(scl===1'b1 && bus_active)begin
    if(bus_address!==8'h42 && bus_address!==8'h43)
      $fatal(1,"bad SCCB device address %02x",bus_address);
    if(bus_address==8'h42 && bus_bytes==3)begin
      if(camera_present)ack_transactions=ack_transactions+1;
      else nack_transactions=nack_transactions+1;
    end
    bus_active=0;
  end

  // A camera writes UYVY bytes into a behavioral AL422 while WEN and HREF
  // are high. VSYNC drives its active-low write reset. RCLK independently
  // resets/advances the read pointer, presenting byte zero on its first edge.
  reg cam_pclk=0;reg[7:0]cam_write_data=0;
  reg[7:0]fifo_memory[0:W*H*2-1];
  integer write_pointer=0,read_pointer=0,fifo_written=0;
  always @(posedge cam_pclk or negedge vsync)begin
    if(!vsync)write_pointer=0;
    else if(wen && href)begin
      if(write_pointer>=W*H*2)$fatal(1,"camera wrote too many FIFO bytes");
      fifo_memory[write_pointer]=cam_write_data;
      write_pointer=write_pointer+1;fifo_written=fifo_written+1;
    end
  end
  always @(posedge rclk)begin
    if(!rrst)begin read_pointer=0;fifo_data<=0;end
    else begin
      fifo_data<=(read_pointer<W*H*2)?fifo_memory[read_pointer]:8'hde;
      read_pointer=read_pointer+1;
    end
  end

  integer packets=0,index=0,expected_ids[0:3],fd,cycle=0,expected_processed;
  reg held=0;reg[43:0]held_data;reg run_display=0,saw_fps=0;
  always @(posedge clk)begin
    cycle=cycle+1;
    if(fps!=0)saw_fps=1;
    if(dut.rst)held=0;
    else begin
      if(tx!==1'b1)$fatal(1,"disabled optional PC interface transmitted");
      if(held && {did,processed,sof,eol,eof,dp}!==held_data)$fatal(1,"vision display changed under stall");
      held=dv && !display_ready;held_data={did,processed,sof,eol,eof,dp};
      if(dv && frames<did && did<=4)$fatal(1,"display exposed uncommitted processing frame");
      if(dv && display_ready)begin
        expected_processed=(did!=4);
        if(packets>=4 || did!==expected_ids[packets] || processed!==expected_processed ||
           sof!==(index==0) || eol!==(index%DW==DW-1) || eof!==(index==DW*DH-1))
          $fatal(1,"vision display ordering/raster frame=%0d index=%0d",did,index);
        $fdisplay(fd,"%0d %0d %0d %0d %0d",did,processed,2+(index%DW)*SCALE,2+(index/DW)*SCALE,dp);
        if(eof)begin packets=packets+1;index=0;end else index=index+1;
      end
    end
  end
  always @(negedge clk)if(run_display)display_ready=(cycle%3!=1);
  function[7:0]camera_y(input integer frame,x,y);
    camera_y=(x*19+y*23+frame*11)%256;
  endfunction
  task camera_byte(input[7:0]value);
    begin @(negedge clk);cam_write_data=value;cam_pclk=0;@(negedge clk);cam_pclk=1;end
  endtask
  task supply_frame(input integer frame,rows);
    integer x,y;
    begin
      wait(dut.capture_start);@(negedge clk);if(frame_id!=frame)$fatal(1,"camera attempt id");
      vsync=0;href=0;repeat(6)@(negedge clk);vsync=1;wait(wen);@(negedge clk);
      for(y=0;y<rows;y=y+1)begin
        href=1;
        for(x=0;x<W;x=x+1)begin camera_byte(8'h80);camera_byte(camera_y(frame,x,y));end
        @(negedge clk);href=0;repeat(3)@(negedge clk);
      end
      repeat(3)@(negedge clk);vsync=0;
      wait(!wen);@(negedge clk);sw=16'h8046;
      repeat(6)@(negedge clk);vsync=1;
    end
  endtask
  initial begin
    expected_ids[0]=1;expected_ids[1]=2;expected_ids[2]=4;expected_ids[3]=6;
    for(integer k=0;k<W*H*2;k=k+1)fifo_memory[k]=8'hb7;
    fd=$fopen("vision_camera.txt","w");if(!fd)$fatal(1,"vision export");$fdisplay(fd,"%0d %0d %0d",W,H,SCALE);
    repeat(5)@(negedge clk);btnC=0;
    wait(frame_id==3 && dut.pattern_active);@(negedge clk);sw=16'h8047;
    wait(frames==3);repeat(4)@(negedge clk);
    if(frame_id!=3 || drops!=1 || dut.display_queue.level!=2 || shown!=0 || !dut.camera.camera_fault)
      $fatal(1,"vision depended on absent PC/display or failed whole-frame drop");
    run_display=1;wait(packets==2);@(negedge clk);run_display=0;display_ready=0;
    sw=16'h0045;wait(frame_id==4 && dut.pattern_active);@(negedge clk);sw=16'h8047;
    wait(frames==4);run_display=1;wait(packets==3);@(negedge clk);run_display=0;display_ready=0;
    // Reconnect during physical reset, without any user reset button.
    @(negedge cam_reset);@(negedge clk);camera_present=1;
    wait(dut.config_done);repeat(5)@(negedge clk);
    if(ack_transactions!=39 || dut.camera_fault)$fatal(1,"vision camera configuration recovery");
    sw=16'h0046;supply_frame(5,H-1);wait(dut.state==0);repeat(4)@(negedge clk);
    if(lineerr!=1 || frames!=4 || dv)$fatal(1,"wrong camera line count was processed");
    sw=16'h0046;supply_frame(6,H);wait(frames==5);run_display=1;wait(packets==4);
    @(negedge clk);run_display=0;display_ready=0;
    sw=16'h0046;wait(dut.capture_start);@(negedge clk);sw=16'h8046;
    wait(caperr==1);repeat(5)@(negedge clk);
    if(frame_id!=7 || frames!=5 || lineerr!=1 || inover || procerr || disperr || !saw_fps || latency==0 || wen)
      $fatal(1,"vision recovery/monitor totals");
    repeat(20)@(negedge clk);if(frame_id!=7)$fatal(1,"vision pause started another frame");
    $fclose(fd);
    btnC=1;repeat(24)@(negedge clk);
    if(frame_id || frames || shown || drops || lineerr || caperr || dv || dut.display_queue.level)
      $fatal(1,"vision manual reset did not clear state");
    finished=1;
  end
endmodule
module vision_pattern_case #(parameter integer SCALE=1,parameter FILE_NAME="vision_scale1.txt")(output reg finished=0);
  reg clk=0;always #5 clk=~clk;
  reg btn=1;reg[15:0]sw=16'h0047;tri1 scl,sda,cr;
  wire dv,sof,eol,eof,view,tx;wire[7:0]pixel;wire[31:0]id,attempts,frames;
  wire[15:0]width,height;integer fd,index=0,packets=0;
  vision_top #(.W(8),.H(8),.DISPLAY_SCALE(SCALE),.PATTERN_DIV(1),.CLOCK_HZ(1024),
    .START_DELAY(3),.FRAME_DELAY(11),.CAM_RESET_CYCLES(5),.CAM_SETTLE_CYCLES(7)) dut(
    .clk100(clk),.btnC(btn),.sw(sw),.cam_data(8'b0),.cam_vsync(1'b1),.cam_href(1'b0),
    .cam_sioc(scl),.cam_siod(sda),.cam_rst_n(cr),.uart_txd(tx),.display_ready(1'b1),
    .display_valid(dv),.display_pixel(pixel),.display_sof(sof),.display_eol(eol),.display_eof(eof),
    .display_frame_id(id),.display_processed(view),.display_width(width),.display_height(height),
    .frame_id(attempts),.processed_frames(frames));
  always @(posedge clk)if(!dut.rst && dv)begin
    if(id!=packets+1 || !view || frames<id || sof!==(index==0) ||
       eol!==(index%width==width-1) || eof!==(index==width*height-1))$fatal(1,"vision scale raster/commit");
    $fdisplay(fd,"%0d %0d %0d %0d %0d",id,view,2+(index%width)*SCALE,2+(index/width)*SCALE,pixel);
    if(eof)begin packets=packets+1;index=0;end else index=index+1;
  end
  initial begin
    fd=$fopen(FILE_NAME,"w");if(!fd)$fatal(1,"scale export");$fdisplay(fd,"8 8 %0d",SCALE);
    repeat(4)@(negedge clk);btn=0;
    wait(attempts==3 && dut.pattern_active);@(negedge clk);sw=16'h8047;
    wait(packets==3);repeat(3)@(negedge clk);$fclose(fd);finished=1;
  end
endmodule
module vision_watchdog_case(output reg finished=0);
  reg clk=0;always #5 clk=~clk;
  reg btn=1;reg[15:0]sw=16'h0047;tri1 scl,sda,cr;
  wire dv;wire[31:0]errors,frames;
  vision_top #(.W(8),.H(8),.PATTERN_DIV(20),.CLOCK_HZ(1024),.START_DELAY(3),.FRAME_DELAY(17),
    .PROCESS_TIMEOUT_CYCLES(900),.CAM_RESET_CYCLES(5),.CAM_SETTLE_CYCLES(7)) dut(
    .clk100(clk),.btnC(btn),.sw(sw),.cam_data(8'b0),.cam_vsync(1'b1),.cam_href(1'b0),
    .cam_sioc(scl),.cam_siod(sda),.cam_rst_n(cr),.display_ready(1'b1),.display_valid(dv),
    .processing_errors(errors),.processed_frames(frames));
  always @(posedge clk)if(!dut.rst && dv)$fatal(1,"watchdog exposed partial frame");
  initial begin
    repeat(4)@(negedge clk);btn=0;wait(errors>=2);@(negedge clk);sw=16'h8047;
    repeat(30)@(negedge clk);
    if(frames || dut.display_queue.level || dut.processing_active || dut.state!=0)
      $fatal(1,"watchdog failed clean recovery");finished=1;
  end
endmodule

module vision_decimate_case #(parameter integer RATE=1)(output reg finished=0);
  localparam integer STRIDE=(1<<RATE),EXPECTED=(9+STRIDE-1)/STRIDE;
  reg clk=0;always #5 clk=~clk;
  reg btn=1;reg[15:0]sw=16'h0047|(RATE<<8);tri1 scl,sda,cr;
  wire dv,sof,eol,eof;wire[31:0]id,attempts,frames,shown,skipped,dropped;
  integer packets=0,index=0;
  vision_top #(.W(8),.H(8),.PATTERN_DIV(1),.CLOCK_HZ(1024),.START_DELAY(3),.FRAME_DELAY(11),
    .CAM_RESET_CYCLES(5),.CAM_SETTLE_CYCLES(7)) dut(
    .clk100(clk),.btnC(btn),.sw(sw),.cam_data(8'b0),.cam_vsync(1'b1),.cam_href(1'b0),
    .cam_sioc(scl),.cam_siod(sda),.cam_rst_n(cr),.display_ready(1'b1),.display_valid(dv),
    .display_sof(sof),.display_eol(eol),.display_eof(eof),.display_frame_id(id),
    .frame_id(attempts),.processed_frames(frames),.displayed_frames(shown),
    .display_skipped(skipped),.display_dropped(dropped));
  always @(posedge clk)if(!dut.rst && dv)begin
    if(id!=1+packets*STRIDE || sof!==(index==0) || eol!==(index%4==3) || eof!==(index==15))
      $fatal(1,"display decimation raster/cadence");
    if(eof)begin packets=packets+1;index=0;end else index=index+1;
  end
  initial begin
    repeat(4)@(negedge clk);btn=0;
    wait(attempts==9 && dut.pattern_active);@(negedge clk);sw=sw|16'h8000;
    wait(frames==9 && shown==EXPECTED);repeat(4)@(negedge clk);
    if(packets!=EXPECTED || skipped!=9-EXPECTED || dropped || attempts!=9)
      $fatal(1,"display decimation counters");finished=1;
  end
endmodule
```
