infr025t/fpga2026/fpga_plate_vision_v1_1/evidence/implementation/sources/clockInfo.txt

-------------------------------------
| Tool Version : Vivado v.2025.1
| Date         : Sun Nov  1 20:55:16 2026
| Host         : StrawberryBear
| Design       : design_1
| Device       : xc7a35t-cpg236-1--
-------------------------------------

For more information on clockInfo.txt clock routing debug file see https://support.xilinx.com/s/article/000035660?language=en_US
