infr025t/fpga2026/stream_video_edge_20fps/artifacts/consolidated_20261101/README.md

# 收敛后构建，自动硬件回归已通过

2026-11-01 Vivado 2025.1 全量构建及仿真通过；保留通用诊断。此 BIT 已临时下载到 RAM 测试，未写入 Flash；自动硬件回归通过，用户确认两种模式动态显示正常，进展及故障记录见[验证说明](../../docs/validation.md)。父目录保留历史已验证版本。

使用工程 program_lcd.ps1 -ArtifactDir <本目录绝对路径> 可临时下载到 RAM。验证前不要把旧版本的板测结论归给本文件。
