infr025t/fpga2026/stream_video_edge_20fps/docs/consolidation_20261101.md

# 持续优化基线收敛记录（2026-11-01）

基线：5dbf664；范围经用户确认。保留通用调试和保护，删除一次性实验；保持已验证的读取、算法与显示行为。本轮不是最终定版。

- [x] RTL：删除无消费者的旧顶层和旧单帧采集路径，保留屏幕测试图、内部图、串口与VIO；将有效时序修正注释到逻辑所属位置，清除无效状态。
- [x] 工具：统一源码清单、构建及硬件入口，删除重复/临时实验入口；构建输出不覆盖已上板验证的bit。
- [x] 文档：保留一个当前工程和demo；更新真实时序、诊断格式、接线、Flash启动及验证边界；历史版本用Git追溯。
- [x] 验证：VGA核心、相机跨环绕/暂停、串口及显示关键仿真；全量综合布局布线；独立静态审查及工具测试。

板上Flash保持原已验证程序；新构建不自动替换它。任何新硬件验收与旧版本证据分别记录。

## 逻辑收敛边界

活动RTL的非注释修改仅为：删除顶层永远为0的帧间gap、删除相机模块只写不读的initialized、将3位行bank使能的零常量明确为3位。其余活动RTL只补充功能/修复原因注释；XDC只修正文案，约束数值不变。算法系数、阈值、裁边、读钟、单次采样位置、FIFO行信用和屏幕总线时序保持原有定义。

独立WRST、有效行/帧资格判定、首字节计数、同拍消费信用、源帧排空以及末字完成计数本来已在各自状态机中实现，本轮明确其职责和修复原因，没有增加图像内容判断或复制像素补带机制。

保留通用快照/色条比较/串口概览、独立屏幕测试图、内部确定性图、首错锁存、统计监测和暂停恢复回归。删除的是旧单帧UART链路与一次性采样/构建/现场诊断入口。旧工程源码保存在Git父提交；未跟踪的旧缓存移至测试区 archived_lowrate_cache_20261101，demo保持不变。

工具修复包括：不支持的 --vga 测试台立即报错，防止运行错误测试；暂停测试禁止0轮通过并明确仅支持色条mode2；下载显式variant只检查匹配的LTX；构建产物与已测bit分开。

## 本轮验证结果

- 收敛前后VGA核心参考比较、连续相机三帧/环绕/暂停恢复通过。
- VGA串口实际12Mbaud波形、两包完整内容及头/负载CRC通过。
- 快速显示、源帧归属、模式接纳与统计停止仿真通过。
- 9项离线工具测试通过；包含Flash ID不匹配后的恢复与关闭连接，不代表新版Flash入口已实机测试。
- 完整Vivado 2025.1构建通过：WNS +0.664ns、WHS +0.028ns，3773 LUT、8877 FF、19 BRAM36等效、6 DSP；无DRC Error/Critical Warning。
- 保留既有project模式synth_ip提示、VIO无负载和开漏端口输入缓冲等工具警告，不宣称全日志无警告。
- 独立屏幕测试顶层综合通过，未重新布局布线或上板。

证据见[结构化结果](../reports/evidence/consolidation_20261101/result.json)。新BIT/LTX见[候选产物说明](../artifacts/consolidated_20261101/README.md)；收敛提交时尚未上板，后续复测进展见[验证记录](validation.md)。原Flash的断电重启与RAW/EDGE验收仍只对应原已测bit。本次源码作为下一阶段优化基线上传main，不代表最终成品。
