infr025t/fpga2026/demo/stream_image_demo/README_先读我.md

# 先读我：文档入口

项目首页见 **[README.md](README.md)**。新独立视觉核心见[架构与接口](docs/独立视觉架构.md)，原串口 Demo 操作见[使用手册](docs/使用手册.md)，构建与测试见[开发与验证](docs/开发与验证.md)。

随包的 `build/vivado/stream_top.bit` 为历史串口 Demo；原 Demo 使用当前功能需重新构建。新 `vision_top` 尚无板级 bit，显示硬件待定。验证范围以[项目首页](README.md)和[交付核验](交付核验.json)为准。

下列标题保留旧版章节入口，链接指向相应的新位置。

## 快速开始

[查看快速开始](README.md#快速开始)

### 先离线确认接收端

[查看先离线确认接收端](README.md#先离线确认接收端)

### 生成当前bit并上板

[查看生成当前bit并上板](README.md#生成当前bit并上板)

## 开关与模式

[查看开关与模式](docs/使用手册.md#开关与模式)

### 正常页：SW14=0

[查看正常页：SW14=0](docs/使用手册.md#正常页sw140)

### 常用组合

[查看常用组合](docs/使用手册.md#常用组合)

## PC输出

[查看PC输出](docs/使用手册.md#pc输出)

### 实时显示与退出

[查看实时显示与退出](docs/使用手册.md#实时显示与退出)

### 保存内容

[查看保存内容](docs/使用手册.md#保存内容)

## ROI与运行参数

[查看ROI与运行参数](docs/使用手册.md#roi与运行参数)

## 接线与成像

[查看接线与成像](docs/使用手册.md#接线与成像)

## 诊断与异常恢复

[查看诊断与异常恢复](docs/使用手册.md#诊断与异常恢复)

### LED诊断页：SW14=1

[查看LED诊断页：SW14=1](docs/使用手册.md#led诊断页sw141)

### 常见现象

[查看常见现象](docs/使用手册.md#常见现象)

## 开发与验证

[查看开发与验证](docs/开发与验证.md)

### 创建可编辑的Vivado工程

[查看创建可编辑的Vivado工程](docs/开发与验证.md#创建可编辑的vivado工程)

### 运行完整回归

[查看运行完整回归](docs/开发与验证.md#运行完整回归)

### 校验交付文件

[查看校验交付文件](docs/开发与验证.md#校验交付文件)

## 文件与文档索引

[查看文件与文档索引](README.md#文件与文档索引)
