infr025t/fpga2026/fpga_plate_vision_v1_1/evidence/release_checks/review.md

# 发布包独立工程审查

审查对象：`fpga_plate_vision_v1_0`，发布依据为已接受的 `engineering_03`。本次只读审查源码、脚本、文档与原始报告，并执行只读结构门禁；未访问板卡、COM、JTAG或Flash，未运行综合、实现或下载，未修改旧工程。本文是唯一审查输出。

## 结论

未发现阻断交付的核心实现或发布文件身份问题。代码、文档、确认程序、证据的四目录组织清晰。当前版本的主要成果——独立板端链路、视频与识别分开调度、实际ROI可视化及整数参考核验——具有对应证据。最终交付仍由主流程完成文档修订、链接检查及全包校验清单生成与复验；本审查不替代该最后一道门禁。

## 独立核查结果

- 实际执行 `project/scripts/check_engineering.py`：PASS，40个RTL模块、49项接受版本冻结记录、47个受保护源文件，无命名、清单覆盖、重复模块、驱动反向业务依赖或哈希错误。
- 另与原接受目录 `E:/FPGA_Test_Work/plate_recognition_engineering/build/engineering_03` 比较：49项冻结文件全部相符；发布BIT和LTX均与原件相符。BIT SHA256为 `8d2d8ed5c144a5d1618daad8c18fdd1ae9c5a99fb4e24623f98238f58167efae`。
- 活跃scripts/config/PC/sim的Python、PowerShell、Tcl和SV文本扫描未发现指向废弃工程的E:/C:绝对执行路径。原始证据中的旧路径用于来源身份，不要求改写。
- 构建使用中央RTL清单，冻结模型、约束、RTL和运行脚本；新冻结集合含53文件，包括工具链配置。入口拒绝覆盖已有构建输出，构建流程不执行硬件操作。正式发布目录已有BIT/LTX，正常构建入口不会覆盖它们。
- 工具代理保存的11项离线检查全部通过，包含带空格路径冻结、拒绝覆盖、无输入先于串口失败、61项PC测试及数学/协议不变核查；32个PowerShell文件语法检查通过。该部分为审阅既有检查证据，不冒充本审查重新执行全部测试。
- 当前原始报告支持WNS +0.029 ns、WHS +0.050 ns、15,593 LUT、18,895 FF、44.5 BRAM36等效及9 DSP；ROI模块64 LUT/62 FF，无BRAM/DSP。
- 原始10组摘要及metrics支持70字符、53,760像素和2,520分数全部一致；整串真值0/10，输出为2次 `1K38817`、8次 `GK38817`。文档已将此与历史对齐BD12345的100/100分开，未将参考一致性冒充整牌正确率。
- 源帧约22.51 fps、OCR约5.63 fps、采集至结果平均165.86 ms均来自FPGA时间戳；未以此宣称LCD光学刷新率。当前绿框不是置信度指示，RAM配置与未更新Flash的身份说明明确。

## 文档审查意见与处置

1. 系统报告中“文字、框坐标保持一致”容易被理解为同一采集帧绑定。RTL的ROI由 `seg_event` 发布，文字由后续 `result_event` 发布，两者各自在显示帧边界提交。建议改为“各自在一幅显示帧内保持稳定”，明确不保证文字、ROI和当前视频具有同一采集身份。主流程已安排文档修订。
2. 当前验证及资源页指向异常台账的约束/DRC解释需补齐或改为精确链接。原报告有13个带false-path的异步输入、8个相机数据partial-input-delay项及42项Warning；XDC明确23 ns外部到达是预算，未做示波器测量。它们不应被概括成无告警或板外时序已实测闭合。主流程已安排文档修订。
3. 当前10个完整组之外，原始summary另有1个不完整组、590 discarded bytes和1184 truncated bytes。按用户对主文重点的要求，主文保持“10个完整组”的准确限定，此细节保留原始证据并登记异常清单，不在主文展开；不得改写成整个传输无残片。

历史归一化生成输入仍有缺失；现有运行器使用并核验冻结向量，新增夹具是独立离线输入。工具检查记录已保留该边界，不将冻结向量回归等同于完整重建历史数据集。

## 审查范围边界

当前接收效果属于指定场景与用户确认的显示版本；前缀候选、摆放范围、独立泛化与历史相机电气异常仍在相应资料中保留。本轮整理未修改RTL、模型、数学或约束，也未通过重新综合或新板测扩大原接受范围。新路径仿真、离线回放、最终链接与全包checksums由主流程独立记录。
