infr025t/fpga2026/demo/stream_image_demo/docs/迭代记录_2026-10-17.md

# FPGA 图像处理 Demo 迭代记录

日期：2026-10-17。对象：Basys 3 + OV7670_FIFO，320×240输入、318×238输出。

## 本轮结论

现有默认尺寸的图像处理与协议已有完整实现。本轮优先处理能复现的可靠性问题，并补齐在新电脑运行验证和维持交付一致性的入口。采集分辨率、FPG1包格式及默认阈值保持原有配置。

原 `demo.zip` 保留为历史基线；本轮工作目录是 `demo/stream_image_demo/`，另提供独立迭代包。原交付核验与SHA256清单已保存到 `docs/history/`。

## 已完成的修改

| 位置 | 原问题 | 修改后的行为 |
|---|---|---|
| `rtl/stream_top.sv` 中的 `camera_monitor` | WR启动与同步后的HREF上升沿同周期时，清零分支吞掉首行 | 当周期的新行计入1；已有HREF高电平不会被当成新上升沿 |
| `sim/tb_camera_monitor.sv` | 原测试先开WR再等5周期，没有覆盖同时上升 | 增加刺激对齐检查、同时上升计1和已有高电平计0的回归 |
| `pc/receiver.py` | 仅检查PGM重名，孤立同名JSON可能被覆盖 | 同时检查两种文件，以独占方式创建，重复帧号继续使用后缀 |
| `pc/receiver.py` | 离线流以半帧结束时可能显示成功 | 真正EOF时检测完整帧头开头的残包，计入拒绝统计并以非零状态退出；串口超时不视为EOF |
| `pc/receiver.py` | 非正波特率交给底层依赖处理 | 参数解析时直接提示错误 |
| `pc/test_receiver.py` | 缺少完整尺寸、不完整文件尾与残留文件覆盖用例 | 增加318×238分块接收、重复保存、EOF和命令行测试 |
| `scripts/run_tests.py` | 固定原电脑的Vivado路径；先跑RTL导致PC测试也无法运行；覆盖旧日志 | 自动发现Vivado/Icarus，支持纯Python验证，每轮写独立目录，明确记录通过、失败与跳过 |
| `scripts/test_run_tests.py` | 缺少验证工具本身的失败路径检查 | 覆盖工具发现、零退出码Fatal、超时、日志保护、有效及无效线流的真实解码 |
| `scripts/check_delivery.py` | 改源码后汇总文档与哈希容易过期 | 同时检查文件哈希、新增/缺失交付文件和源码汇总；`--refresh`统一刷新 |

修改后的诊断计数不会改变摄像头采集控制或图像算法。预编译bit仍是旧版本，重新构建后才会包含该修复。

## 本轮验证

- 原交付清单67项哈希全部一致，确认从完整基线开始。
- PC接收器11项测试通过，验证工具12项测试通过，共23项。
- Icarus Verilog 13.0完成全部7组RTL回归：采集、摄像头配置、寄存器读回、诊断、图像处理、UART传输、顶层。320×240图像核心的12帧逐像素参考对比全部通过。
- 本轮UART仿真生成的两帧字节流经PC接收器解码和保存通过。
- 图像核心补测3×3最小尺寸和17×13奇数尺寸，各12帧逐像素与统计量对比通过。
- 新增诊断用例在旧RTL上准确触发首行漏计失败，在修复后的RTL上通过，确认回归能识别原问题。
- 交付检查工具已用临时副本验证：修改、缺失、新增文件及过期源码汇总均能被发现，本地测试缓存不会污染交付清单。
- 本轮没有重新执行Vivado综合、布局布线、生成bit或上板；也没有执行30分钟连续运行。

可保留的日志与测试输出统一放在 `evidence/regression_20261017/`；原 `build/verify_*` 和 `build/vivado/` 记录仍属于历史结果。

便携仿真工具来自[MSYS2官方Icarus包](https://packages.msys2.org/packages/mingw-w64-ucrt-x86_64-iverilog)，所有依赖包核对官方SHA256。工具来源与校验记录一并留档；运行环境放在本机临时目录，没有系统安装或修改PATH。源码功能仿真通过，不代表Vivado综合时序或实板电气行为已重新验证。

## 下一轮的优化优先级

| 优先级 | 工作 | 依据与验收方式 |
|---|---|---|
| 1 | ROI内单目标定位，输出存在标志、面积、包围框和中心；支持亮/暗目标选择 | 当前统计固定为Y≥128，白纸场景容易统计背景。用固定与移动深色目标验收：位置跟随、无目标明确无效 |
| 2 | 分开调度目标结果与图像预览；边缘图采用1 bit打包；让帧间等待可配置 | 当前图像发送阻塞下一帧；测处理fps、预览fps及端到端延迟，检查预览是否拖慢定位结果 |
| 3 | 补摄像头完整采集、三个等待阶段的超时恢复、按钮复位与帧间模式切换联测 | 现有顶层测试只走内部图，采集测试只覆盖其中一种卡住状态。用故障注入确认能返回等待并成功获取下一帧 |
| 4 | 为参数设置边界检查，将本轮最小尺寸用例纳入默认回归，再做并行读写与更高分辨率 | 顶层图案坐标固定9位、读时钟相位计数固定8位；参数越界会静默回绕。先明确支持范围，避免仅修改W/H后卡住 |

### 性能预算

当前每帧传输 `32 + 318×238 + 2 = 75,718` 字节。1 Mbps、8N1每字节10位，仅数据在线路上的时间为 **757.18 ms**，尚未包含字节间隙。默认每轮还额外等待 **500 ms**，FIFO读出约 **76.8 ms**；Sobel的计算与读出重叠。因此先提高算法时钟对PC刷新率帮助有限。

移除固定500 ms等待，可以减少每轮固定开销，但必须保留启动等待、帧同步和错误恢复。二值输出若按连续像素每8点打包，并假设沿用34字节头尾，单帧约 `ceil(75,684/8)+34 = 9,495` 字节，线路时间约 **94.95 ms**。这只是新协议的预算，本轮尚未实现或实测该功能。

历史实现报告中LUT约4.15%、BRAM约51%，说明输出整帧缓存比算法算力更值得关注。这些资源和时序数据来自原bit对应的旧报告，修改后的RTL仍需重新综合验证。

VGA升级还需要改变缓存调度：640×480 UYVY一帧614,400字节，大于当前外部FIFO的393,216字节。应先完成定位与输出调度，再设计读写重叠和输出压缩。

## 复现与维护

在项目根目录运行：

```text
python scripts/run_tests.py --python-only
python scripts/run_tests.py --vivado-bin "你的Vivado安装目录/bin"
python scripts/run_tests.py --simulator iverilog --iverilog-bin "你的Icarus安装目录/bin"
python scripts/check_delivery.py
```

`--python-only`未发现已保存的线流时会明确跳过交叉校验；若指定 `--wire PATH`，文件缺失或解码不到要求数量的帧都会失败。完整回归会使用本轮 `tb_transport` 生成的UART字节流再验证PC接收器。

本地测试输出默认写到 `build/regression/`，不覆盖旧日志。审阅修改后，用 `python scripts/check_delivery.py --refresh` 同步源码汇总和哈希。需留档的验证输出先放入 `evidence/`。生成或下载新bit之前，核对本轮测试、时序与硬件验收范围。
