infr025t/fpga2026/fpga_plate_vision_v1_1/docs/archive/engineering_plan.md

# 工程收敛实施计划

**目标：** 模块职责、目录命名、可复现验证和真实原始参考文档同时达标。

**规格：** [engineering_spec.md](engineering_spec.md)。使用独立目录，历史基线只读。按子任务实施并复核，用户已授权本轮整理，不重复要求确认。

## 任务与验收

- [x] 1. 建立目录迁移清单，按规格将原35份RTL（整理后39份）归类；统一源码/脚本/文档小写命名。创建`config/rtl_sources.txt`，`scripts/check_engineering.py`核验文件名、唯一模块名、源列表覆盖、文件存在性、驱动依赖方向、受保护算法哈希。旧目录证据不变。
- [x] 2. 从`rtl/top/lcd_top.sv`提取`rtl/drivers/camera/camera_startup.sv`和`rtl/debug/test_pattern_source.sv`。增加与基线逐周期对照仿真，覆盖上电、复位、色条选择、完整VGA、暂停期间已接纳帧的排空。不重写状态语义。
- [x] 3. 将`pc/observe_auto.py`中的帧分组、串口/文件采集、参考校验分到独立文件，命令行入口保留原参数和行为。旧12项观察器测试及全部协议/参考测试必须通过，保存wire回放结果与基线匹配。
- [x] 4. 修正构建、仿真、脚本的路径和源清单。默认新构建目录`build/engineering_02`，所有输出放`build`、`logs`、`reports`；不复制Vivado缓存。执行自主分割/CNN整链、人工模式切换、顶层抽取等价性与结构检查。
- [x] 5. 独立梳理历史异常与数据，按`docs/reference`不同主题撰写。为原始证据建立带SHA256和阶段的`evidence/index.json`。引用旧结果明确旧版本，不据叙述虚构复测结果。
- [x] 6. 整机综合布局布线，记录真实资源与裕量；允许沿用已有物理优化流程，不放宽约束。新BIT配置RAM测试100个完整识别结果（参考一致与实际正确率分别记录）；若画面变化则记录实际场景，不强报正确。保护旧Flash。
- [x] 7. 检查文档链接、数值和当前/历史措辞，独立复核代码及报告，修正具体问题。更新`readme.md`及`docs/reference/index.md`入口，输出剩余问题，不打包、不推送。

## 执行记录

- 目录决策：新整理版与原始历史目录分离；成本是增加约几十MB必要回放证据，收益是保留原BIT/日志绝对路径与重现依据。
- 模块边界决策：优先拆驱动/调度、采集/参考等真实接口；分割算法内部紧密耦合状态机作为一个算法工作单元保留，避免本轮引入新延迟或阈值。

- 用户已明确确认三个模式：SW4优先OCR，否则SW3选择EDGE/RAW。SW2保留；其余调试开关保留。
- 结构、模式、完整自主/人工链、LCD仿真均通过，PC61测试及100组历史wire逐项等价。构建01因缺少synth_ip失败，保留失败证据；恢复IP综合后构建02成功；100组当前K38817实拍全部计算一致、整串0/100，多余汉字/边框候选列为未解决。
