infr025t/fpga2026/demo/stream_image_demo/evidence/dynamic_comparison.png

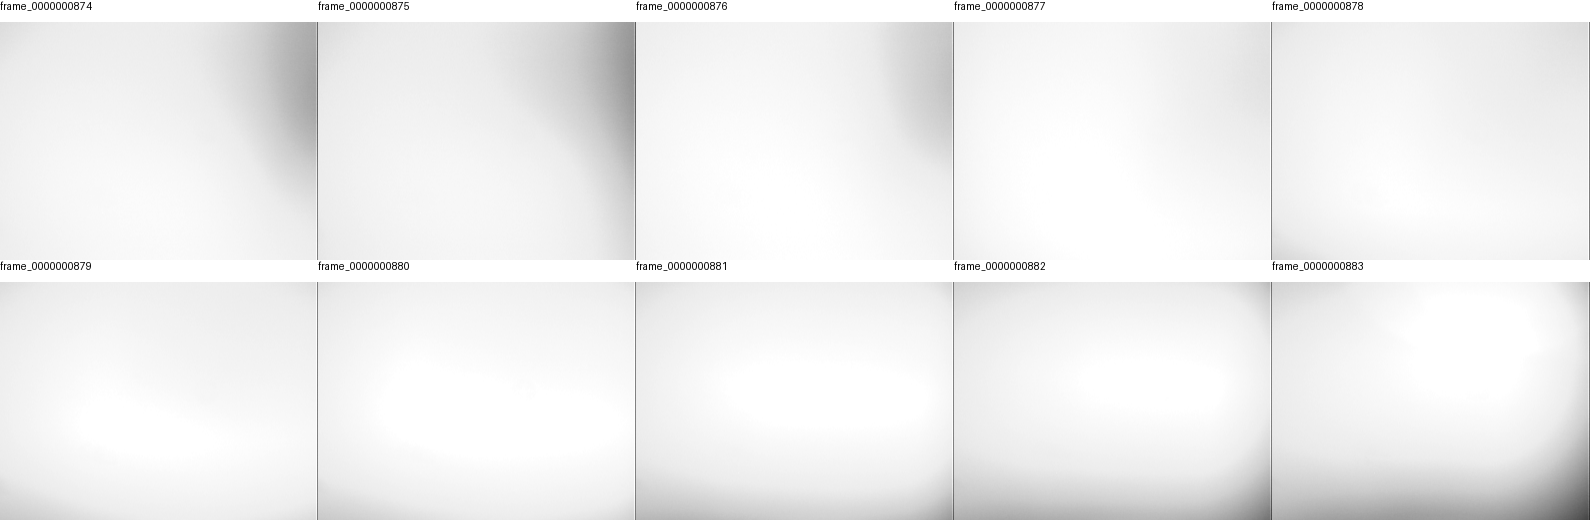
demo/stream_image_demo/evidence/dynamic_comparison.png
