infr025t/fpga2026/demo/stream_image_demo/evidence/focus_latest.png

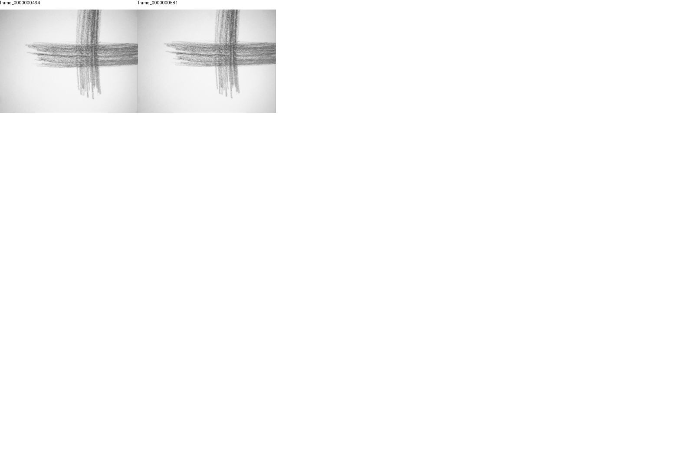
demo/stream_image_demo/evidence/focus_latest.png
