infr025t/fpga2026/demo/stream_image_demo/evidence/phase_contact.png

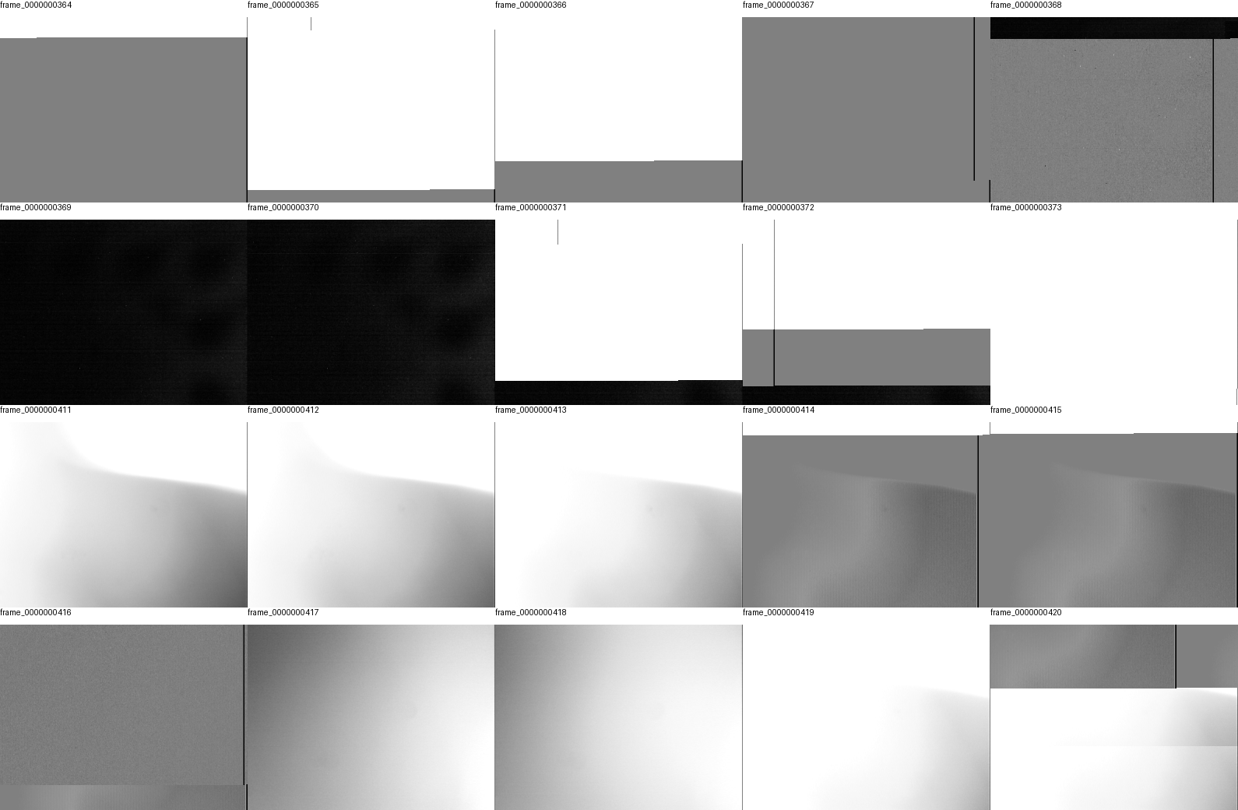
demo/stream_image_demo/evidence/phase_contact.png
