infr025t/fpga2026/fpga_plate_vision_v1_1/evidence/baseline/reports/camera_precheck.png

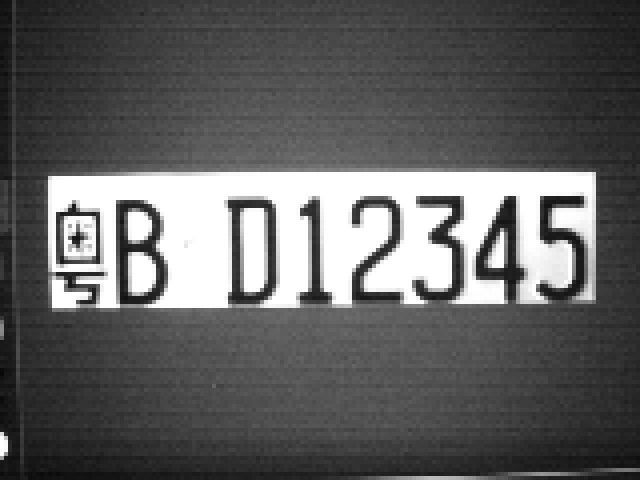
fpga_plate_vision_v1_1/evidence/baseline/reports/camera_precheck.png
