infr025t/fpga2026/fpga_plate_vision_v1_1/evidence/baseline/reports/current_binary_mask.png

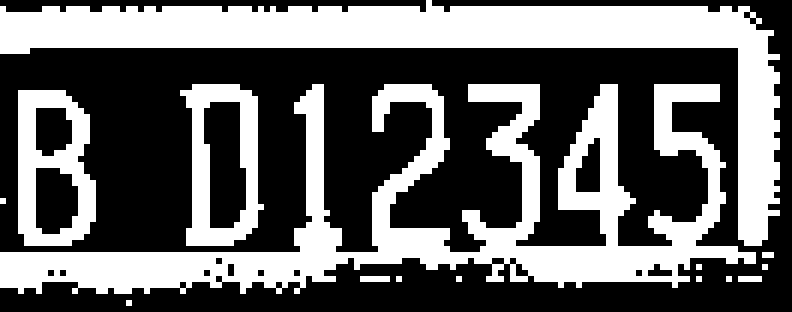
fpga_plate_vision_v1_1/evidence/baseline/reports/current_binary_mask.png
