infr025t/fpga2026/fpga_plate_vision_v1_1/evidence/baseline/reports/lcd_text_rtl/lcd_bus_preview.png

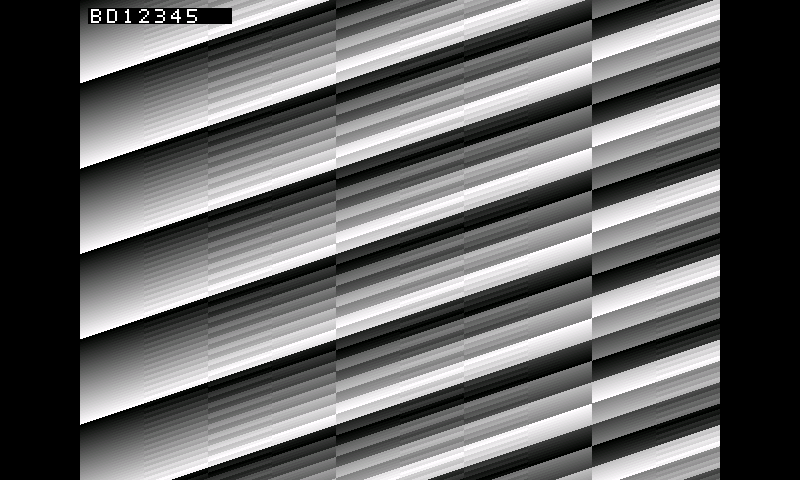
fpga_plate_vision_v1_1/evidence/baseline/reports/lcd_text_rtl/lcd_bus_preview.png
