infr025t/fpga2026/fpga_plate_vision_v1_1/evidence/baseline/reports/lcd_text_rtl/text_detail.png

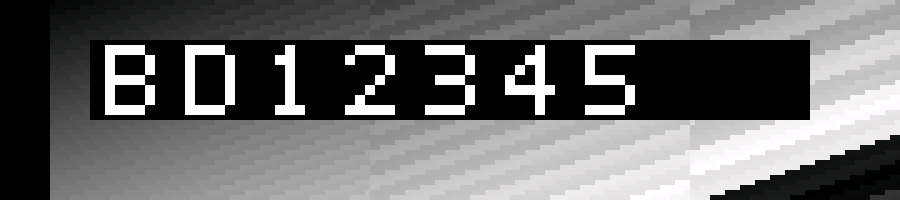
fpga_plate_vision_v1_1/evidence/baseline/reports/lcd_text_rtl/text_detail.png
