infr025t/fpga2026/fpga_plate_vision_v1_1/evidence/baseline/reports/locator_board_precheck/current.png

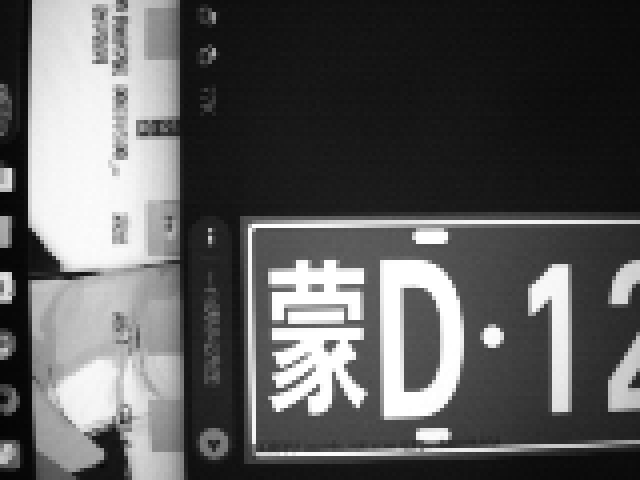
fpga_plate_vision_v1_1/evidence/baseline/reports/locator_board_precheck/current.png
