infr025t/fpga2026/fpga_plate_vision_v1_1/evidence/baseline/reports/osd_board_20/frames/e000_f0000000525/preview.png

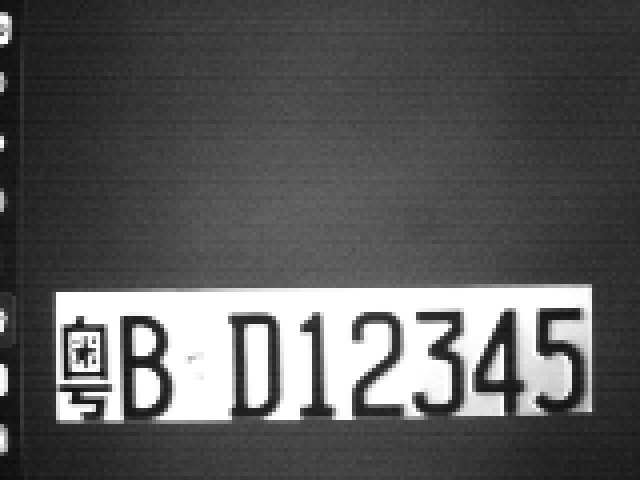
fpga_plate_vision_v1_1/evidence/baseline/reports/osd_board_20/frames/e000_f0000000525/preview.png
