infr025t/fpga2026/fpga_plate_vision_v1_1/evidence/baseline/reports/prefix_board_20/prefix_boxes_comparison.png

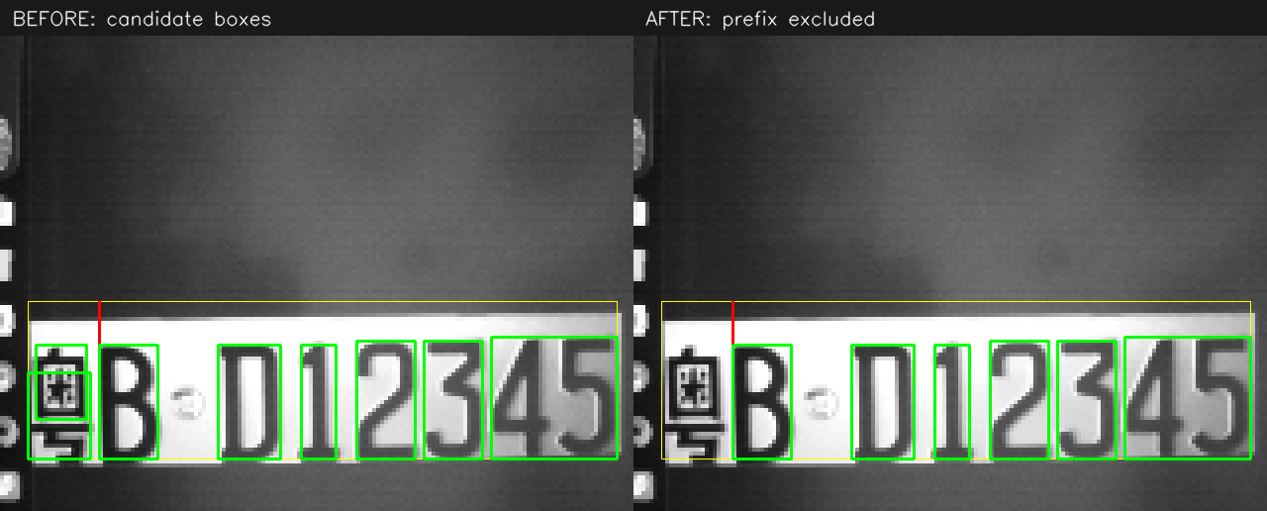
fpga_plate_vision_v1_1/evidence/baseline/reports/prefix_board_20/prefix_boxes_comparison.png
