infr025t/fpga2026/fpga_plate_vision_v1_1/evidence/baseline/reports/split_aligned_100/split_boxes_comparison.png

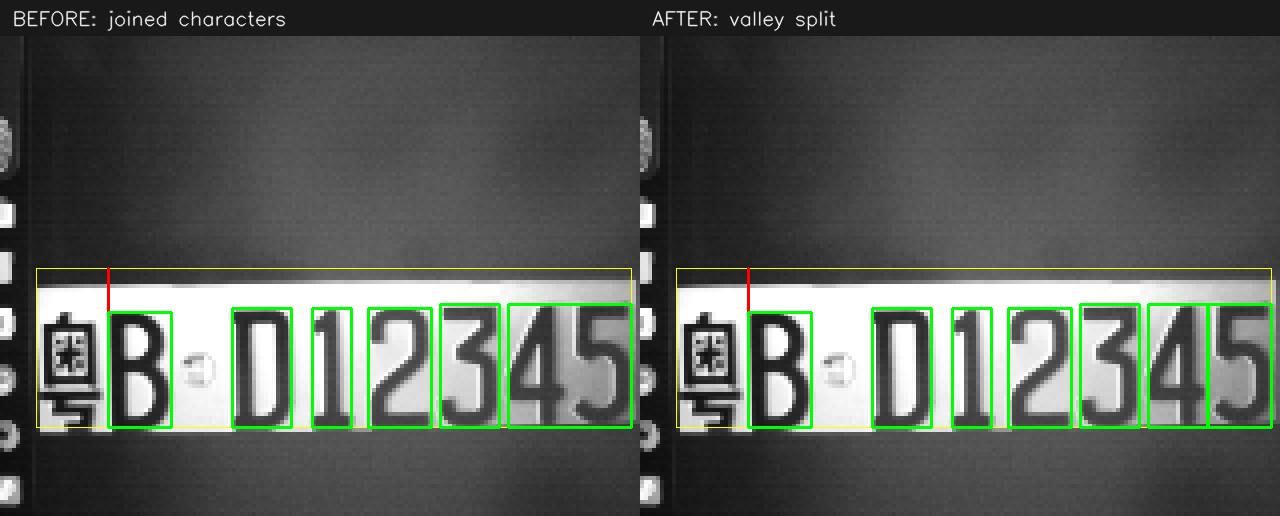
fpga_plate_vision_v1_1/evidence/baseline/reports/split_aligned_100/split_boxes_comparison.png
