infr025t/fpga2026/fpga_plate_vision_v1_1/evidence/baseline/reports/split_board_100/current_view.png

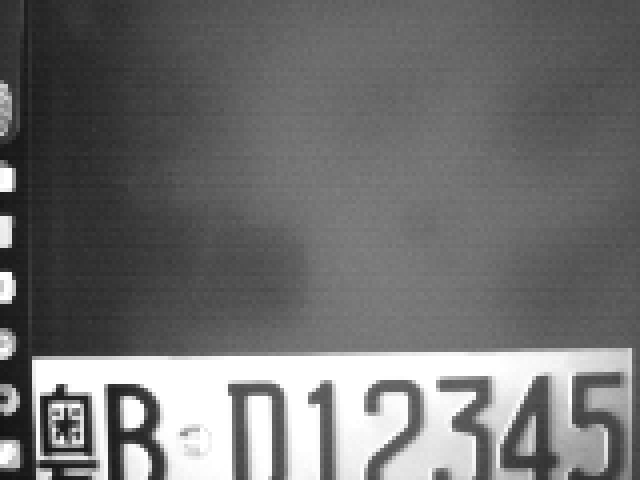
fpga_plate_vision_v1_1/evidence/baseline/reports/split_board_100/current_view.png
