infr025t/fpga2026/fpga_plate_vision_v1_1/evidence/baseline/reports/uart_pairs/auto_pair_regression/frames/seq_000007_src_00000238_other.png

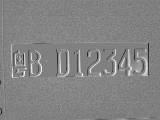
fpga_plate_vision_v1_1/evidence/baseline/reports/uart_pairs/auto_pair_regression/frames/seq_000007_src_00000238_other.png
