infr025t/fpga2026/fpga_plate_vision_v1_1/evidence/blue_polarity/before/preview.png

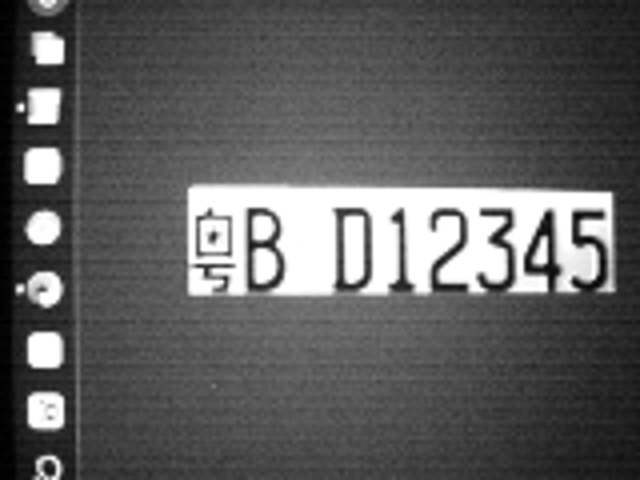
fpga_plate_vision_v1_1/evidence/blue_polarity/before/preview.png
