infr025t/fpga2026/fpga_plate_vision_v1_1/evidence/blue_polarity/blue_before/frames/e000_f0000022673/preview.png

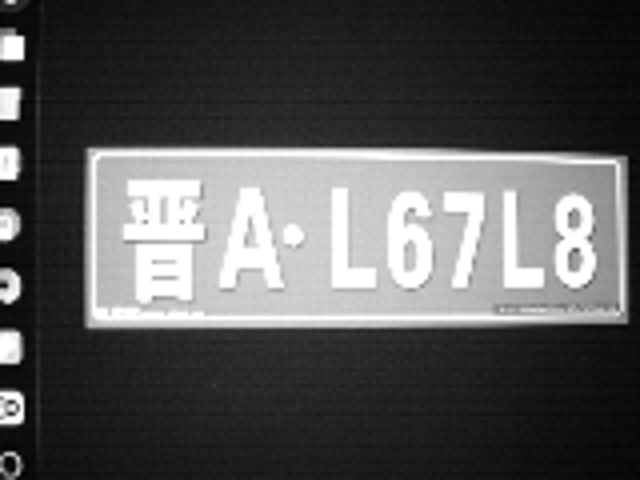
fpga_plate_vision_v1_1/evidence/blue_polarity/blue_before/frames/e000_f0000022673/preview.png
