infr025t/fpga2026/fpga_plate_vision_v1_1/project/sim/fixtures/scenes/d12345/seq_000001_src_00060320_selected.png

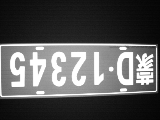
fpga_plate_vision_v1_1/project/sim/fixtures/scenes/d12345/seq_000001_src_00060320_selected.png
