infr025t/fpga2026/fpga_plate_vision_v1_1/project/sim/fixtures/scenes/ddn7870/seq_000001_src_00101133_selected.png

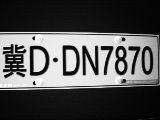
fpga_plate_vision_v1_1/project/sim/fixtures/scenes/ddn7870/seq_000001_src_00101133_selected.png
