infr025t/fpga2026/fpga_plate_vision_v1_1/project/sim/fixtures/scenes/k38817_v2/seq_000001_src_00092318_selected.png

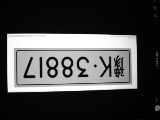
fpga_plate_vision_v1_1/project/sim/fixtures/scenes/k38817_v2/seq_000001_src_00092318_selected.png
