infr025t/fpga2026/stream_video_edge_20fps/reports/evidence/uart/rewire_scene02/lowest_contrast_ratio_pair.png

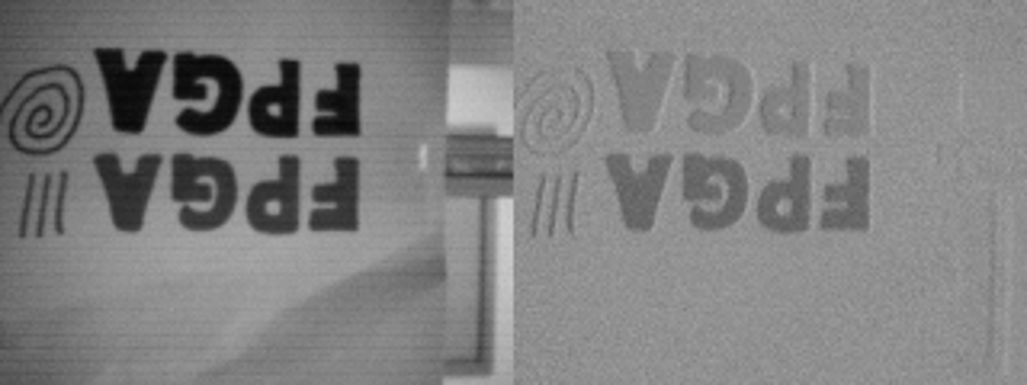
stream_video_edge_20fps/reports/evidence/uart/rewire_scene02/lowest_contrast_ratio_pair.png
