infr025t/fpga2026/stream_video_edge_20fps/reports/evidence/uart/rewire_scene02/sample_montage.png

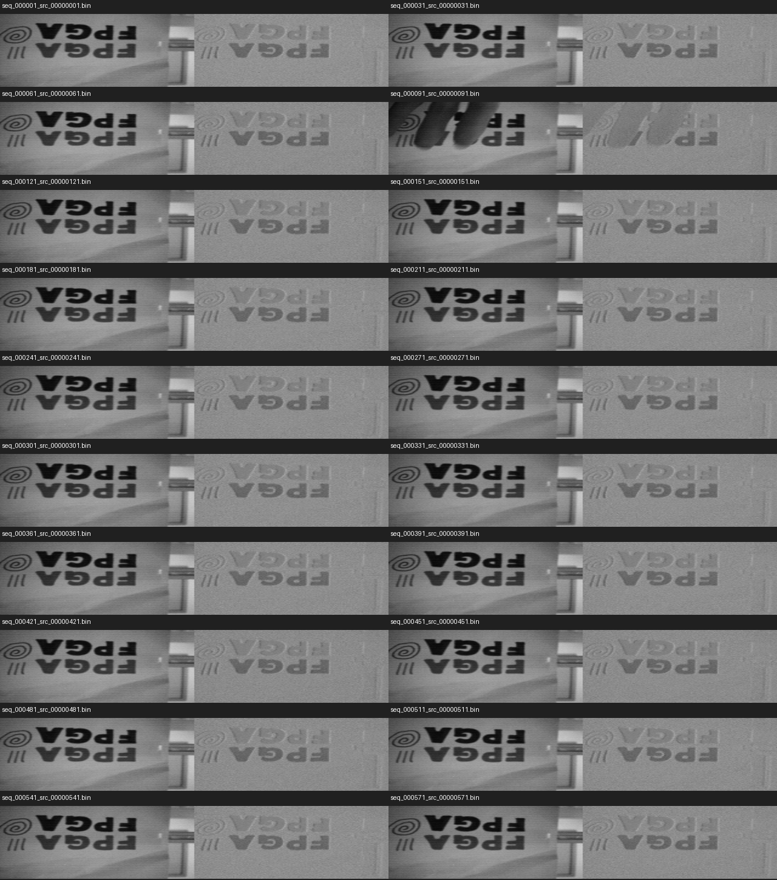
stream_video_edge_20fps/reports/evidence/uart/rewire_scene02/sample_montage.png
