infr025t/fpga2026/demo/stream_image_demo/evidence/regression_20261023_vision/full/verified_frames/metadata.csv

version | mode | width | height | threshold | frame_id | payload_length | bright_count | sum_x | sum_y | centroid_x | centroid_y | image_file | target_config_valid | target_valid | target_dark | target_threshold | target_roi_x_min | target_roi_y_min | target_roi_x_max | target_roi_y_max | target_area | target_sum_x | target_sum_y | target_min_area | target_max_area | target_bbox_x_min | target_bbox_y_min | target_bbox_x_max | target_bbox_y_max | target_centroid_x | target_centroid_y | pixel_format
1 | 1 | 4 | 2 | 180 | 7 | 8 | 2 | 7 | 5 | 3 | 2 | frame_0000000007.pgm |  |  |  |  |  |  |  |  |  |  |  |  |  |  |  |  |  |  |  | gray8
1 | 0 | 4 | 2 | 181 | 8 | 8 | 2 | 7 | 5 | 3 | 2 | frame_0000000008.pgm |  |  |  |  |  |  |  |  |  |  |  |  |  |  |  |  |  |  |  | gray8
