infr025t/fpga2026/demo/stream_image_demo/evidence/regression_20261023_vision/full/verified_output_transport/metadata.csv

version | mode | width | height | threshold | frame_id | payload_length | bright_count | sum_x | sum_y | centroid_x | centroid_y | image_file | target_config_valid | target_valid | target_dark | target_threshold | target_roi_x_min | target_roi_y_min | target_roi_x_max | target_roi_y_max | target_area | target_sum_x | target_sum_y | target_min_area | target_max_area | target_bbox_x_min | target_bbox_y_min | target_bbox_x_max | target_bbox_y_max | target_centroid_x | target_centroid_y | pixel_format
3 | 1 | 5 | 3 | 180 | 100 | 2 | 8 | 21 | 17 | 2 | 2 | frame_0000000100.pgm |  |  |  |  |  |  |  |  |  |  |  |  |  |  |  |  |  |  |  | mono1
3 | 1 | 5 | 3 | 181 | 101 | 2 | 8 | 21 | 17 | 2 | 2 | frame_0000000101.pgm | True | True | True | 64 | 1 | 1 | 5 | 3 | 4 | 10 | 6 | 1 | 15 | 2 | 1 | 3 | 2 | 2 | 1 | mono1
3 | 1 | 5 | 3 | 182 | 102 | 0 | 8 | 21 | 17 | 2 | 2 |  | True | True | True | 64 | 1 | 1 | 5 | 3 | 4 | 10 | 6 | 1 | 15 | 2 | 1 | 3 | 2 | 2 | 1 | none
3 | 0 | 5 | 3 | 183 | 103 | 0 | 8 | 21 | 17 | 2 | 2 |  | True | False | True | 64 | 1 | 1 | 5 | 3 | 0 | 0 | 0 | 1 | 15 |  |  |  |  |  |  | none
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
