infr025t/fpga2026/demo/stream_image_demo/evidence/regression_20261023_vision/full/verified_target_transport/metadata.csv

version | mode | width | height | threshold | frame_id | payload_length | bright_count | sum_x | sum_y | centroid_x | centroid_y | image_file | target_config_valid | target_valid | target_dark | target_threshold | target_roi_x_min | target_roi_y_min | target_roi_x_max | target_roi_y_max | target_area | target_sum_x | target_sum_y | target_min_area | target_max_area | target_bbox_x_min | target_bbox_y_min | target_bbox_x_max | target_bbox_y_max | target_centroid_x | target_centroid_y | pixel_format
2 | 0 | 4 | 2 | 1451 | 270544960 | 8 | 4 | 10 | 8 | 2 | 2 | frame_0270544960.pgm | True | True | True | 64 | 1 | 1 | 4 | 2 | 2 | 3 | 2 | 1 | 6 | 1 | 1 | 2 | 1 | 1 | 1 | gray8
2 | 1 | 4 | 2 | 1452 | 270544961 | 8 | 4 | 10 | 8 | 2 | 2 | frame_0270544961.pgm | True | False | False | 250 | 2 | 1 | 4 | 2 | 0 | 0 | 0 | 1 | 6 |  |  |  |  |  |  | gray8
2 | 0 | 4 | 2 | 1453 | 270544962 | 8 | 4 | 10 | 8 | 2 | 2 | frame_0270544962.pgm | False | False | True | 173 | 258 | 515 | 4 | 2 | 0 | 0 | 0 | 196612 | 131075 |  |  |  |  |  |  | gray8
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
