infr025t/fpga2026/demo/stream_image_demo/evidence/regression_20261023_vision/full/verified_top_preview/metadata.csv

version | mode | width | height | threshold | frame_id | payload_length | bright_count | sum_x | sum_y | centroid_x | centroid_y | image_file | target_config_valid | target_valid | target_dark | target_threshold | target_roi_x_min | target_roi_y_min | target_roi_x_max | target_roi_y_max | target_area | target_sum_x | target_sum_y | target_min_area | target_max_area | target_bbox_x_min | target_bbox_y_min | target_bbox_x_max | target_bbox_y_max | target_centroid_x | target_centroid_y | pixel_format
2 | 0 | 7 | 4 | 160 | 1 | 28 | 22 | 97 | 58 | 4 | 2 | frame_0000000001.pgm | True | True | True | 96 | 1 | 1 | 7 | 4 | 6 | 15 | 12 | 2 | 14 | 2 | 1 | 3 | 3 | 2 | 2 | gray8
3 | 0 | 7 | 4 | 160 | 2 | 0 | 22 | 97 | 58 | 4 | 2 |  | True | True | True | 96 | 1 | 1 | 7 | 4 | 6 | 15 | 12 | 2 | 14 | 2 | 1 | 3 | 3 | 2 | 2 | none
3 | 0 | 7 | 4 | 160 | 3 | 0 | 22 | 97 | 58 | 4 | 2 |  | True | True | True | 96 | 1 | 1 | 7 | 4 | 6 | 15 | 12 | 2 | 14 | 2 | 1 | 3 | 3 | 2 | 2 | none
2 | 0 | 7 | 4 | 160 | 4 | 28 | 22 | 97 | 58 | 4 | 2 | frame_0000000004.pgm | True | True | True | 96 | 1 | 1 | 7 | 4 | 6 | 15 | 12 | 2 | 14 | 2 | 1 | 3 | 3 | 2 | 2 | gray8
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
