infr025t/fpga2026/fpga_plate_vision_v1_1/evidence/validation/roi_tolerance_probe/review.md

# 独立审查记录

对照engineering_02冻结源，只审查ROI旁路改动。确认半开坐标×4、2px边框、LCD窗口+80偏移、无源图/CRC/CNN修改；中央源清单完整。

审查指出最近定位框与当前视频不严格同帧。文档保留此限制。另指出采集失败可能保留旧框，随后新增真实source_error红灯测试并将cap_abort转成无效ROI事件；独立复核通过。

新增边界测试覆盖invalid、超界、模式禁用/重入、reset与帧原子性。完整链核验真实ROI坐标及空帧清除。没有把显示反馈称为扩大定位能力。独立审查不访问硬件，硬件结果另行记录。
