infr025t/fpga2026/fpga_plate_vision_v1_1/evidence/history/plate_autonomous_board_20261101/docs/board_test_report.md

# 固定ROI字符分割上板验证报告

日期：2026-11-01。工程：`E:/FPGA_Test_Work/plate_segment_board_20261101`。

## 结果与范围

固定ROI内的字符分割已移至FPGA，并接通此前的归一化及整数CNN。新采100帧`DDN7870`均识别正确；700个字符框、537,600个归一化像素、25,200个CNN分数与参考一致。

真实识别请求的框只来自FPGA回包。PC仍传送原始160×120小图、指定固定ROI、调度逐字符请求，并把板上36类分数最大项映射为字符。软件参考只做事后核验，不替换硬件框。尚未实现自动全图车牌定位、相机直达识别存储、板上整牌调度或LCD文字显示，不能称为完全脱离PC的识别设备。

原有RAW/高斯+Sobel视频路径、相机时序及CNN核心/权重未改。归一化只增加共享RAM扫描口，数学规则不变。只在测试区工作、只下载配置RAM；Flash、正式工程及COM15未操作。测试后已恢复实体开关。

## 实现与存储

固定ROI → 15×15局部均值阈值（C=12）→ 8连通域 → 尺寸/同行/中位高度筛选 → x排序 → 原归一化 → 原CNN。

分割和归一化串行共用19,200 B灰度小图，分割期间禁止上传和归一化启动。新增二值mask及连通域队列；像素入队即清mask，保证每点只入队一次。最多64候选，超出明确报错，不静默截断，也不按预期字符数选框。

这是小图缓存上的顺序识别算法。初版局部均值逐邻域读取以控制逻辑复杂度，不能描述为无帧存储、每拍一像素的整牌识别流水线。独立视频路径仍流式运行。关键中文注释解释分bank、除法分拍、分组比较流水及所有权控制；没有降低100MHz时钟。

## 整机实现

硬件：Basys 3 XC7A35T-1（JTAG `210183BCBF83A`）、GYF-198 OV7670_FIFO、TK040F1510/NT35510 8位8080。Vivado2025.1；COM10，12Mbaud、8N1。

| 项目 | 布线后结果 |
|---|---:|
| LUT | 8429 / 20800，约40.5% |
| FF | 11640 / 41600，约28.0% |
| BRAM tile | 44.5 / 50，89% |
| DSP | 9 / 90 |
| WNS / TNS | +0.260ns / 0 |
| WHS / THS | +0.028ns / 0 |
| 无时钟、未约束内部端点 | 均为0 |

分割新增11个BRAM36：1个二值mask、10个2048×16队列bank。没有增加VGA整帧缓存。通用快照、测试图、串口和保护功能保留，尚有5.5个BRAM tile余量。最终DRC无Error/Critical Warning，保留41项普通Warning。沿用脚本的`synth_ip`工程模式提示仍见日志，最终IP及整机实现成功。

模块OOC采用明确的2ns外部输入预算，仅用于模块分析；本报告时序取自完整顶层真实路径，未用该预算替代整机证明。

BIT：`build_final/segment_board.bit`。SHA256：

- BIT：`45be6cd205df0f5c3d1db6341277620dc9419ae10974f7554687c266eb649280`
- 分割RTL：`593c65bf67afd98c64f71438be62be85dd63c891079316b8ced6bdc413fef2eb`
- 扫描口归一化RTL：`8916354963a35cd7f4bf7a441817855e91015ffcce0ce9168785d4b5f8c35c00`
- 未改CNN RTL：`ec91c6d2e28e0bc3c5fe673a46e7317fa155eaf5be90b2decfd5e40e2ca06ab4`
- 未改模型：`179d6d9b9a4e2229c152770152fe6c8d71ff924af5d9da06132debd730cf4645`

构建使用`build_final/sources`冻结副本。实现报告见同目录`timing.rpt`、`utilization.rpt`、`drc.rpt`、`check_timing.rpt`；实际下载见`logs/program_final.log`。

## 分层验证

软件：700张历史实拍、4300字符的二值图与框全部匹配旧PC方法，整牌700/700正确。真值仅评分、模型未重训；该结果不能外推为任意场景准确率。

RTL：36项主测试、7项独立补盲测试通过；25帧逐值检查228,817个阈值像素及全部框。覆盖空图、角落、单行/列、局部ROI边界、旋转/反相、64候选及溢出、19200点满队列压力、忙输入、复位、严格边界、中位数和稳定排序。共享RAM端口另逐地址核对19,200字节及写/启动互斥。

真实UART整链仿真：NFR→NSG→直接取FPGA回包框构造NCH→归一化→CNN。比较两组实拍的全部12框，并各取首框执行NCH，共2字符、1536像素、72分数、2464响应字节全通过，工作单元互斥与冻结源摘要检查通过。中间失败日志保留，不能替代冻结版本证据。

| 板上测试 | 结果 |
|---|---|
| 25组分割向量 | 全部框/状态匹配，包括空图、边界、65候选溢出及非法ROI |
| 5项协议保护 | 缺帧、旧ID、坏CRC、半包超时及恢复通过 |
| 50张历史回放 | 310字符；框/像素/分数全匹配，整牌50/50 |
| 100张新实拍 | 700字符；框/像素/分数全匹配，整牌100/100 |

两批整牌板测合计1010字符、775,680归一化像素、36,360分数，0不一致。25组分割向量只核验分割，不计入CNN合计。

原图、FPGA框、描述符、原始像素和分数均落盘。离线复核要求每框恰好对应一条字符记录，帧号/描述符一致，并重算所有分割和数值。独立审阅发现的漏字符仍PASS漏洞已修复：缺失反例被拒绝，完整正例通过。

## 耗时与视频检查

新实拍ROI `[26,35,158,87)`，132×52像素：

- 分割4,847,173～4,847,817周期，即48.472～48.478ms/帧。
- 归一化90,054～145,768周期，即0.901～1.458ms/字符。
- CNN固定942,444周期，即9.42444ms/字符。
- 七字符整牌各阶段计算周期相加平均122.30ms，不含协议空隙，不能声称20fps识别。
- PC验证100帧约30.01秒，约3.33帧/秒，包括传图、逐字符调度和参考核验，不是板上极限吞吐。
- 新图采集100帧及恢复实体开关后20帧，源帧率中位数约22.50777fps，CRC错误、诊断丢帧和源帧号缺口均0。

视频结果来自UART采集，本轮没有新增人工LCD外观/运动验收。已知频闪暗纹、斜刷新边界及VIO字段读回偶发错位未在本轮宣称修复；数值验收使用含CRC与序号的UART响应。

## 证据与下一步

- `reports/segmentation_reference/`：合同、700帧回归、25向量。
- `reports/segment_rtl/`、`reports/segment_review/`：RTL及独立审阅闭环。
- `logs/segment_chain_frozen_simulate.log`：冻结整链仿真。
- `reports/board/segment_vectors_01/summary.json`：板上边界与保护。
- `reports/board/archive_summary.json`及`archive_*`：历史回放。
- `reports/board/segment_live_01/`：新100帧结果、原始数据、离线复核和计算周期账本。
- `reports/uart_pairs/segment_live_01/`、`segment_after_physical/`：实际采集。
- `logs/segment_live_01_physical.log`：实体开关恢复。

下一步优先让相机小图直接写识别RAM，完整帧冻结后由板上控制器执行分割、逐字符归一化/CNN及最大分数选择，使PC退到观察位置。随后再按需要优化局部均值滑窗、CNN吞吐、置信度拒识及LCD文字显示。当前BRAM占用较高，扩展前应核算存储复用，不直接加大缓存。
