infr025t/fpga2026/fpga_plate_vision_v1_1/evidence/history/video20fps_20261030/docs/sample40_experiment.md

# 单次数据采样后移10ns对照
保持PLL×6、RCLK16.667MHz（phase2上升/phase5下降）、SLEW SLOW、LCD2/2/2/0、数值核心和接线不变。
旧采样phase5，发读沿后30ns。候选SAMPLE_PHASE=0，在下周期phase0只采样一次，即发读沿后40ns，距下一发读沿20ns，AL422 tOH4ns给出名义保持24ns。原28ns总输入预算保留，未放宽静态约束。实际外部延迟仍未测量。
phase0必须为当前采样扣除一个字节再批准下周期信用，否则会把129字节边界算成128；条件credit && (!sample_enable || available>READ_GUARD)。首字节仍是READ_RESET中的byte0预取，不额外拉RCLK，不复制像素。
延迟压力模型ACCESS_NS35：旧30ns采样能复现错误，候选40ns通过。该35ns为人工压力条件，不表示实测线缆延迟。
真实画面基线overview_scene_01有86个局部亮outlier，75个清bit7后接近邻域；03有15个，大多是右边界真高反差。此分析只提示最高位采样/相位/数据问题，不能证明唯一原因；未在实际输出上清bit7或做像素修补。
本次改动只为单变量验证采样裕量。相机本身坏点、自动增益噪声、FIFO旧数据区间和LCD问题仍需按证据区分，不能因某一张图改善而宣布全部解决。
