infr025t/fpga2026/fpga_plate_vision_v1_1/evidence/baseline/reports/placement_test_03/current.png

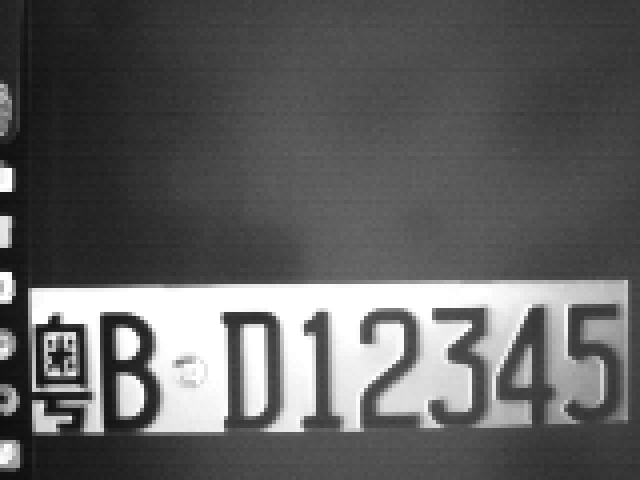
fpga_plate_vision_v1_1/evidence/baseline/reports/placement_test_03/current.png
