infr025t/fpga2026/demo/stream_image_demo/docs/history/验证结果.md

> 历史阶段记录：其中“尚未上板/尚未解决”等为当时状态。当前状态、接线以 ../../README_先读我.md 和 ../开发与联调日志.pdf 为准。

# 验证结果

> 下文 2026-10-04 数值为首次交付记录；2026-10-05 RST 更新后的数值见文末。

日期：2026-10-04。工具：Vivado 2025.1、Python 3.14.5。目标器件：xc7a35tcpg236-1。

## 已执行

- 五套 RTL 仿真全部通过：FIFO 两帧读出/Y 字节位置/超时、SCCB 39 项配置与 NACK 释放总线、图像核、UART 传输、顶层连续两帧测试图。
- 图像核按真实 320×240 尺寸测试 12 帧，每帧 75684 个输出，独立卷积参考逐像素检查，包含模式/阈值锁存、灰度中心位置、不同输入间隔、坐标和、阈值等号、帧结束。
- Python 接收器 6 项测试通过，覆盖分片、坏 CRC、非法头部、截断后恢复、payload 内 magic、空质心及文件输出。
- 从真实 UART RTL 引脚波形解码生成 wire.bin，交给交付版 receiver.py，正确接收两帧并生成 PGM/JSON/CSV。
- 完成综合、布局布线、DRC 与 bitstream 生成。
- 100 MHz 时序：WNS **+3.087 ns**，TNS 0；WHS **+0.045 ns**，THS 0。报告结论：All user specified timing constraints are met。
- BRAM：24 个 RAMB36E1 + 3 个 RAMB18E1，折合 **25.5/50 个 BRAM Tile，51%**。三行缓存确实映射为三个 RAMB18，输出缓存占主要资源。
- LUT 706/20800（3.39%），寄存器 1041/41600（2.50%），DSP 0。DRC 无错误，保留一个 RPBF-3 警告：SIOC 声明为开漏 inout，但本设计不读回时钟、不支持 clock stretching，输入缓冲被优化。该警告未阻止 bitstream 生成，没有降低 DRC 严重级别。

## 报告路径

- `build/verify_*/simulate.log`：最终五套仿真日志。
- `build/python_tests.log`：Python 测试。
- `build/wire_crosscheck.log`：RTL/PC 交叉验证。
- `build/vivado/timing.rpt`：布局布线后时序。
- `build/vivado/utilization.rpt`：最终资源占用。
- `build/vivado/drc.rpt`：设计规则检查。
- `build/vivado/stream_top.bit`：本次生成的 bit 文件。

## 尚未验证

没有下载到实板，没有读取实际摄像头，没有确认你的 22 针模组的供电、排针顺序、板载振荡器或内部 HREF/WEN/WRST 接法。接线必须按 README 的信号名和适配条件核对。寄存器组合与 FIFO 首字节、帧尾刷新行为仍需实物联调确认；行为仿真不等于芯片级模型。

静态时序使用 XDC 给定的外部延迟预算及多周期采样约束，不代表任意线缆和模组都已满足电气时序。异步开关、VSYNC、慢速 SCCB 输入具有文档说明的例外；外部不同时钟域的原始写入由模组 FIFO 承担。

该样例不实现端到端无帧缓存、UART 重传、FPGA 除法质心、多目标识别、1 bit 压缩或 15 fps 实测。它交付的是完整源码与可综合、已通过软件验证的硬件适配基准。

## 2026-10-05 RST 开漏更新验收

新增 JC9/P17 cam_rst_n。10 ms 拉低、10 ms 释放等待后启动原有 SCCB 初始化；BTNC 可重跑此流程。顶层测试新增开漏释放/外部拉低无冲突/配置等待/按键重启检查，全部五套 RTL 与六项 Python 测试及 wire 交叉检查通过。

重新综合、布局布线并生成 bit：WNS +3.417 ns、WHS +0.104 ns，TNS/THS 均 0；无 Critical Warning 或 Error。DRC 两个 RPBF-3 警告对应 cam_rst_n 和 cam_sioc：只输出开漏且不读取输入，因此输入缓冲被优化；未降低 DRC 严重级别。此新增引脚尚未实板验证。

## 2026-10-05 HREF 被动诊断更新

新增 HREF JC10/R18 输入与 SW14 诊断 LED、SW13 行计数字节选择。六套 RTL 仿真、六项 Python 测试及 wire 交叉测试通过。布局布线 WNS +3.095 ns、WHS +0.067 ns，TNS/THS 0，bitstream 已生成，构建日志无 Error/Critical Warning。DRC 保留之前两项开漏端口输入缓冲被优化的警告。新诊断功能尚未实板验证；真实摄像头固定噪声故障仍未解决。

## 2026-10-05 寄存器读回诊断更新

增加 SCCB 四寄存器读回与 HREF 上升沿 VSYNC 电平观察；七套 RTL、六项 Python 及 UART/PC 交叉测试通过。布局布线 WNS +3.348 ns、WHS +0.083 ns，TNS/THS 为 0，bitstream 生成成功。构建无 Critical Warning/Error，DRC 保留两项开漏输入缓冲优化警告。读回模块测试覆盖 STOP 分隔事务、四个返回值、主机最后 NACK、缺 ACK 错误记录、空闲总线释放；监测测试覆盖高/低 VSYNC 两种 HREF 上升沿。尚未在真实摄像头读回，固定噪声仍未证明修复。

## 2026-10-05 VSYNC 分阶段行数诊断更新

新增独立于 WR 的 VSYNC 高、低阶段 HREF 上升沿计数，SW14=1、SW12=0 时由 SW11/SW10 选择。七套 RTL 仿真、六项 Python 测试与 UART/PC 交叉检查通过；监测测试覆盖高阶段240行/低阶段3行、反向低阶段240行、高阶段零行与复位清除。

Vivado 已生成新 bit，WNS +3.646 ns、WHS +0.106 ns，TNS/THS 均0。构建无 Error/Critical Warning；DRC 保留两项 RPBF-3 开漏输入缓冲优化警告。未修改接线、寄存器配置和采集极性。本版尚待实板测量，不能据此认定固定噪声已修复。测试步骤见 VSYNC分阶段测试.md。
