infr025t/fpga2026/fpga_plate_vision_v1_1/evidence/history/plate_autonomous_board_20261101/docs/chinese_prefix_filter.md

# 首位汉字区域排除

## 规则与适用范围

本轮针对已发现的AG伪前缀：两个位于牌面最左侧、互相重叠的汉字碎片进入字符识别。自动模式按“首位为汉字、后面为字母数字”的版式，先定位整块牌面，再在字符候选进入同行筛选前排除以下区域：

`2*x + width < 2*(roi_x0 + floor((roi_x1-roi_x0)/8))`

即候选中心落在牌面最左1/8内则忽略，恰在边界则保留。边界随牌面平移、缩放；不使用CNN类别、答案或指定字符数量。不会盲目删除第一个分割框，也不会根据AG字样删除预测结果。

这是明确的版式约束，不是通用汉字分类器。对没有汉字前缀、或汉字不在最左侧的图片应关闭`SKIP_CHINESE`；当前顶层自主模式开启，人工回放模式始终关闭。尚未解决末尾4/5粘连、部分B/H混淆，亦未增加多帧投票。

## 实现

`char_segmenter`增加可选候选过滤，在任务开始时锁存开关和相对边界，在候选计数/同行筛选前执行。默认参数关闭以保留原单元行为。`plate_segment_frontend`在自动定位模式开启过滤，手动模式关闭；CNN、归一化、相机、动态定位和LCD模块保持不变，无新增帧缓存。

自动观测使用ASG3，布局与ASG2相同，284字节，表示启用此前缀过滤；观察器仍兼容ASG1/2，并按包版本独立计算预期框。因此旧ASG2记录不会被悄悄套用新规则。

## 已有证据

- 软件回放134张：此前固定位置100张、下移4张均仍完整输出BD12345；另一组20张保持19次BD12345、1次HD12345。最新失败10张从3次AGBD123K、7次AGBD123M变为3次BD123K、7次BD123M；仅汉字伪前缀消失，末尾粘连仍存在。见 `reports/prefix_reference`。
- 单元仿真：规则关闭、三种横向位置、首个有效字母保留、任务中策略输入变化不影响已接纳任务，全部通过。见 `reports/prefix_rtl/green.log`。
- 原失败图完整自主链仿真：6个保留字符，4,608个归一化像素、216个分数和ASCII均匹配；随后空帧零字符。12个UART包、44,888字节CRC全部一致。见 `sim_work/auto_prefix_scene/wire_verification.json`、`reports/prefix_chain_replay`。
- ASG2旧实拍10帧仍按旧策略完整回放通过；ASG3协议及12项观察器单元测试通过。见 `reports/prefix_legacy_replay`。

## 构建与实机结果

- `build_prefix/autonomous_board.bit` 已生成并下载到Basys 3配置RAM，未写Flash。100 MHz约束下WNS=0.092 ns、WHS=0.019 ns；无时序失败端点，无DRC Error或Critical Warning（仍有未使用诊断网络等Warning）。
- 资源：15,053 LUT、18,648 FF、40 RAMB36+9 RAMB18（44.5个BRAM36等效）、9 DSP。相对上一定位版只增加35 LUT、10 FF，BRAM/DSP不增加。
- 新实拍20张：每张恰好移除两个汉字碎片候选，后面的六个框保持原样。120个字符的92,160个归一化像素、4,320个CNN分数均与整数参考完全一致。板上输出13次BD123M、7次BD123K，AG前缀20/20消失，但完整BD12345仍为0/20，不能把参考一致率当成号码识别率。
- 同一批原始图像分别执行旧、新候选规则，保留框逐坐标一致。末尾4/5仍是同一个32像素左右宽的框，属于另一个分割问题。对照图见 `../reports/prefix_board_20/prefix_boxes_comparison.png`，逐帧结果见 `../reports/prefix_board_20/prefix_box_check.json`。
- 本轮完整帧组20、包180、CRC拒绝0、采集错误0、观测发布丢弃0。停止接收时的2,640字节未完成下一包作为尾部记录，不计入这20个完整帧组。源帧开始节拍约22.508 fps，识别完成节拍约5.627次/s；不代表独立测得LCD刷新率。
- 人工回放回归通过：启用新硬件参数时，自动/人工/诊断切换与旧归一化/CNN结果仍匹配。见 `../logs/auto_manual_prefix_simulate.log`。

证据入口：`reports/prefix_board_20/summary.json`、`metrics.json`、`reports/prefix_artifacts.json`。新程序保持运行；只修改独立测试工程，不更新Flash或正式仓库。这个几何排除规则只针对首位汉字版式，尚不能证明所有大小、位置的汉字都能被排除。
