infr025t/fpga2026/fpga_plate_vision_v1_1/evidence/history/release_lcd_v04/stream_video_edge_20fps/docs/anomaly_register.md

# 异常台账：历史故障、修复边界与未解决问题

更新日期：2026-11-01。当前源码基线为 `3ed6502`；覆盖旧 QVGA Demo、VGA 单拍、低速 LCD、22.5 fps 连续视频及工程收敛过程。本表依据历史文件和原始会话补录，不把当时的“通过”扩大为后来所有版本均已解决。相同外观可能有不同原因，后续新证据应追加在原编号下。

**最新状态：收敛候选自动回归通过，用户确认 RAW 与 EDGE 动态显示正常。第 324 帧内容错误（A14）在连接恢复后的补测中未重现，但原因仍未闭合。** 移动暗条纹未实施修复，斜向刷新分界线未独立定位，固定阈值的实景边缘效果待调整；USB/JTAG 识别不稳定仍独立记录。用户确认照明频闪、接受暂不处理，并不等于条纹已经消失。

历史已测 BIT 的 SHA256 为 `b33cd1017aa1dbe9d4aa03037e1271d05a9e84d0ce3b92a518d018da88a551e9`；其 Flash 自启动及 RAW/EDGE 由用户确认。收敛候选 BIT 为 `548373f9b1e5d90eed96ef44959fef1e0df00bc58ed775d97994ca1c5f354ec8`，本轮已 RAM 下载，未写 Flash。内部 RAW/EDGE 各 50 帧、连接恢复后的相机色条各 500 帧、暂停恢复 10 轮、实拍 RAW/EDGE 各 600 帧及实拍 UART 200 包自动检查通过，用户确认 RAW 与 EDGE 动态显示正常。期间的内容错误、断连及无法确认固件身份的尝试分别保留于 A14、A23，不用后一次通过覆盖。最终结果以[验证记录](validation.md)及[本轮硬件证据](../reports/evidence/consolidated_board_20261101/result.json)为准。

## 状态和证据口径

- **已修复（限定版本/用例）**：有代码或配置原因及对应回归；仍需看列明的硬件范围。
- **阶段验收通过／后续复现**：保留旧验收事实，也保留新版本、新条件下的失败。
- **改善，根因未闭合**：对照有改善，但不能确定唯一原因或永久排除故障。
- **未解决／未定位**：现象仍存在，或没有足以结案的证据。
- **历史方案已退出**：只适用于已删除的增强算法、临时工具或旧版本，不能当作当前 Gaussian＋Sobel 故障。

UART 包 CRC 证明传输包一致；源/显示发送点 CRC 相等证明两处观测一致；固定色条完整参考 CRC 才提供该确定性图像的内容依据。它们均不能单独证明实拍原始场景正确、LCD 实际接收到每个字节，或外部引脚电气合格。160×120 概览、中央 16 行及 ROI 都是抽样，不能覆盖未导出区域。主机轮询次数不能改写为硬件逐帧检查次数。

## 一、未解决的可见现象与效果问题

### A01　移动暗条纹／均匀横细纹

- **现象、版本与证据**：改线后 22.5 fps 实拍，肉眼可见均匀细条纹，有时滚动、有时静止。用户随后明确“确认是频闪，不管了”。见会话 S2：11285、11305 行；[历史板测](../reports/evidence/rewire_20fps_20261031.md)。
- **原因确定性**：用户观察确认照明频闪；没有独立记录照明波形或受控光源实验。此前提出的光源频闪与逐行曝光节拍不匹配属于解释，不能将全部噪带、浮雕归为这一类。高速相机配置后的防频闪参数适配也未完成独立验收。
- **处理、状态及残留**：**未修复，按用户当时要求暂不处理**。本次重新纳入未解决项。若恢复处理，固定镜头/场景，比较自然光关灯与原照明，再保存同帧写屏前数据和屏幕观察；不能以滤除暗带或改变阈值代替原因核实。

### A02　强光或快速运动时的斜向刷新分界线

- **现象与证据**：用户在确认频闪后另报“强光照射以及物体快速移动时出现斜线区域刷新”。见 S2：11305、11335 行。
- **原因确定性**：**未独立定位**。当前无 TE 同步、无双缓冲换页；边写 LCD GRAM 边扫描可能产生新旧帧交界。摄像头 rolling shutter 也可能让运动物体倾斜或使强光只影响部分行。两者都是候选解释，不能仅凭“斜线”宣告正常，也不能直接认定 FIFO 再次错读。
- **处理、回归及残留**：尚无专门修复或受控回归。保留同次事件的屏幕观察与写屏前快照；完整帧后暂停可作初步区分：交界消失支持显示更新因素，倾斜留在原始帧中支持采集成像因素，重复块/浮雕仍按 A10–A15 检查。单次暂停不是唯一归因证明。

### A03　EDGE 稀疏、近乎全黑或纹理过多，固定阈值适应性不足

- **现象与证据**：旧版弱对比 RAW 在默认参数下，Gaussian T=128 仅 1 个白点，改 T=32 为 4066 个；旧引导滤波 T=96 为 2 个，改 T=32 为 4573 个。该同图离线比较见 S2：2679 行及本地 `E:/FPGA_Test_Work/edge_v03_work/read_rate_20261029/quality_diagnosis/`。用户在高斯 EDGE 动态检查中反馈“没有异常，但边缘效果需调整”（S2：7746 行）。
- **原因确定性**：该输入上的阈值敏感性有离线参考依据；不能推广为所有光照均应使用 T=32。失焦、低对比、真实铅笔纹理、增益噪声会改变梯度分布。字节相位错取也会让 EDGE 全黑，必须先排除 A11。
- **处理与状态**：**当前固定 T=128 的实景效果优化待完成**。当前仅保留 3×3 Gaussian＋Sobel，旧引导滤波参数不再适用；自动阈值、NMS 等是历史建议，不是已实现功能。回归应保存同一 RAW 的阈值对照、弱边缘/噪声和逐帧稳定性，不能仅比较不同曝光的两张图。

### A04　早期严重模糊、低对比及画面边缘细线

- **证据**：旧 Demo 灰度只见亮暗，调焦后可辨铅笔笔触；旧记录的镜头距纸 24 cm 是搭建距离，不是焦距。早期画面右侧细线、分块未单独定位。见来源 D1。
- **原因与状态**：严重失焦已由调焦改善；**不能倒推早期分块、细线全部由失焦造成**。当前 RAW 仍需按实际照明、焦距检查，像素完整和 CRC 正常并不保证画质合适。
- **回归**：固定高对比目标、照明和距离，小步调焦并保留原始帧；传输故障与光学效果分别记录。旧 Demo 的阈值 160/256 不等于当前 T=128。

## 二、摄像头配置、FIFO 与字节一致性

### A05　SCCB 寄存器全零、假 ACK、固定不更新噪声

- **证据与版本**：早期 QVGA Demo 多帧在遮挡后仍逐字节相同；SIOC/SIOD 曾测约 0.9 V/0.8 V、缺上拉，寄存器四页全零。补充电平网络后读回 PID=0x76、COM10=0x02、TSLB=0x0C、COM7=0x00，图像开始随场景变化。见 D1、D2。
- **原因与处理**：当时开漏信号没有有效高电平，低电平可造成假 ACK；历史使用每路 3.3 V 经 4.7 kΩ 上拉并经 22 kΩ 下拉的网络。**这是特定样机历史接法，不是当前应照搬的通用电平方案**；未留存完成后三路实测高电平。
- **状态与残留**：当时配置通信及图像更新恢复；当前代码仍是开漏，模块现有上拉及电压应按实物核定，不能凭成功出图认定所有电气指标合格。回归保留 PID/关键寄存器、遮挡变化及内部测试图对照。

### A06　VSYNC 极性/WR 窗口误判风险与固定噪声定位不足

- **证据**：旧 Demo 加 HREF 被动监测，最终 WR 窗口/VSYNC 高/VSYNC 低分别 240/240/0 行。见 D1、D2。
- **原因确定性**：早期 WR 计数为零与固定噪声曾促使怀疑极性；最终计数不支持盲目翻转 VSYNC。FPGA 内部 WR 和行数正常不证明模块实际收到写使能/写时钟。
- **状态与回归**：旧窗口验证成立，原噪声不能仅由此唯一归因。保留行/帧计数、关键寄存器和实际像素验证；QVGA 240 行不能替代 VGA 480 行验收。

### A07　完整 VGA YUV422 放不进 AL422B，旧单帧流程不可直接扩展

- **证据/原因**：640×480×2=614400 B，大于 AL422B 393216 B；相机先将 Y 和 UV 写入外部 FIFO，FPGA 后取 Y。仅灰度 307200 B 能放下不能证明当前输入能整帧冻结。见 D1、S1：4506 行。
- **处理与状态**：当前使用连续读写、有限行信用和行缓存，未使用“整帧先存完再慢读”的旧 VGA 假设。属于已明确的架构约束，**不是可通过放宽溢出门槛解决的软件报错**。
- **回归与残留**：跨 FIFO 环绕、不同帧内容、读写安全距离和暂停恢复必须共同验证。内部占用为按完整行推算值；没有直接观测 WCK 时不能称实际 FIFO 内部占用测量。

### A08　旧数据拼接、冻结重读异常与 WRST→VSYNC 耦合

- **证据与版本**：早期 VGA 实拍中出现跨帧完全相同的细节块，部分相差 196608 灰度像素（一圈 FIFO 容量）。旧调度依赖 WRST 直接接 VSYNC、临时切 VSYNC 极性及帧尾补写。见 S1：8371、12277、12855 行；S2：412、1468 行。
- **原因确定性/处理**：旧数据混入有逐字节证据；复位耦合是已识别设计风险，但外部实际波形未测，不能唯一解释所有异常。改 WRST 独立接 JB1，读目标帧时不重复归零；旧单拍阶段尾部沿原地址提交，并修正预取计数及同步判定。
- **状态与回归**：2 MHz、AEC/AGC 开启的 50 张验收通过，当时按用户标准结案（D3）；**后来 LCD/高速版本再次出现相似异常，不能用这 50 张覆盖后续版本**。当前连续采集机制与旧单拍不同，旧“尾部补写”说明不能直接当作当前逐帧流程。

### A09　右侧固定约 18–20 像素重复带与早期首部异常

- **证据**：早期“色条只差一个像素”的结果曾被过度概括，用户指出实拍右侧仍有纵带（S1：12083–12086 行）。之后水平窗口 180/36→158/14，两张实拍共 960 行中的固定 18 像素重复段消失（S1：12546、12631、12855 行）。
- **原因与处理**：这条固定纵带有摄像头窗口配置修正证据，未复制像素、插值或裁掉 20 列。它与后来的随机窄错位带不是同一已证实故障。STM32/冻结重读的首部异常、早期“单像素”解释不能泛化为全图正确。
- **状态与残留**：固定右带在当时样本中修复；当时后续 40 张仍有 1 张横向拼接，说明 A08 尚独立存在。当前窄带复发应保存原位置、字节对和版本，不能直接套用旧窗口结论。

### A10　读复位预取首字节漏计、模型漏掉硬件行为

- **现象/证据**：独立 WRST 后灰度呈色度细纹、EDGE 近黑；读复位阶段已预取 byte0，但旧计数未纳入，后续相位错一字节。见 D3、S2：949、1042、1468 行。
- **原因与处理**：**确定的代码及模型覆盖缺陷**。预取首字节计入 index/read total，模型覆盖预取；当前代码说明见 [camera_fifo_video.sv](../rtl/camera/camera_fifo_video.sv)。
- **状态/回归**：当时完整 VGA 307200 亮度像素模型通过，之后 50 张硬件验收通过。当前保留此修正，并覆盖连续帧、环绕、暂停；不能把所有后来 Y/UV 互换都归为同一首字节 bug。

### A11　高速固定 Y 字节选择不匹配

- **证据/原因**：高速首张色条 CRC 为 `17e5bee9`，取到 UV；原尺度 strip 证明偶数位 Y 全帧应为 `6df0b9b5`。见 H1、S2：9385 行。
- **处理/状态**：固定采用 `Y_BYTE=0`，正确纳入 RRST 的 byte0 预取；小尺寸/VGA 环绕暂停模型通过。该配置错误已修正。
- **残留与回归**：按相机当前格式重新核对完整参考与相邻字节；固定选择正确也不能阻止 A14 那种运行中角色互换。诊断不能依据图像内容自动换 Y/UV。

### A12　短 VSYNC 导致提前结束／假帧起点

- **证据**：曾仅 75 行、45.4 ms 收到结束沿，正常应 480 行、约 265 ms；另观测到同步后 1 拍短低脉冲。后续分接远端观测线时原程序也失败，发现只过滤低脉冲而放行短高脉冲的缺陷。见 D3、H5；S2：1147、1200、5852、5942、6120 行。
- **原因与处理**：低/高短脉冲误认边界在模型中可复现，加入双向稳定资格判定；保留真实短帧、行数和超时错误。75 行事件与另次 1 拍脉冲不能直接认定同因，脉冲电气来源未知。
- **状态/回归**：低脉冲修正后有 50 张旧版验收；高脉冲修正候选 24 张 RAW 及后续 LCD 抽样正常。此项解释同步失败，不自动证明字节错位全解。当前保留 VSYNC/HREF 观测及异常保护。

### A13　遮挡／手机近光后停止、HREF 碎脉冲误增行信用及错误现场丢失

- **证据**：用户报告遮挡后卡住，日志出现显示 `0x20`（上游采集错误）；第 254 帧只收 240429/307200 像素。源端被复位导致原始错误丢失。加入首错锁存后，手机近距离打光且无接触复现 `0x22`，一帧计到 557 行，最短 HREF 高 1.55 μs，正常约 426.7 μs。见 S2：6337、6353、6386、6440、6468、6478 行。
- **原因与处理**：短低脉冲会把一条 HREF 拆成多条“完整行”，误加 credit，模型可复现；不能据 `0x22` 直接认定真的塞满 FIFO。加入行资格判定和首错上下文锁存，未提高保护上限或吞坏帧。
- **失败候选必须保留**：首次把滤波 HREF 同时用于写复位预备，移动 WEN/WRST 边界，造成整灰/浮雕、正常亮度落到相邻字节。回退对照后，收窄为仅计数/credit，原始写控制时序逐拍保持（S2：6571、6612、6646、6679 行；H5）。
- **状态/回归**：确定的计数解释与错误现场缺陷已修正；手机近光的外部触发机制未唯一确定，不能据“无接触”排除光照或电气耦合。回归仍需真实强光/遮挡、帧数、首错与图像内容共同判断。

### A14　高速旧轮次数据区间与本轮内容错误复现（高优先，未解决）

- **证据**：高速色条第 85 帧前 147456 像素异常；另轮第 105 帧前 98304 像素呈 +512 列相位，错误区止于物理回绕，可精确重建旧轮次 CRC。改 SLEW SLOW 后 RAW 连续 1500 帧通过，但暂停恢复 epoch1 从 index52395 转错；EDGE 前 375 帧后出现 REFERENCE_ERROR。2500 帧专项结果为 2499 正确、1 错（第 866 帧，前 86016 像素旧数据，第 867 帧恢复）。见 H1、H2。
- **原因确定性**：旧 FIFO 数据区间成立；具体写入、刷新、读沿或电气触发仍未知。SLOW/FAST 只改读钟 SLEW 的对照有改善，不能证明线缆唯一根因。该 0.04% 只属于那次固定色条，不能作为动态实景错误率。
- **状态/回归与证据缺口**：改线前稳定性未通过；改线后的有限回归见 A17。旧 EDGE 脚本未保存停前坏 CRC，最终 inspection 是排空后的末帧，不能补造坏帧位置。脚本后来补现场保存，原事件仍保留缺口。
- **2026-11-01 本轮新失败**：候选 `548373f9…` 已 RAM 下载，内部 RAW/EDGE 各 50 帧全参考通过；摄像头 RAW 色条 200 个 UART 包无 CRC 错误、缺号或丢包，约 22.5077 fps。但继续监测至第 **324 帧**触发 FPGA `ref_fault=0x40`：307200 像素完整，队列输入/输出 CRC 同为 **`589fae6c`**，与正确参考 **`6df0b9b5`** 不同。硬件色条比较器记录 **61440 个错像素，first_index=0、last_index=61439（前 96 行），首个实际值 45、期望 206**；同时 480 行、614400 字节、head40960 计数正常。重新 JTAG 连接后错误锁存一致，证明是内容错误，不能仅归为调试连接故障。原始 [fault.json](../reports/evidence/consolidated_board_20261101/consolidated_mode2_02/fault.json) 和本轮归档应共同保留。
- **本轮判断边界**：该分段错误外观与旧 FIFO 区间错误相似，但尚未完成本次坏 CRC 的旧轮次精确重建，不能直接认定唯一同因。用户随后确认测试期间动过 USB 或供电，具体时刻和故障的对应关系未确定，不能将此次内容错误归因于收敛改动，也不能反过来证明全由外部操作造成。原 BIT 重新连接后完成 500 帧 RAW 色条对照并通过，约 22.5077 fps；后续连接恢复、显式下载候选后 RAW/EDGE 色条各 500 帧、暂停恢复 10 轮通过，实拍 RAW/EDGE 各 600 帧的计数／队列 CRC／帧率检查也通过。本事件在补测未重现，不能证明唯一根因或永久消除；保留本次失败，不以旧验收或后续通过覆盖。

### A15　白色亮点、浮雕灰块、窄错位带及同帧 Y/UV 角色互换

- **证据**：用户照片与写屏前概览均存在异常，8100 帧计数/源到显示 CRC 自洽仍不能排除。30 ns→40 ns 单次采样后 3 张抽样的 ≥250 像素数从旧样本 69/10/0 变为 0/0/0，但第三张底部仍有浮雕。随后 600 个连续配对包 CRC/丢包/帧号缺口均 0，第 1/99 帧两通道角色相反，第 25 帧中途互换。见 H3、H4，S2：10159、10424、10645、10869 行。
- **原因确定性**：异常在写屏前；亮度与相邻字节角色互换有直接证据，不是单独 LCD/串口问题。白点多数接近 bit7 异常只提示采样问题；35 ns 人工压力模型不等于实测线缆延迟。转换不普遍对齐假设 bank 边界，不能概括成固定地址 bug。
- **处理、状态与残留**：40 ns 采样改善白点但没有单独治好所有异常；接线后有限样本改善见 A17。未清 bit7、未自动换通道、未复制像素。原 600 帧筛查的 34 帧“疑似互换”是特定目标检测，不能作为通用故障率；窄带和未导出区域可能漏检。

### A16　提频、连续信用、帧所有权与暂停竞态

- **历史失败证据**：2 MHz 旧采样公式不能只改分频；4 MHz 较早起读失败，288 行起读后 4/5/5.56 MHz 各 6 帧通过，6.25 MHz 首帧末 8 行错。40 MHz、160 行分 8 批读取的模型通过，但板测 CRC 错，换采样相位仍失败。见 S1：13703 行，S2：2388、2526、2571、3144 行。**这些不是当前线材可用频率上限证明**。
- **确认的实现问题/修正**：相位 0 消费当前字节时，下周期信用审批必须同时扣除，避免 129→128 边界误批；累计信用按 32 位模减处理计数回绕；启动与暂停同拍时已接纳源帧不得撤销；裁边 EDGE EOF 早于完整源 VGA 排空，不得据此启动下一帧。见 H1、H6 及当前 [采集模块](../rtl/camera/camera_fifo_video.sv)、[系统顶层](../rtl/lcd_top.sv)。
- **状态/回归**：当前实现保留这些修正，连续不同帧、FIFO 环绕和暂停模型已有通过证据（[相机仿真](../reports/evidence/simulation/package_camera01/result.json)）。模型未模拟的模块端多/少读沿或写入异常，仍需实机验证。

### A17　接线缩短后改善、供电反接及器件健康未知

- **证据**：早期换短线对照实际还改变了整组相机连线，不能写成严格只改 RCK；改线前约 20 cm 的高速异常见 H1/H4。2026-10-31 用户报告此前 3V3/GND 接反，之后同一 `b33cd101…` 固件仍能配置、出图；RAW/EDGE 色条各 500 帧目标通过，实拍第二轮保存 600 个连续有效配对包，概览筛查未见明显互换。见 H5、[改线板测](../reports/evidence/rewire_20fps_20261031.md)，S2：11005 行。
- **原因确定性**：接线条件与改善相关；没有示波器/逻辑分析仪确认反射、串扰、地回流或实际读写沿，因此不能唯一归因为线长。成功配置/出图不能证明反接没有潜在损伤。
- **状态及残留**：**有限实测改善，外部机制与器件健康未闭合**。实拍 EDGE 只有计数/链路 CRC，无逐帧场景参考；抽样无互换不能保证所有像素正确。固定线束后应按相同参数复验连续视频、暂停、强光、移动及冷启动，并记录所有接线变化。

### A18　独立 STM32 观测与引脚解释的边界

- **证据**：曾准备/运行 STM32 定时器＋DMA 及独立 GPIO 读取；GPIO 重读一致但相邻色条行/宽度仍异常，不能只归因 DMA。资料原理图 18 针，实物 22 针；厂商示例多为 QVGA RGB565，不能直接证明 VGA UYVY 读取。见 S1：10122、10431、10974、11500、11625 行。
- **原因与状态**：STR 后核实为 STROBE，不是 WCK/PCLK；OE 也不能直接当独立 RE/RREN。实物未引出可直接使用的 WCK/RE，当前基于 HREF 推断写入量的观测边界仍存在。早期将 STR/A0 当观测输入的方案已纠正，不是当前接线。
- **残留**：STM32 读出异常是跨实现诊断证据，并未独立测出真实电气根因。返回 Basys 3 后不得沿用旧 STM32 上拉、引脚或驱动假设。

## 三、LCD、运行控制和构建工具

### A19　LCD 接口位宽不匹配、旧版资料与实物跳阻不同

- **证据/原因**：实物初始 IM0=0、IM1=1，照片判定为 18/24 位配置；程序采用 8 位 8080，只接 D0–D7 不会自动改变硬件模式。旧原理图 R1–R5 布局与实物三焊盘不一致。见 S2：3456、3469、3491 行。
- **处理/状态**：按实物 IM 丝印改为 IM0=IM1=0，之后用户确认彩条、灰阶、棋盘格等独立点屏正常。未用软件补偿位宽不匹配；D8–D23 保持未接，不能把高位悬空直接记作当前故障。
- **回归/残留**：独立图案确认接口/颜色/方向/窗口；LED 初始化完成不等于屏幕实际正确。当前通用独立测试图入口保留，但收敛版此入口只确认综合通过，未据旧点屏验收声称新入口实机通过。

### A20　LCD 底部亮噪条带、横向上下分界

- **证据**：低速完整 RAW 底部有亮噪带，用户确认同尺寸内部图底部正常；再拍一张未复现，后又大量错图。暂停时 480 行、614400 字节、307200 像素、两处 CRC 相同仍有下半部异常。见 S2：3811、3854、3922、3970、4087 行。
- **原因确定性/状态**：当时未唯一定位；内部图对照削弱固定窗口/分辨率解释，后续同类浮雕在写屏前复现（A15）。不能把所有底部噪带都宣告为 LCD 已修复，也不能一概当成 A01 频闪。
- **回归**：同尺寸内部参考、相机色条、写屏前整图概览和屏幕观察联合对照；保留发生位置、暂停状态及原始字节对。

### A21　模式切换吞帧、源未排空与 LCD 最后一个字提前完成

- **确认的缺陷**：模式切换撞上寄存 start 时可能按新开关清屏，吞掉已接纳帧；零间隔连续写入时新字接纳与旧字完成同拍，旧完成脉冲可能被错当末字完成。另有源帧与裁边 EOF 的所有权边界，见 A16。
- **修正/证据**：锁存帧模式，几何变化先撤销 ready、清背景，再接纳新帧；末字完成独立核算。见 H5、S2：7995、8723、9032、9223 行，[窗口写入器](../rtl/display/nt35510_window_writer.sv)、[显示接收端](../rtl/runtime/video_lcd_sink.sv)。
- **状态/回归**：模式接纳、完整源帧所有权和显示路径定向仿真已通过，证据见[收敛记录](consolidation_20261101.md)。这些修正不构成 LCD TE/撕裂问题已解决的证据。

### A22　“开关不生效”、主动暂停与真正卡死混淆

- **证据/原因**：JTAG/VIO 接管时实体 SW15 不控制暂停；快照导出会主动停十余秒；有限 STAT_FRAMES 达标自动暂停。与 A13 的采集错误停机不同。见 S2：10005、10523、11252、11295 行。
- **处理/状态**：测试结束显式 `physical` 交还开关；[通用诊断](debug.md)说明接管、单帧、暂停、统计与快照行为。当前 SW15 在完整帧后暂停，不能把主动诊断暂停当成链路死锁。
- **回归**：记录 VIO 控制状态、采集/显示 busy、首错、帧计数及统计目标；分别测正常暂停恢复、启动同拍暂停和真正异常停机，禁止复位后丢失现场再声称查明原因。

### A23　USB/JTAG 消失、COM10 拒绝访问或中途断开

- **证据**：S1：6533 行打开 COM10 PermissionError；7953 行四次单拍中有正常/错乱/无输出/读取中 ClearCommError PermissionError。改线 RAW 第一轮 FPGA 达 600 帧目标，PC 仅保存 316 张后 PermissionError；第二轮 600 包完整。S3：442、477 行 Windows/JTAG 曾消失，下载成功后再次断开。见[串口第一轮摘要](../reports/evidence/uart/rewire_scene01/summary.json)。
- **原因确定性**：主机通信访问失败或连接丢失有日志；端口占用、USB 线/接口/连接等须分场景排查，不能凭异常码认定唯一原因，也不能把错图和无输出全归为同一问题。历史长 USB/连接不稳应保留为环境因素，未做线材电气定量诊断。
- **本轮补录（2026-11-01）**：初始 JTAG 未发现目标，用户重新连接上电后，候选 `548373f9…` 已成功 RAM 下载。mode1 内部 RAW 观测至 39 帧，307200 像素、参考 CRC `f9824a15` 匹配，约 27.1249 fps；该数值属于内部源，不是相机帧率。随后出现 `Xicom 50-38` 调试核无法连接及 hw_server 失败，Windows USB 仍可见。重新连接并 inspect 成功，未重新下载/复位，读到 `status=81330262` 且帧计数继续增长。**本次调试连接中断不等于视频核心卡死**；后续内部 RAW/EDGE 各 50 帧通过；相机色条第 324 帧出现内容故障。随后原 BIT 下载成功；一次对照因无目标未启动，重新连接后的 500 帧对照通过，再下载候选时又报告目标不可用。用户确认期间动过 USB 或供电，不能把这些断连认定为固件故障；本次硬件验收未完成。
- **状态/回归**：第二轮成功不抹掉第一轮中断，部分内部图通过不等于整个候选验收完成。本机诊断使用 COM10，明确不访问 COM15；记录枚举、目标、错误原文、实际有效包数，不将 FPGA 计数替代 PC 保存数。

- **连接恢复后的补测**：候选明确下载后完成 RAW/EDGE 色条各 500 帧、暂停恢复 10 轮及实拍 RAW 600 帧。实拍 EDGE 第一轮检查到 598 帧后再次出现 Xicom 50-38；重连读到无错误但输出回 RAW（307200 像素），无法排除从 QSPI 启动原版，不能把帧计数继续增长当成候选持续运行的证据。固件身份不明的第二次尝试主动终止并排除；再次明确下载候选后 EDGE 600 帧通过。最终交回实体开关控制，Flash 未改写。

### A24　UART 坏包、接收缓存及诊断不能反压主链

- **证据**：改线前配对色条先收到 60 个有效包，仍有 1 坏包/1 缺号；主机 RX 缓存扩至 1 MiB 后实拍连续 600 包头/负载 CRC、缺号、FPGA 丢包均 0。见 H4。
- **原因确定性/处理**：缓存扩大后该轮改善，不能把每次 CRC 错都归为相机内容错误。当前诊断队列满/冲突会丢诊断包，不反压正常核心；截断包可能触发主机负载 CRC 错误。
- **状态/回归**：串行波形与完整协议仿真已有通过记录；实机必须联合报告有效包、头/负载 CRC、帧号缺口、FPGA dropped 和连接异常。仅 CRC=0 不能证明上传之外的全 VGA 图像正确。

### A25　Flash 型号误选、RAM 下载与断电自启动混淆

- **证据/原因**：首次按 `s25fl032p` 尝试备份失败；实际 JEDEC 为 `c2 20 16`，匹配 Macronix `mx25l3273f` 后 4 MiB 备份成功，SPIx1 擦除/空白检查/编程/校验完成。RAM 下载本身断电不保留。见[验证记录](validation.md)及外部目录 `E:/FPGA_Test_Work/flash_20fps_20261101/`。
- **状态**：用户确认 JP1=QSPI 后断电重启 RAW 与 EDGE 可用（S3：595 行用户原话，588 行写入报告）；该确认仅属于原 `b33cd101…` 固件。通用 Flash 新入口离线测试通过不等于已再次实际写入验证。
- **回归/残留**：保留器件识别、备份、BIT 哈希、写入校验和用户冷启动观察；本轮候选下载测试不自动等于 Flash 更新，不得以旧 Flash 验收替代新候选板测。

### A26　构建时序/资源失败与输入约束预算错误

- **证据**：独立点屏连续灰阶除法路径未达 100 MHz，停止构建后改 16 级灰阶，并简化等价上电复位宽组合路径。高速首份诊断版因外部延迟重复计入采样约束、大快照占满 RAM 未通过实现。见 S2：3351、3401、8890 行。
- **处理/状态**：简化诊断计算、缩小快照和核正约束后再构建；不通过时未作为可用 BIT 下载。当前收敛实现通过的资源/时序见[本轮结构化结果](../reports/evidence/consolidation_20261101/result.json)，不能覆盖历史失败或保证外部线缆时序。
- **回归**：检查 setup/hold、DRC、输入约束依据、BRAM 和产物哈希；完整实现通过不等于摄像头、电源或 LCD 已实测合格。

### A27　工具把失败、零测试或错误测试台记成通过

- **历史工具问题**：源码 ZIP 无 `.git`，96 项检查中 7 项因直接读取提交号报错；xsim 对预期非法参数保护可能返回 0，旧运行器误判。见 S1：7516、7548 行。早期上游状态过早复位导致错误现场丢失，见 A13；旧 EDGE monitor 未保存坏 CRC，见 A14。
- **本轮收敛发现并修正**：不支持的 `--vga` 测试台原可静默运行错误目标；暂停脚本允许 0 轮成为空 PASS；下载指定 variant 却检查不匹配 LTX。当前改为拒绝不支持组合、正整数轮数且只支持色条 mode2、检查匹配 LTX。见[收敛记录](consolidation_20261101.md)及[工具日志](../reports/evidence/consolidation_20261101/tools_tests.log)。
- **状态/回归**：9 项离线工具检查通过；不把软件模拟命令检查写成真实烧录成功。测试报告必须列实际目标、执行数、退出原因和失败日志，不能只看返回码或 PASS 字样。

### A28　工程/文档漂移、旧 BIT 与新源码证据混用

- **证据**：曾发现采样 phase45→49、启动清相位、驱动强度等漂移，但原验收 BIT 同样失败，不能凭差异就确定根因（S2：5183 行）。收敛前仍残留 30 ns、96×96 快照、多套旧采集/UART 入口等描述，与当前 40 ns、160×120 概览不同（S3：645 行）。
- **处理/状态**：`3ed6502` 统一当前工程，保留 Demo、通用诊断与保护；旧源码由 Git 追溯，历史证据保留原日期。已测 BIT 与新候选分别保存，LTX 必须匹配。见[收敛记录](consolidation_20261101.md)。
- **回归/残留**：今后每轮先记录源码提交/工作区差异、BIT/LTX 哈希、参数、接线与模式。不能把原板测报告、新仿真和候选实现组合成“新版本已全部上板通过”。

## 四、已退出方案中的历史问题

### A29　增强默认参数没有相对 RAW 的放大区间，画质门槛初轮失败

- **证据**：旧引导滤波细节公式默认 g=1.25、T=4、L=16，满足 `(g−1)L=T`，没有相对原细节的放大区间。首轮 24 组候选全未通过增强门槛；扩展 72 组仍有越调等约束失败；后续细化 51 组并用独立保留集验收，才形成受控模型 profile。见 S1：217、240、841、1246、1537、1643、1690 行。
- **处理/状态**：撤销未验证默认值，比较 RAW/BASE/DENOISE/ENHANCE，并保持失败记录与独立保留集。真实曝光画质没有因模型门槛通过而自动完成。**这是历史增强方案问题，当前已删除引导滤波，不是当前 Gaussian＋Sobel 参数状态**。历史版本见 [5cc8868](https://github.com/infr025t/fpga2026/commit/5cc8868)。
- **残留原则**：定点一致、软件模型通过和实景效果是不同验收；当前阈值问题应按 A03 独立验证。

### A30　旧 Demo 环境错误与功能解释不准确

- **证据/原因**：requirements 路径不存在和 pip SSL 报错是独立问题；COM5 FileNotFound 后实际 COM10 成功；开漏 RPBF-3 输入缓冲优化警告不等于采集故障。旧亮像素质心偏向白背景，不能称物体定位；旧帧存储＋1 Mbps UART＋固定等待不能称实时 VGA。见 D1。
- **状态/处理**：按真实工作目录/端口运行，保留警告解释和实际能力边界。当前未宣称实现目标识别、颜色分类或自适应阈值；旧 1 Mbps 接收程序/旧开关定义不得与当前配对 UART 和 LCD 模式混用。
- **回归**：分别核对工具环境、包格式、图源与处理功能。环境报错不应直接归因 RTL，功能建议也不能登记为已实现。

## 证据索引

下列会话仅提取相关用户/助手消息，不将整份私人会话复制进仓库。行号为原 JSONL 的 1-based 行号，时间使用消息中的 UTC；同一会话文件可能跨多日。外部本地资料不随 Git 克隆发布；能由仓库追溯的历史文档优先提供固定提交链接。

| 编号 | 可复查位置与说明 |
|---|---|
| D1 | [旧 Demo 联调日志](../../demo/stream_image_demo/docs/开发与联调日志.txt)；原始副本 `E:/UESTC/FPGA/stream_image_demo/docs/开发与联调日志.txt`。覆盖 2026-10-05 至 10-09 的上拉、读回、固定噪声、失焦、通信与资源边界。 |
| D2 | 原始本地 `E:/UESTC/FPGA/stream_image_demo/docs/history/摄像头固定噪声排查.md`、`VSYNC分阶段测试.md`。它们是当时阶段状态，后续结论见 D1。 |
| D3 | [旧 50 张验收](https://github.com/infr025t/fpga2026/blob/5dbf664/stream_video_edge/reports/hardware/camera_acceptance_50/acceptance.json)；详细本地 `E:/FPGA_Test_Work/edge_v03_work/fifo_motion_diagnosis/acceptance_auto50.md`。 |
| H1 | [高速诊断](https://github.com/infr025t/fpga2026/blob/5dbf664/stream_video_edge_20fps/docs/diagnostic_findings.md)，本地同名文件位于 `E:/FPGA_Test_Work/video20fps_20261030/docs/`。 |
| H2 | [2500 帧结果](https://github.com/infr025t/fpga2026/blob/5dbf664/stream_video_edge_20fps/docs/statistics2500_result.md)；本地原始 `E:/FPGA_Test_Work/video20fps_20261030/reports/lcd/runtime/stats2500_run01/`。 |
| H3 | [动态异常及 40 ns 对照](https://github.com/infr025t/fpga2026/blob/5dbf664/stream_video_edge_20fps/docs/dynamic_image_fault_20261031.md)。 |
| H4 | [600 帧双字节证据](https://github.com/infr025t/fpga2026/blob/5dbf664/stream_video_edge_20fps/docs/byte_phase_evidence_20261031.md)；原始帧与角色筛查在 `E:/FPGA_Test_Work/video20fps_20261030/reports/uart_pairs/pair_uart_scene_01/`。 |
| H5 | [低速读取收敛边界](https://github.com/infr025t/fpga2026/blob/5dbf664/stream_video_edge/docs/reading_consolidation.md)。 |
| H6 | [单次采样后移实验](https://github.com/infr025t/fpga2026/blob/5dbf664/stream_video_edge_20fps/docs/sample40_experiment.md)。 |
| S1 | `C:/Users/mingg/.codex/sessions/2026/10/22/rollout-2026-10-22T20-19-37-01a16356-7245-77f3-bcbe-58cf8a7a896d.jsonl`。217–1690 行：2026-10-22～24 增强门槛；6533/7953 行：10-27/28 COM10；10122–11625 行：10-29 STM32；12083–12855 行：10-29 右侧纵带及残留拼接。 |
| S2 | `C:/Users/mingg/.codex/sessions/2026/10/29/rollout-2026-10-29T12-55-48-01a16356-7245-77f3-bcbe-58cf8a7a896d_01a1893b-a0c8-7822-a289-fdf7ec594753.jsonl`。412–1746 行：10-29 独立 WRST/预取/50 张；3351–3491 行：10-30 点屏；6337–6679 行：10-30 强光停机/HREF 候选失败；9477–9964 行：10-31 高速旧数据；10159–10869 行：10-31 亮点/字节互换；11285 行 17:49:18Z 肉眼条纹，11305 行 17:53:16Z 用户确认频闪并另报斜刷新，11335 行 17:54:41Z 候选解释。 |
| S3 | `C:/Users/mingg/.codex/sessions/2026/11/01/rollout-2026-11-01T03-54-51-01a16356-7245-77f3-bcbe-58cf8a7a896d_01a196f6-6101-7d90-b3ed-6a51c34aab9b.jsonl`。442 行 16:11:40Z USB 不枚举；477 行 16:13:20Z RAM 下载后又掉线；588 行 16:20:36Z Flash 写校验；595 行 16:23:32Z 用户确认冷启动及 EDGE；645–976 行：工程收敛与候选未上板边界；983 行 17:04:02Z 本次异常台账与候选测试请求。 |

## 后续登记要求

每次复现追加日期、源码/BIT 哈希、接线和光照、模式、可见症状、原始日志/图像、确定原因与候选解释、实施改动、回归覆盖及残留风险。失败候选、串口中断和未完成测试不得删除或被后一次通过覆盖。通用内部图、独立屏幕图、色条、首错锁存、暂停恢复、UART 配对、VIO 快照和统计监测继续保留；它们用于界定问题，不能用自动修图或丢弃失败帧代替验收。
