infr025t/fpga2026/fpga_plate_vision_v1_1/evidence/validation/engineering_board_100/segmentation_failure.png

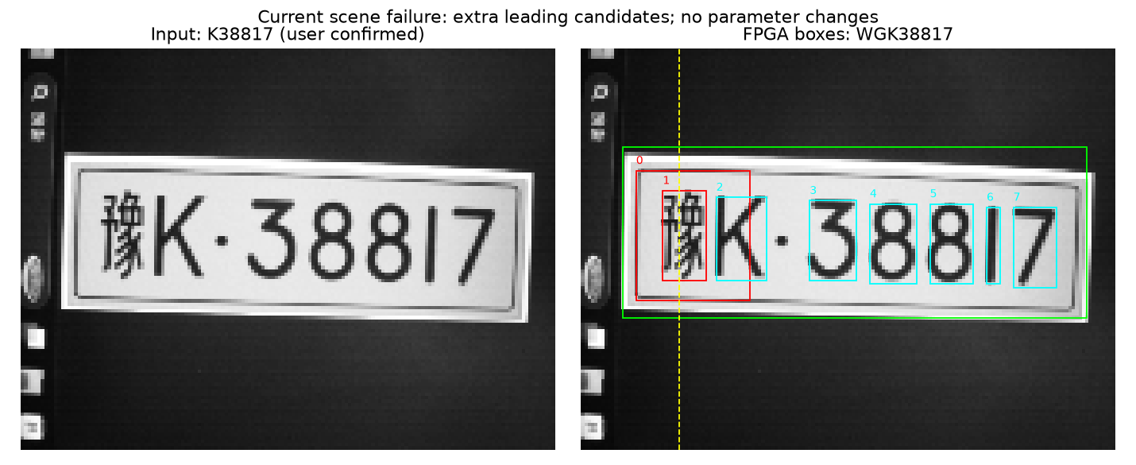
fpga_plate_vision_v1_1/evidence/validation/engineering_board_100/segmentation_failure.png
