infr025t/fpga2026/fpga_plate_vision_v1_1/evidence/implementation/sources/constraints/basys3_camera_lcd.xdc

set_property -dict {PACKAGE_PIN W5 IOSTANDARD LVCMOS33} [get_ports clk100]
set_property -dict {PACKAGE_PIN U18 IOSTANDARD LVCMOS33} [get_ports btnC]
set_property -dict {PACKAGE_PIN V17 IOSTANDARD LVCMOS33} [get_ports {sw[0]}]
set_property -dict {PACKAGE_PIN V16 IOSTANDARD LVCMOS33} [get_ports {sw[1]}]
set_property -dict {PACKAGE_PIN W16 IOSTANDARD LVCMOS33} [get_ports {sw[2]}]
set_property -dict {PACKAGE_PIN W17 IOSTANDARD LVCMOS33} [get_ports {sw[3]}]
set_property -dict {PACKAGE_PIN W15 IOSTANDARD LVCMOS33} [get_ports {sw[4]}]
set_property -dict {PACKAGE_PIN V15 IOSTANDARD LVCMOS33} [get_ports {sw[5]}]
set_property -dict {PACKAGE_PIN W14 IOSTANDARD LVCMOS33} [get_ports {sw[6]}]
set_property -dict {PACKAGE_PIN W13 IOSTANDARD LVCMOS33} [get_ports {sw[7]}]
set_property -dict {PACKAGE_PIN V2 IOSTANDARD LVCMOS33} [get_ports {sw[8]}]
set_property -dict {PACKAGE_PIN T3 IOSTANDARD LVCMOS33} [get_ports {sw[9]}]
set_property -dict {PACKAGE_PIN T2 IOSTANDARD LVCMOS33} [get_ports {sw[10]}]
set_property -dict {PACKAGE_PIN R3 IOSTANDARD LVCMOS33} [get_ports {sw[11]}]
set_property -dict {PACKAGE_PIN W2 IOSTANDARD LVCMOS33} [get_ports {sw[12]}]
set_property -dict {PACKAGE_PIN U1 IOSTANDARD LVCMOS33} [get_ports {sw[13]}]
set_property -dict {PACKAGE_PIN T1 IOSTANDARD LVCMOS33} [get_ports {sw[14]}]
set_property -dict {PACKAGE_PIN R2 IOSTANDARD LVCMOS33} [get_ports {sw[15]}]
set_property -dict {PACKAGE_PIN U16 IOSTANDARD LVCMOS33} [get_ports {led[0]}]
set_property -dict {PACKAGE_PIN E19 IOSTANDARD LVCMOS33} [get_ports {led[1]}]
set_property -dict {PACKAGE_PIN U19 IOSTANDARD LVCMOS33} [get_ports {led[2]}]
set_property -dict {PACKAGE_PIN V19 IOSTANDARD LVCMOS33} [get_ports {led[3]}]
set_property -dict {PACKAGE_PIN W18 IOSTANDARD LVCMOS33} [get_ports {led[4]}]
set_property -dict {PACKAGE_PIN U15 IOSTANDARD LVCMOS33} [get_ports {led[5]}]
set_property -dict {PACKAGE_PIN U14 IOSTANDARD LVCMOS33} [get_ports {led[6]}]
set_property -dict {PACKAGE_PIN V14 IOSTANDARD LVCMOS33} [get_ports {led[7]}]
set_property -dict {PACKAGE_PIN V13 IOSTANDARD LVCMOS33} [get_ports {led[8]}]
set_property -dict {PACKAGE_PIN V3 IOSTANDARD LVCMOS33} [get_ports {led[9]}]
set_property -dict {PACKAGE_PIN W3 IOSTANDARD LVCMOS33} [get_ports {led[10]}]
set_property -dict {PACKAGE_PIN U3 IOSTANDARD LVCMOS33} [get_ports {led[11]}]
set_property -dict {PACKAGE_PIN P3 IOSTANDARD LVCMOS33} [get_ports {led[12]}]
set_property -dict {PACKAGE_PIN N3 IOSTANDARD LVCMOS33} [get_ports {led[13]}]
set_property -dict {PACKAGE_PIN P1 IOSTANDARD LVCMOS33} [get_ports {led[14]}]
set_property -dict {PACKAGE_PIN L1 IOSTANDARD LVCMOS33} [get_ports {led[15]}]
create_clock -name sys_clk -period 10.000 [get_ports clk100]
set_property -dict {PACKAGE_PIN J3 IOSTANDARD LVCMOS33 DRIVE 4 SLEW SLOW} [get_ports {lcd_data[0]}]
set_property -dict {PACKAGE_PIN L3 IOSTANDARD LVCMOS33 DRIVE 4 SLEW SLOW} [get_ports {lcd_data[1]}]
set_property -dict {PACKAGE_PIN M2 IOSTANDARD LVCMOS33 DRIVE 4 SLEW SLOW} [get_ports {lcd_data[2]}]
set_property -dict {PACKAGE_PIN N2 IOSTANDARD LVCMOS33 DRIVE 4 SLEW SLOW} [get_ports {lcd_data[3]}]
set_property -dict {PACKAGE_PIN K3 IOSTANDARD LVCMOS33 DRIVE 4 SLEW SLOW} [get_ports {lcd_data[4]}]
set_property -dict {PACKAGE_PIN M3 IOSTANDARD LVCMOS33 DRIVE 4 SLEW SLOW} [get_ports {lcd_data[5]}]
set_property -dict {PACKAGE_PIN M1 IOSTANDARD LVCMOS33 DRIVE 4 SLEW SLOW} [get_ports {lcd_data[6]}]
set_property -dict {PACKAGE_PIN N1 IOSTANDARD LVCMOS33 DRIVE 4 SLEW SLOW} [get_ports {lcd_data[7]}]
set_property -dict {PACKAGE_PIN A16 IOSTANDARD LVCMOS33 DRIVE 4 SLEW SLOW} [get_ports {lcd_cs_n}]
set_property -dict {PACKAGE_PIN B15 IOSTANDARD LVCMOS33 DRIVE 4 SLEW SLOW} [get_ports {lcd_rs}]
set_property -dict {PACKAGE_PIN B16 IOSTANDARD LVCMOS33 DRIVE 4 SLEW SLOW} [get_ports {lcd_wr_n}]
set_property -dict {PACKAGE_PIN A15 IOSTANDARD LVCMOS33 DRIVE 4 SLEW SLOW} [get_ports {lcd_rd_n}]
set_property -dict {PACKAGE_PIN A17 IOSTANDARD LVCMOS33 DRIVE 4 SLEW SLOW} [get_ports {lcd_reset_n}]
set_property -dict {PACKAGE_PIN C15 IOSTANDARD LVCMOS33 DRIVE 4 SLEW SLOW} [get_ports {lcd_bl}]
set_property -dict {PACKAGE_PIN M19 IOSTANDARD LVCMOS33 DRIVE 4 SLEW SLOW} [get_ports {cam_rclk}]
set_property -dict {PACKAGE_PIN L17 IOSTANDARD LVCMOS33 DRIVE 4 SLEW SLOW} [get_ports {cam_rrst_n}]
set_property -dict {PACKAGE_PIN A14 IOSTANDARD LVCMOS33 DRIVE 4 SLEW SLOW} [get_ports {cam_wrst_n}]
set_property -dict {PACKAGE_PIN P18 IOSTANDARD LVCMOS33 DRIVE 4 SLEW SLOW} [get_ports {cam_wen}]
set_property -dict {PACKAGE_PIN P17 IOSTANDARD LVCMOS33 DRIVE 4 SLEW SLOW} [get_ports {cam_rst_n}]
set_property -dict {PACKAGE_PIN K17 IOSTANDARD LVCMOS33 DRIVE 4 SLEW SLOW} [get_ports {cam_sioc}]
set_property -dict {PACKAGE_PIN M18 IOSTANDARD LVCMOS33 DRIVE 4 SLEW SLOW} [get_ports {cam_siod}]
set_false_path -from [get_ports {btnC sw[*]}]
set_max_delay 10.000 -datapath_only -from [get_clocks sys_clk] -to [get_ports {lcd_data[*] lcd_cs_n lcd_rs lcd_wr_n lcd_rd_n lcd_reset_n lcd_bl}]
set_property CONFIG_VOLTAGE 3.3 [current_design]
set_property CFGBVS VCCO [current_design]
set_property BITSTREAM.GENERAL.COMPRESS TRUE [current_design]

set_property -dict {PACKAGE_PIN J1 IOSTANDARD LVCMOS33} [get_ports {cam_data[0]}]
set_property -dict {PACKAGE_PIN L2 IOSTANDARD LVCMOS33} [get_ports {cam_data[1]}]
set_property -dict {PACKAGE_PIN J2 IOSTANDARD LVCMOS33} [get_ports {cam_data[2]}]
set_property -dict {PACKAGE_PIN G2 IOSTANDARD LVCMOS33} [get_ports {cam_data[3]}]
set_property -dict {PACKAGE_PIN H1 IOSTANDARD LVCMOS33} [get_ports {cam_data[4]}]
set_property -dict {PACKAGE_PIN K2 IOSTANDARD LVCMOS33} [get_ports {cam_data[5]}]
set_property -dict {PACKAGE_PIN H2 IOSTANDARD LVCMOS33} [get_ports {cam_data[6]}]
set_property -dict {PACKAGE_PIN G3 IOSTANDARD LVCMOS33} [get_ports {cam_data[7]}]
set_property -dict {PACKAGE_PIN N17 IOSTANDARD LVCMOS33} [get_ports cam_vsync]
set_property -dict {PACKAGE_PIN R18 IOSTANDARD LVCMOS33 PULLDOWN TRUE} [get_ports cam_href]
set_false_path -from [get_ports {cam_vsync cam_href cam_sioc cam_siod}]
set_property IOB TRUE [get_ports cam_rclk]
set_property SLEW SLOW [get_ports cam_rclk]
set_max_delay 5.000 -datapath_only -from [get_pins -hier -filter {NAME =~ camera/rclk_reg/Q}] -to [get_ports cam_rclk]
set_max_delay 28.000 -datapath_only -from [get_ports {cam_data[*]}]
# 单次IOB采样在发出RCLK上升沿后40ns；外部到达时间仍是预算，未做示波器测量。
create_clock -name fifo_virtual -period 60.000
set_input_delay -clock fifo_virtual -max 23.000 [get_ports {cam_data[*]}]
set_input_delay -clock fifo_virtual -min 4.000 [get_ports {cam_data[*]}]
set_max_delay 20.000 -datapath_only -from [get_clocks sys_clk] -to [get_ports {cam_wen cam_rrst_n cam_wrst_n cam_rst_n cam_sioc cam_siod}]

# Human-visible LEDs have no synchronous external receiver.
# Use the same 20ns LED output budget as the formal camera project; keep all camera/LCD budgets.
set_max_delay 20.000 -datapath_only -from [get_clocks sys_clk] -to [get_ports {led[*]}]

# 保留已验证约束：外部23ns加片内5ns共28ns，不能把28ns误写成总计5ns。

# UG903: max_delay from an input INCLUDES set_input_delay.28=23 external+5 on-chip, NOT5 total.
# datapath_only避免把CE控制的晚采样当作每拍无条件采样；不据此宣称板外信号完整性。

# CE-based late sampling needs no system-synchronous zero-hold compensation.
# UG912 IOBDELAY NONE disables the default fixed ZHOLD element on these IBUFs.
# IOBDELAY属于IBUF cell属性；scripts/build.tcl在综合后设置实际8个IBUF。
# 删除无效port赋值，保留已验证的NONE设置效果。

# Test-only paired diagnostic UART on Basys3 USB-UART; no external wiring change.
set_property -dict {PACKAGE_PIN A18 IOSTANDARD LVCMOS33 DRIVE 4 SLEW SLOW} [get_ports uart_txd]
set_max_delay 20.000 -datapath_only -from [get_clocks sys_clk] -to [get_ports uart_txd]
# Basys3板载FT2232H接收输入，不新增外接线。同步后在系统时钟域采样。
# Digilent官方Basys-3-Master.xdc: RsRx=B18, RsTx=A18。
set_property -dict {PACKAGE_PIN B18 IOSTANDARD LVCMOS33 PULLUP TRUE} [get_ports uart_rxd]
set_false_path -from [get_ports uart_rxd]
