infr025t/fpga2026/(commit log)

2026-10-22 Initial import: FPGA image processing, ROI tracking and periodic preview
    [metadata.csv]
2026-10-22 Add serial reconnection and per-connection wire recordings
    [metadata.csv]
2026-10-22 docs: specify simple streaming guided-filter V0 design
2026-10-22 docs: revise enhancement validation and same-frame diagnostics
2026-10-23 docs: activate implementation stage with VGA-only formal build
2026-10-23 docs: record authorized expanded search and deferred camera exposure gate
2026-10-23 fix: sample horizontal edge profile across its transition
2026-10-23 docs: bind future RTL gate to traceable passing registered experiment
2026-10-23 Implement standalone camera enhancement and bounded display pipeline
    [metadata.csv]
2026-10-24 model: publish traceable fine gain profile after 17 controlled checks pass
2026-10-24 docs: archive completed numerical gate reviews and decision ledger
2026-10-24 docs: plan bounded frame runtime and complete output CRC verification
2026-10-24 docs: align current implementation status with arithmetic milestone
2026-10-24 docs: expose aligned arithmetic range errors from both window stages
2026-10-24 docs: bind preview controls to the accepted frame configuration
2026-10-24 feat: implement and verify independent five-row window stages
2026-10-24 docs: advance project entry to integrated RTL core stage
2026-10-26 docs: reconcile current RTL and full VGA delivery status
2026-10-26 Implement and verify integrated guided-filter numerical core
2026-10-31 Integrate validated LCD RAW/EDGE pipeline and consolidate FIFO capture
    Add the native VGA RAW and one-pass smoothing/Sobel LCD entry, shared tested
    capture fixes, physical pause/mode controls, and reproducible build/program
    scripts. Keep the numerical core and legacy demo unchanged.
    Remove the large snapshot RAM from the default build (50 to10.5 BRAM36),
    retain snapshots as an explicit diagnostic option, fix mode-switch admission
    and stale borders, and register the core-to-display transfer for100MHz timing.
    Validate seven camera cases including cycle equivalence, full VGA reference
    pixels, display/admission regressions, legacy UART protocol, deterministic
    hardware CRCs, and50 camera frames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
    [basys3_camera_lcd.xdc, capture_fault_latch.sv, href_stable_filter.sv, lcd_top.sv, nt35510_init_fast.sv, tb_display_path.sv]
2026-10-31 Keep Gaussian smoothing and Sobel, remove guided-filter implementation
    Select the simpler3x3 Gaussian path after the user found the displayed effects
    similar. Delete10 guided-only RTL files and remove filter/epsilon selection
    from RTL, the reference model and active controls. Keep the existing crop,
    threshold128, camera timing and LCD bus timing unchanged.
    Preserve EVG2 framing with fixed Gaussian metadata and update PC automatic
    capture to RAW/EDGE pairs. Rebuild both LCD and UART bitstreams. LCD resources
    drop from4910LUT/10.5BRAM/22DSP to2935LUT/3BRAM/5DSP.
    Verify11 software tests, VGA sparse/burst/reset/abort cases, LCD admission and
    bus checks, UART two-view bytes, deterministic hardw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
    [edge_core.sv, lcd_top.sv, tb_display_path.sv, tb_video_path.sv, test_receiver.py]
2026-10-31 Add current 22.5fps LCD RAW/EDGE engineering project
    Preserve the current test RTL, tested snapshot BIT/LTX, constraints, IP configuration, PC diagnostics, and reproducible build/program entry points without converging the code. Keep the previous low-rate project and demo unchanged.
    Document physical-switch controls, current wiring, measured 20fps results, and unresolved display-quality limits. Include selected hardware evidence, fresh VGA core/FIFO/UART simulation results, and successful standalone synthesis/place-and-route reports.
2026-11-02 Release standalone plate vision v1.1 with white-character mode and QSPI installation
